rksnider/SensorCollar/Tools/Plotting Scripts/WirelessDataCode/ActualLocation.png

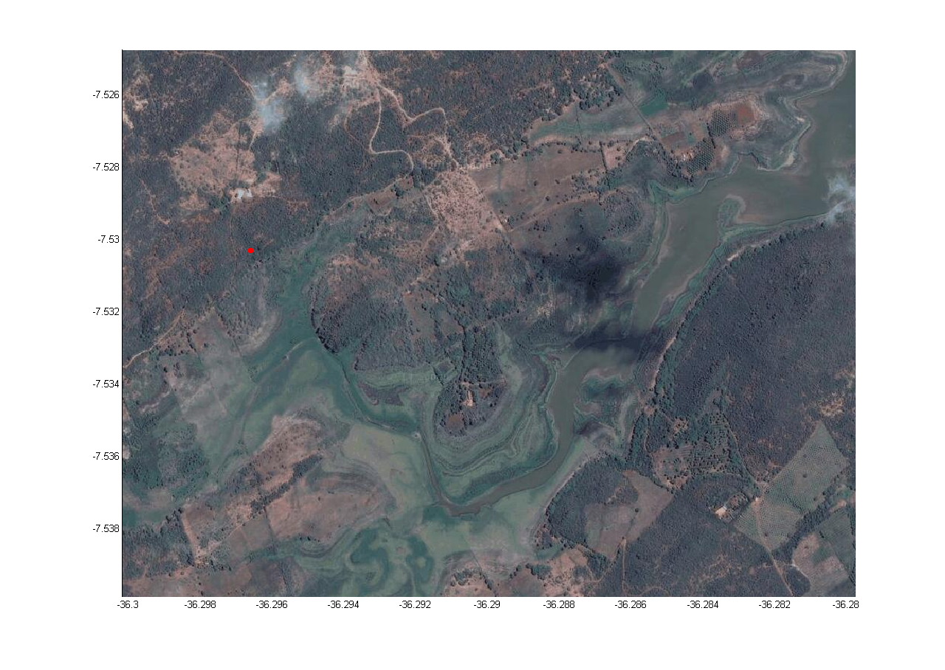
Tools/Plotting Scripts/WirelessDataCode/ActualLocation.png
