rksnider/SensorCollar/Tools/Plotting Scripts/WirelessDataCode/LocationMapdouble.png

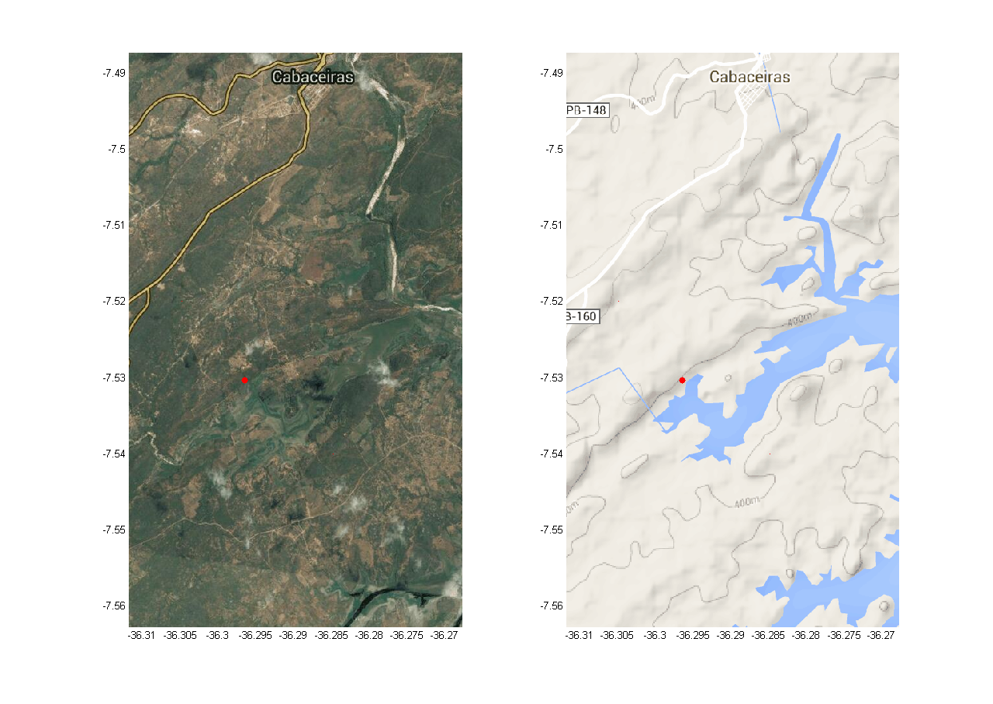
Tools/Plotting Scripts/WirelessDataCode/LocationMapdouble.png
