rksnider/SensorCollar/README.md

SensorCollar
============
This is where files are kept for the NSF SensorCollar
