rksnider/SensorCollar/Source_Code/README.md

Source Code should be organized by part name in their own folders

Examples:

----------------------------------------------------------------
System Files:

SensorCollar/Source_Code/System/VHDL

SensorCollar/Source_Code/System/Matlab

SensorCollar/Source_Code/System/C

----------------------------------------------------------------
Motion Sensor Files:

SensorCollar/Source_Code/Motion_MPU9250/VHDL

SensorCollar/Source_Code/Motion_MPU9250/Matlab

SensorCollar/Source_Code/Motion_MPU9250/C
