rksnider/SensorCollar/PCB_Designs/DevBoard_PowerMonitor/5CAM/readme.txt

Thickness: 0.062in
Copper Weight: 1Oz
Finish: Lead Free
Board: FR4
Soldermask: Both sides
Silkscreen: Both sides

Turn time: 1-2Weeks
Quantity: 5-10boards
