rksnider/SensorCollar/PCB_Designs/GPS Board/0Schematic/GPS Board/Board1.htm

# Part Lister output for Board1 Generated on Tuesday, October 06, 2015Part Lister output for Board1 Generated on Tuesday, October 06, 2015

# | QTY | DEVICE | REFDES | PKG_TYPE | VALUE | P/D_NUM | PART_NUMBER | PART_LABEL | PKG_GRP

1 | 1 | 1P8_LDOREG_TLV702 | U2 | 1P8_LDOREG_TLV702 | | 296-27889-1-ND | TLV70218DBVT | IC REG LDO 1.8V 0.3A SOT23-5 | SC-74A
2 | 1 | 3P3_LDOREG_TLV702 | U1 | 3P3_LDOREG_TLV702 | | 296-39284-1-ND | TLV70233PDBVR | SOT23-5 | SC-74A
3 | 3 | cap_0p1uF_0402 | C5, C9, C10 | 0402_MY | 0.1uF | 1276-1043-1-ND | CL05A104KA5NNNC
4 | 4 | cap_1uF_0402 | C1-C4 | 0402_MY | 1uF | 490-3890-1-ND | GRM155R61A105KE15D
5 | 1 | cap_4p7uF_0402 | C6 | 0402_MY | 4.7uF | 1276-1482-1-ND | CL05A475MP5NRNC
6 | 1 | EXT_SERIAL | J10 | EXT_SERIAL
7 | 1 | JTAG_HEADER | J3 | JTAG_HEADER
8 | 1 | JUMPER_8PIN_100MIL | J7 | JUMPER_8PIN_100MIL
9 | 1 | Res_0402 | R1 | 0402_MY | 25k | 541-1903-2-ND | PNM0402E2502BST1
10 | 2 | RIBBON_USB | J4, J9 | RIBBON_USB
11 | 4 | s_bit_uni_translator_FXLP34 | U3-U6 | s_bit_uni_translator_FXLP34 | | FXLP34P5XCT-ND | FXLP34P5X | TRANSLATOR 1BIT UNIDIRECT SC70-5 | SC-70-5
12 | 1 | SM_BUS | J1 | SM_BUS
13 | 1 | SPI_HEADER | J2 | SPI_HEADER
14 | 1 | SPST_SLIDE_SWITCH | S2 | SPST_SLIDE_SWITCH | | 360-3017-ND | AS11BP | SWITCH SLIDE SPST
15 | 1 | SWITCH_DUAL_SiP32414 | S1 | VISHNAY_DUAL_LOAD_SWITCH | | SIP32414DNP-T1-GE4CT-ND | Sip32414
16 | 2 | TVS_DIODE_ARRAY_SP3003_08ATG | U9, U10 | TVS_DIODE_ARRAY_SP3003_08ATG | | F1867CT-ND | SP3003-08ATG | TVS DIODE 6VWM 15VC MSOP10 | 10-MSOP
17 | 1 | two_bit_bi_translator_TXS0102 | U7 | two_bit_bi_translator_TXS0102 | | 296-21978-1-ND | TXS0102DCTR | IC VOLT-LEVEL TRANSLATOR US8 | 8-VFSOP
18 | 1 | USB3P0_LAND | J8 | USB3P0_LAND
19 | 1 | USB_FCI_CONNECTOR | J6 | USB_FCI_CONNECTOR | | 609-1039-ND | 61729-0010BLF | Connector Receptacle USB TypeB
20 | 1 | USB_FCI_PWR_RECEPTACLE | J5 | USB_FCI_PWR_RECEPTACLE | | 609-4618-1-ND | 10118194-0001LF | Connector Receptacle USB
