rksnider/SensorCollar/PCB_Designs/DevBoard_PowerMonitor/0Schematic/DevBoard_PowerMonitor/Prototype Board 1.htm

# Part Lister output for Prototype Board 1 Generated on Friday, October 10, 2014

# | DEVICE | PART_NUMBER | VALUE | TOLERANCE | REFDES | QTY

1 | 0p1uF_cap_0603 | | 0.1uF | | C4-C24 | 21
2 | 0p01uF_cap_0603 | | .01uF | | C63, C64 | 2
3 | 1p1V_Converter_TPS6085 | TPS62085 | | | PS1 | 1
4 | 4p7uF_cap_0603 | | 4.7uF | | C96-C113 | 18
5 | 4UCON_SD_SPARK_PART | | | | U4-U7 | 4
6 | 10uF_cap_0603 | | 10uF | | C1, C2 | 2
7 | 22uF_cap_0603 | | 22uF | | C3 | 1
8 | ADMP621_MEMS_MIC | ADMP621, ADMP621 | | | U15, U16 | 2
9 | ADP191_Power_Switch | ADP191, ADP191 | | | S6, S13 | 2
10 | ANTENNA | 1575AT43A0040 | | | AE1 | 1
11 | AUX_Power_Header | | | | J3 | 1
12 | BANK5B_HEADER | | | | J37 | 1
13 | BATTERY | | | | B1 | 1
14 | BATTERY_HEADER | | | | J30 | 1
15 | Battery_Monitor_BQ27520-G3 | BQ27520-G3 | | | U12 | 1
16 | C5_U324 | 5CEBA4U15C7N | | | U3 | 1
17 | cap_0402 | X5R, X5R, X5R, X5R, X5R, X5R, X5R, X5R, X5R, X5R, X5R, X5R, X5R, X5R, X5R, X5R | 0.1uF | | C65-C68, C74, C78, C80-C83, C86, C87, C90, C91, C94, C95 | 16
18 | cap_0402 | X5R | 0.22uF | | C75 | 1
19 | cap_0402 | X5R | 0.47uF | | C76 | 1
20 | cap_0402 | X5R, X5R, X5R, X5R, X5R, X5R, X5R, X5R | 10nF | | C77, C79, C84, C85, C88, C89, C92, C93 | 8
21 | cap_0402 | X5R | 22nF | | C69 | 1
22 | cap_0402 | X5R, X5R, X5R, X5R | 47nF | | C70-C73 | 4
23 | cap_0603 | | 0.1uF | | C43, C46, C49, C55, C56, C58, C59, C61, C62, C114, C116 | 11
24 | cap_0603 | | 1.0uF | | C57 | 1
25 | cap_0603 | | 1uF | | C54 | 1
26 | cap_0603 | | 4.7uF | | C51, C52 | 2
27 | cap_0603 | | 10nF | | C115, C118 | 2
28 | cap_0603 | | 10uF | | C44, C47, C50, C53, C117 | 5
29 | cap_0603 | | 22pF | | C45 | 1
30 | cap_0603 | | 22uF | | C42 | 1
31 | cap_0603 | | 33nF | | C60 | 1
32 | cap_0603 | | 33pF | | C48 | 1
33 | cap_0603 | X5R, X5R, X5R, X5R, X5R, X5R | 0.1uF | | C36-C41 | 6
34 | cap_0603 | X5R, X5R, X5R, X5R, X5R, X5R | 1uF | | C25, C27, C30, C33-C35 | 6
35 | cap_0603 | X5R | 4.7uF | | C26 | 1
36 | cap_0603 | X5R, X5R | 10uF | | C28, C31 | 2
37 | cap_0603 | X5R, X5R | 47uF | | C29, C32 | 2
38 | CLOCK_SG210STF | SG-210STF50.0000MS3 | | | CLK1 | 1
39 | CPLD_GPIO | | | | J44 | 1
40 | DATA_TX_HEADER | | | | J4 | 1
41 | DUAL_BUCK_WITH_BOOST_LTC3521 | LTC3521 | | | U10 | 1
42 | FERRITE_BEAD_FILTER | BLM18PG600SN1D, BLM18PG600SN1D | | | FB1, FB2 | 2
43 | FLASH_Micron_N25Q128A | N25Q128A11ESE40G | | | U17 | 1
44 | GPIO_1P8V | | | | J25 | 1
45 | GPIO_3P3V | | | | J35 | 1
46 | I2C_HEADER | | | | J36 | 1
47 | IM_LSM9DS1 | LSM9DS1 | | | U27 | 1
48 | Inductor | 252012CDMCD | 0.47uH | | L4 | 1
49 | Inductor | 252012CDMCD | 10uH | | L5 | 1
50 | Inductor | 252012CDMCD-3R3MC | 3.3uH | | L2 | 1
51 | Inductor | 252012CDMCD-4R7MC, 252012CDMCD-4R7MC | 4.7uH | | L1, L3 | 2
52 | JTAG_HEADER | | | | J38 | 1
53 | JUMPER_L | | | | J6-J23, J48-J50 | 21
54 | MAX-7Q | MAX-7Q | | | U11 | 1
55 | MAXV_TQFP100 | 5M570ZT100C5N | | | U14 | 1
56 | MNT_112_4_40_PART | | | | U19-U24 | 6
57 | MPU-9250_9AXSIS | MPU-9250 | | | U2 | 1
58 | MRAM_MR20H40CDF_8DFN_SMALLFLAG_PART | MR20H40 | | | U18 | 1
59 | OCTAL_BUFFER_SN74LVC244A | SN74LVC244APWR | | | U13 | 1
60 | Oscillation_Crystal | ABS07-120-32.768kHz-T | | | U25 | 1
61 | PUSH_BUTTON | KS12R22CQD | | | PB1 | 1
62 | Res_0603 | | 1.8M | | R34 | 1
63 | Res_0603 | | 1k | | R32 | 1
64 | Res_0603 | | 10k | | R20, R29, R30 | 3
65 | Res_0603 | | 18.2k | | R33 | 1
66 | Res_0603 | | 24k | | R21, R31, R35 | 3
67 | Res_0603 | | 40.2k | | R22 | 1
68 | Res_0603 | | 64.9k | 0.1% | R18 | 1
69 | Res_0603 | | 100 | | R25, R26 | 2
70 | Res_0603 | | 174k | 0.1% | R19 | 1
71 | Res_0603 | | 332k | 1% | R23 | 1
72 | Res_0603 | | 1020k | 1% | R24 | 1
73 | Res_0603 | ERJ-M03NF10MV | 0.01 | 1% | R28 | 1
74 | Res_v_0603 | | 1.00M | 0.1% | R3 | 1
75 | Res_v_0603 | | 1k | | R15 | 1
76 | Res_v_0603 | | 1M | | R11, R17 | 2
77 | Res_v_0603 | | 2K | 1% | R2 | 1
78 | Res_v_0603 | | 10k | | R9, R10, R14, R16 | 4
79 | Res_v_0603 | | 24k | | R12, R13 | 2
80 | Res_v_0603 | | 68.1k | 0.1% | R6 | 1
81 | Res_v_0603 | | 69.8k | 0.1% | R8 | 1
82 | Res_v_0603 | | 137k | 0.1% | R5 | 1
83 | Res_v_0603 | | 221k | 0.1%, 0.1% | R4, R7 | 2
84 | RESISTOR_PACK_EXB-2HV105JV | EXB-2HV105JV | 1M Ohm | | R1 | 1
85 | RTC_DS1371 | DS1371 | | | U26 | 1
86 | SC_BYPASS | | | | J33 | 1
87 | SCHOTTKY_DIODE | SSA23L | | | D1 | 1
88 | SDCARD_TP | | | | J40-J42 | 3
89 | SDRAM_MT48H32M16LFB4 | MT48H32M16LFB4 | | | U9 | 1
90 | Solar_Ctl_LTC3105 | LTC3105EMS | | | U1 | 1
91 | Solar_Pannel_Header | | | | J2 | 1
92 | SPI_HEADER | | | | J51 | 1
93 | SPI_SEL | | | | J52 | 1
94 | SWITCH_DUAL_SiP32413 | Sip32413 | | | S3 | 1
95 | SWITCH_DUAL_SiP32414 | Sip32414, Sip32414, Sip32414, Sip32414, Sip32414 | | | S5, S7-S10 | 5
96 | SWITCH_DUAL_SiP32416 | Sip32416, Sip32416 | | | S11, S12 | 2
97 | SWITCH_MAGNASPHERE-S | MG-B2-20-S | | | S4 | 1
98 | SWITCH_SINGLE_TPS22912C | TPS22912C, TPS22912C | | | S1, S2 | 2
99 | TEST_POINT | | | | J26-J29, J43, J45, J46, J53, J54 | 9
100 | THERMISTOR_103AT | 103AT-4 | 10K | 1% | R27 | 1
101 | TP_CONFIG | | | | J47 | 1
102 | TP_FLASH_L | | | | J31 | 1
103 | TP_FLASHR | | | | J1 | 1
104 | TP_GPS | | | | J32 | 1
105 | TP_IM_L | | | | J24 | 1
106 | TP_IM_R | | | | J5 | 1
107 | TP_MRAM_L | | | | J34 | 1
108 | TP_MRAM_R | | | | J39 | 1
109 | TXB0106_PW_16 | TXB0106 | | | U8 | 1
