rksnider/SensorCollar/Tools/Current Meter/Current Meter Board Pins v2.pdf

## Mammal Tracking Project - Current Meter Board Pins Used

Emery Newlon

## Primary Processor

The primary processor of the project is a Freescale Kinetis L class microcontroller. The Freescale Freedom board used for this project uses a KL25 version of this processor. In the connection diagrams that follow the color silver indicates an empty hole, black indicates a pin without a connection to it, while other colors indicate the wire color or component connected to the pin.

## Freedom Board Pins Used

The Current Meter Board (CMB) is powered by the USB connection through the OpenSDA port. It is connected to an external resistance network board that provides signal taps used to determine the current passing from a current source to its destination. The analog reference is smoothed by capacitor CR and resistor RR. The connections to the Current Meter Board are as follows:

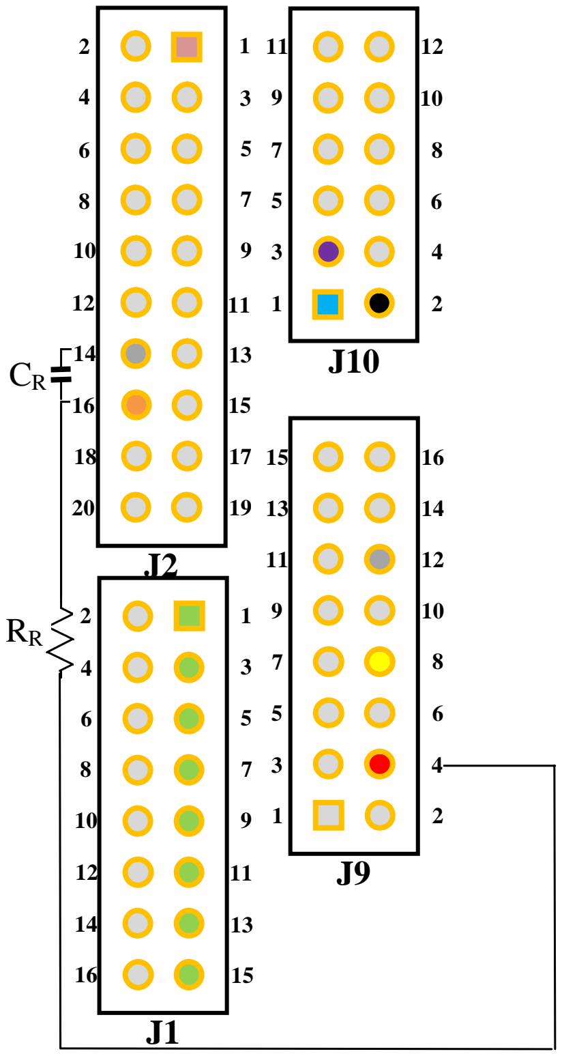
[picture p66: figure]

1. Data In (Optional) | J1-1 to J1-15 odd
2. Data Out (Optional) | Sampling J2-1
3. AREF Capacitor Low | GND | J2-14
4. AREF Capacitor High | AREF | J2-16
AREF Resistor Low
5. CMB Power (Optional) P3V3 | J9-08
6. AREF Resistor High | P3V3 | J9-04
7. Resistor Board Ground GND | J9-12
8. Resistor Board V+ | PTE20 | J10-01
9. Resistor Board V- | PTE21 | J10-03

CR = 1000 µF, RR = 1000 Ω

Mammal Tracking Project | Current Meter Board Pins Used

Page 2 of 4

The Resistor Board is used to implement the resistor network and the pins needed to connect it to the Source, Destination, and Current Meter Board. The current through the R0 resister is measured by determining the difference between V+ and V- assuming that the resistances of R1 to R4 are much higher than that of R0.
V+ = Vin × R3 / (R1 + R3) | → | Vin = V+ × (R1 + R3) / R3
V- = Vout × R4 / (R2 + R4) → | Vout = V- × (R2 + R4) / R4
Iout = (Vin – Vout) / R0 | →
Iout = [V+ × (R1 + R3) / R3 – V- × (R2 + R4) / R4] / R0

Resister R0 is a 1 Ω resister. Resistor R4 is calibrated by connecting the same voltage source, Vcal, across both Vin and Vout, then adjusting R4 until V+ and V- have the same values. This results in:
V+ = Vcal × R3 / (R1 + R3) | & | V- = Vcal × R4 / (R2 + R4)
Vcal × R3 / (R1 + R3) = Vcal × R4 / (R2 + R4) | → R3 / (R1 + R3) = R4 / (R2 + R4)
(R1 + R3) / R3 = (R2 + R4) / R4 | → | Iout = [(V+ – V-) × (R1 + R3) / R3] / R0

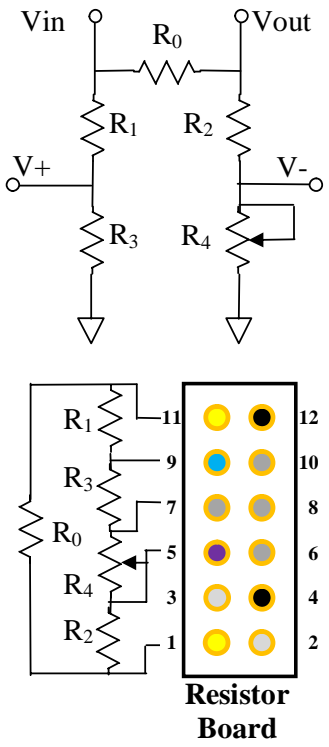
[picture p67: figure]
Resistor Board; Vin; Vout

1. Source Ground | GND | RB-10
2. Source Vcc | Vin | RB-11
3. CMB V+ | V+ | RB-09
4. CMB Ground | GND | RB-08
5. CMB V- | V- | RB-05
6. Destination Ground | GND | RB-06
7. Destination Vcc | Vout | RB-01

V+ must be less than AREF. If max V+ is (g × AREF): g × AREF / Vin = R3 / (R1 + R3)
g × AREF / Vin = 1 / (R1 / R3 + 1)
R1 / R3 = 1 / (g × AREF / Vin) – 1
R1 = R3 × [1 / (g × AREF / Vin) – 1] where g is a constant such as 0.9. R4 = 2 × R3 to allow for it to be adjusted.

Mammal Tracking Project | Current Meter Board Pins Used

Page 3 of 4

Calibrate using calibration cable:

Connect blue to the red.
Apply power (3.3v) between red and black.
Adjust R2 until voltage between yellow and green is 0. Measure Vcal between red and black.
Measure V+cal between yellow and black.

Disconnect red and black from power and ground.
Disconnect blue from red.
Set power to 0.3v or less.
Connect red to power, blue to ammeter, and ammeter to ground. Measure Ical through ammeter and VLcal between red and blue. Calculate calibration factor for this Resistor Board:
CF = (Vcal / V+cal) / (VLcal / Ical)
Iout = (V+ – V-) × CF

RB Calibration
Plugs
11 | 9 | 7 | 5 | 3 | 1
12 | 10 | 8 | 6 | 4 | 2
