rksnider/SensorCollar/Documentation/dcs_vhdl_coding_rules_es_v4_4.pdf

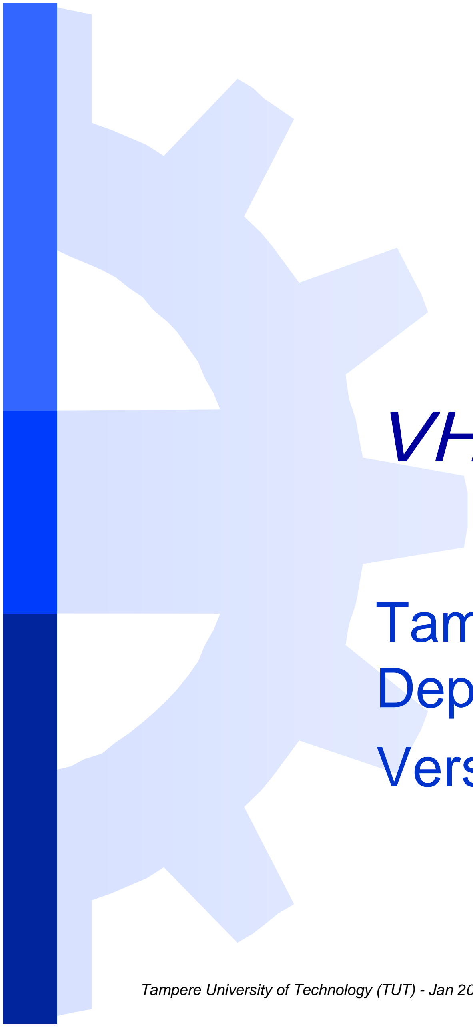
[picture p75: figure]

Tampere University of Technology (TUT) - Jan 2009

# VHDL Coding Rules

# Tampere University of Technology Department of Computer Systems Version 4.4 – Jan 2009

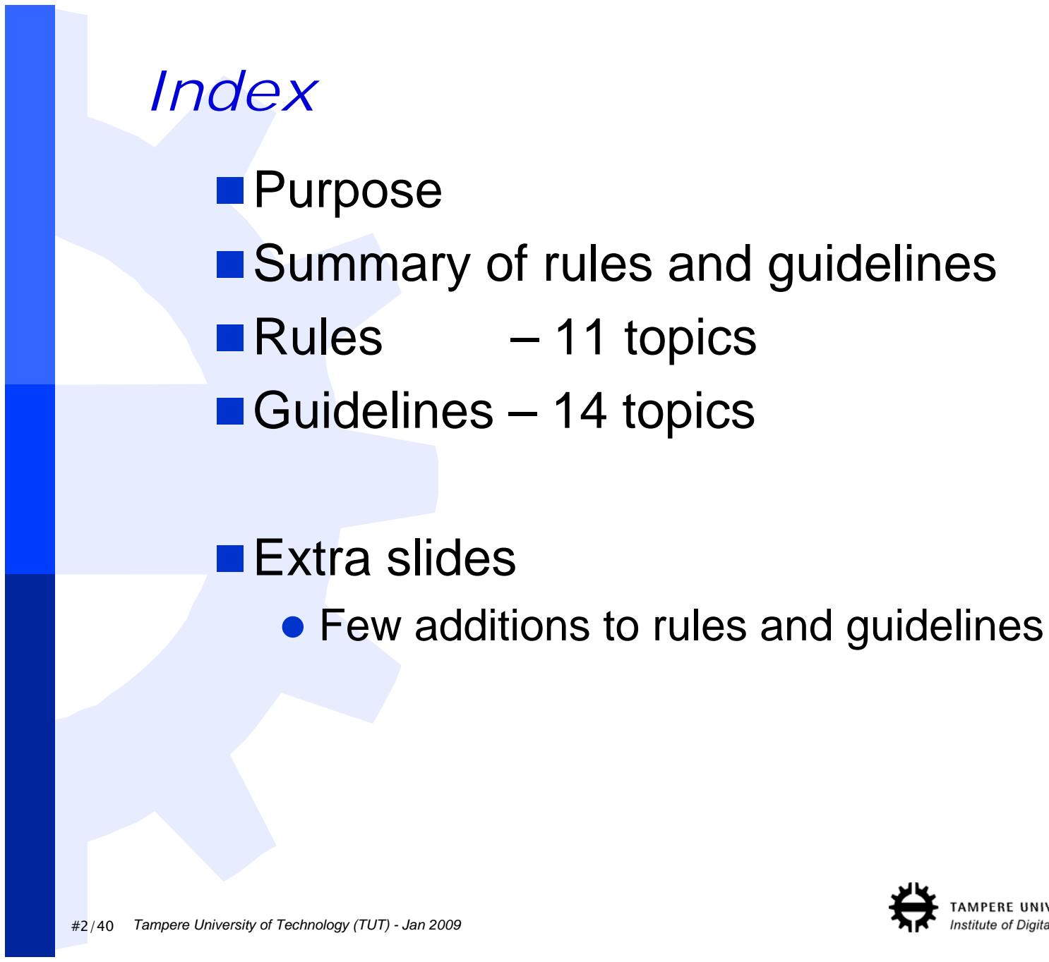
[picture p76: figure]
Index; Purpose Summary of rules and guidelines; Rules; – 11 topics; Guidelines – 14 topics; Extra slides z Few additions to rules and guidelines

#2/40 Tampere University of Technology (TUT) - Jan 2009

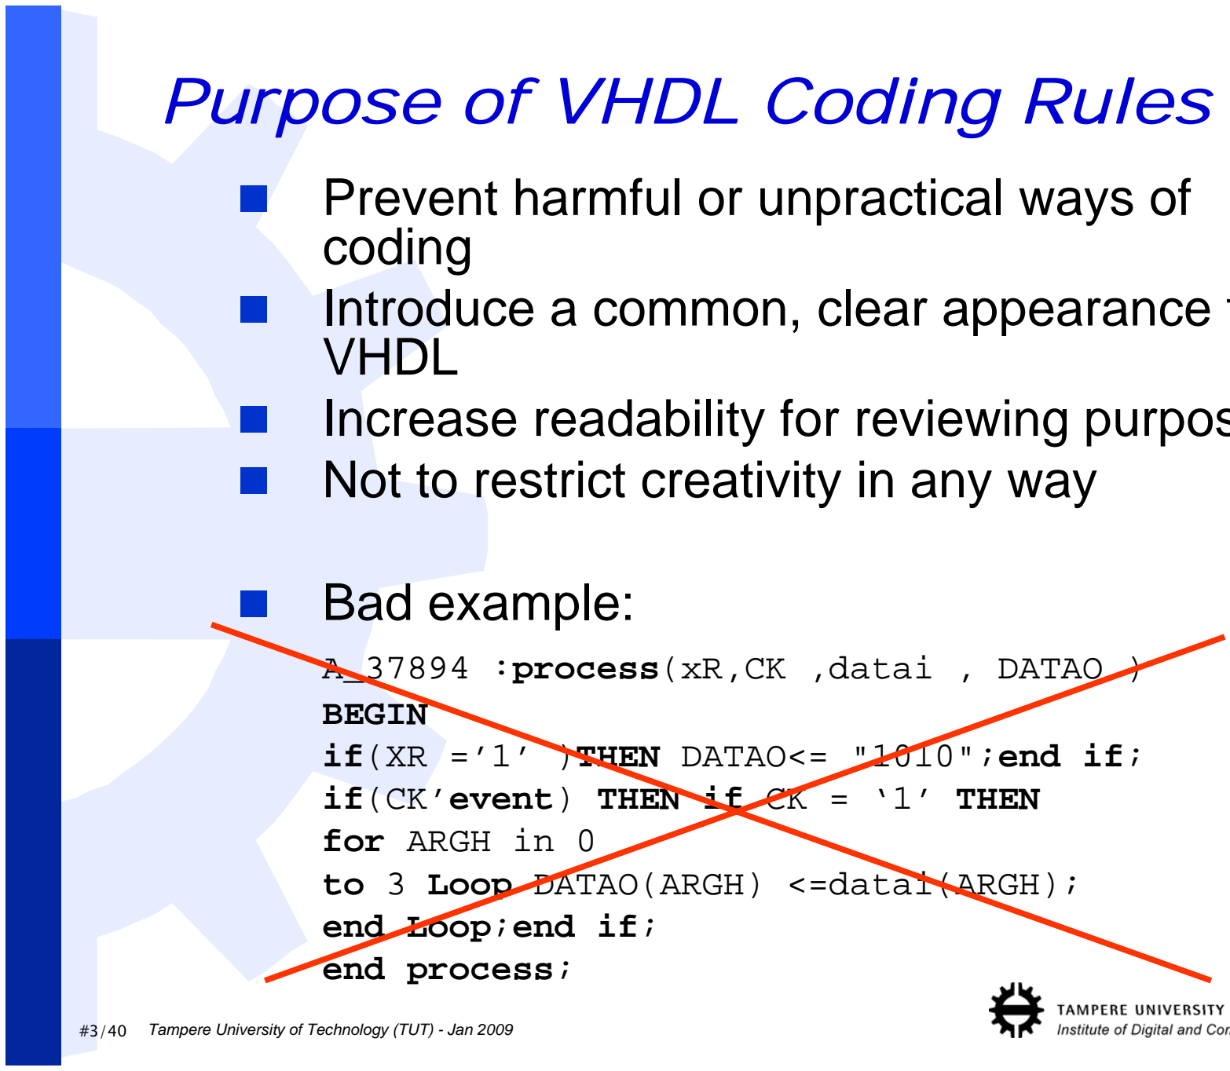
[picture p77: figure]
Purpose of VHDL Coding Rules; coding; VHDL;  Not to restrict creativity in any way;  Bad example:; A_37894 :process(xR,CK ,datai , DATAO ) BEGIN if(XR =’1’ )THEN DATAO<= "1010";end if; if(CK’event) THEN if CK = ‘1’ THEN for ARGH in 0 to 3 Loop DATAO(ARGH) <=datai(ARGH); end Loop;end if; end process;

#3/40 Tampere University of Technology (TUT) - Jan 2009

# Prevent harmful or unpractical ways of

# Introduce a common, clear appearance for

# Increase readability for reviewing purposes

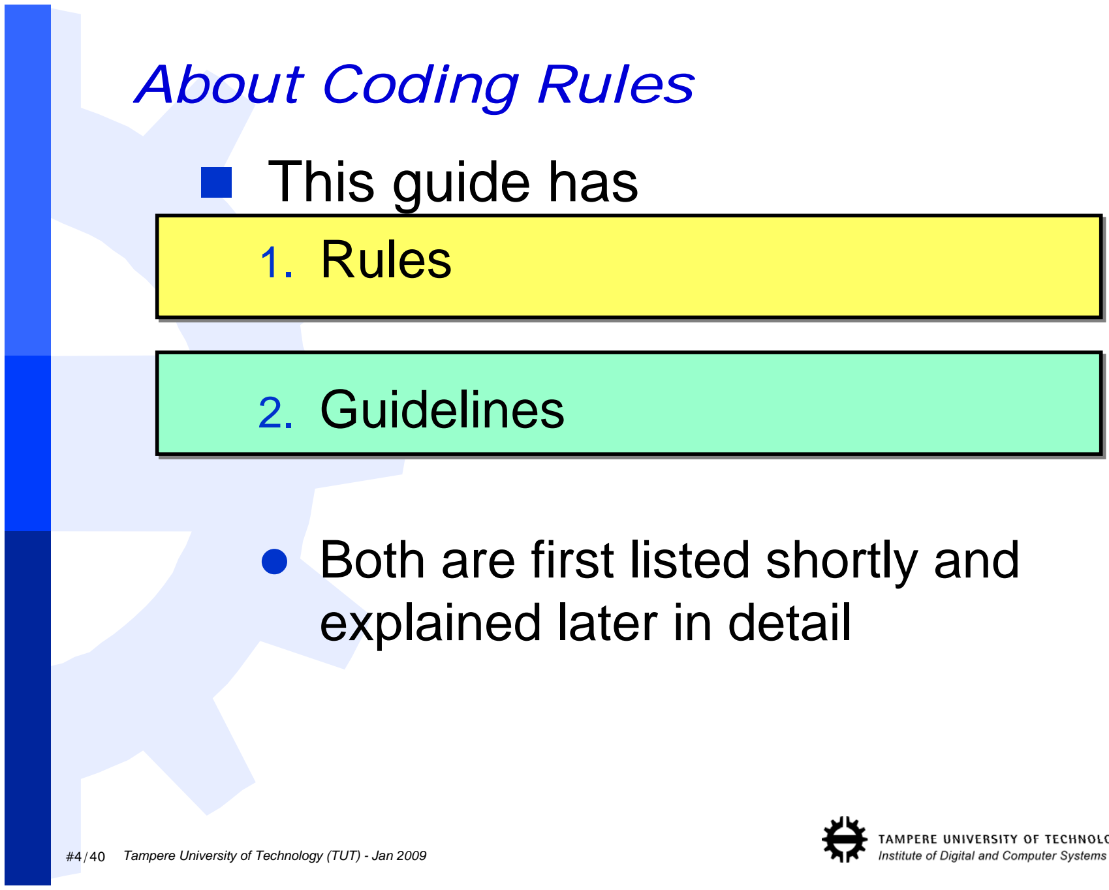
[picture p78: figure]
About Coding Rules;  This guide has 1. Rules; 2. Guidelines; z Both are first listed shortly and explained later in detail

#4/40 Tampere University of Technology (TUT) - Jan 2009

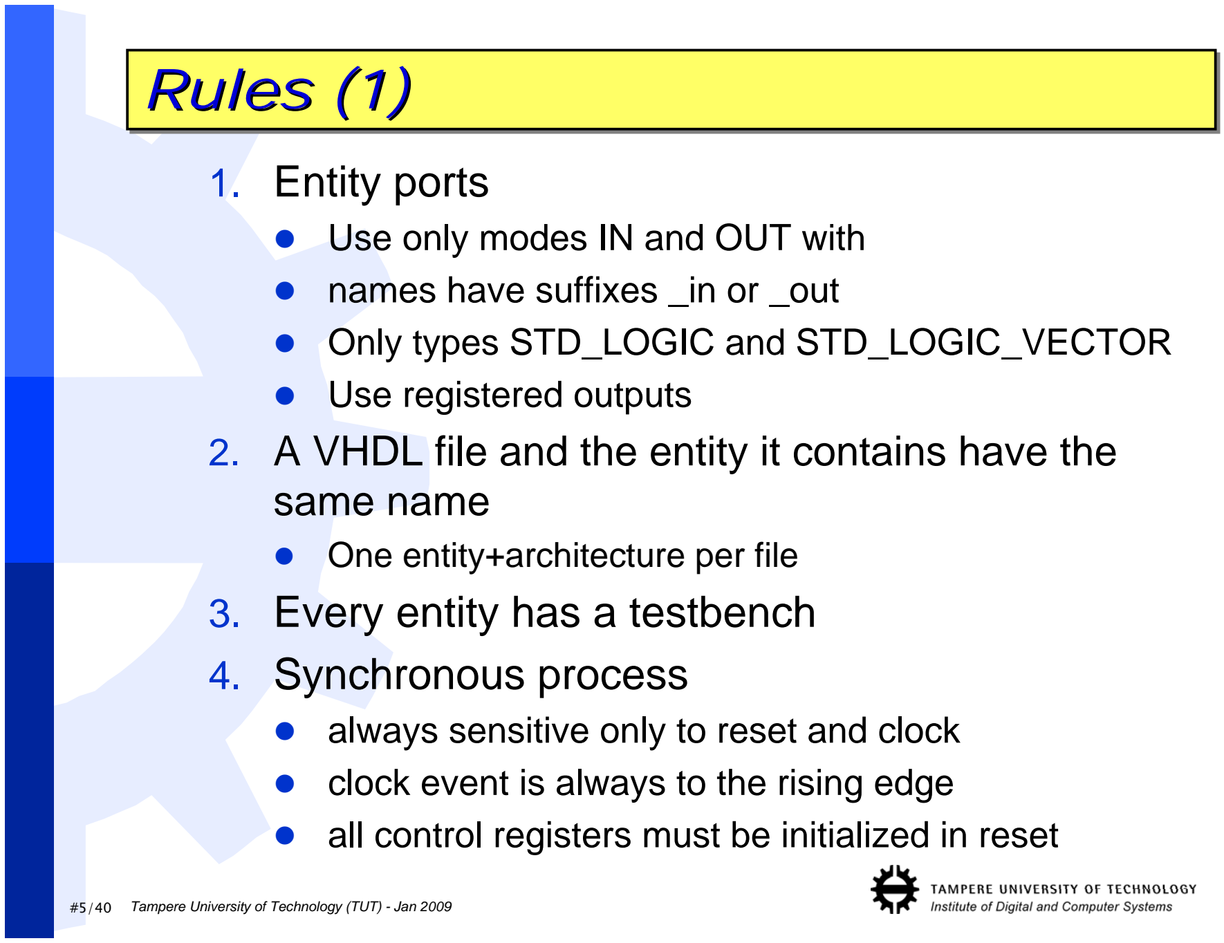
[picture p79: figure]
1. Entity ports z Use only modes IN and OUT with z names have suffixes _in or _out; z Use registered outputs; same name z One entity+architecture per file 3. Every entity has a testbench 4. Synchronous process; Rules (1) Rules (1) Rules (1)

#5/40 Tampere University of Technology (TUT) - Jan 2009

# z Only types STD_LOGIC and STD_LOGIC_VECTOR

# 2. A VHDL file and the entity it contains have the

# z always sensitive only to reset and clock z clock event is always to the rising edge z all control registers must be initialized in reset

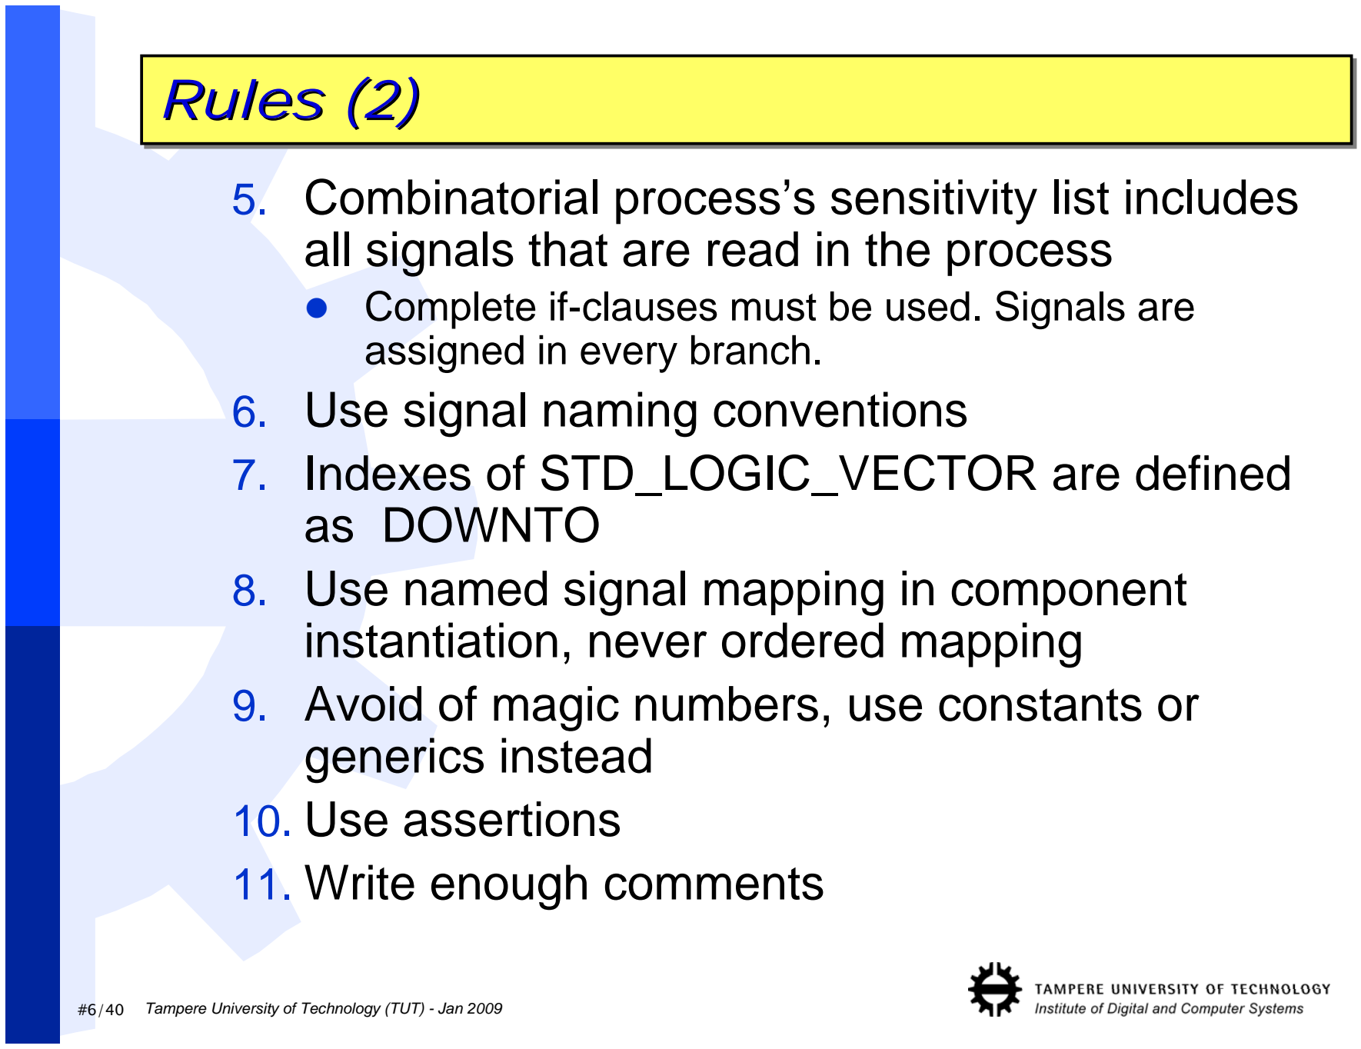
[picture p80: figure]
Rules (2) Rules (2) Rules (2); assigned in every branch. 6. Use signal naming conventions; as DOWNTO; instantiation, never ordered mapping; generics instead 10. Use assertions 11. Write enough comments

#6/40 Tampere University of Technology (TUT) - Jan 2009

# 5. Combinatorial process’s sensitivity list includes all signals that are read in the process

# z Complete if-clauses must be used. Signals are

# 7. Indexes of STD_LOGIC_VECTOR are defined

# 8. Use named signal mapping in component

# 9. Avoid of magic numbers, use constants or

#7/40 Tampere University of Technology (TUT) - Jan 2009

# Guidelines (1) Guidelines (1) Guidelines (1)

# 1. Every VHDL file starts with a header 2. Indent the code, keep lines shorter than 76 characters

3. Use descriptive names.

4. Use conventional architecture names 5. Label every process and generate-clause 6. Clock is named clk and async. active-low reset rst_n 7. Intermediate signals define source and destination blocks 8. Instance is named accroding to entity name 9. Use FOR GENERATE for repetitive instances 10. Guidelines for naming conventions

# 11. Prefer generics to package constants 12. Avoid assigning bit vector literals. Use conversion functions

13. Prefer arrays over multiple signals. Use loops.

# 14. Avoid variables inside processes

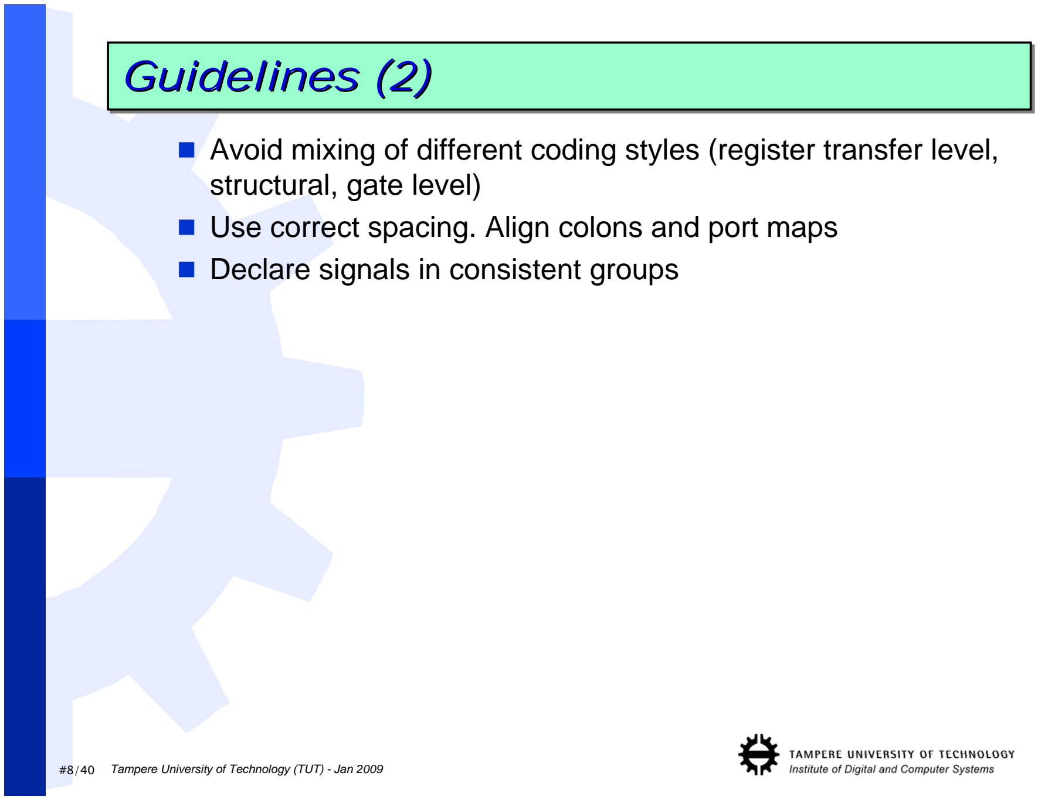
[picture p81: figure]
structural, gate level);  Declare signals in consistent groups

#8/40 Tampere University of Technology (TUT) - Jan 2009

# Guidelines (2) Guidelines (2) Guidelines (2)

Avoid mixing of different coding styles (register transfer level,

# Use correct spacing. Align colons and port maps

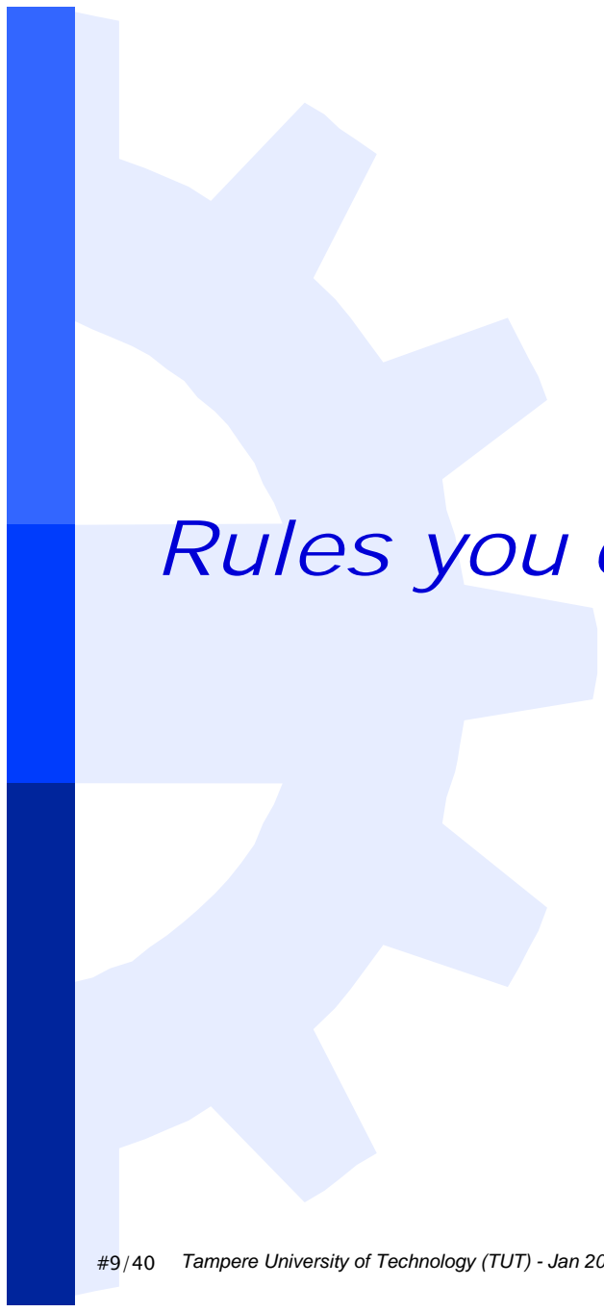
[picture p82: figure]

#9/40 Tampere University of Technology (TUT) - Jan 2009

# Rules you cannot refuse

# Entity ports

# Use only modes IN and OUT in the port

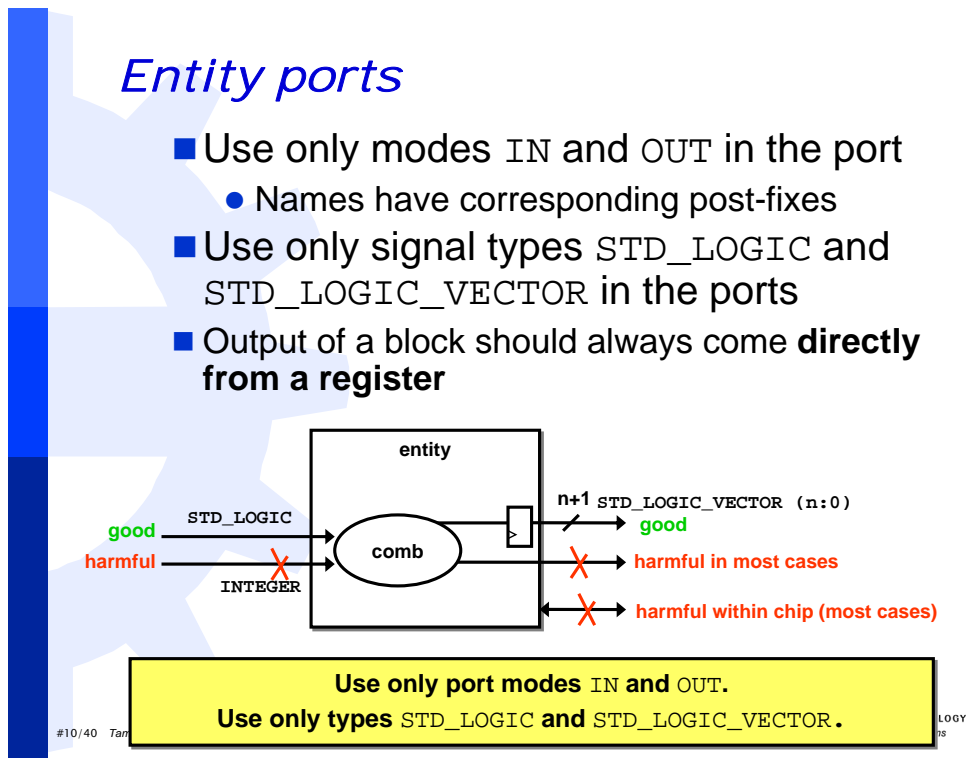
[picture p83: page 10]
entity entity; comb; n+1 STD_LOGIC_VECTOR (n:0); STD_LOGIC; INTEGER; good; harmful

z Names have corresponding post-fixes
Use only signal types STD_LOGIC and
STD_LOGIC_VECTOR in the ports
 Output of a block should always come directly
from a register

harmful in most cases

harmful within chip (most cases)

Use only port modes IN and OUT.

Use only types STD_LOGIC and STD_LOGIC_VECTOR.

#10/40 Tampere University of Technology (TUT) - Jan 2009

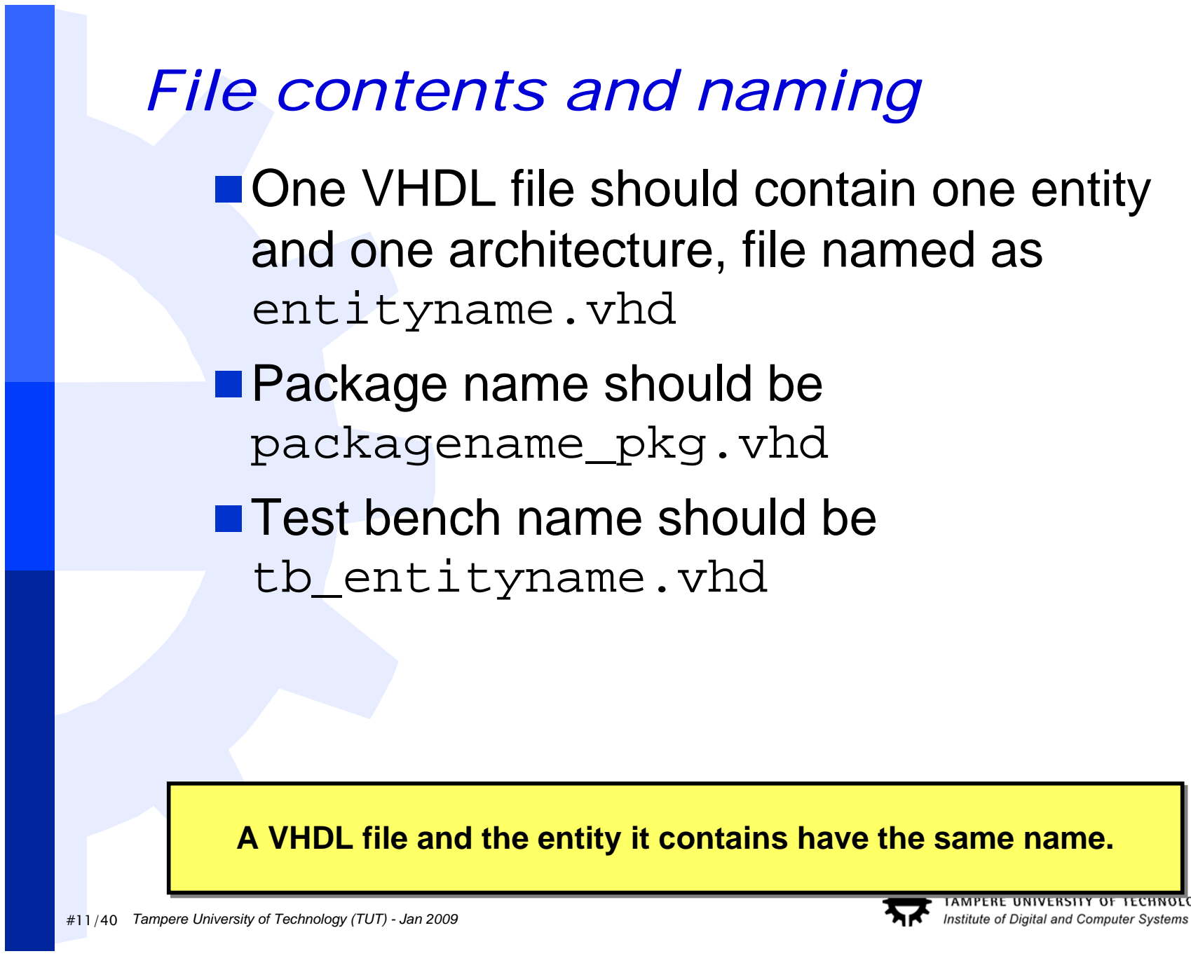
[picture p84: figure]
File contents and naming; and one architecture, file named as entityname.vhd Package name should be packagename_pkg.vhd Test bench name should be tb_entityname.vhd

#11/40 Tampere University of Technology (TUT) - Jan 2009

# One VHDL file should contain one entity

A VHDL file and the entity it contains have the same name. A VHDL file and the entity it contains have the same name.

#12/40 Tampere University of Technology (TUT) - Jan 2009

# Testbench

# Each entity requires at least one testbench

# z Design without a testbench is useless

# Prefer self-checking testbenches

# z Cannot assume that the verifier looks at the “magic spots” in waveform z (Occasionally, TB just generates few inputs to show the intended behavior in common case)

# Informs whether the test was successful or not There can be several test benches for testing different aspects of the design

# z Code coverage should be as high as possible z Verify correct functionality with different generic values

Every entity needs a testbench. Every entity needs a testbench.

#13/40 Tampere University of Technology (TUT) - Jan 2009

# Sequential/synchronous process

# Sensitivity list of a synchronous process has always exactly two signals

# z Clock, rising edge used, named clk z Asynchronous reset, active low, named rst_n

# Signals that are assigned inside sync process, will become D-flip flops at synthesis Never give initial value to signal at declarative part

# z It is not supported by synthesis (but causes only a warning)

SIGNAL main_state_r : state_type := "11110000";

# - Assign values for control registers during reset z (Xilinx FPGAs may be exceptions to this rule)

Synchronous process is sensitive only Synchronous process is sensitive only to reset and clock. to reset and clock.

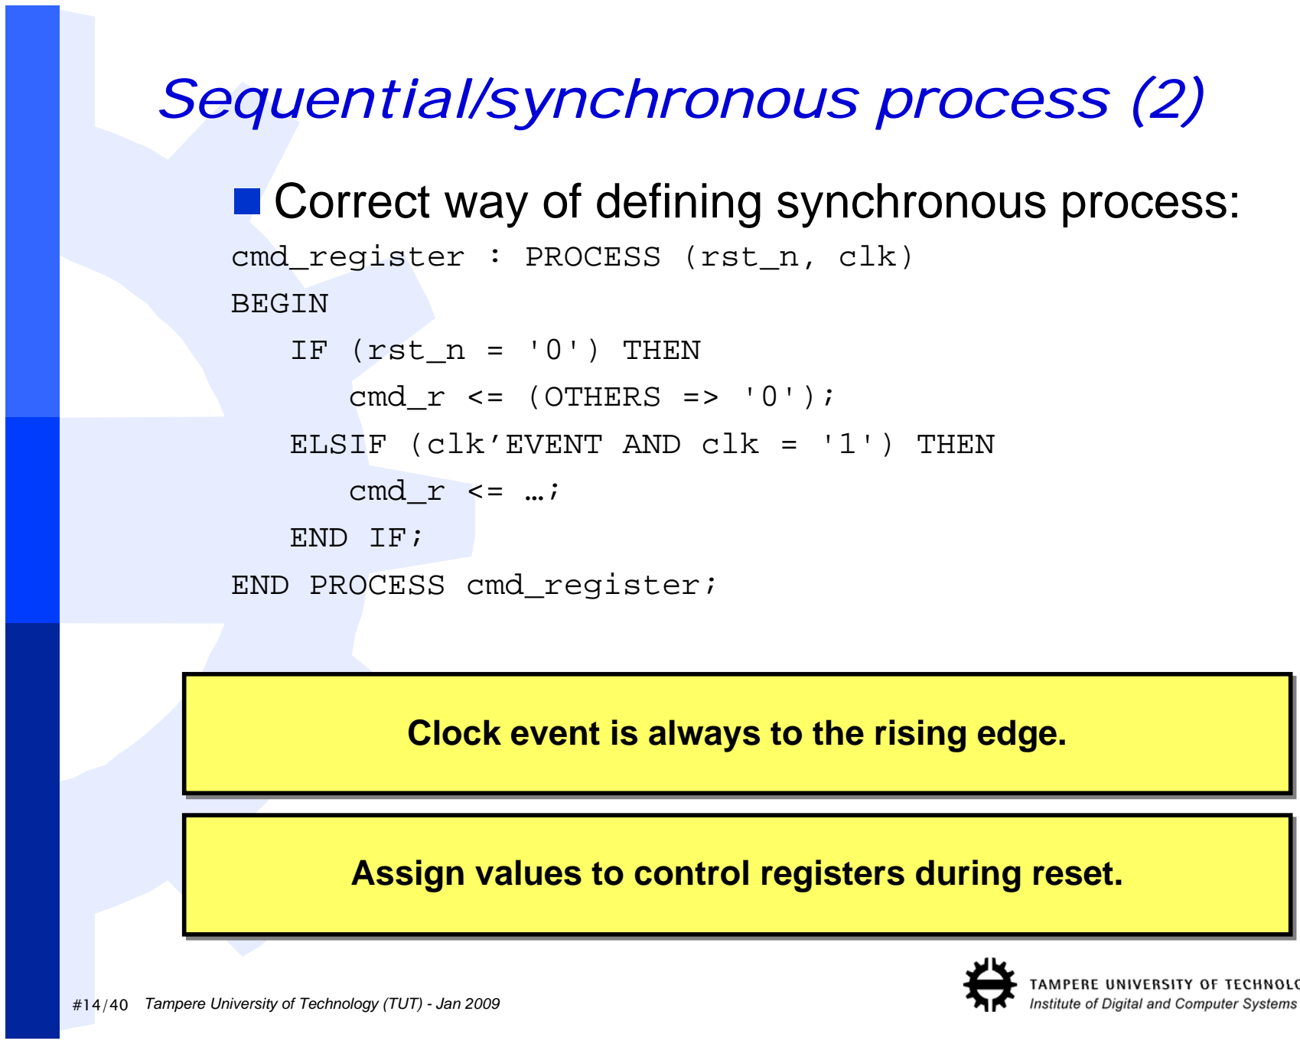
[picture p85: figure]
Sequential/synchronous process (2); cmd_register : PROCESS (rst_n, clk) BEGIN IF (rst_n = '0') THEN cmd_r <= (OTHERS => '0'); ELSIF (clk’EVENT AND clk = '1') THEN cmd_r <= …; END IF; END PROCESS cmd_register;

#14/40 Tampere University of Technology (TUT) - Jan 2009

# Correct way of defining synchronous process:

Assign values to control registers during reset. Assign values to control registers during reset.

Clock event is always to the rising edge. Clock event is always to the rising edge.

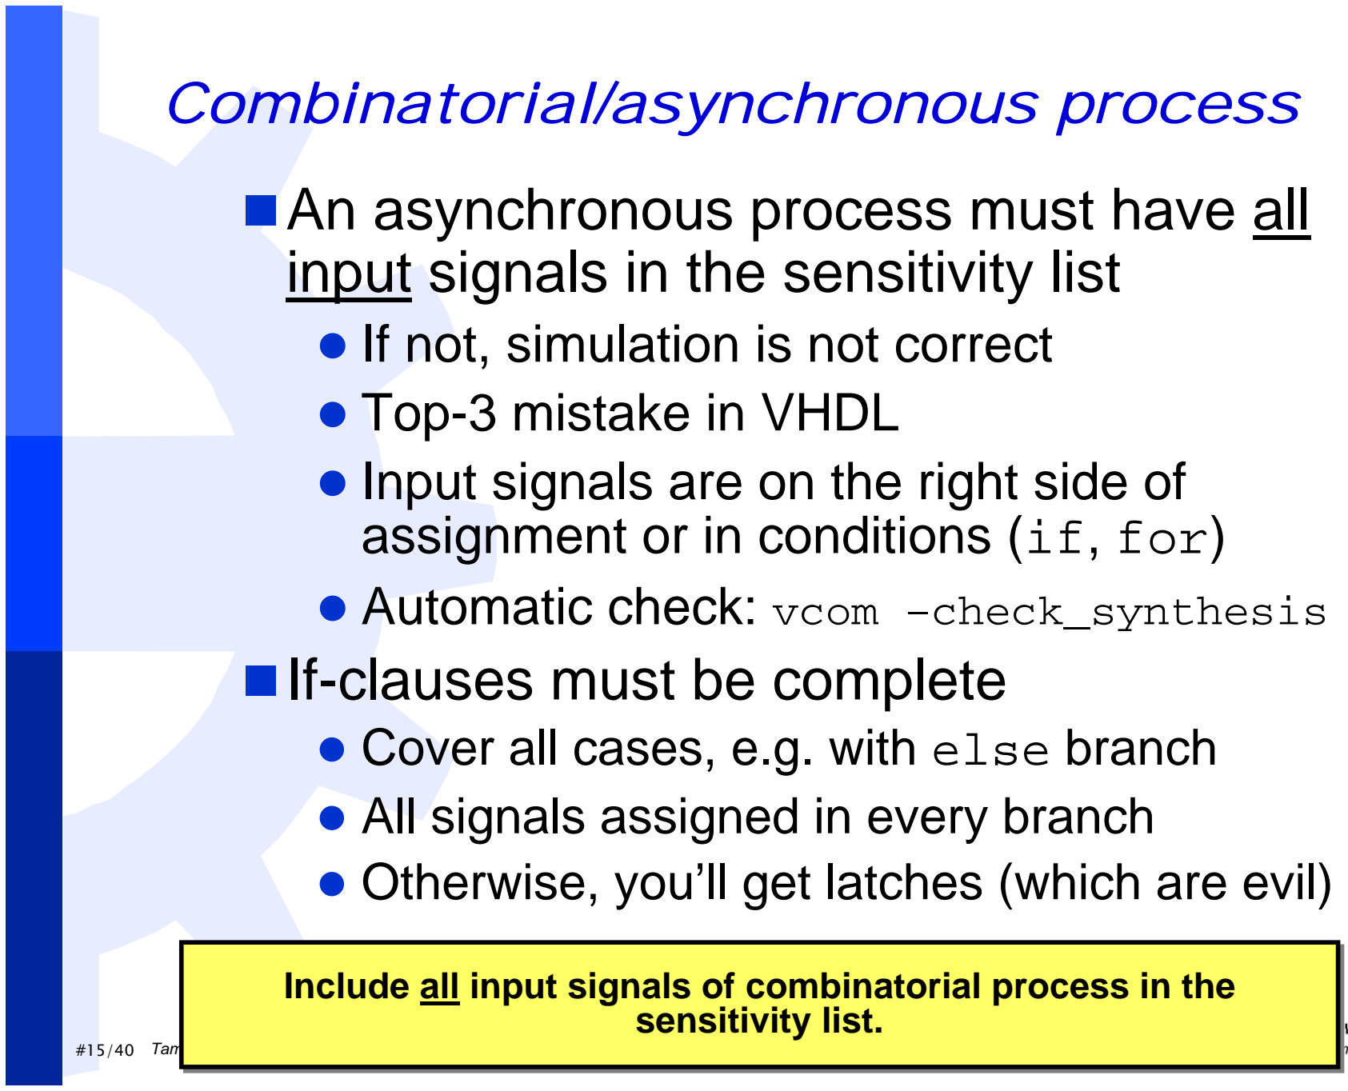
[picture p86: figure]
Combinatorial/asynchronous process; An asynchronous process must have all input signals in the sensitivity list z If not, simulation is not correct z Top-3 mistake in VHDL; assignment or in conditions (if, for); If-clauses must be complete; z All signals assigned in every branch; sensitivity list.

#15/40 Tampere University of Technology (TUT) - Jan 2009

# z Input signals are on the right side of

# z Automatic check: vcom –check_synthesis

# z Cover all cases, e.g. with else branch

# z Otherwise, you’ll get latches (which are evil)

# Include all input signals of combinatorial process in the

# Include all input signals of combinatorial process in the

#16/40 Tampere University of Technology (TUT) - Jan 2009

# Combinatorial/asynch. process (2)

# An example of an asynchronous process:

# decode : PROCESS (cmd_r, bit_in, enable_in) BEGIN IF (cmd_r = match_bits_c) THEN

match_0 | <= '1';

# IF (bit_in(1) = ‘1’ and bit_in(0) = ‘0’) THEN

match_both <= enable_in;

# ELSE

match_both <= '0';
END IF;

# ELSE -- else branch needed to avoid latches

match_0 | <= '0';
match_both | <= '0';
END IF;
END PROCESS decode;

# Same signal cannot be on both sides of assignment in combinatorial process

# z That would create combinatorial loop, i.e. malfunction

# Combinatorial process necessitates complete if-clauses. Every

signal is assigned in every if-branch.

# Combinatorial process necessitates complete if-clauses. Every

signal is assigned in every if-branch.

#17/40 Tampere University of Technology (TUT) - Jan 2009

# These naming conventions are must

# General register output signalname_r

Combinatorial signal | signalname
Input port | portname_in
Output port | portname_out
Constant | constantname_c
Generic | genericname_g
Variable | variablename_v

Use these naming conventions. Use these naming conventions.

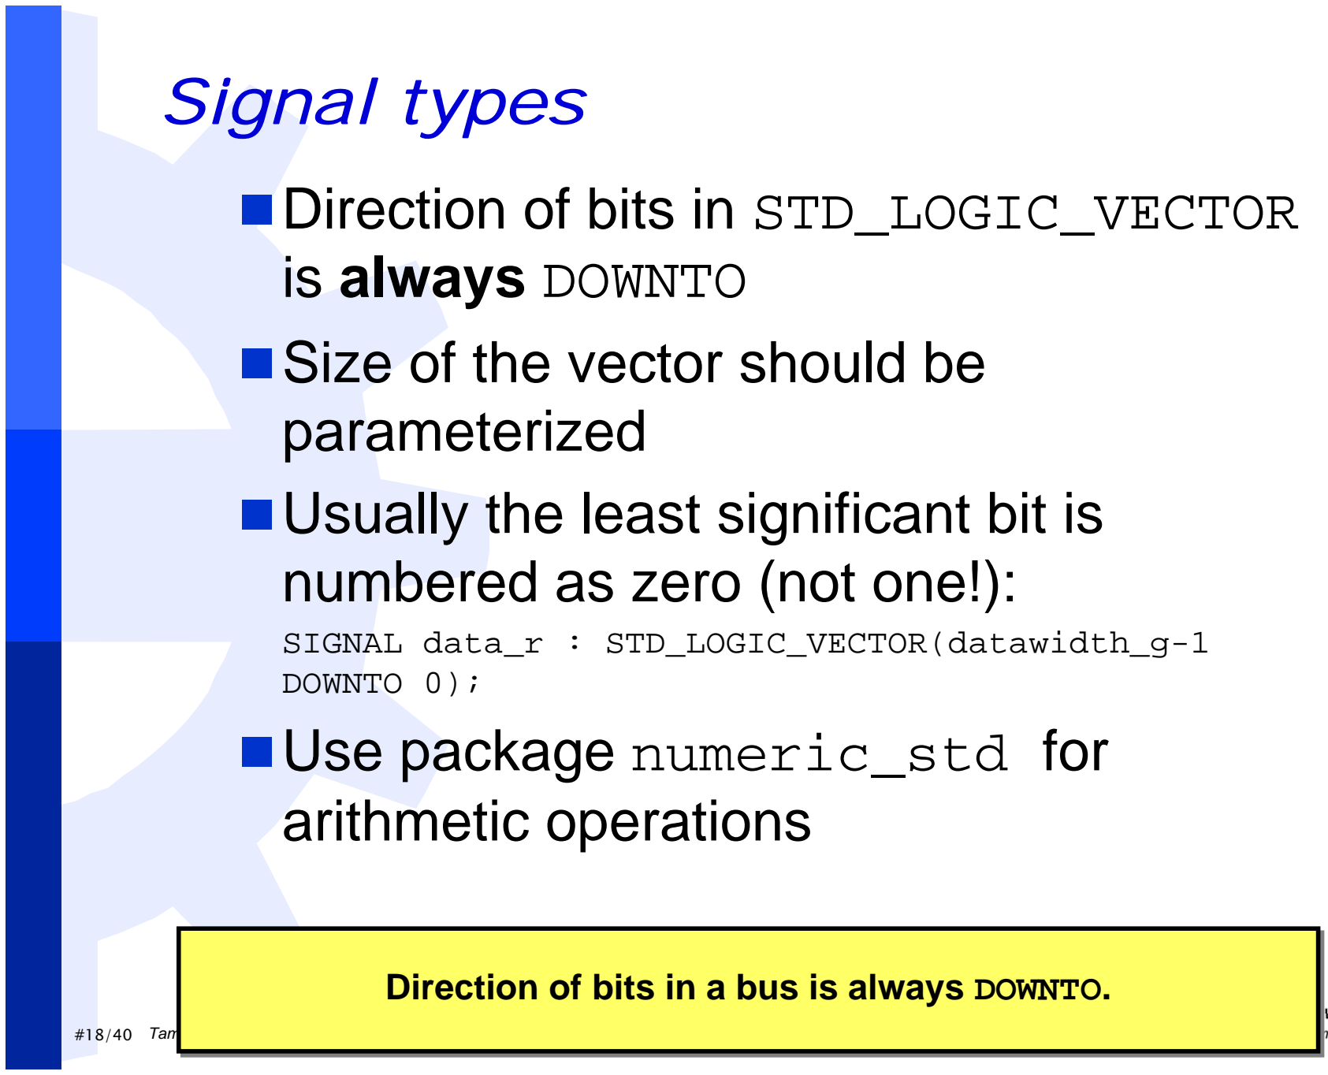
[picture p87: figure]
Signal types; Direction of bits in STD_LOGIC_VECTOR is always DOWNTO Size of the vector should be parameterized Usually the least significant bit is numbered as zero (not one!):; DOWNTO 0); Use package numeric_std for arithmetic operations

#18/40 Tampere University of Technology (TUT) - Jan 2009

# SIGNAL data_r : STD_LOGIC_VECTOR(datawidth_g-1

Direction of bits in a bus is always Direction of bits in a bus is always DOWNTO DOWNTO..

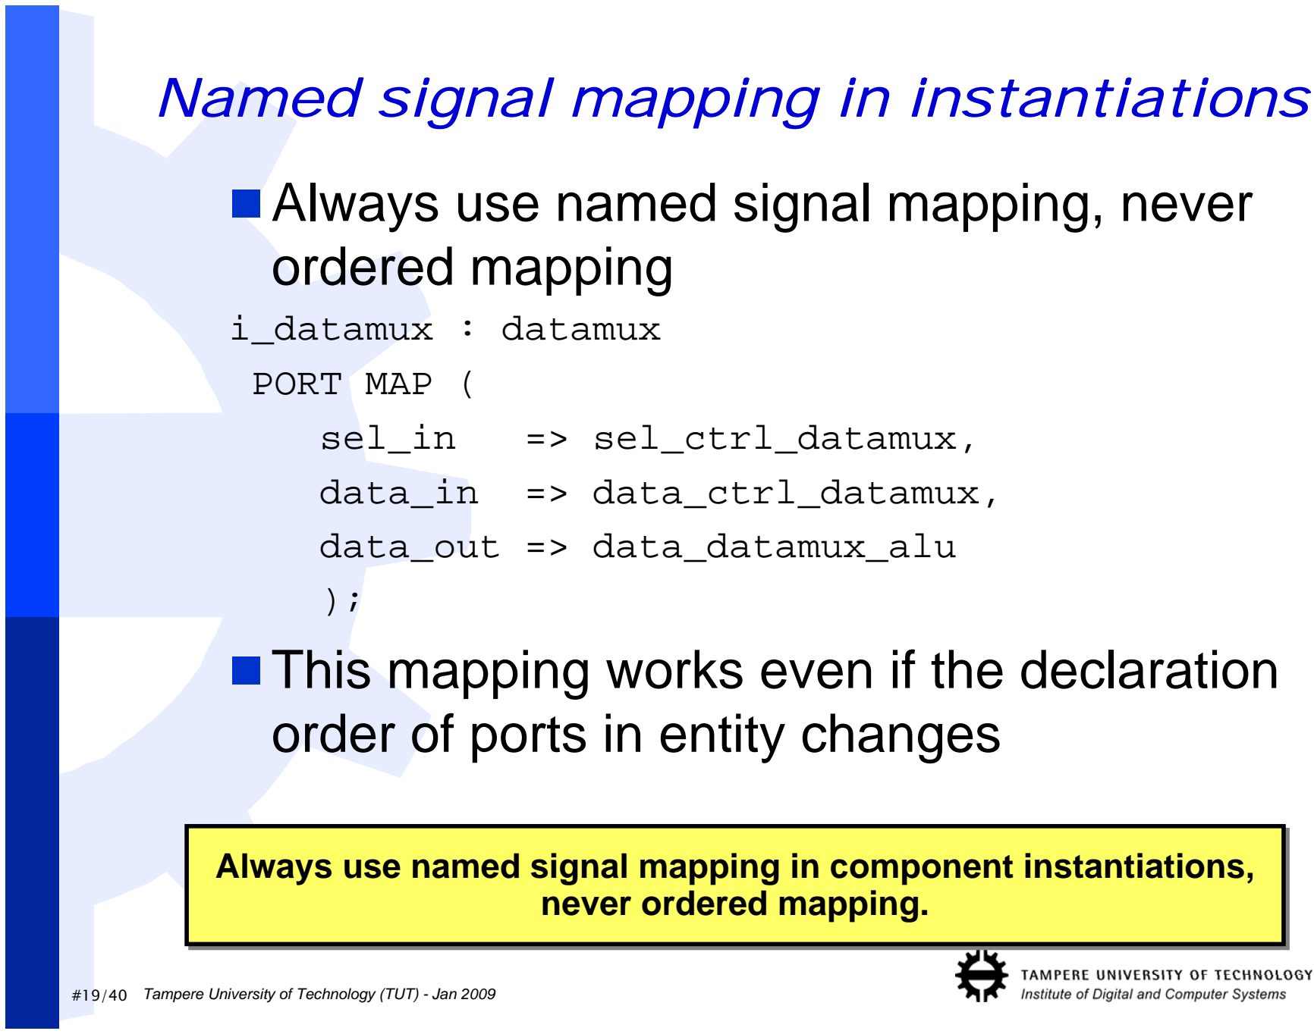
[picture p88: figure]
Named signal mapping in instantiations; ordered mapping; i_datamux : datamux PORT MAP (; sel_in; => sel_ctrl_datamux,; data_in => data_ctrl_datamux, data_out => data_datamux_alu );; order of ports in entity changes; never ordered mapping.

#19/40 Tampere University of Technology (TUT) - Jan 2009

# Always use named signal mapping, never

# This mapping works even if the declaration

Always use named signal mapping in component instantiations,

Always use named signal mapping in component instantiations,

#20/40 Tampere University of Technology (TUT) - Jan 2009

# Avoid magic numbers Avoid magic numbers

# Magic number is an unnamed and/or ill-documented numerical constant Especially, a magic number derived from another is catastrophic

# z Eg. for-loop iterates through 2 to 30 because signal is 32b wide. What if it is only 16 bits?

# Use constants or generics instead

# STD_LOGIC_VECTOR (data_width_g -1 DOWNTO 0) --generic STD_LOGIC_VECTOR (data_width_c -1 DOWNTO 0) --constant

# States of FSM are enumerations not bit vectors

# Note that this document occasionally uses magic numbers to keep examples short

Use constants or generics instead of magic numbers. Use constants or generics instead of magic numbers.

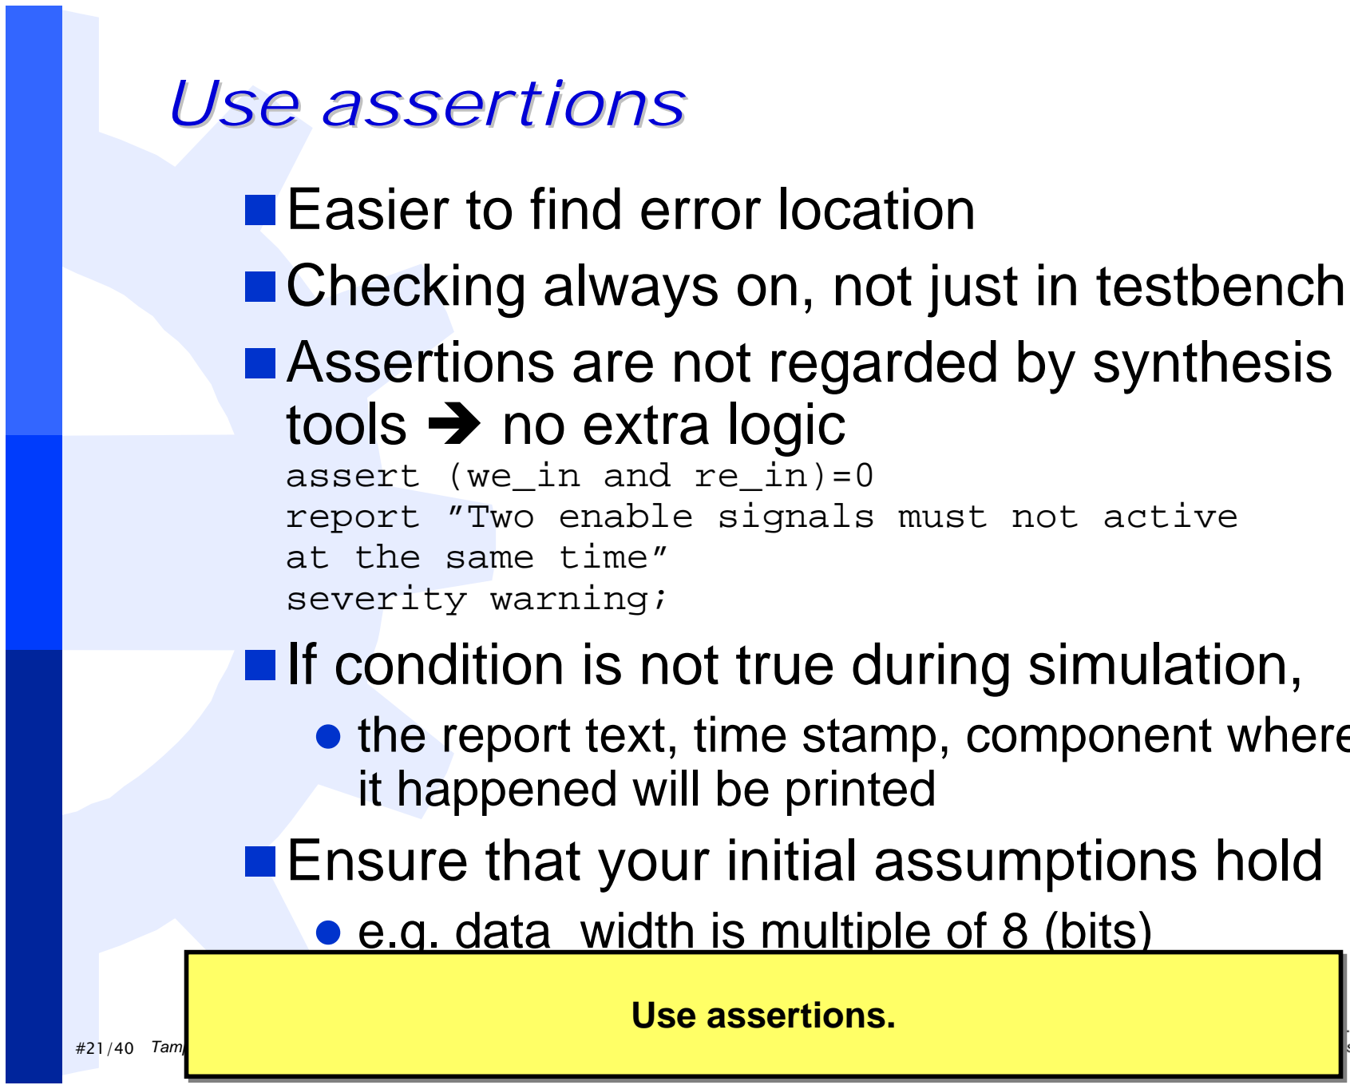
[picture p89: figure]
Use assertions Use assertions; Easier to find error location; tools no extra logic assert (we_in and re_in)=0; at the same time” severity warning;; it happened will be printed; Use assertions. Use assertions.

#21/40 Tampere University of Technology (TUT) - Jan 2009

# Checking always on, not just in testbench Assertions are not regarded by synthesis

# report ”Two enable signals must not active

If condition is not true during simulation,

# z the report text, time stamp, component where

# Ensure that your initial assumptions hold

# z e.g. data_width is multiple of 8 (bits)

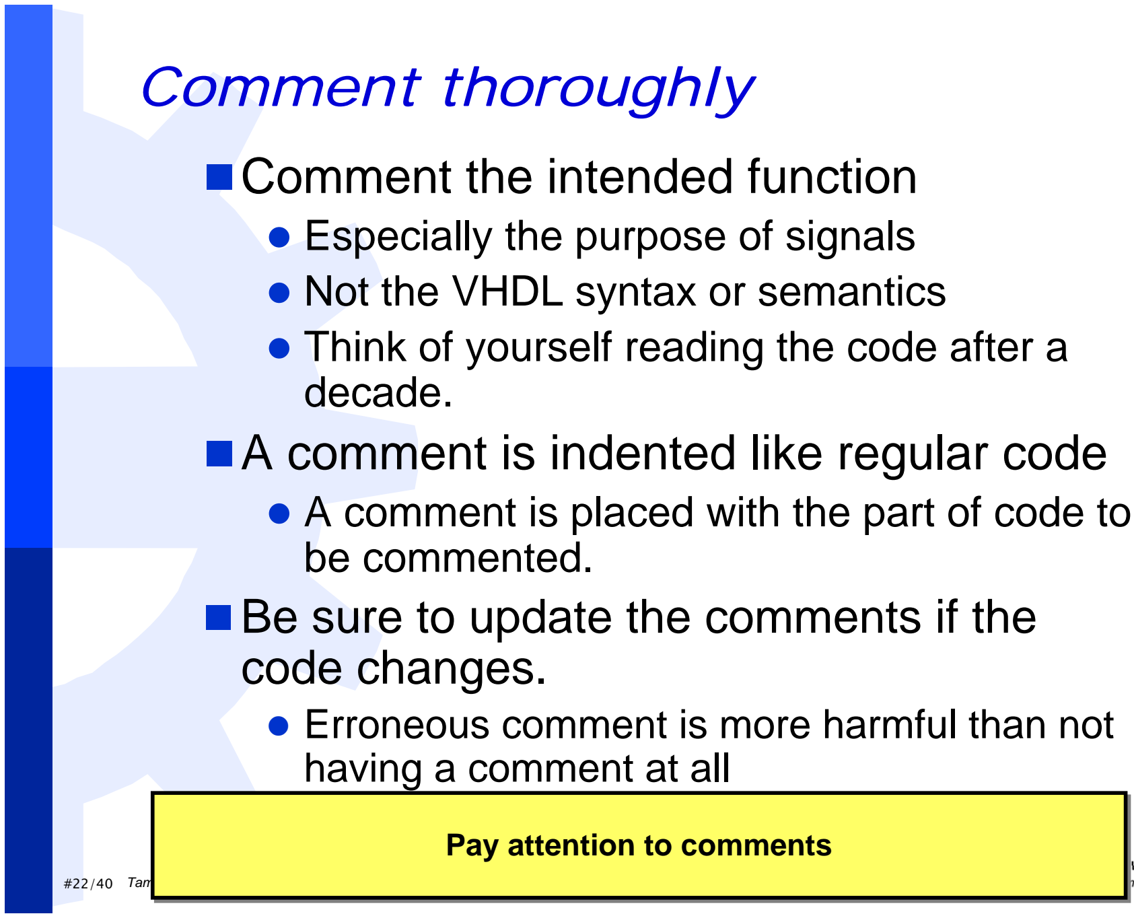
[picture p90: figure]
Comment thoroughly; Comment the intended function z Especially the purpose of signals z Not the VHDL syntax or semantics; decade.; be commented.  Be sure to update the comments if the code changes.; having a comment at all

#22/40 Tampere University of Technology (TUT) - Jan 2009

# z Think of yourself reading the code after a

# A comment is indented like regular code

# z A comment is placed with the part of code to

# z Erroneous comment is more harmful than not

# Pay attention to comments Pay attention to comments

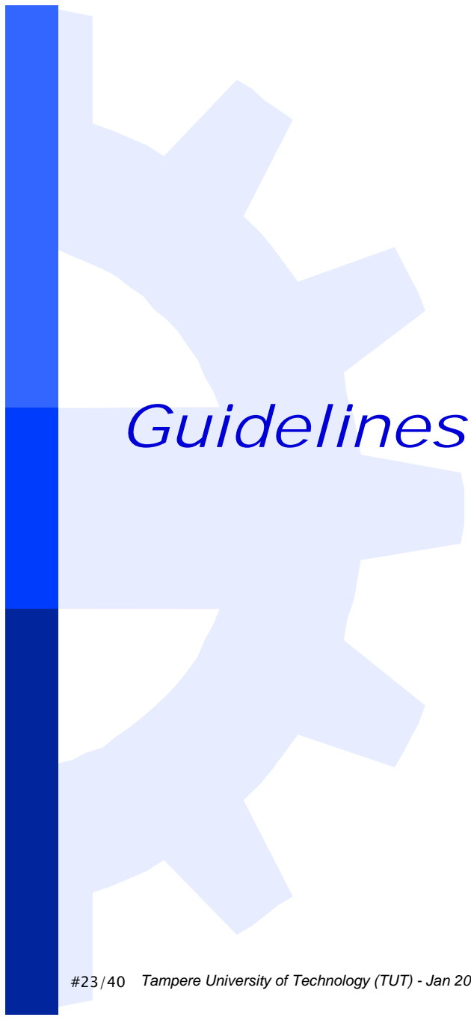
[picture p91: figure]
Guidelines

#23/40 Tampere University of Technology (TUT) - Jan 2009

#24/40 Tampere University of Technology (TUT) - Jan 2009

# Include file header

# Every VHDL file starts with standard header Example

# -- Project : project or course name -- Author : Aulis Kaakko (,student number) -- Date : 2007-30-11 14:05:01 -- File : example.vhd -- Design : Course exercise 1

# -- Description : This unit does function X so that…

# -- $Log$

Every VHDL file starts with a standard header. Every VHDL file starts with a standard header.

#25/40 Tampere University of Technology (TUT) - Jan 2009

# General code appearance

# VHDL code must be indented

# z Much easier to read

# Indentation is fixed inside a project

# z Comment lines are indented like regular code

# In (X)Emacs VHDL mode, use

# z Ctrl-c Ctrl-b to beautify buffer

# z Ctrl-c ctrl-a Ctrl-b to align buffer

# Maximum length of a line is 76 characters

# z In VHDL language it is very easy to divide lines z The commented code line should still fit to the console window

# Use blank lines to make code more readable

Use indentation. Keep lines shorter than 76 characters. Use indentation. Keep lines shorter than 76 characters.

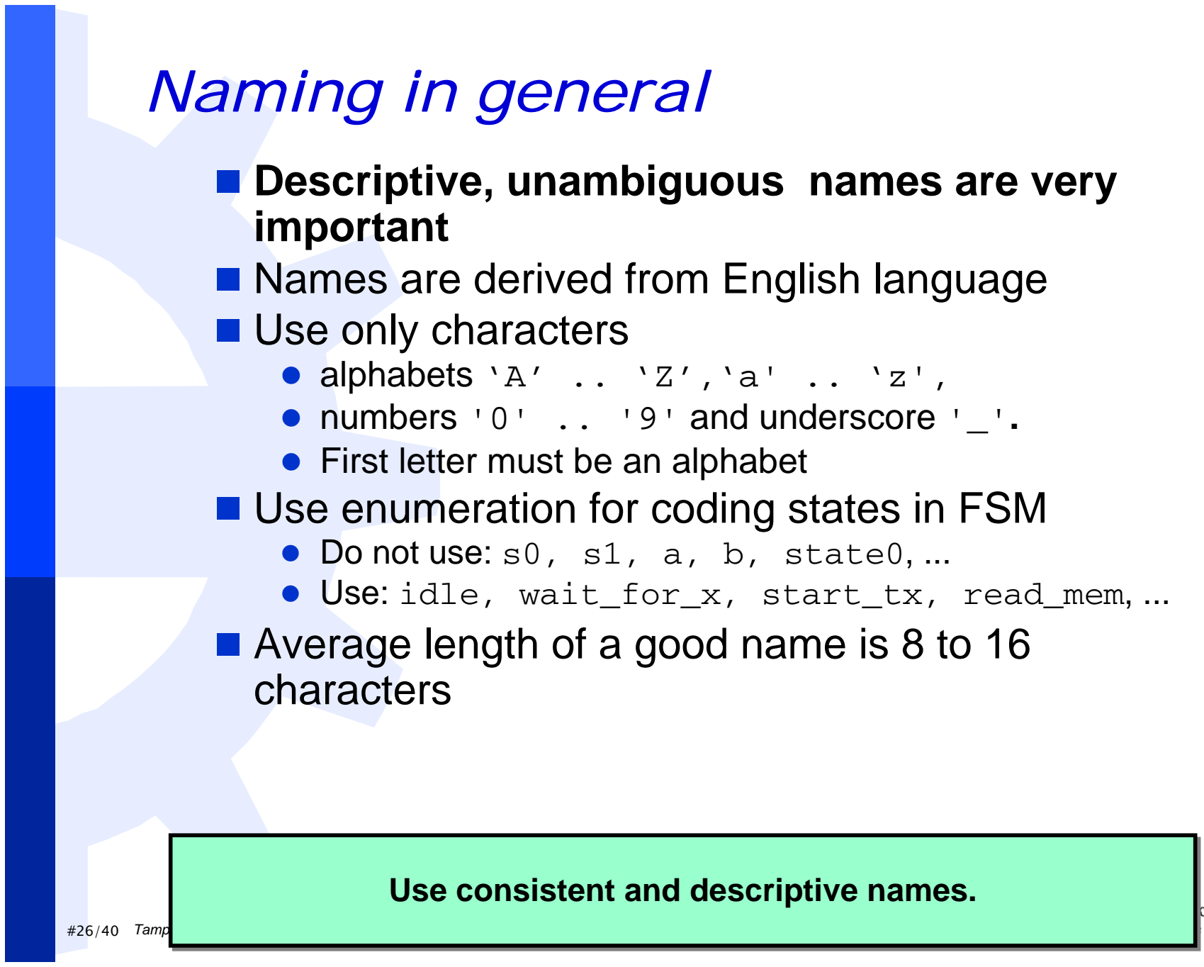
[picture p92: figure]
Naming in general; important;  Use only characters z alphabets ‘A’ .. ‘Z’,‘a' .. ‘z',; z First letter must be an alphabet; z Do not use: s0, s1, a, b, state0, ...; characters

#26/40 Tampere University of Technology (TUT) - Jan 2009

# Descriptive, unambiguous names are very

# Names are derived from English language

z numbers '0' .. '9' and underscore '_'.

# Use enumeration for coding states in FSM

z Use: idle, wait_for_x, start_tx, read_mem, ...

# Average length of a good name is 8 to 16

Use consistent and descriptive names. Use consistent and descriptive names.

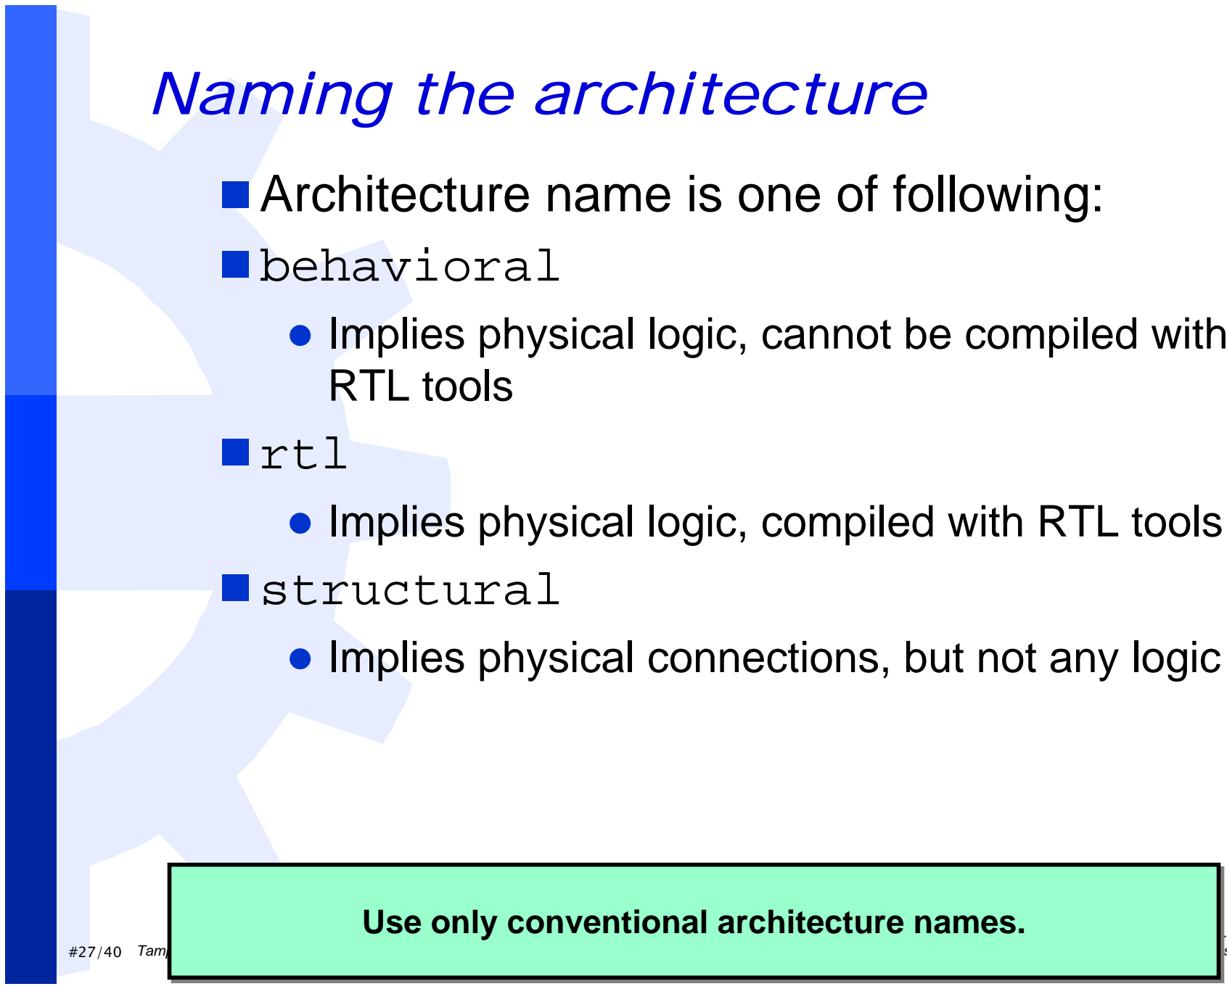
[picture p93: figure]
Naming the architecture;  behavioral; RTL tools  rtl;  structural

#27/40 Tampere University of Technology (TUT) - Jan 2009

# Architecture name is one of following:

# z Implies physical logic, cannot be compiled with

# z Implies physical logic, compiled with RTL tools

# z Implies physical connections, but not any logic

Use only conventional architecture names. Use only conventional architecture names.

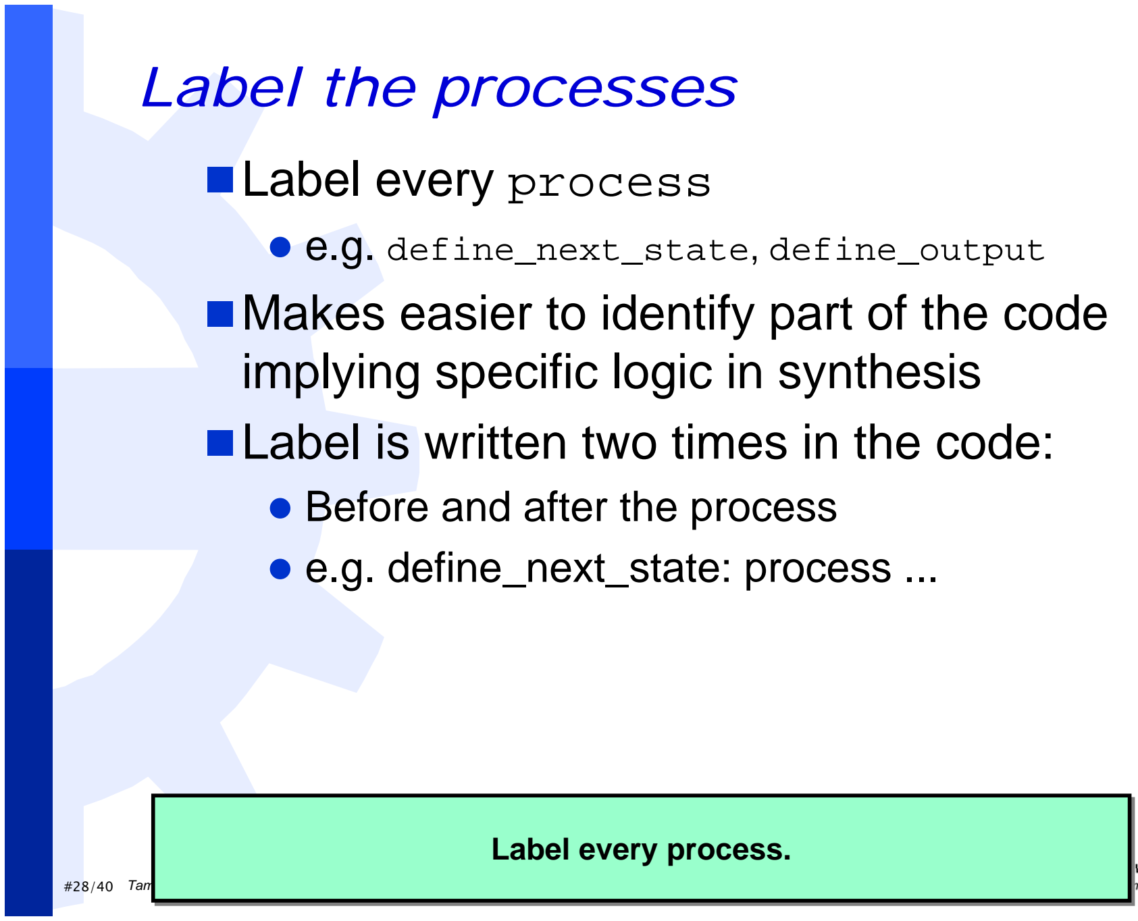
[picture p94: figure]
Label the processes; Label every process; z e.g. define_next_state, define_output; implying specific logic in synthesis; z Before and after the process z e.g. define_next_state: process ...

#28/40 Tampere University of Technology (TUT) - Jan 2009

# Makes easier to identify part of the code

# Label is written two times in the code:

Label every process. Label every process.

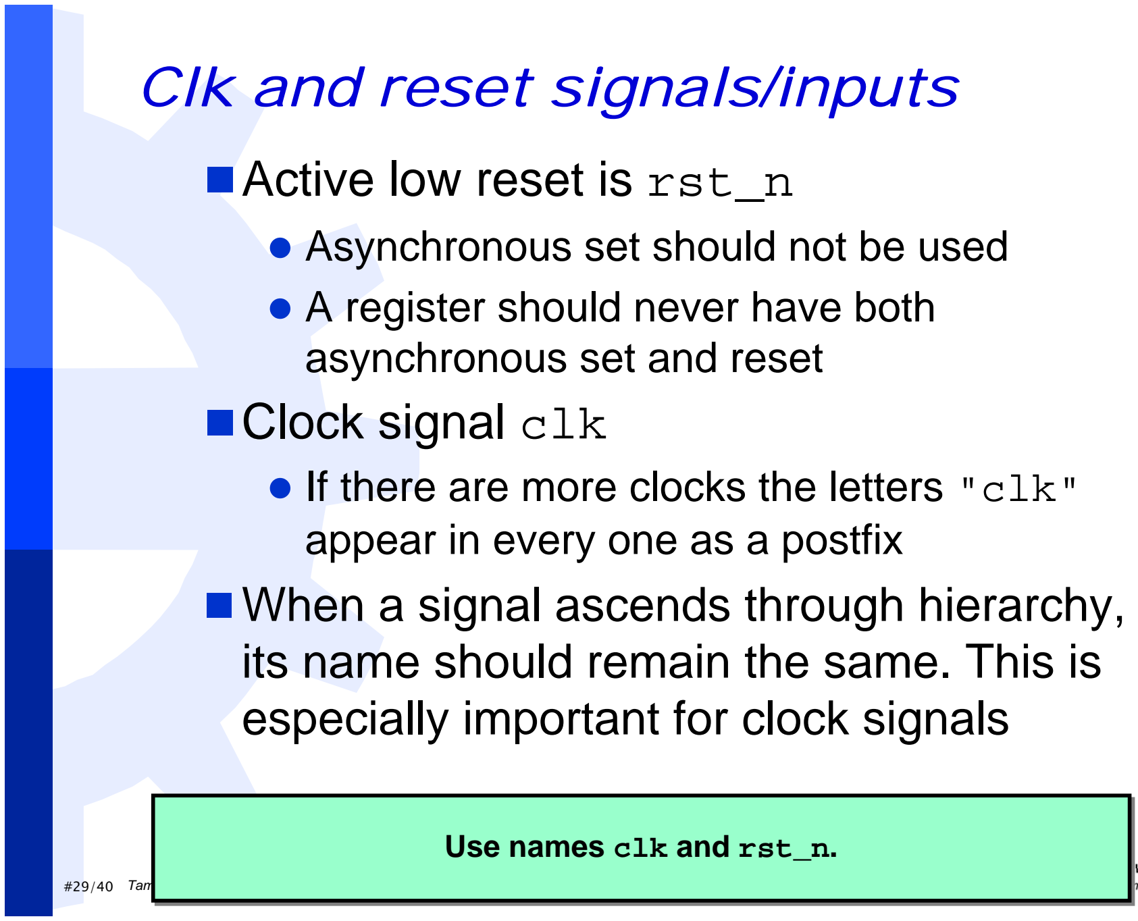
[picture p95: figure]
Clk and reset signals/inputs; Active low reset is rst_n; z Asynchronous set should not be used z A register should never have both asynchronous set and reset Clock signal clk; appear in every one as a postfix; especially important for clock signals

#29/40 Tampere University of Technology (TUT) - Jan 2009

# z If there are more clocks the letters "clk"

When a signal ascends through hierarchy,

# its name should remain the same. This is

Use names Use names clk clk and and rst_n rst_n..

#30/40 Tampere University of Technology (TUT) - Jan 2009

# Naming intermediate signals

# Signals from instance a to b are named: signalname_a_b

# z Needed in structural architectures

# They NEVER have "in" or "out" specifiers

# z output of a is connected to input of b - cannot decide which postfix to choose

# Abbreviated component names are handy when names are longer than a and b With multiple targets use signalname_from_a

component component aa | component component bb data_a_b
data_out | data_in
port name | signal name

Intermediate signal’s name includes src and and dst. Intermediate signal’s name includes src and and dst.

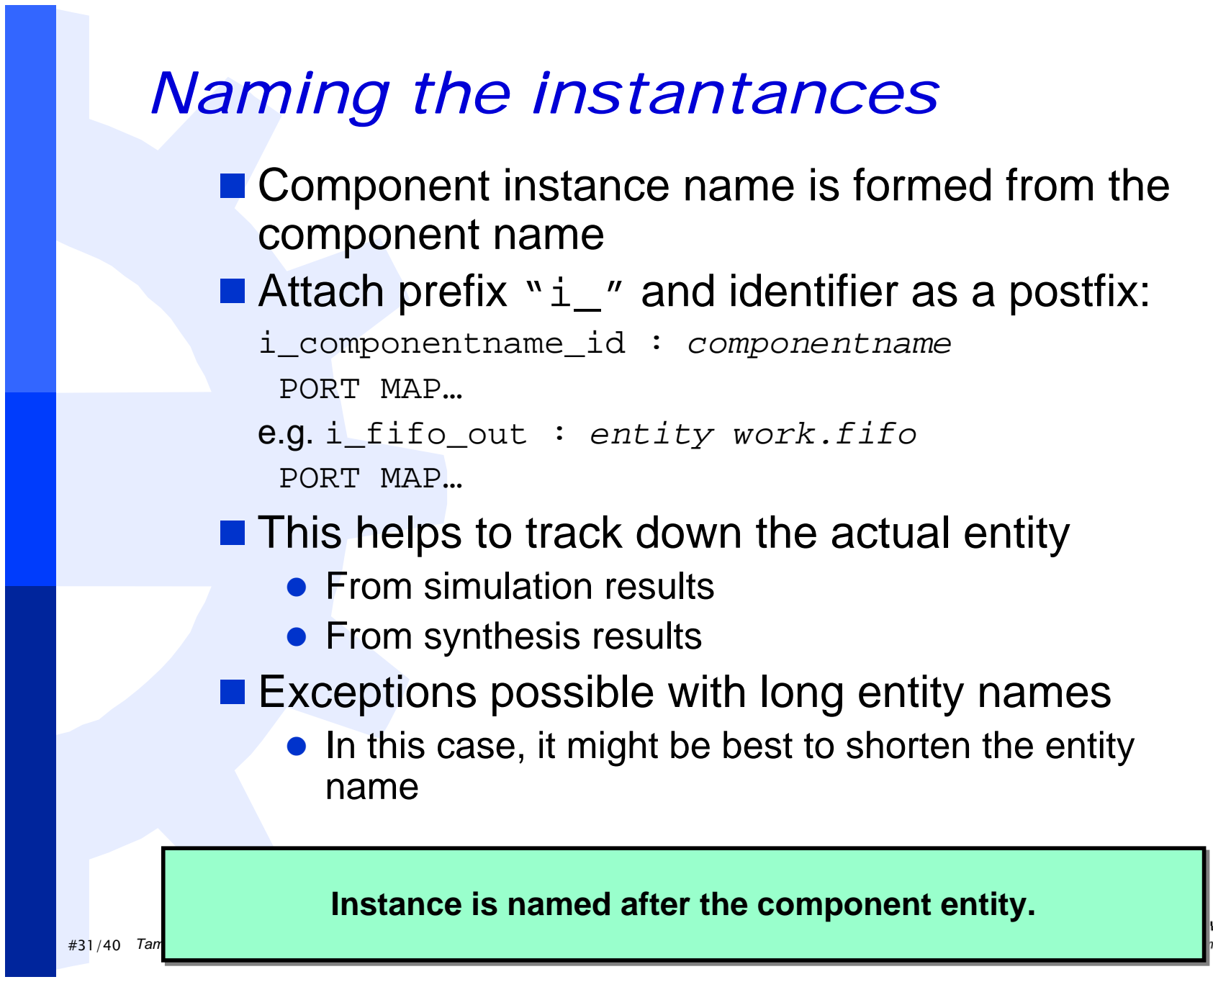
[picture p96: figure]
Naming the instantances; component name; i_componentname_id : componentname PORT MAP… e.g. i_fifo_out : entity work.fifo PORT MAP…; z From simulation results z From synthesis results; name

#31/40 Tampere University of Technology (TUT) - Jan 2009

# Component instance name is formed from the

# Attach prefix “i_” and identifier as a postfix:

# This helps to track down the actual entity

# Exceptions possible with long entity names

# z In this case, it might be best to shorten the entity

Instance is named after the component entity. Instance is named after the component entity.

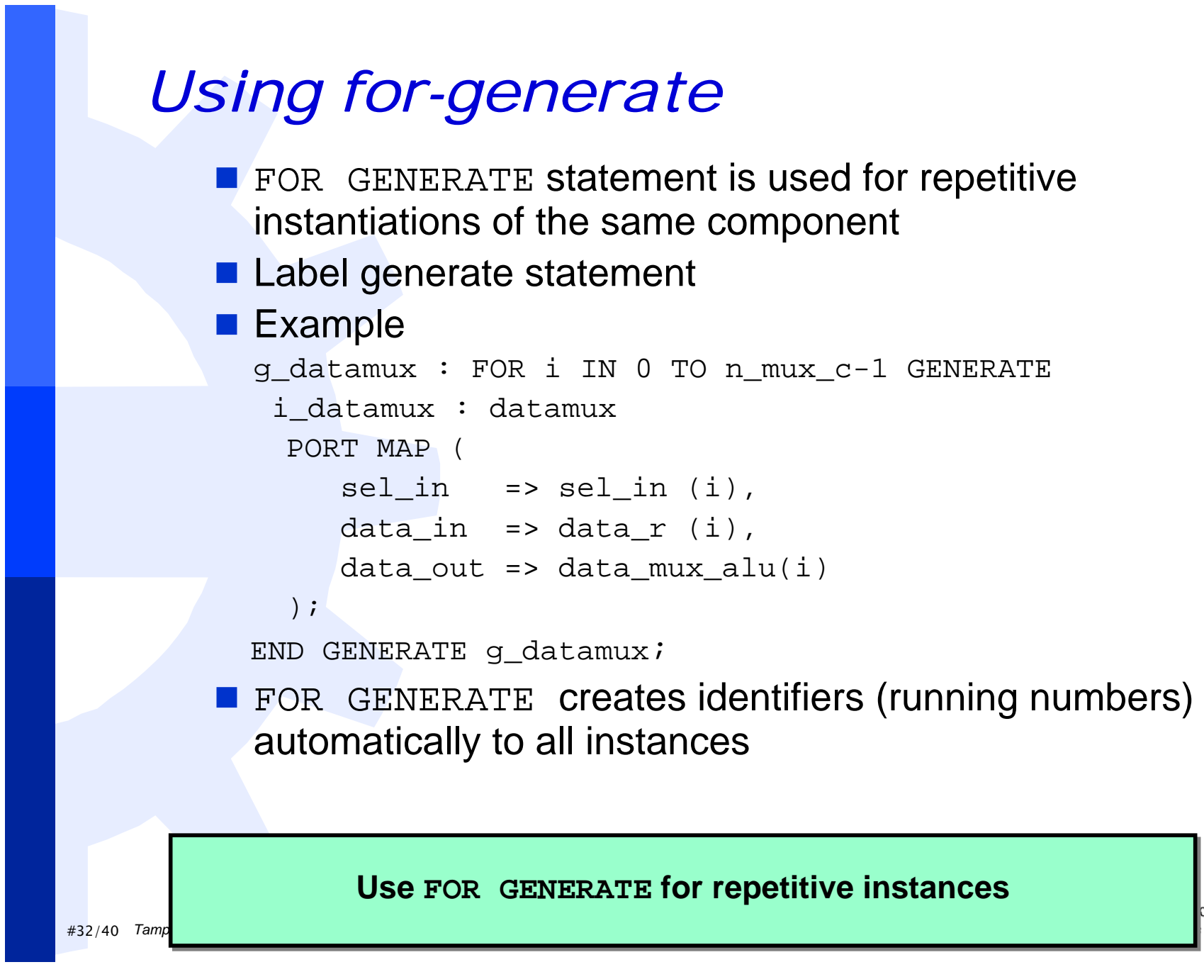
[picture p97: figure]
Using for-generate; instantiations of the same component  Label generate statement  Example; i_datamux : datamux PORT MAP (; sel_in; => sel_in (i),; data_in => data_r (i), data_out => data_mux_alu(i); ); END GENERATE g_datamux;; automatically to all instances

#32/40 Tampere University of Technology (TUT) - Jan 2009

# FOR GENERATE statement is used for repetitive

# g_datamux : FOR i IN 0 TO n_mux_c-1 GENERATE

# FOR GENERATE creates identifiers (running numbers)

# Use Use FOR GENERATE FOR GENERATE for repetitive instances for repetitive instances

#33/40 Tampere University of Technology (TUT) - Jan 2009

# Recommended naming

Between components | signalname_a_b
To multiple components | signalname_from_a
The only clock input port | clk

# Low active reset input port rst_n

Component instances | i_componentname_id
Generate statements | g_componentname

# Prefer these naming conventions Prefer these naming conventions

#34/40 Tampere University of Technology (TUT) - Jan 2009

# Prefer generics Prefer generics

# Basically, generic parameter is a fundamental idea in VHDL

that enables design reuse, use it.

# Avoid constants (in packages or architecture)

# z if data_width_c is defined is package, it is impossible to have instances with different data_width_c values - E.g. This limits all adders in the system to 10 bits z With generics, it is possible to have different adders

# The component size should be changed with generics NOT

by modifying the code.

# When the VHDL code is reused, there should be no need to read the code except the entity definition

# If there are illegal combinations of generic values, use assertions to make sure that given generics are valid However, having many generic parameters, complicates

# verification

# Prefer generics to package constants Prefer generics to package constants

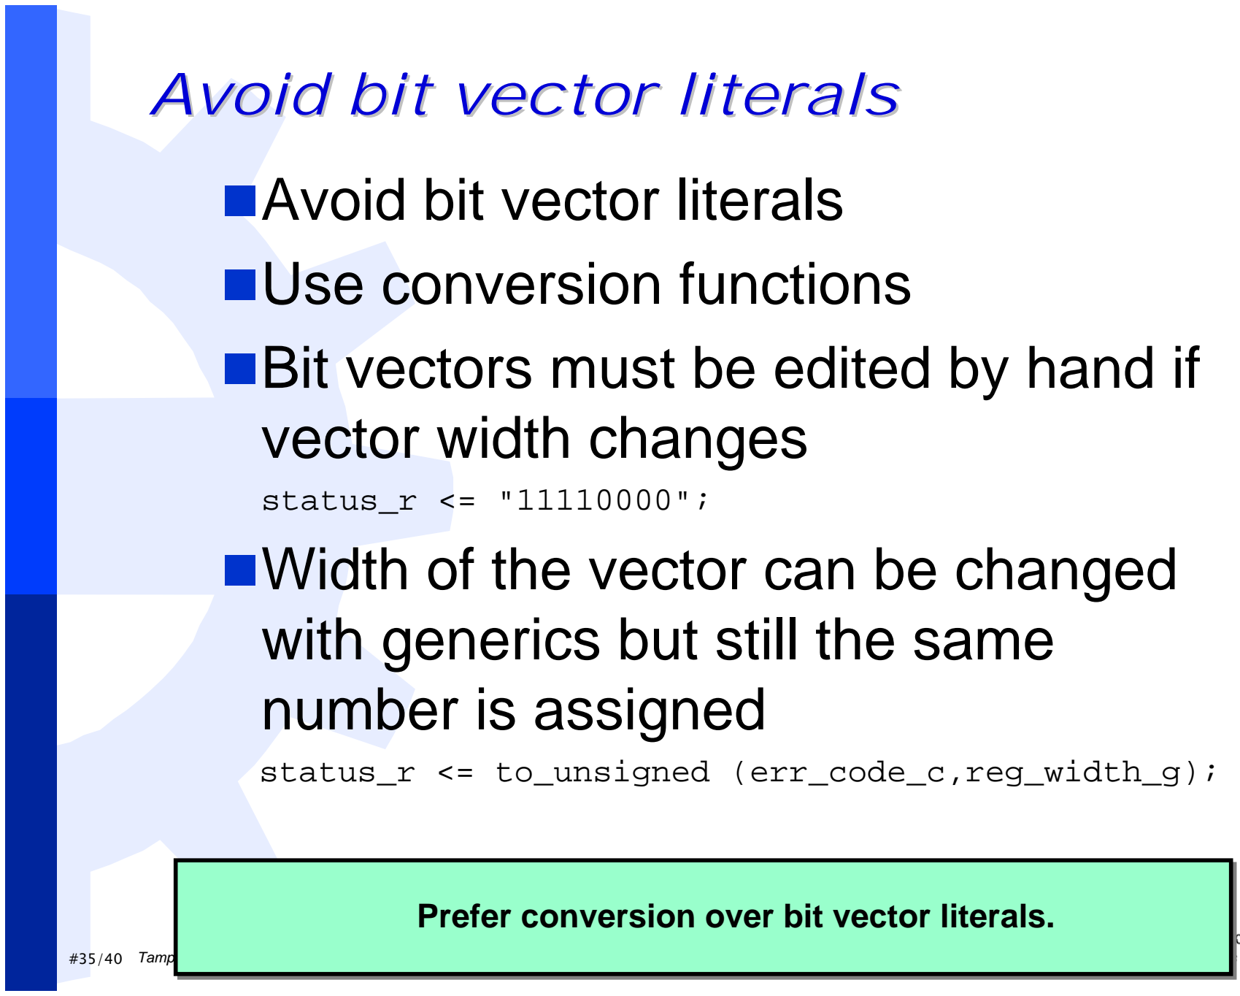
[picture p98: figure]
Avoid bit vector literals Use conversion functions Bit vectors must be edited by hand if vector width changes; status_r <= "11110000"; Width of the vector can be changed with generics but still the same number is assigned

#35/40 Tampere University of Technology (TUT) - Jan 2009

# Avoid bit vector literals Avoid bit vector literals

status_r <= to_unsigned (err_code_c,reg_width_g);

Prefer conversion over bit vector literals. Prefer conversion over bit vector literals.

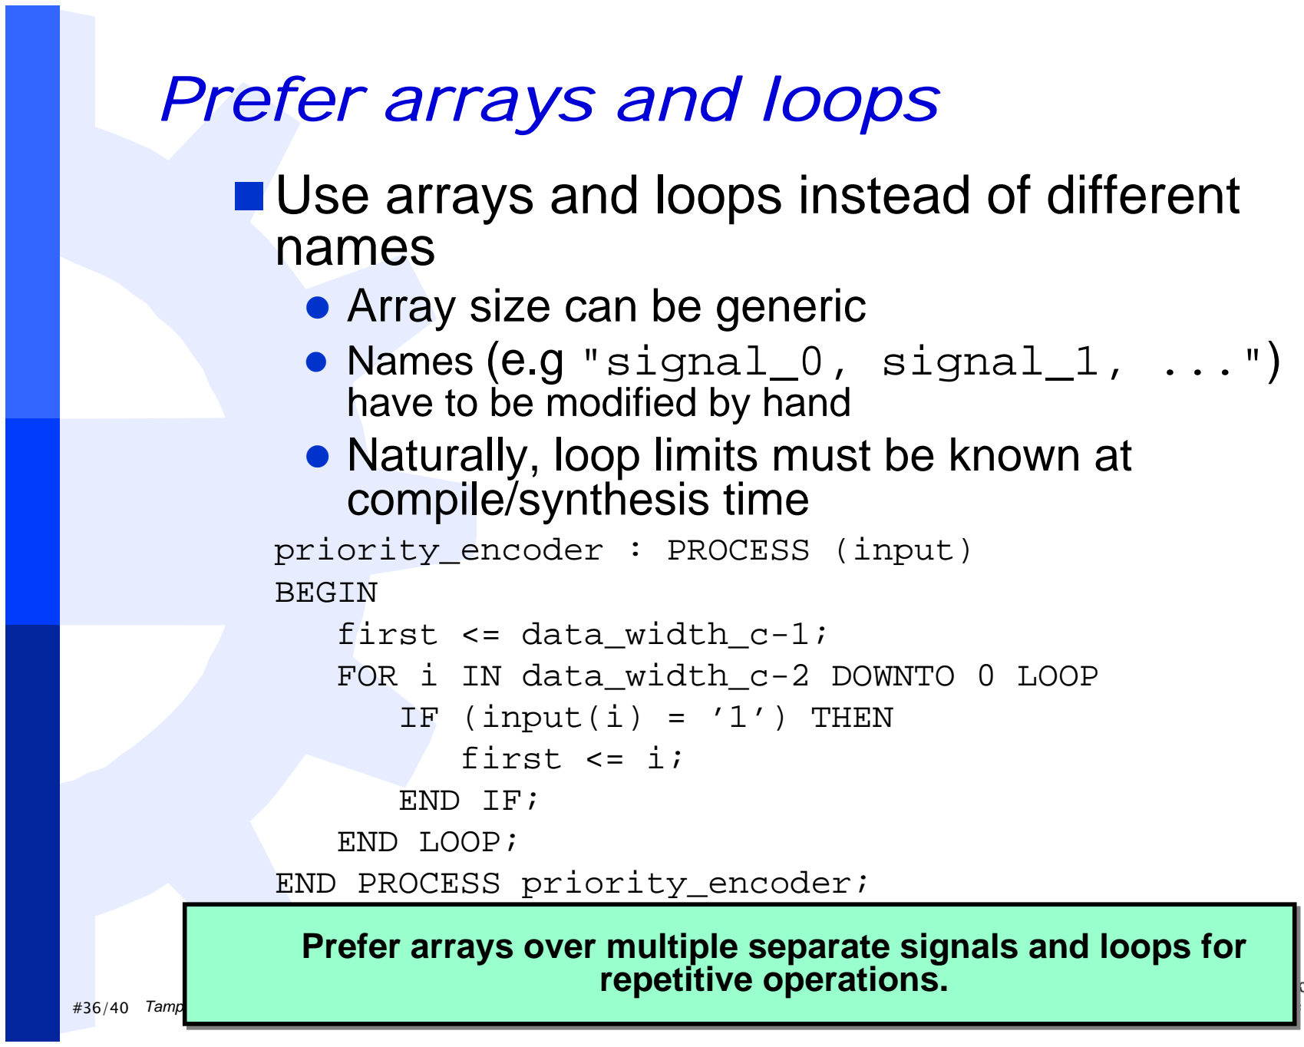
[picture p99: figure]
Prefer arrays and loops; names z Array size can be generic z Names (e.g "signal_0, signal_1, ...") have to be modified by hand; compile/synthesis time priority_encoder : PROCESS (input) BEGIN first <= data_width_c-1; FOR i IN data_width_c-2 DOWNTO 0 LOOP IF (input(i) = ’1’) THEN first <= i; END IF; END LOOP; END PROCESS priority_encoder;; repetitive operations.

#36/40 Tampere University of Technology (TUT) - Jan 2009

# Use arrays and loops instead of different

# z Naturally, loop limits must be known at

# Prefer arrays over multiple separate signals and loops for

# Prefer arrays over multiple separate signals and loops for

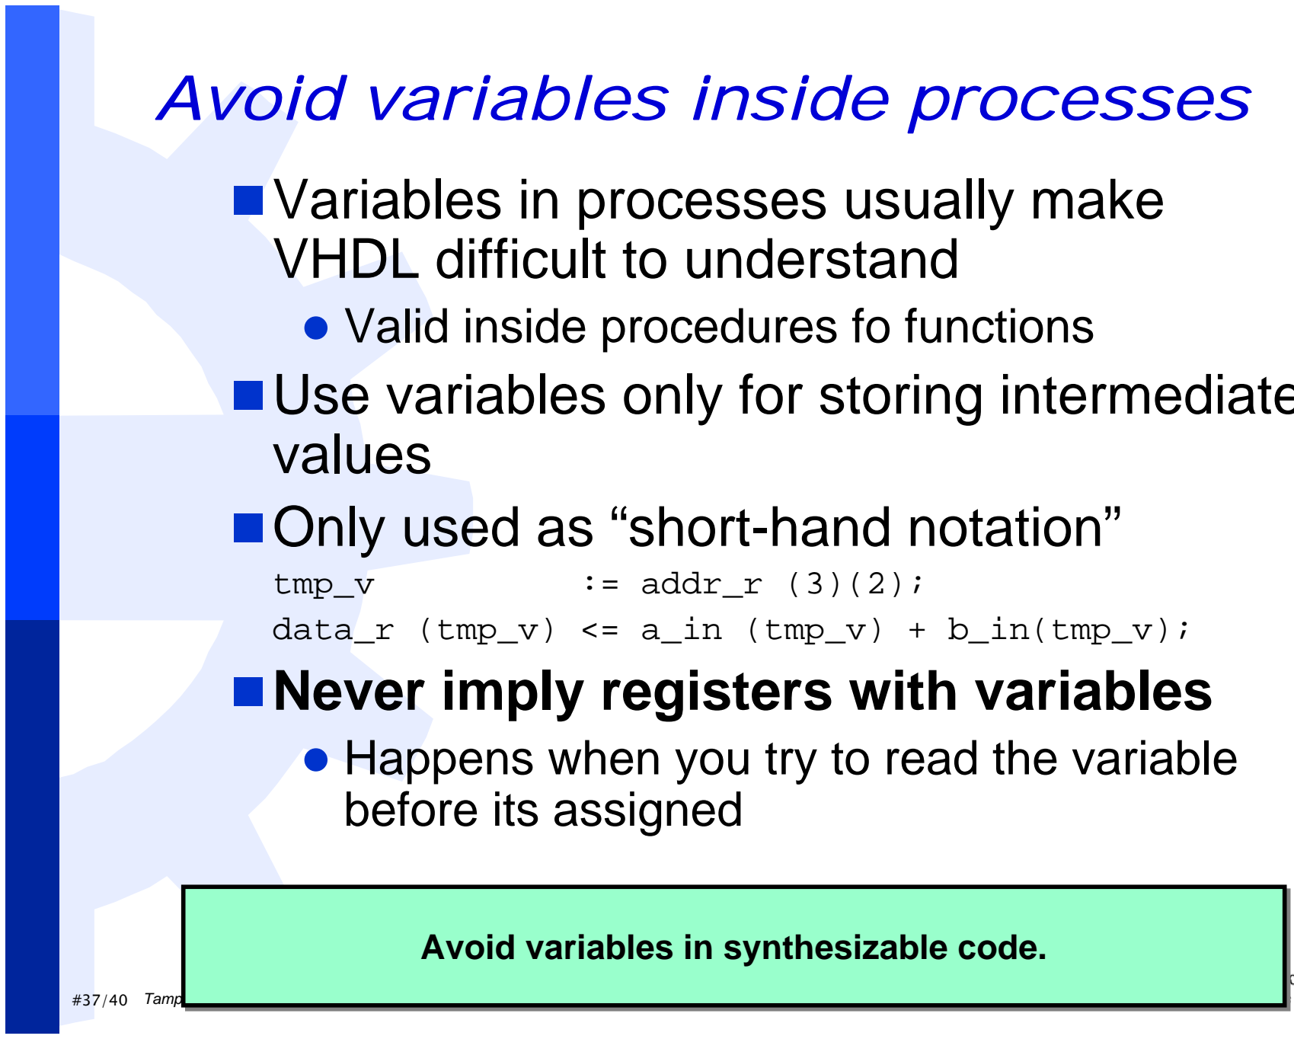
[picture p100: figure]
Avoid variables inside processes; Variables in processes usually make VHDL difficult to understand z Valid inside procedures fo functions; values Only used as “short-hand notation”; tmp_v; := addr_r (3)(2);; Never imply registers with variables; before its assigned

#37/40 Tampere University of Technology (TUT) - Jan 2009

# Use variables only for storing intermediate

data_r (tmp_v) <= a_in (tmp_v) + b_in(tmp_v);

# z Happens when you try to read the variable

Avoid variables in synthesizable code. Avoid variables in synthesizable code.

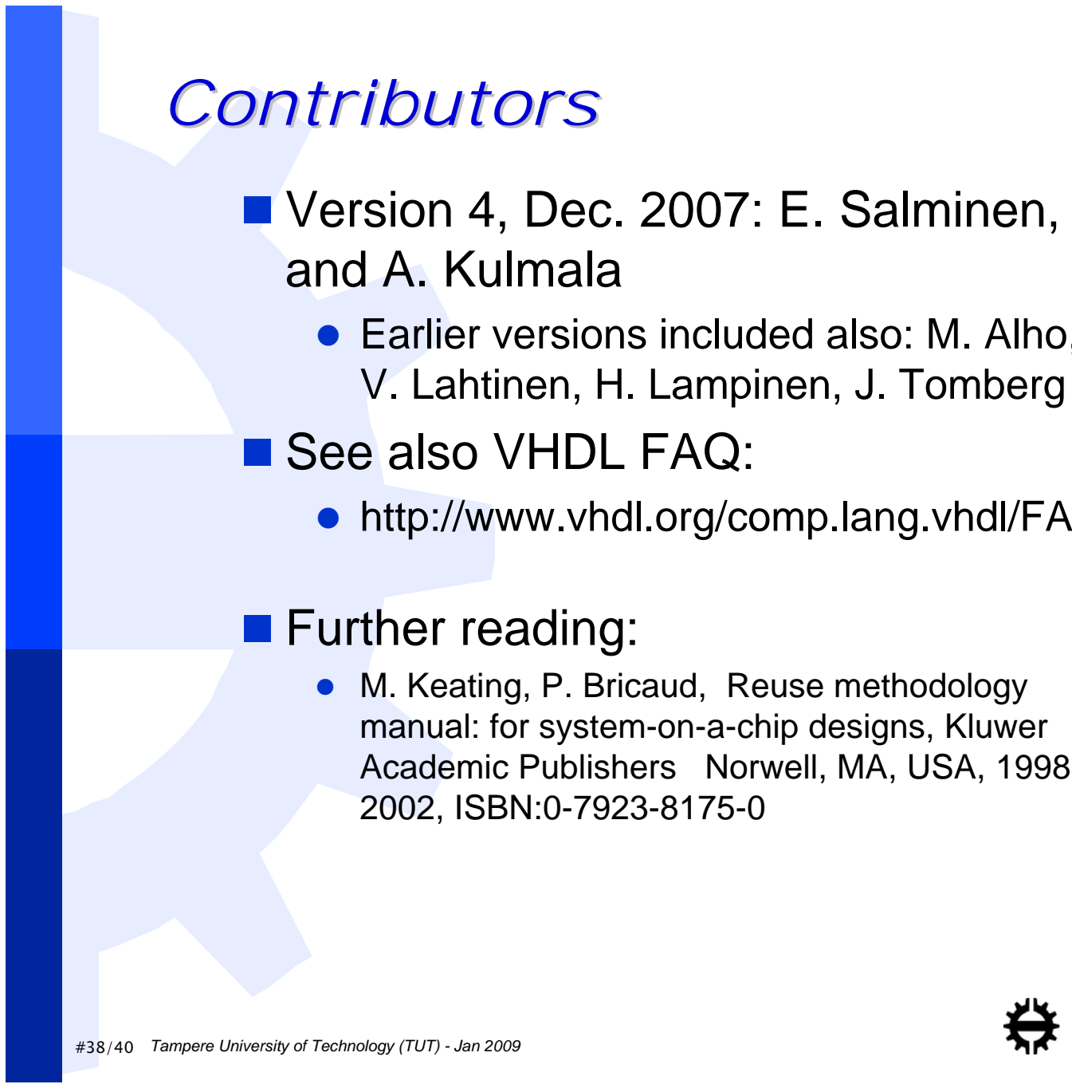
[picture p101: figure]
Contributors Contributors; and A. Kulmala; V. Lahtinen, H. Lampinen, J. Tomberg  See also VHDL FAQ:;  Further reading:; 2002, ISBN:0-7923-8175-0

#38/40 Tampere University of Technology (TUT) - Jan 2009

Version 4, Dec. 2007: E. Salminen, A. Rasmus,

z Earlier versions included also: M. Alho, K. Kuusilinna,

# z http://www.vhdl.org/comp.lang.vhdl/FAQ1.html

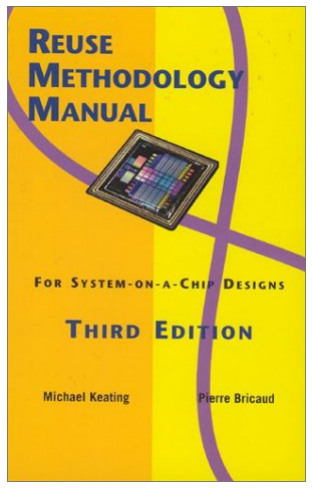
[picture p102: figure]

# z M. Keating, P. Bricaud, Reuse methodology manual: for system-on-a-chip designs, Kluwer Academic Publishers Norwell, MA, USA, 1998 /

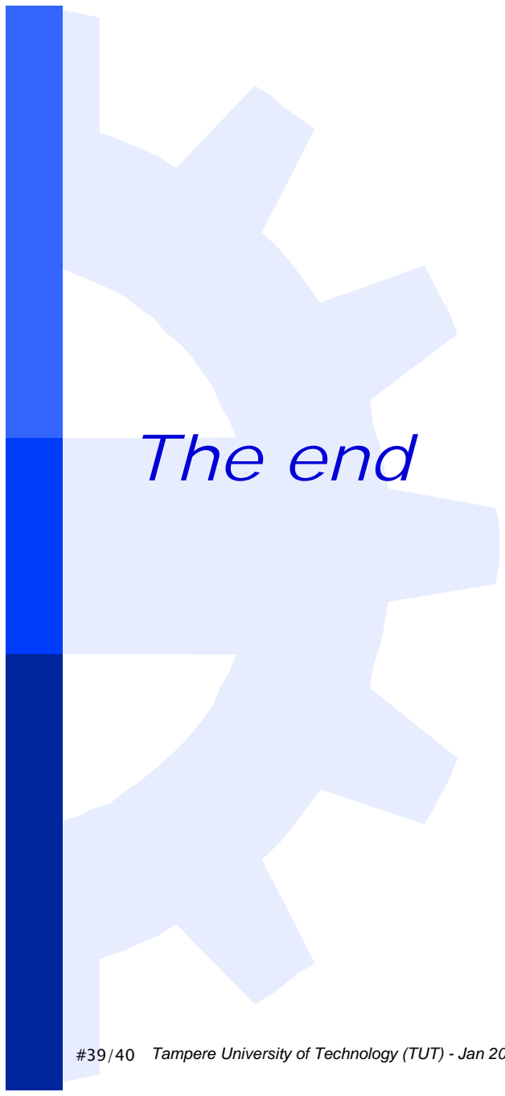
[picture p103: figure]
The end

#39/40 Tampere University of Technology (TUT) - Jan 2009

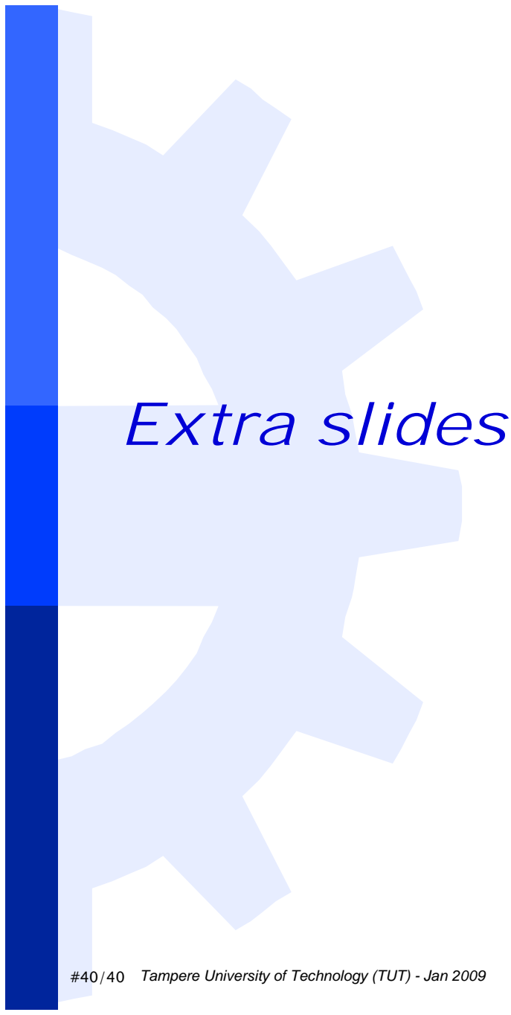
[picture p104: figure]
Extra slides

#40/40 Tampere University of Technology (TUT) - Jan 2009

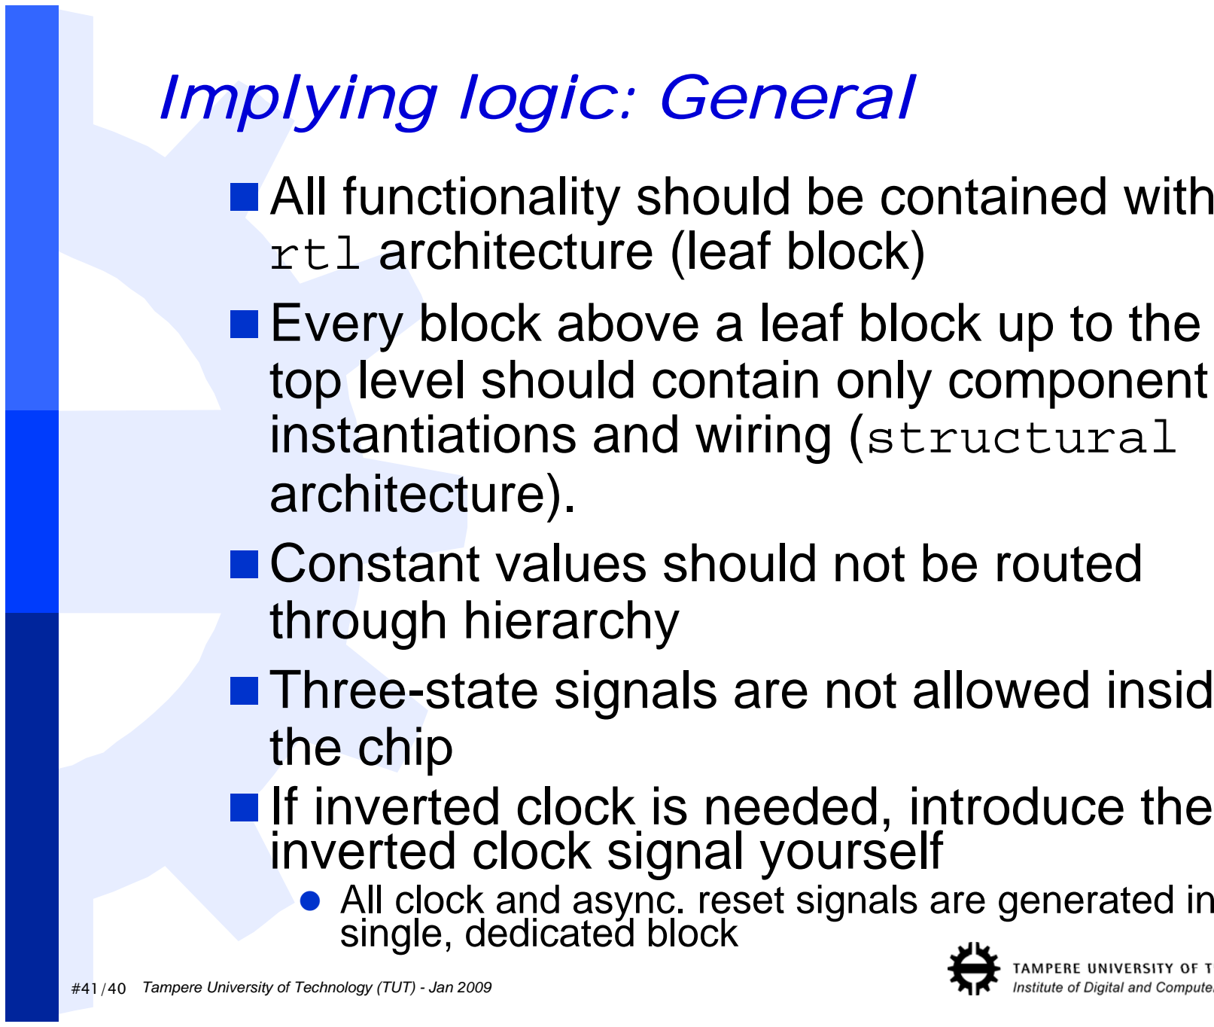
[picture p105: figure]
Implying logic: General; rtl architecture (leaf block); top level should contain only component instantiations and wiring (structural architecture).  Constant values should not be routed through hierarchy; the chip

#41/40 Tampere University of Technology (TUT) - Jan 2009

# All functionality should be contained within

# Every block above a leaf block up to the

# Three-state signals are not allowed inside

# If inverted clock is needed, introduce the inverted clock signal yourself

# z All clock and async. reset signals are generated in a single, dedicated block

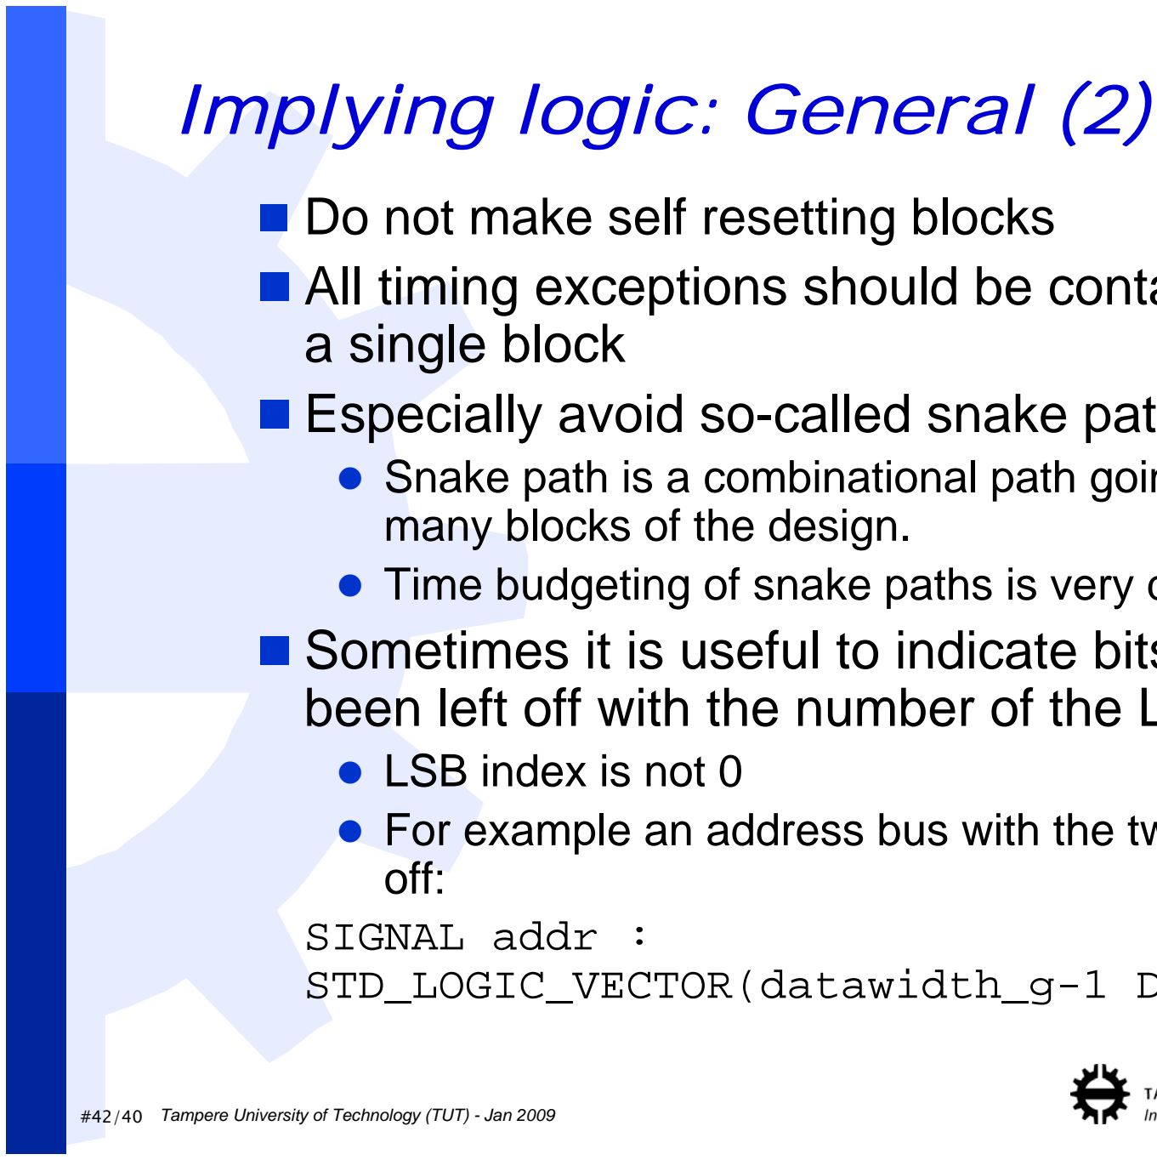
[picture p106: figure]
Implying logic: General (2);  Do not make self resetting blocks; a single block; many blocks of the design.; z LSB index is not 0; off: SIGNAL addr :

#42/40 Tampere University of Technology (TUT) - Jan 2009

# All timing exceptions should be contained within

# Especially avoid so-called snake paths

# z Snake path is a combinational path going through

# z Time budgeting of snake paths is very difficult

# Sometimes it is useful to indicate bits that have been left off with the number of the LSB

# z For example an address bus with the two LSBs left

STD_LOGIC_VECTOR(datawidth_g-1 DOWNTO 2);

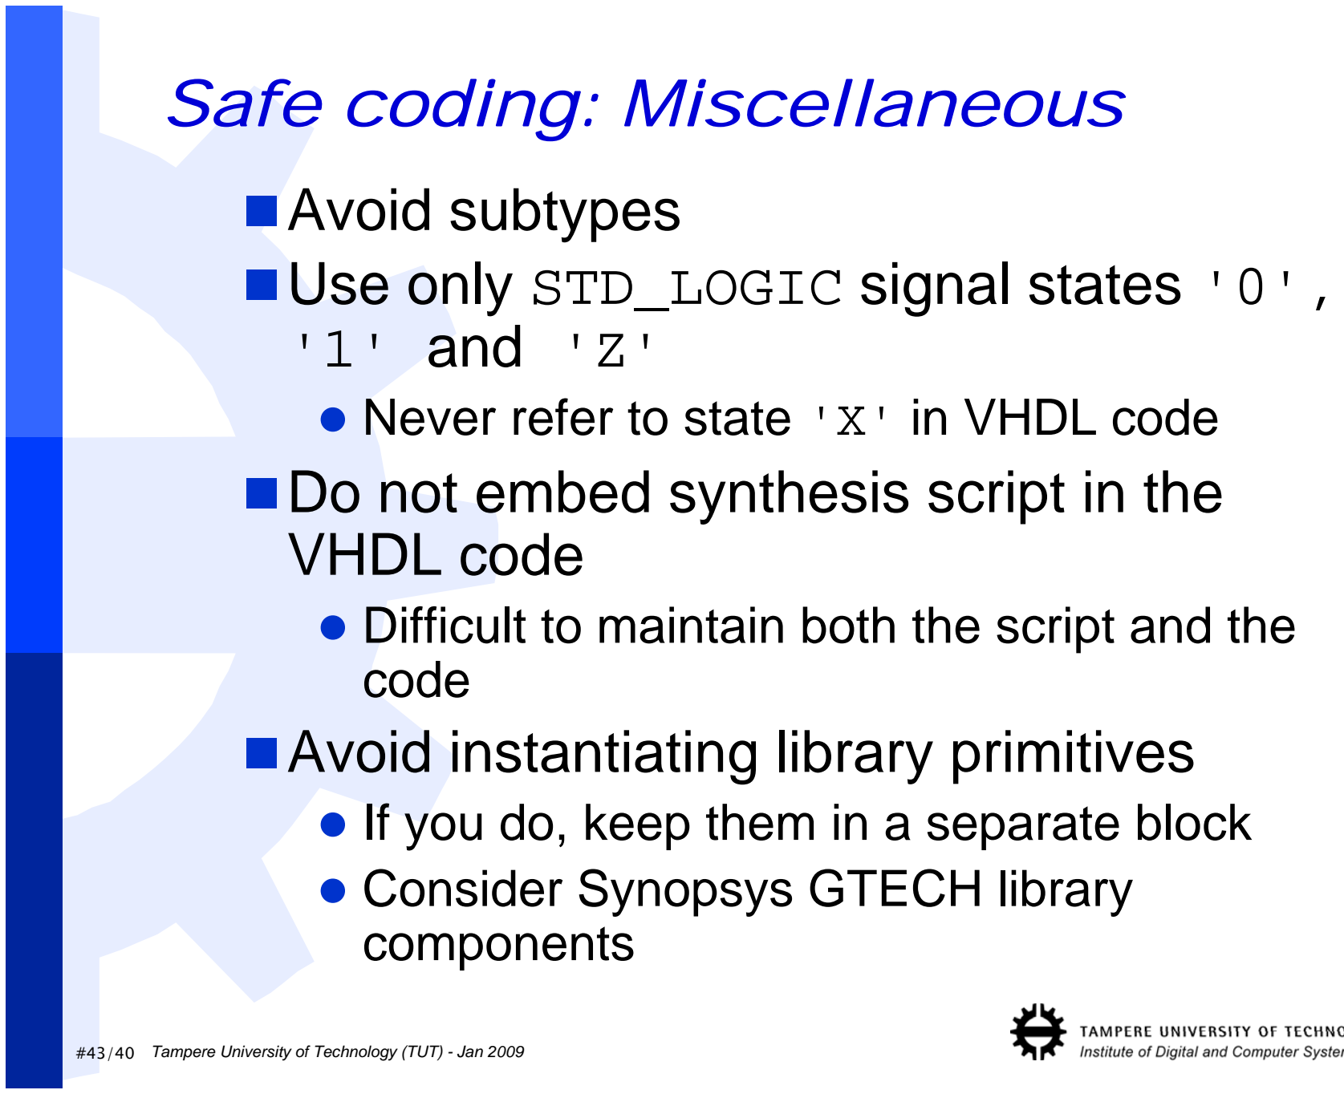
[picture p107: figure]
Safe coding: Miscellaneous; Avoid subtypes Use only STD_LOGIC signal states '0', '1' and 'Z' z Never refer to state 'X' in VHDL code Do not embed synthesis script in the VHDL code; code Avoid instantiating library primitives; z Consider Synopsys GTECH library components

#43/40 Tampere University of Technology (TUT) - Jan 2009

# z Difficult to maintain both the script and the

# z If you do, keep them in a separate block

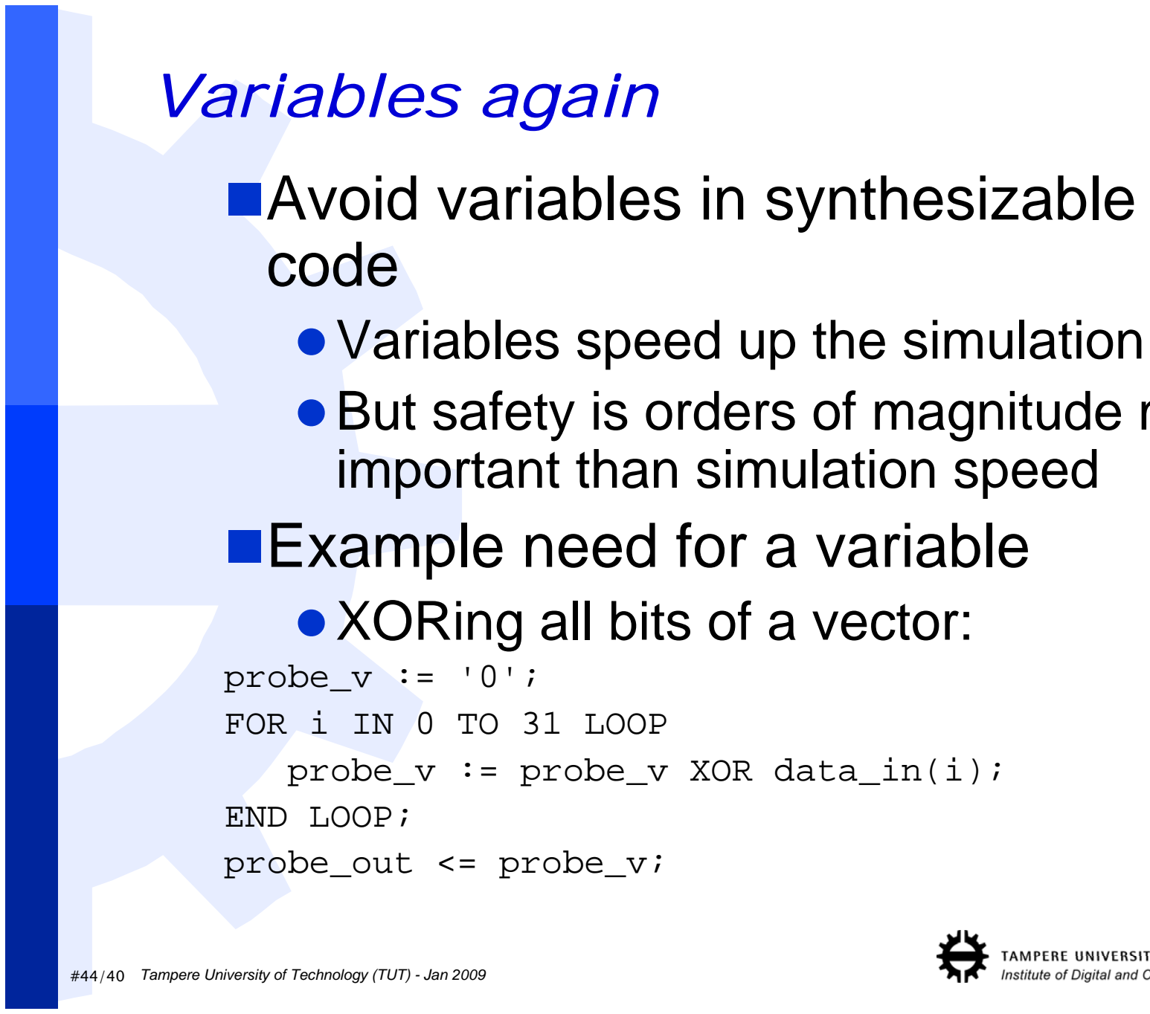
[picture p108: figure]
Variables again; Avoid variables in synthesizable code z Variables speed up the simulation; important than simulation speed Example need for a variable z XORing all bits of a vector:; probe_v := '0'; FOR i IN 0 TO 31 LOOP probe_v := probe_v XOR data_in(i); END LOOP; probe_out <= probe_v;

#44/40 Tampere University of Technology (TUT) - Jan 2009

# z But safety is orders of magnitude more

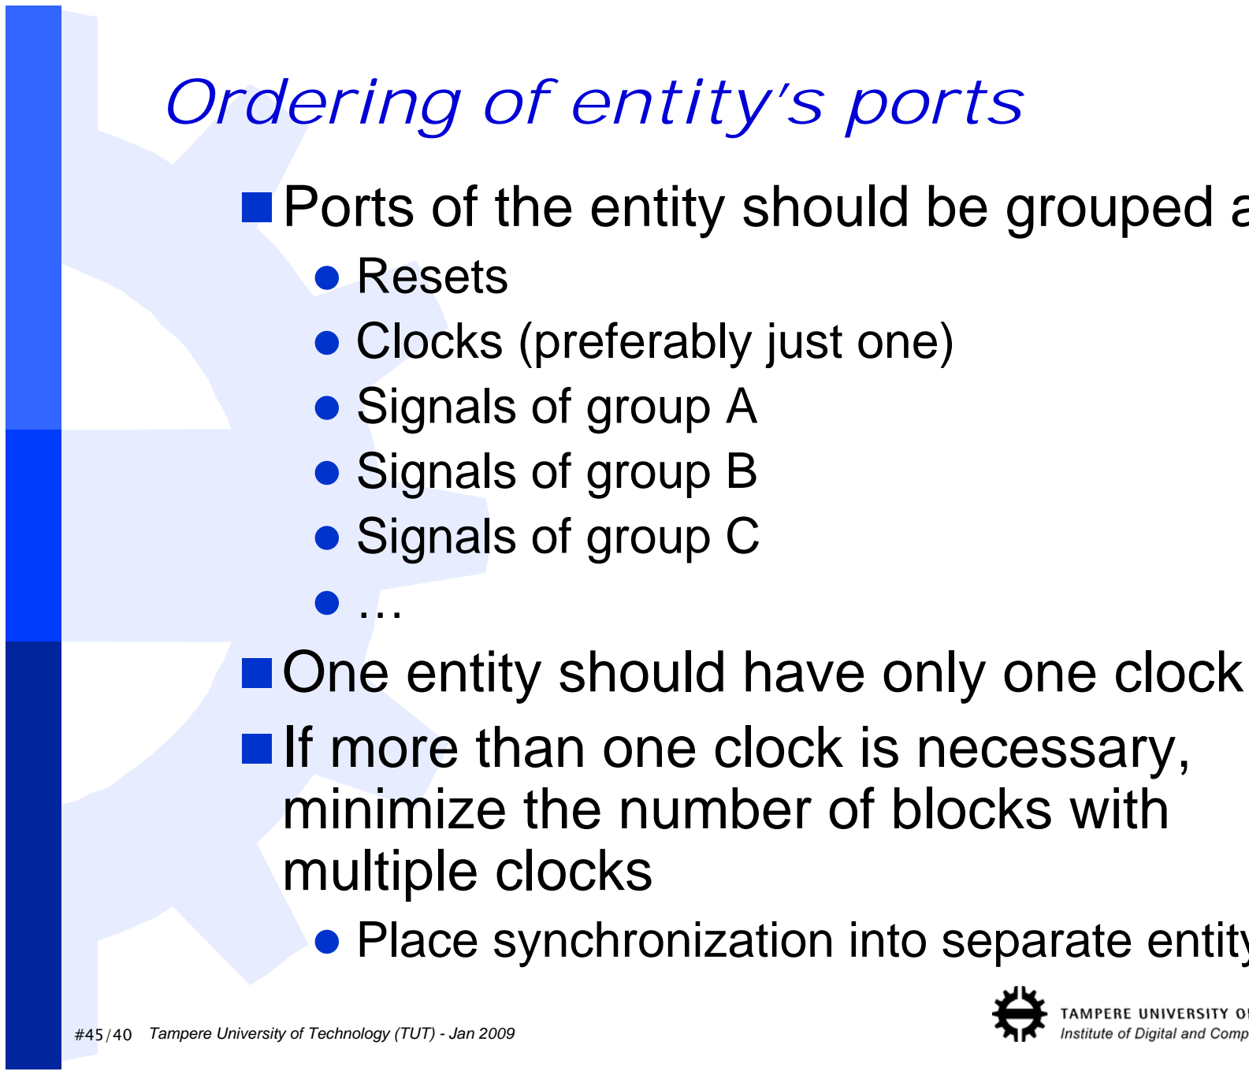
[picture p109: figure]
Ordering of entity’s ports; z Resets z Clocks (preferably just one) z Signals of group A z Signals of group B z Signals of group C z … One entity should have only one clock If more than one clock is necessary, minimize the number of blocks with multiple clocks

#45/40 Tampere University of Technology (TUT) - Jan 2009

# Ports of the entity should be grouped as:

# z Place synchronization into separate entity

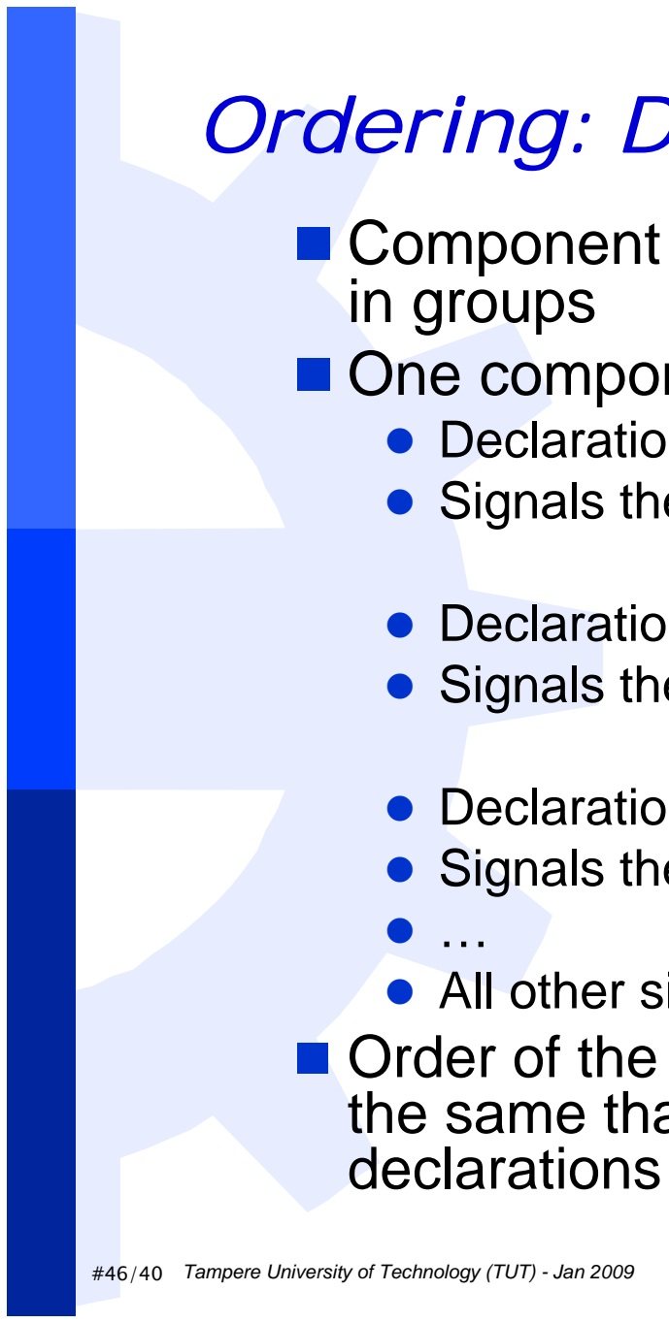
[picture p110: figure]
in groups; declarations

#46/40 Tampere University of Technology (TUT) - Jan 2009

# Ordering: Declarations I

# Component and signal declarations are ordered

# One component and specific signals:

# z Declaration of component A z Signals the instantiations of component A drive

# z Declaration of component B z Signals the instantiations of component B drive

# z Declaration of component C z Signals the instantiations of component C drive

# z All other signals (if any)

# Order of the component instantiations should be the same than the order of the component

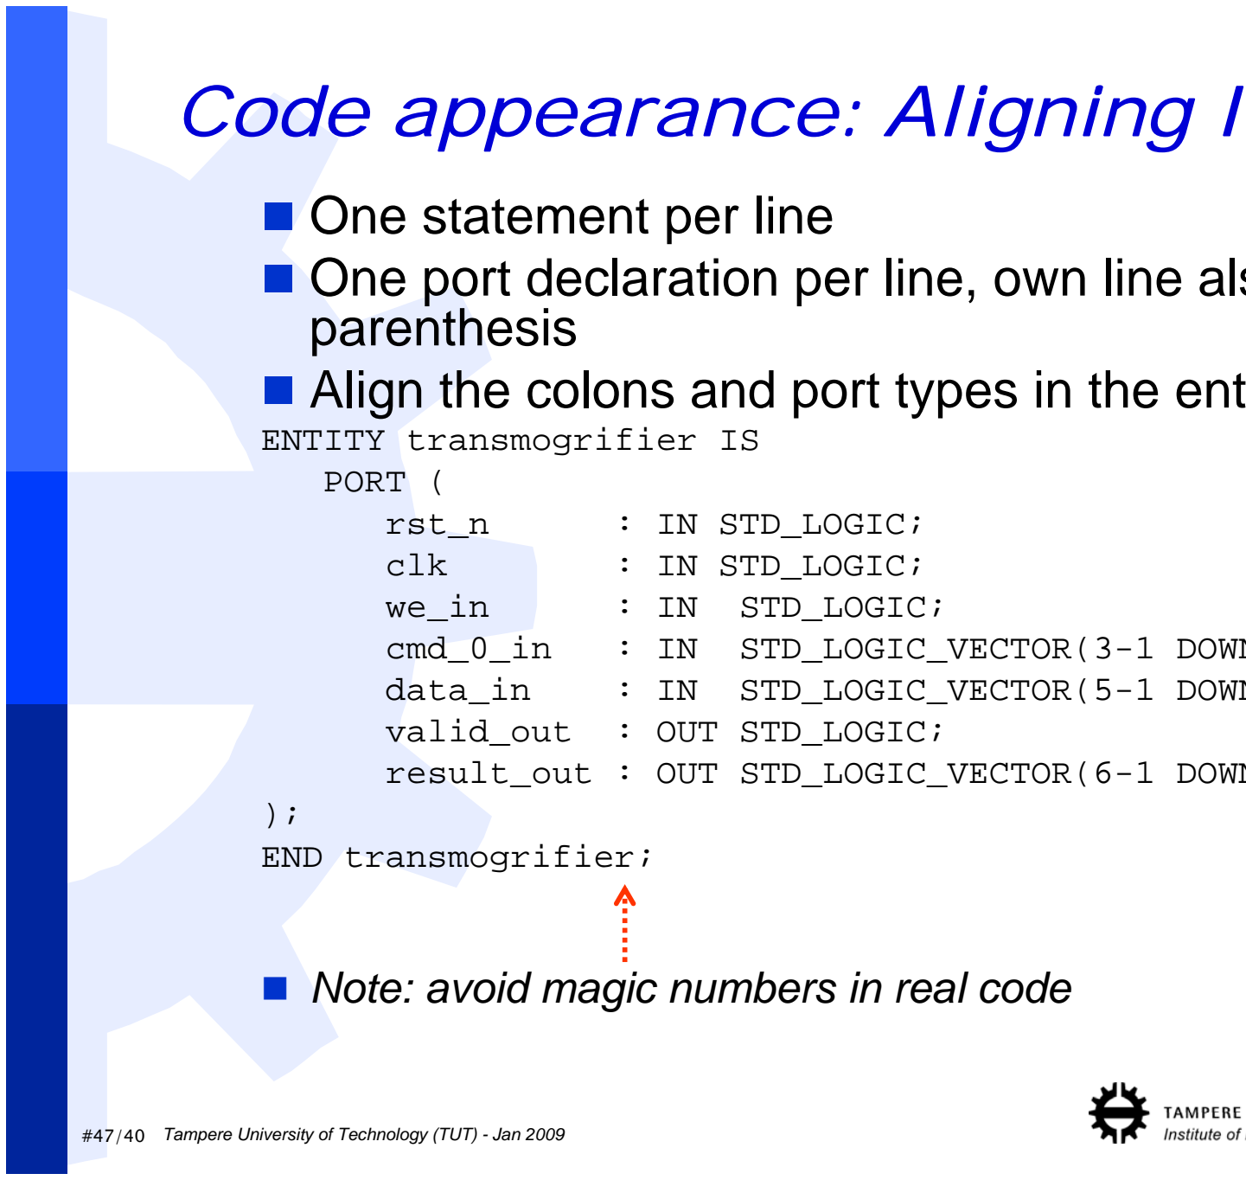
[picture p111: figure]
Code appearance: Aligning I;  One statement per line; parenthesis; ENTITY transmogrifier IS PORT (; rst_n; : IN STD_LOGIC;; clk; valid_out : OUT STD_LOGIC;; ); END transmogrifier;

#47/40 Tampere University of Technology (TUT) - Jan 2009

# One port declaration per line, own line also for end

# Align the colons and port types in the entity port:

cmd_0_in | : IN STD_LOGIC_VECTOR(3-1 DOWNTO 0);
data_in | : IN STD_LOGIC_VECTOR(5-1 DOWNTO 0);

# result_out : OUT STD_LOGIC_VECTOR(6-1 DOWNTO 0)

# Note: avoid magic numbers in real code

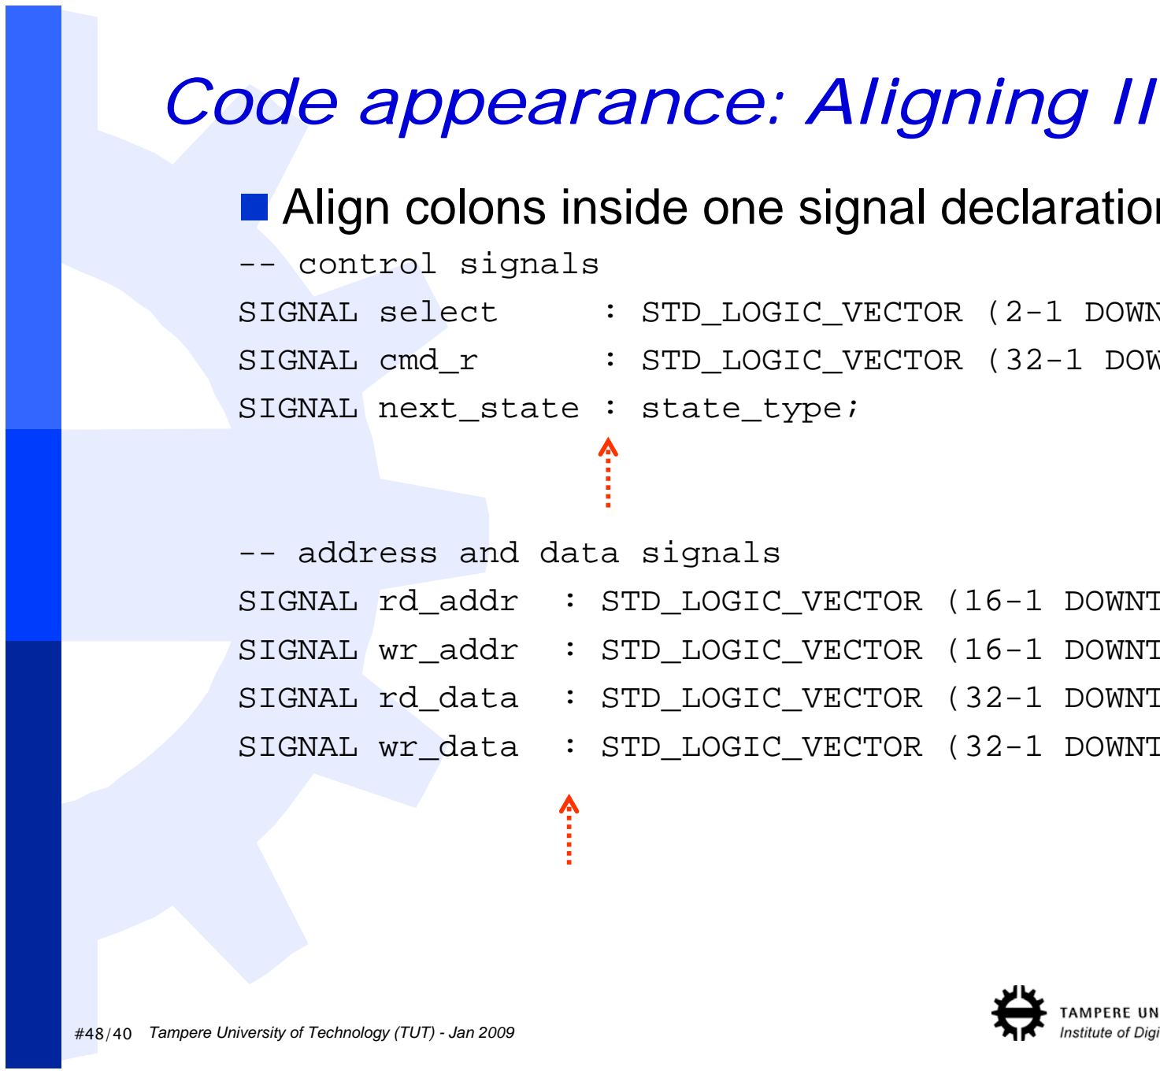
[picture p112: figure]
Code appearance: Aligning II; -- control signals; SIGNAL next_state : state_type;; -- address and data signals

#48/40 Tampere University of Technology (TUT) - Jan 2009

# Align colons inside one signal declaration group:

SIGNAL select | : STD_LOGIC_VECTOR (2-1 DOWNTO 0);
SIGNAL cmd_r | : STD_LOGIC_VECTOR (32-1 DOWNTO 0);

SIGNAL rd_addr : STD_LOGIC_VECTOR (16-1 DOWNTO 0); SIGNAL wr_addr : STD_LOGIC_VECTOR (16-1 DOWNTO 0); SIGNAL rd_data : STD_LOGIC_VECTOR (32-1 DOWNTO 0); SIGNAL wr_data : STD_LOGIC_VECTOR (32-1 DOWNTO 0);

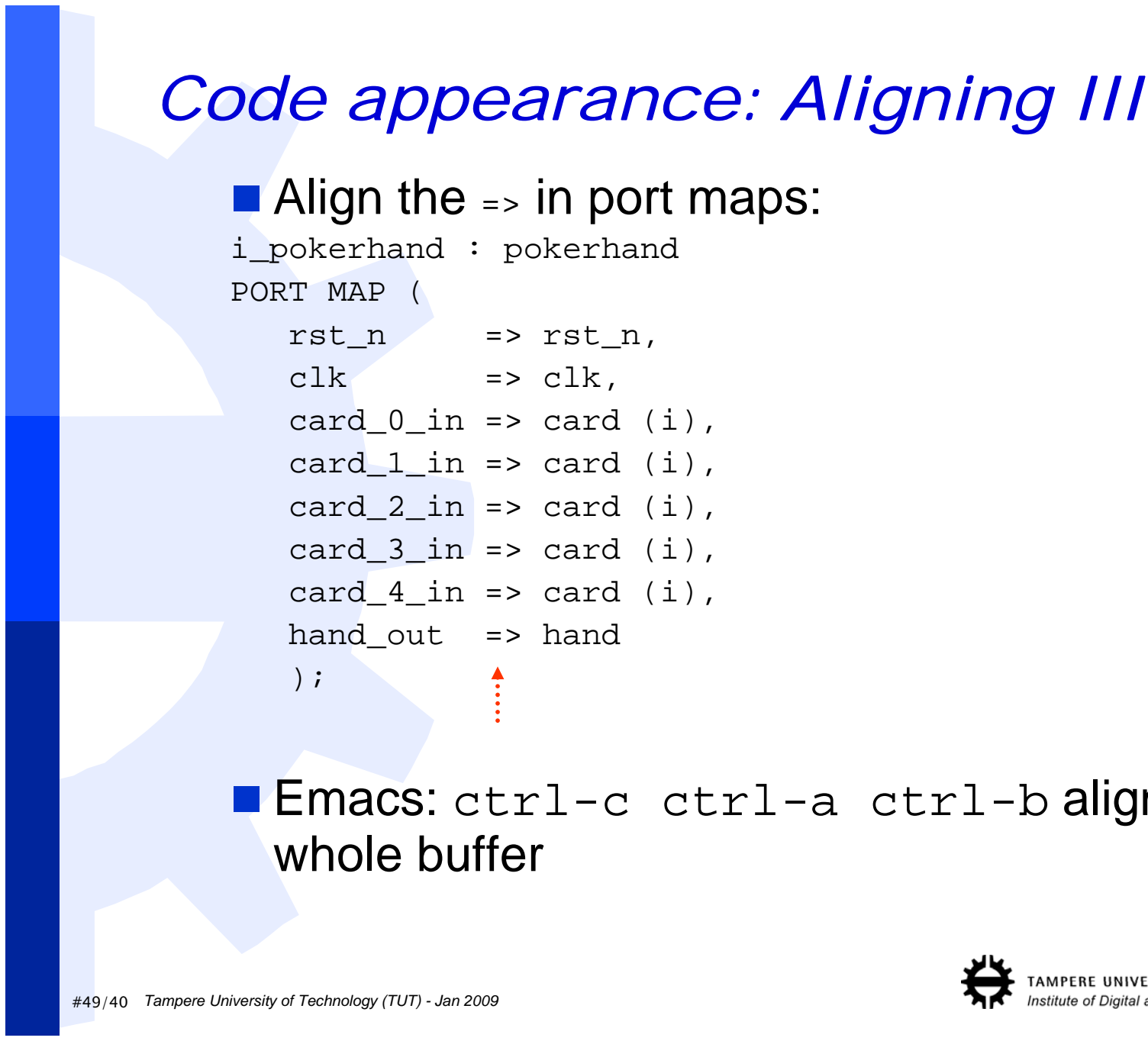
[picture p113: figure]
Code appearance: Aligning III;  Align the => in port maps:; i_pokerhand : pokerhand PORT MAP (; rst_n; => rst_n,; clk; => clk,; card_0_in => card (i), card_1_in => card (i), card_2_in => card (i), card_3_in => card (i), card_4_in => card (i), hand_out => hand );; whole buffer

#49/40 Tampere University of Technology (TUT) - Jan 2009

# Emacs: ctrl-c ctrl-a ctrl-b aligns the

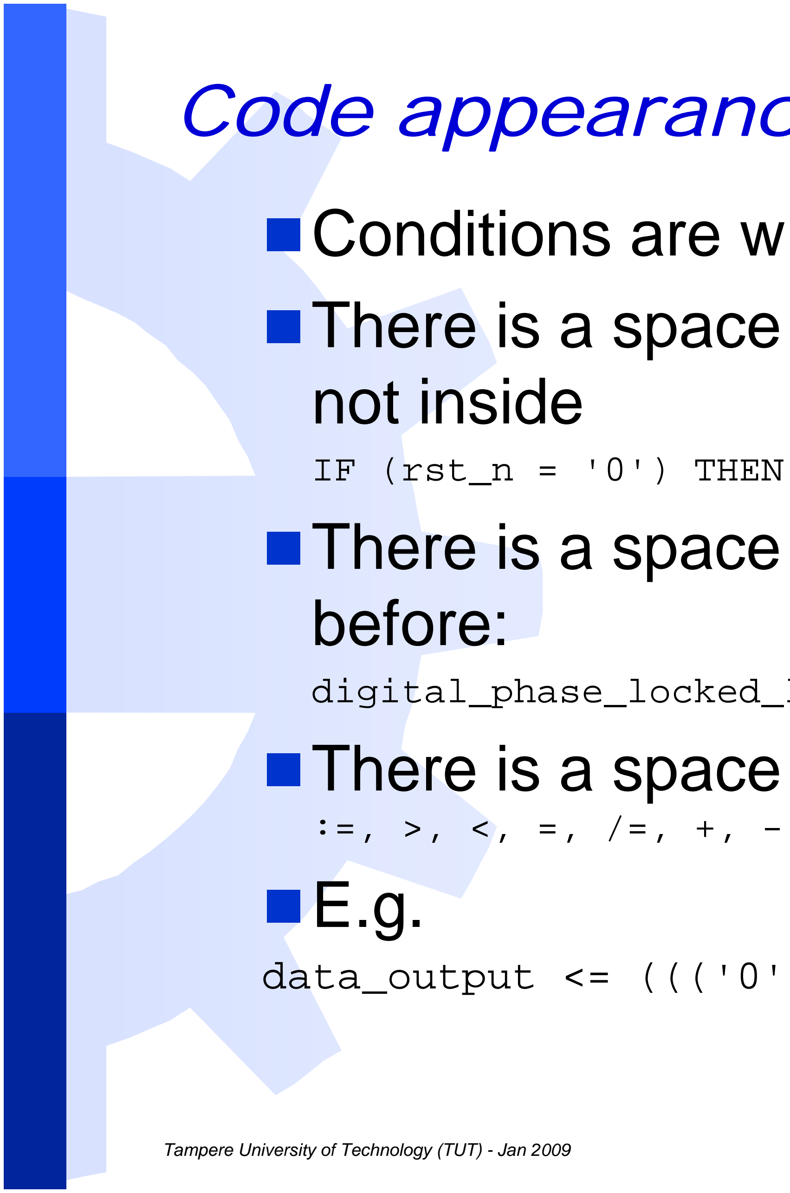
[picture p114: figure]
not inside; IF (rst_n = '0') THEN; before:

Tampere University of Technology (TUT) - Jan 2009

# Code appearance: Spacing

# Conditions are written inside parenthesis There is a space outside parenthesis, but

# There is a space after a comma, but not

# digital_phase_locked_loop : PROCESS (rst_n, clk)

There is a space on both sides of =>, <=,

# :=, >, <, =, /=, +, -, *, /, &, AND, OR, XOR

data_output <= ((('0' & a) + ('0' & b)) AND c);

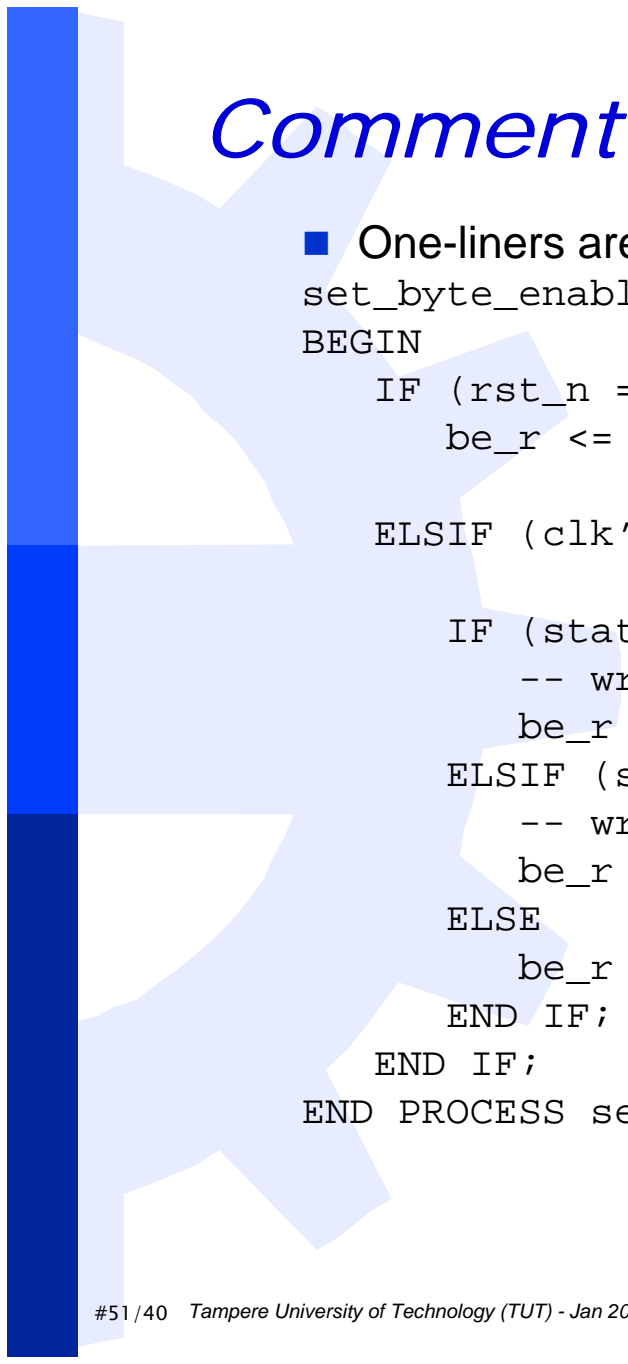
[picture p115: figure]
BEGIN; ELSE; END IF; END IF;

#51/40 Tampere University of Technology (TUT) - Jan 2009

# Commenting example

# One-liners are used in most cases:

# set_byte_enables : PROCESS (rst_n, clk)

# IF (rst_n = '0') THEN

be_r <= (OTHERS => '0');

# ELSIF (clk’EVENT and clk = '1') THEN

# IF (state_r = lo_part_c) THEN -- write lower 16-bit word

be_r <= "0011";

# ELSIF (state_r = hi_part_c) THEN -- write higher 16-bit word

be_r <= "1100";

# be_r <= "0000"; -- idle, altenative comment place

END PROCESS set_byte_enables;

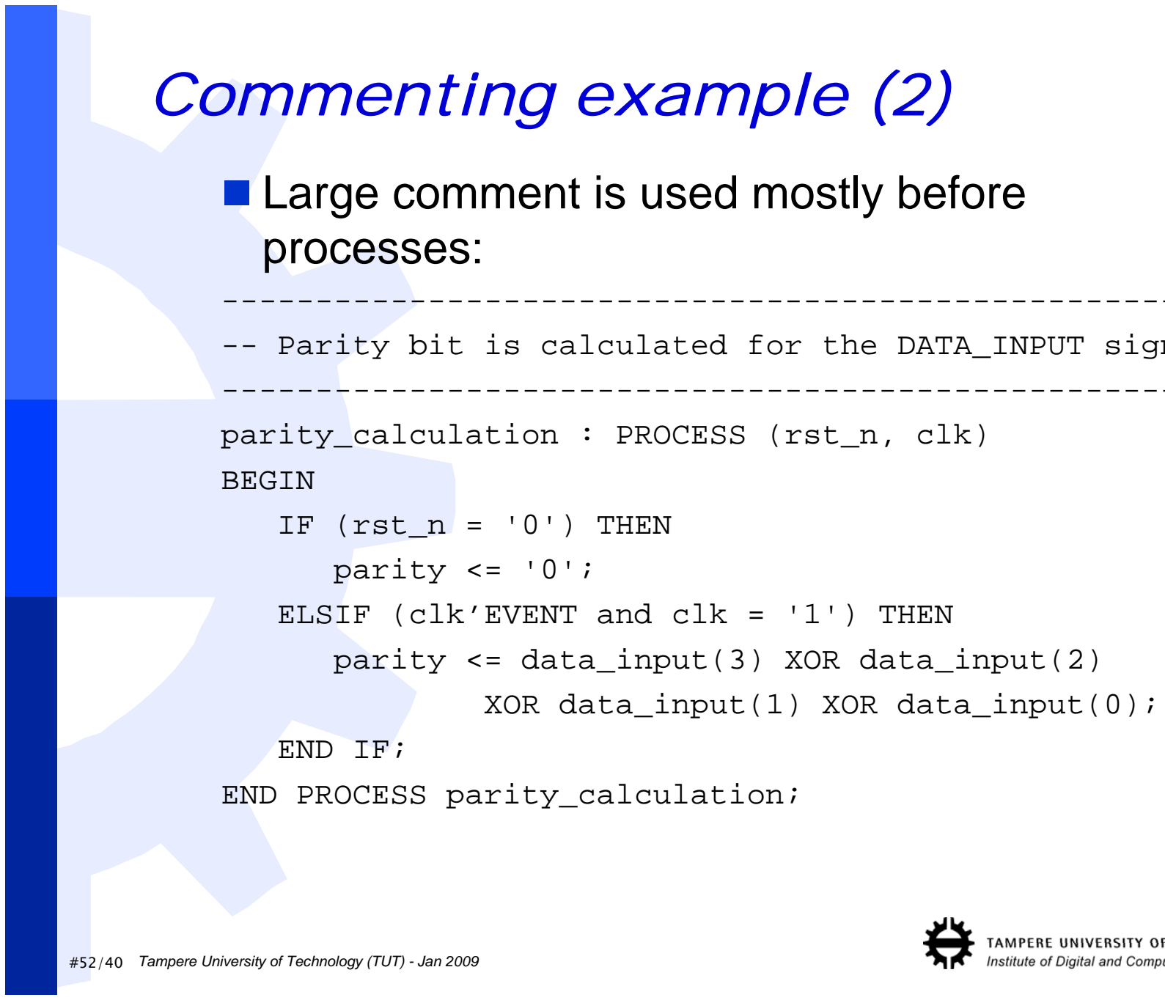
[picture p116: figure]
Commenting example (2);  Large comment is used mostly before processes:; BEGIN IF (rst_n = '0') THEN parity <= '0'; ELSIF (clk’EVENT and clk = '1') THEN; XOR data_input(1) XOR data_input(0);; END IF; END PROCESS parity_calculation;

#52/40 Tampere University of Technology (TUT) - Jan 2009

--------------------------------------------------------- Parity bit is calculated for the DATA_INPUT signal. -------------------------------------------------------

# parity_calculation : PROCESS (rst_n, clk)

# parity <= data_input(3) XOR data_input(2)

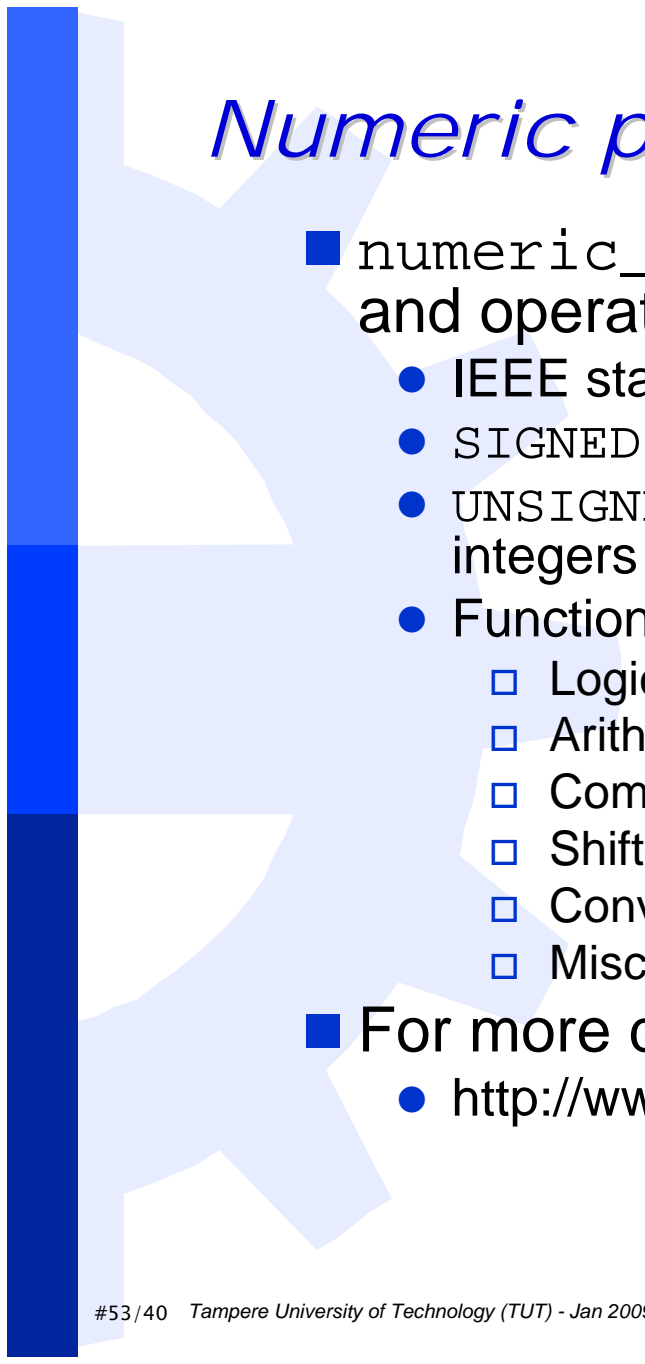
[picture p117: figure]
integers

#53/40 Tampere University of Technology (TUT) - Jan 2009

# Numeric packages (1) Numeric packages (1)

# numeric_std defines two new vector types and operations for them

# z IEEE standard package z SIGNED vectors represent two's-complement integers z UNSIGNED vectors represent unsigned-magnitude

# z Functions and operators

Logical | : and, or, not,...
Arithmetic | : abs, +, -, *, ...
Comparison : <, >, /=, ...
Shift | : shift_left, rotate_left, sll,...

# Conversion : see next slide

Misc | : resize, std_match, ...

# For more detail, see also:

# z http://www.vhdl.org/comp.lang.vhdl/FAQ1.html#4.8.1

# Numeric packages (2) Numeric packages (2)

# Differences of packages

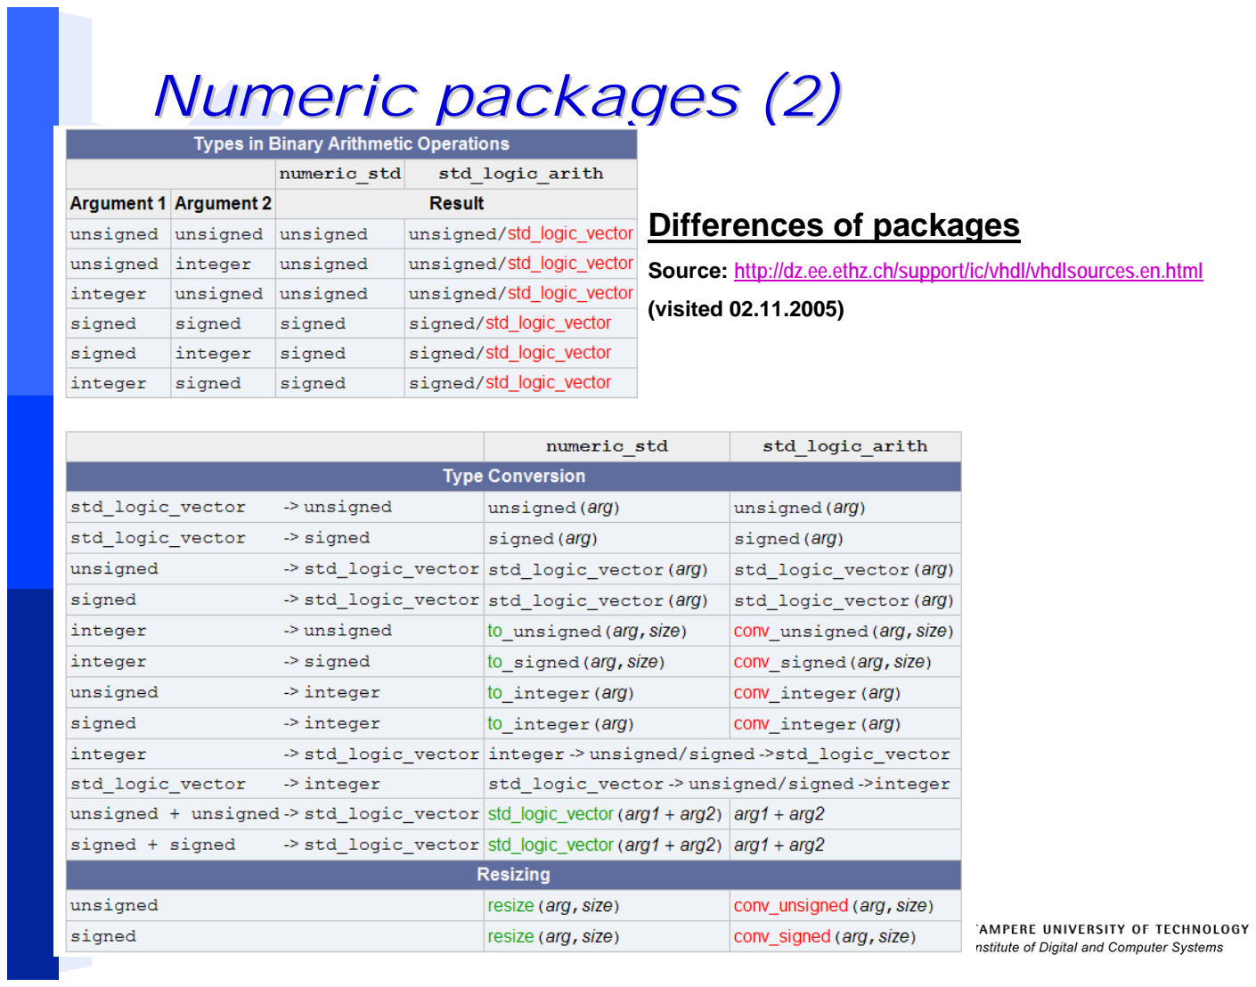
[picture p118: page 54]

#54/40 Tampere University of Technology (TUT) - Jan 2009 19.01.2005

## Source: http://dz.ee.ethz.ch/support/ic/vhdl/vhdlsources.en.html

## (visited 02.11.2005)
