rksnider/SensorCollar/PCB_Designs/Microphone Board/0Schematic/Microphone Board/Board1.htm

# Part Lister output for Board1 Generated on Monday, June 22, 2015

# | QTY | DEVICE | REFDES | PKG_TYPE | VALUE | P/D_NUM | PART_NUMBER | PART_LABEL | PKG_GRP

1 | 1 | 1P8_LDOREG_TLV702 | U2 | 1P8_LDOREG_TLV702 | | 296-27889-1-ND | TLV70218DBVT | IC REG LDO 1.8V 0.3A SOT23-5 | SC-74A
2 | 1 | 3P3_LDOREG_TLV702 | U1 | 3P3_LDOREG_TLV702 | | 296-39284-1-ND | TLV70233PDBVR | SOT23-5 | SC-74A
3 | 2 | cap_0p1uF_0402 | C9, C10 | 0402_MY | 0.1uF | 1276-1043-1-ND | CL05A104KA5NNNC
4 | 1 | cap_1uF_0402 | C3 | 0402_MY | 1uF | 490-3890-1-ND | GRM155R61A105KE15D
5 | 3 | cap_1uF_0603 | C1, C2, C4 | 0402_MY | 1uF | 490-1543-1-ND | GRM188R61A105KA61D
6 | 1 | EXT_SERIAL | J4 | EXT_SERIAL
7 | 1 | JTAG_HEADER | J3 | JTAG_HEADER
8 | 1 | JUMPER_8PIN_100MIL | U8 | JUMPER_8PIN_100MIL
9 | 4 | s_bit_uni_translator_FXLP34 | U3-U6 | s_bit_uni_translator_FXLP34 | | FXLP34P5XCT-ND | FXLP34P5X | TRANSLATOR 1BIT UNIDIRECT SC70-5 | SC-70-5
10 | 1 | SM_BUS | J1 | SM_BUS
11 | 1 | SPI_HEADER | J2 | SPI_HEADER
12 | 1 | SPST_SLIDE_SWITCH | J7 | SPST_SLIDE_SWITCH | | 360-3017-ND | AS11BP | SWITCH SLIDE SPST
13 | 2 | TVS_DIODE_ARRAY_SP3003_08ATG | U9, U10 | TVS_DIODE_ARRAY_SP3003_08ATG | | F1867CT-ND | SP3003-08ATG | TVS DIODE 6VWM 15VC MSOP10 | 10-MSOP
14 | 1 | two_bit_bi_translator_TXS0102 | U7 | two_bit_bi_translator_TXS0102 | | 296-32604-1-ND | TXS0102DCUT | IC VOLT-LEVEL TRANSLATOR US8 | 8-VFSOP
15 | 1 | USB3P0_LAND | J8 | USB3P0_LAND
16 | 1 | USB_FCI_CONNECTOR | J6 | USB_FCI_CONNECTOR | | 609-1039-ND | 61729-0010BLF | Connector Receptacle USB TypeB
17 | 1 | USB_FCI_PWR_RECEPTACLE | J5 | USB_FCI_PWR_RECEPTACLE | | 609-4618-1-ND | 10118194-0001LF | Connector Receptacle USB
