rksnider/SensorCollar/Tools/Plotting Scripts/WirelessDataCode/BozemanMap.png

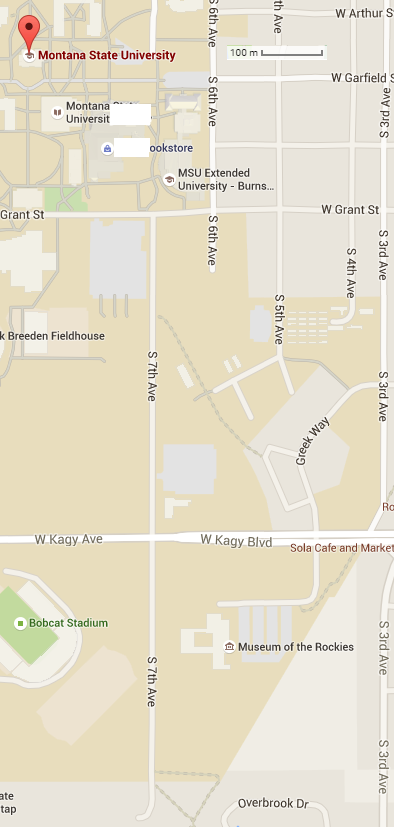
Tools/Plotting Scripts/WirelessDataCode/BozemanMap.png
