rksnider/SensorCollar/PCBDesignLearningMaterial/PCB Fab Houses.xlsx

Useable Fab House | Website | Capabilities Page | Min FR-4 Thickness | Min Hole Size | Min Trace Width | Contact | Quote price for 10 | Turnaround
Accutrace | http://pcb4u.com/ | http://pcb4u.com/p3a.asp | 6- layer: 0.016" | 4 mils | 2 mils | jodi@pcb4u.com | 2502 | 10 days
Advanced Circuits | http://www.4pcb.com/ | http://www.4pcb.com/pcb-capabilities.html | 6- layer: 0.031" | 3 mils | 5 mils |  | 3419 | 7 days
Gold Phonix | http://goldphoenixpcb.com/ | http://www.goldphoenixpcb.com/html/capabilities/rpc.html | 6- layer: 0.024" | 5 mils | 4 mils |  | 1214.95 | 15 days
Imagineering | http://www.pcbnet.com/ | http://www.pcbnet.com/capabilities/capabilities | 6- layer: 0.016" | 4 mils | 2 mils | Sales@PCBnet.com | 1084.00 | 8 days
PCBFABEXPRESS | https://ecommerce.pcbfabexpress.com/ | https://ecommerce.pcbfabexpress.com/capability.jsp | 6- layers: 0.016" | 4 mils | 2 mils
PCB-Pool | http://www.pcb-pool.com/ppus/index.html | German Company http://www.pcb-specification.com/uk | 6- layer: 0.064" | 8 mils | 5 mils | TRN-5958
PCB Cart | http://www.pcbcart.com/ | Chinese Company http://www.pcbcart.com/cart.php?page=capability___standard_pcb | .016-.126" Could not find based on layers | 6 mils | 4 mils
Sunstone | http://www.sunstone.com/ |  | 6- layer: 0.062" | 10 mils | 5 mils
PCB Universe
 |  | http://www.pcbtrain.co.uk/resources/pcb-technical-capability/
Unusable Fab Houses |  | Why it won't work
AP Circuits | http://apcircuits.com/ | Couldn't find info, very expensive | - | - | -
Dirt Cheap Dirty Boards | http://dirtypcbs.com/ | Only 5x5 and 10x10 boards | - | - | -
Elecrow | http://www.elecrow.com/ | 4 layer boards max | - | - | -
expresspcb | http://www.expresspcb.com/ | 4 layer boards max | - | - | -
Itead Studio | http://imall.iteadstudio.com/ | 4 layer boards max | - | - | -
OSH Park | http://oshpark.com/ | 4 layer boards max | - | - | -
Seeed | http://www.seeedstudio.com/depot/ | http://www.seeedstudio.com/service/index.php?r=st/specification#pcb | 4- layer: 0.0236" | 11.81 mils | 8 mils
Smart Prototyping | http://smart-prototyping.com/ | Won't meet minimum trace and via requirements | - | - | -
