rksnider/SensorCollar/PCBDesignLearningMaterial/Decoupling Capacitors/Decoupling_Cap_Calculation.xlsx

Via Length (h) | 0.05 | Via Inductance | Max Inductance | Equivalent Inductance | Num Caps
Via diameter (d) | 0.01 | 1.014915997e-09 | 7.894736842e-11 | 1.070915997e-09 | 13.56493597
MAX allowed voltage dip (V) | 0.1
Switching time (dt) | 1.2e-09 | Transient Current | Total Current |  | Cap Value
# Nets switching (N) | 16 | 0.018 | 0.288 |  | 3.456e-09
Max Current per net (di) | 0.095
Package Inductance (Lpak) | 5.6e-11 | Xmax | Fbypass | Total Inductance | Num Caps (Alt Calculation)
Clock Frequency | 50000000 | 0.3472222222 | 11052426.6 | 1.326291192e-10 | 8.074516393
Capacitive Load ( C ) | 1.2e-11
Voltage change (dV) | 1.80 |  |  |  | Array Value
Knee Frequency | 416666666.7 |  |  |  | 4.1472e-08
Board-level bypass | 5e-09
 |  |  |  |  | C Element
 |  |  |  |  | 5.136158995e-09
