rksnider/SensorCollar/PCB_Designs/MCollar_v1/0Schematic/SENSOR_BoM.xls.xlsx

# | QTY PER BOARD | ORDER QTY | DEVICE | REFDES | P/D_NUM | PART_NUMBER | VALUE | TOLERANCE | PART_LABEL | PKG_GRP
1 | 1 | 11 | Solar_Ctl_LTC3105DD | U1 | LTC3105EDD#PBF-ND | LTC3105EDD |  |  | IC CONV DC/DC 400MA HIEFF 10-DFN | 10-WFDFN
2 | 1 | 11 | Data_Transfer_CC1120 | U2 | 296-35667-1-ND | CC1120RHBR |  |  | IC RF TXRX FOR NARROWBAND 32QFN | 32-VFQFN
3 | 1 | 11 | Battery_Monitor_BQ27520-G4 | U12 | 296-38882-1-ND | BQ27520-G4 |  |  | IC BATT FUEL GAUGE LIION 15DSBGA | 15-UFBGA
4 | 1 | 11 | ADMP621_MEMS_MIC | U15 | 1428-1018-1-ND | ADMP621 |  |  | MIC MEMS DIGITAL OMNI -46DB | Leadless
5 | 1 | 11 | MRAM_MR20H40CDF_8DFN_SMALLFLAG_PART | U18 | 819-1043-ND | MR20H40 |  |  | IC MRAM 4MBIT 50MHZ 8DFN | 8-VDFN
6 | 1 | 11 | RTC_DS1371 | U26 | DS1371U+-ND | DS1371 |  |  | IC RTC BINARY CNT I2C 8-USOP | 8-TSSOP
7 | 1 | 11 | IM_LSM9DS1 | U27 | 497-14946-1-ND | LSM9DS1 |  |  | ACCELEROMETER 3D INEMO 24TFLGA | 24TFLGA
8 | 1 | 11 | DUAL_ANODE_SCHOTTKY_DIODE | D1 | SS10P4C-M3/86AGICT-ND | SS10P4C-M3/86A |  |  | DIODE ARRAY SCHOTTKY 40V TO277A | TO-277
9 | 1 | 11 | Oscillation_Crystal | X2 | 535-11937-1-ND | ABS07-120-32.768kHz-T |  |  | Crystal 32.7680kHz 20ppm | SMT
10 | 2 | 22 | SWITCH_SINGLE_TPS22912C | S1,S2 | 296-36786-1-ND | TPS22912C |  |  | IC LOAD SWITCH 2A 4DSBGA | 4-XFBGA
11 | 4 | 44 | SWITCH_DUAL_SiP32414 | S3,S5,S7,S8 | SIP32414DNP-T1-GE4CT-ND | Sip32414 |  |  | IC SW W/CTRL SLEW RATE 8TDFN | 8-UFDFN
12 | 1 | 11 | SWITCH_MAGNASPHERE-S | S4 | 735-1004-ND | MG-B2-20-S |  |  | SWITCH MAGNETIC NC 20 30V | Thru Hole
13 | 1 | 11 | ANTENNA | AE1 | 712-1003-1-ND | 1575AT43A0040 |  |  | ANTENNA CHIP GPS 1575 MHZ | SMT
14 | 1 | 15 | cap_2p2pF_0402 | C176 | 490-5932-1-ND | GRM1555C1H2R2CA01D | 2.2pF | 0.25pF | CAP CER 2.2PF 50V NP0 0402 | 0402
15 | 3 | 35 | cap_5p1pF_0402 | C181,C191,C201 | 490-8216-1-ND | GRM1555C1H5R1CA01D | 5.1pF | 0.25pF | CAP CER 5.1PF 50V NP0 0402 | 0402
16 | 1 | 15 | cap_6p2pF_0402 | C175 | 1276-1719-1-ND | CL05C6R2CB5NNNC | 6.2pF | 0.25pF | CAP CER 6.2PF 50V NP0 0402 | 0402
17 | 2 | 25 | cap_15pF_0402 | C301,C311 | 1276-1179-1-ND | CL05C150JB5NNNC | 15pF | 5% | CAP CER 15PF 50V 5% NP0 0402 | 0402
18 | 1 | 15 | cap_39pF_0402 | C174 | 1276-1016-1-ND | CL05C390JB5NNNC | 39pF | 5% | CAP CER 39PF 50V 5% NP0 0402 | 0402
19 | 1 | 15 | cap_56pF_0402 | C173 | 1276-1707-1-ND | CL05C560JB5NNNC | 56pF | 5% | CAP CER 56PF 50V 5% NP0 0402 | 0402
20 | 1 | 15 | cap_100pF_0402 | C172 | 490-5922-1-ND | GRM1555C1H101JA01D | 100pF | 5% | CAP CER 100PF 50V 5% NP0 0402 | 0402
21 | 1 | 15 | cap_1800pF_0402 | C231 | 490-6274-1-ND | GRM1557U1A182JA01D | 1800pF | 5% | CAP CER 1800PF 10V 5% U2J 0402 | 0402
22 | 5 | 55 | cap_0p01uF_0402 | C4,C115,C118,C171,C211 | 1276-1057-1-ND | CL05B103KA5NNNC | 0.01uF | 10% | CAP CER 10000PF 25V 10% X7R 0402 | 0402
23 | 1 | 15 | cap_0p033uF_0402 | C60 | 490-5411-2-ND | GRM155R61A333KA01D | 0.033uF | 10% | CAP CER 0.033UF 10V 10% X5R 0402 | 0402
24 | 11 | 116 | cap_0p047uF_0402 | C11,C51,C121,C131,C151,C221,C251,C261,C271,C281,C291 | 490-3254-1-ND | GRM155R71E473KA88D | 0.047uF | 10% | CAP CER 0.047UF 25V 10% X7R 0402 | 0402
25 | 20 | 210 | cap_0p1uF_0402 | C1,C6,C7,C9,C10,C12,C13,C17,C18,C22,C23,C31,C55,C56,C58,C59,C61,C62,C114,C116 | 1276-1043-1-ND | CL05A104KA5NNNC | 0.1uF |  | CAP CER 0.1UF 25V 10% X5R 0402 | 0402
26 | 1 | 15 | cap_0p22uF_0402 | C3 | 490-3910-1-ND | GRM155R61A224KE19D | 0.22uF | 10% | CAP CER 0.22UF 10V 10% X5R 0402 | 0402
27 | 3 | 35 | cap_1uF_0402 | C14,C54,C57 | 490-3890-1-ND | GRM155R61A105KE15D | 1uF | 10% | CAP CER 1UF 10V 10% X5R 0402 | 0402
28 | 11 | 116 | cap_4p7uF_0402 | C36,C96-C100,C105,C106,C110-C112 | 1276-1482-1-ND | CL05A475MP5NRNC | 4.7uF | 20% | CAP CER 4.7UF 10V 20% X5R 0402 | 0402
29 | 4 | 45 | cap_10uF_0402 | C2,C5,C53,C117 | 1276-1450-1-ND | CL05A106MP5NUNC | 10uF | 20% | CAP CER 10UF 10V 20% X5R 0402 | 0402
30 | 1 | 15 | Inductor_10uH | L1 | 445-16677-1-ND | VLF302512MT-100M-CA | 10uH |  | FIXED IND 10UH 950MA 299 MOHM | Nonstandard
31 | 2 | 25 | Inductor_15nH_0402 | L172,L193 | 490-1148-1-ND | LQW15AN15NJ00D | 15nH |  | FIXED IND 15NH 460MA 160 MOHM | 0402
32 | 1 | 15 | Inductor_22nH_0402 | L174 | 490-1150-1-ND | LQW15AN22NJ00D | 22nH | 5% | FIXED IND 22NH 310MA 300 MOHM | 0402
33 | 2 | 25 | Inductor_27nH_0402 | L192,L201 | 490-1151-1-ND | LQW15AN27NJ00D | 27nH | 5% | FIXED IND 27NH 280MA 520 MOHM | 0402
34 | 1 | 15 | Inductor_43nH_0402 | L173 | 490-6818-1-ND | LQW15AN43NJ00D | 43nH | 5% | FIXED IND 43NH 250MA 700 MOHM | 0402
35 | 2 | 25 | Inductor_56nH_0402 | L171,L191 | 490-1155-1-ND | LQW15AN56NJ00D | 56nH | 5% | FIXED IND 56NH 200MA 1.17 OHM | 0402
36 | 1 | 15 | Res_0p01CurrentSense1_0603 | R28 | P10AXCT-ND | ERJ-M03NF10MV | 0.01 | 1% | RES SMD 0.01 OHM 1% 1/4W 0603 | 0603
37 | 1 | 15 | Res_18_0402 | R171 | P18JCT-ND | ERJ-2GEJ180X | 18 | 5% | RES SMD 18 OHM 5% 1/10W 0402 | 0402
38 | 2 | 25 | Res_100_0402 | R25,R26 | P100JCT-ND | ERJ-2GEJ101X | 100 | 5% | RES SMD 100 OHM 5% 1/10W 0402 | 0402
39 | 1 | 15 | Res_1k1_0402 | R32 | P1.00KLCT-ND | ERJ-2RKF1001X | 1k | 1% | RES SMD 1K OHM 1% 1/10W 0402 | 0402
40 | 1 | 15 | Res_18p2k1_0402 | R33 | P18.2KLCT-ND | ERJ-2RKF1822X | 18.2k | 1% | RES SMD 18.2K OHM 1% 1/10W 0402 | 0402
41 | 5 | 55 | Res_24k5_0402 | R12,R13,R21,R31,R35 | P24KJCT-ND | ERJ-2GEJ243X | 24k | 5% | RES SMD 24K OHM 5% 1/10W 0402 | 0402
42 | 1 | 15 | Res_56k1_0402 | R141 | P56.0KLCT-ND | ERJ-2RKF5602X | 56k | 1% | RES SMD 56K OHM 1% 1/10W 0402 | 0402
43 | 1 | 15 | Res_169k1_0402 | R22 | P169KLCT-ND | ERJ-2RKF1693X | 169k | 1% | RES SMD 169K OHM 1% 1/10W 0402 | 0402
44 | 1 | 15 | Res_332k1_0402 | R23 | P332KLCT-ND | ERJ-2RKF3323X | 332k | 1% | RES SMD 332K OHM 1% 1/10W 0402 | 0402
45 | 1 | 15 | Res_1p02M1_0402 | R24 | 541-1.02MLCT-ND | CRCW04021M02FKED | 1.02M | 1% | RES SMD 1.02M OHM 1% 1/16W 0402 | 0402
46 | 1 | 15 | Res_1p8M1_0402 | R34 | 1276-4292-1-ND | RC1005F185CS | 1.8M | 1% | RES SMD 1.8M OHM 1% 1/16W 0402 | 0402
47 | 1 | 11 | CRYSTAL_32MHz | X1 | 732-FA128-32F20X-K3 | FA-128 32.0000MF20X-K3 |  |  | Crystals 32MHz 10ppm 10pF | Leadless
48 | 2 | 22 | B2B_50pos_Receptacle | J1,J2 |  | 529910508 |  |  | Conn Board to Board RCP 50 POS
49 | 1 | 11 | 4UCON_SD_SPARK_PART | U7
50 | 1 | 11 | MAX-7Q | U11 |  | MAX-7Q |  |  |  | SMT
Number of Boards: | 10
