rksnider/SensorCollar/PCB_Designs/MCollar_v1/MCollar_v1_MAIN_SC_Files/SC_BoM_MAIN.xls

# | QTY | REFDES | Manufacturer | Mfg Part # | Dist. Part # | Description | Package | Type | VALUE | TOLERANCE
1 | 1 | PS1 | TEXAS INSTRUMENTS | TPS62085RLTT | 296-37085-1-ND | IC REG BUCK SYNC ADJ 3A 7VQFN | 7-VFDFN | Leadless
2 | 1 | CLK1 | EPSON | SG-210STF 50.0000MS3 | SER3808CT-ND | OSC XO 50.000MHZ CMOS SMD | DFN | Leadless
3 | 1 | U2 | LINEAR TECHNOLOGY | LTC3521EUF#PBF | LTC3521EUF#PBF-ND | IC REG BUCK BOOST SYNC ADJ 24QFN | 24-QFN-EP | Leadless
4 | 1 | U5 | MAXIM INTEGRATED | MAX13208EALB+T | MAX13208EALB+TCT-ND | TVS DIODE 10UDFN | 10-WFDFN | Leadless
5 | 1 | FB1 | MURATA ELECTRONICS | BLM18PG600SN1D | 490-1036-1-ND | FERRITE CHIP 60 OHM 500MA 0603 | 0603 | SMT
6 | 1 | U17 | MICRON TECHNOLOGY INC | N25Q128A11EF840E | 557-1559-ND | IC FLASH 128MBIT 108MHZ 8VDFN | 8-VDFN | Leadless
7 | 1 | U1 | ALTERA | 5M570ZM100I5N | 544-2980-ND | IC CPLD 440MC 9NS 100MBGA | 100-MBGA | BGA
8 | 1 | U3 | ALTERA | 5CEBA4U15C7N | 989-5CEBA4U15C7N | FPGA - Cyclone V E 1848 LABs 176 IOs | BGA-324 | BGA
9 | 1 | U7 | FAIRCHILD SEMICONDUCTOR | NC7SZ157L6X | NC7SZ157L6XFSCT-ND | IC MUX UHS 2-INP NONINV 6-MCRPAK | 6-UFDFN | Leadless
10 | 2 | U4,U6 | TEXAS INSTRUMENTS | SN74LVC244ARGY | 296-13967-1-ND | IC BUFF/DVR TRI-ST OCTAL 20-VQFN | 20-VFQFN | Leadless
11 | 1 | U9 | MICRON TECHNOLOGY INC | MT48H32M16LFB4-75 IT:C | 557-1596-ND | IC SDRAM 512MBIT 133MHZ 54VFBGA | 54-VFBGA | BGA
12 | 1 | S9 | VISHAY SILICONIX | Sip32414 | SIP32414DNP-T1-GE4CT-ND | IC SW W/CTRL SLEW RATE 8TDFN | 8-UFDFN | Leadless
13 | 2 | S11,S12 | VISHAY SILICONIX | Sip32416 | SIP32416DNP-T1-GE4CT-ND | IC SW W/CTRL SLEW RATE 8TDFN | 8-UFDFN | Leadless
14 | 1 | J3 | AMPHENOL COMMERCIAL PRODUCTS | GSB343133HR | GSB343133HRCT-ND | CONN RCPT USB 3.0 MICRO-B SMD |  | SMT
15 | 2 | J1,J2 | MOLEX | 501920-5001 | 538-501920-5001 | 0.5 B/B Plug Hsg Ass y 50Ckt EmbsTp |  | SMT
16 | 1 | C45 | MURATA ELECTRONICS | GRM1555C1H220GA01D | 490-6219-1-ND | CAP CER 22PF 50V 2% NP0 0402 | 0402 | SMT | 22pF
17 | 1 | C48 | SAMSUNG ELECTRO-MECHANICS AMERICA, INC | CL05C330JB5NNNC | 1276-1272-1-ND | CAP CER 33PF 50V 5% NP0 0402 | 0402 | SMT | 33pF
18 | 9 | C64,C77,C79,C84,C85,C88,C89,C92,C93 | SAMSUNG ELECTRO-MECHANICS AMERICA, INC | CL05B103KA5NNNC | 1276-1057-1-ND | CAP CER 10000PF 25V 10% X7R 0402 | 0402 | SMT | 0.01uF
19 | 1 | C69 | MURATA ELECTRONICS | GRM155R61A223KA01D | 490-6302-1-ND | CAP CER 0.022UF 10V 10% X5R 0402 | 0402 | SMT | 0.022uF
20 | 4 | C70-C73 | MURATA ELECTRONICS | GRM155R71E473KA88D | 490-3254-1-ND | CAP CER 0.047UF 25V 10% X7R 0402 | 0402 | SMT | 0.047uF | 10%
21 | 6 | C36-C41 | SAMSUNG ELECTRO-MECHANICS AMERICA, INC | CL03A104MP3NNNC | 1276-1321-1-ND | CAP CER 0.1UF 10V 20% X5R 0201 | 0201 | SMT | 0.1uF | 20%
22 | 25 | C2,C13-C16,C21,C43,C46,C49,C65-C68,C74,C78,C80-C83,C86,C87,C90,C91,C94,C95 | SAMSUNG ELECTRO-MECHANICS AMERICA, INC | CL05A104KA5NNNC | 1276-1043-1-ND | CAP CER 0.1UF 25V 10% X5R 0402 | 0402 | SMT | 0.1uF
23 | 1 | C75 | MURATA ELECTRONICS | GRM155R61A224KE19D | 490-3910-1-ND | CAP CER 0.22UF 10V 10% X5R 0402 | 0402 | SMT | 0.22uF | 10%
24 | 1 | C76 | SAMSUNG ELECTRO-MECHANICS AMERICA, INC | CL05A474KP5NNNC | 1276-1173-1-ND | CAP CER 0.47UF 10V 10% X5R 0402 | 0402 | SMT | 0.47uF
25 | 6 | C25,C27,C30,C33-C35 | MURATA ELECTRONICS | GRM188R61A105KA61D | 490-1543-1-ND | CAP CER 1UF 10V 10% X5R 0603 | 0603 | SMT | 1uF
26 | 8 | C4,C51,C52,C101-C104,C109 | SAMSUNG ELECTRO-MECHANICS AMERICA, INC | CL05A475MP5NRNC | 1276-1482-1-ND | CAP CER 4.7UF 10V 20% X5R 0402 | 0402 | SMT | 4.7uF
27 | 1 | C26 | SAMSUNG ELECTRO-MECHANICS AMERICA, INC | CL10A475KA8NQNC | 1276-1900-1-ND | CAP CER 4.7UF 25V 10% X5R 0603 | 0603 | SMT | 4.7uF
28 | 3 | C44,C47,C50 | SAMSUNG ELECTRO-MECHANICS AMERICA, INC | CL05A106MP5NUNC | 1276-1450-1-ND | CAP CER 10UF 10V 20% X5R 0402 | 0402 | SMT | 10uF
29 | 3 | C1,C28,C31 | SAMSUNG ELECTRO-MECHANICS AMERICA, INC | CL10A106MQ8NNNC | 1276-1119-1-ND | CAP CER 10UF 6.3V 20% X5R 0603 | 0603 | SMT | 10uF
30 | 2 | C3,C42 | SAMSUNG ELECTRO-MECHANICS AMERICA, INC | CL10A226MP8NUNE | 1276-1274-1-ND | CAP CER 22UF 10V 20% X5R 0603 | 0603 | SMT | 22uF
31 | 2 | C29,C32 | TDK CORPORATION | C2012X5R1A476M125AC | 445-8239-1-ND | CAP CER 47UF 10V 20% X5R 0805 | 0805 | SMT | 47uF
32 | 1 | R15 | PANASONIC ELECTRONIC COMPONENTS | ERJ-2RKF1001X | P1.00KLCT-ND | RES SMD 1K OHM 1% 1/10W 0402 | 0402 | SMT | 1k | 1%
33 | 1 | R2 | PANASONIC ELECTRONIC COMPONENTS | ERJ-3EKF2001V | P2.00KHCT-ND | RES SMD 2K OHM 1% 1/10W 0603 | 0603 | SMT | 2k | 1%
34 | 6 | R9,R10,R14,R20,R22,R23 | PANASONIC ELECTRONIC COMPONENTS | ERJ-2RKF1002X | P10.0KLCT-ND | RES SMD 10K OHM 1% 1/10W 0402 | 0402 | SMT | 10k | 1%
35 | 3 | R16,R17,R21 | PANASONIC ELECTRONIC COMPONENTS | ERJ-2GEJ243X | P24KJCT-ND | RES SMD 24K OHM 5% 1/10W 0402 | 0402 | SMT | 24k | 5%
36 | 1 | R18 | PANASONIC ELECTRONIC COMPONENTS | ERA-3AEB6492V | P64.9KDBCT-ND | RES SMD 64.9K OHM 0.1% 1/10W | 0603 | SMT | 64.9k | 0.10%
37 | 1 | R6 | PANASONIC ELECTRONIC COMPONENTS | ERJ-2RKF6812X | P68.1KLCT-ND | RES SMD 68.1K OHM 1% 1/10W 0402 | 0402 | SMT | 68.1k | 1%
38 | 1 | R8 | PANASONIC ELECTRONIC COMPONENTS | ERJ-2RKF6982X | P69.8KLCT-ND | RES SMD 69.8K OHM 1% 1/10W 0402 | 0402 | SMT | 69.8k | 1%
39 | 1 | R5 | PANASONIC ELECTRONIC COMPONENTS | ERJ-2RKF1373X | P137KLCT-ND | RES SMD 137K OHM 1% 1/10W 0402 | 0402 | SMT | 137k | 1%
40 | 1 | R19 | PANASONIC ELECTRONIC COMPONENTS | ERA-3AEB1743V | P174KDBCT-ND | RES SMD 174K OHM 0.1% 1/10W 0603 | 0603 | SMT | 174k | 0.10%
41 | 2 | R4,R7 | PANASONIC ELECTRONIC COMPONENTS | ERJ-2RKF2213X | P221KLCT-ND | RES SMD 221K OHM 1% 1/10W 0402 | 0402 | SMT | 221k | 1%
42 | 2 | R3,R11 | PANASONIC ELECTRONIC COMPONENTS | ERJ-2RKF1004X | P1.00MLCT-ND | RES SMD 1M OHM 1% 1/10W 0402 | 0402 | SMT | 1M | 1%
43 | 1 | R12 | PANASONIC ELECTRONIC COMPONENTS | EXB-D10C103J | U9103CT-ND | RES ARRAY 10K OHM 8 RES 1206 | 1206 | SMT | 10k | 5%
44 | 1 | R1 | PANASONIC ELECTRONIC COMPONENTS | EXB-D10C223J | U9223CT-ND | RES ARRAY 22K OHM 8 RES 1206 | 1206 | SMT | 22k | 5%
45 | 1 | L4 | SUMIDA AMERICA COMPONENTS INC | 252012CDMCDS-4R7MC | 308-2341-1-ND | FIXED IND 470NH 3.8A 20 MOHM SMD | 1008 | SMT | 0.47uH
46 | 1 | L2 | SUMIDA AMERICA COMPONENTS INC | 252012CDMCD-3R3MC | 308-2345-1-ND | FIXED IND 3.3UH 1.5A 105 MOHM | 1008 | SMT | 3.3uH
47 | 2 | L1,L3 | SUMIDA AMERICA COMPONENTS INC | 252012CDMCD-4R7MC | 308-2346-1-ND | FIXED IND 4.7UH 1.4A 150 MOHM | 1008 | SMT | 4.7uH
 |  |  |  |  |  | BOARD SUMMARY FOR QUOTE
 |  |  |  |  |  | Total # of unique parts | 47
 |  |  |  |  |  | SMT placement per board | 104
 |  |  |  |  |  | Thru-hole placements per board | 0
 |  |  |  |  |  | Fine pitch placements per board | 0
 |  |  |  |  |  | BGA/leadless placements per board | 14
 |  |  |  |  |  | Total parts | 118
