rksnider/SensorCollar/PCB_Designs/DevBoard_PowerMonitor/SC_Files/BoM_SC.xlsx

# | QTY | REFDES | Manufacturer | Mfg Part # | Dist. Part # | Description | Package | Type | VALUE | TOLERANCE | Notes
1 | 1 | PS1 | TEXAS INSTRUMENTS | TPS62085RLTT | 296-37085-1-ND | IC REG BUCK SYNC ADJ 3A 7VQFN | 7-VFDFN | Leadless
2 | 2 | U15,U16 | INVENSENSE | INMP621ACEZ-R7 | 1428-1018-1-ND | MIC MEMS DIGITAL OMNI -46DB |  | Leadless
3 | 2 | S6,S13 | ANALOG DEVICES INC | ADP191ACBZ-R7 | ADP191ACBZ-R7CT-ND | IC CTLR HIGH LSIDE PWR SW 4WLCSP | 4-WFBGA | BGA
4 | 1 | CLK1 | EPSON | SG-210STF 50.0000MS3 | SER3808CT-ND | OSC XO 50.000MHZ CMOS SMD | DFN | Leadless
5 | 1 | U10 | LINEAR TECHNOLOGY | LTC3521EFE#PBF | LTC3521EFE#PBF-ND | IC REG BUCK BST SYNC ADJ 20TSSOP | 20-TSSOP-EP | SMT
6 | 2 | FB1,FB2 | MURATA ELECTRONICS | BLM18PG600SN1D | 490-1036-1-ND | FERRITE CHIP 60 OHM 500MA 0603 | 0603 | SMT
7 | 1 | U17 | MICRON TECHNOLOGY INC | N25Q128A11ESE40G | 557-1572-5-ND | IC FLASH 128MBIT 108MHZ 8SO | 8-SO W | SMT
8 | 1 | U14 | ALTERA | 5M570ZT100C5N | 544-2839-ND | IC CPLD 440MC 9NS 100TQFP | 100-TQFP | SMT
9 | 1 | U18 | EVERSPIN TECHNOLOGIES INC | MR20H40CDF | 819-1043-ND | IC MRAM 4MBIT 50MHZ 8DFN | 8-DFN-EP | Leadless
10 | 1 | U13 | TEXAS INSTRUMENTS | SN74LVC244APWR | 296-1230-1-ND | IC BUFF/DVR TRI-ST DUAL 20TSSOP | 20-TSSOP | SMT
11 | 1 | U25 | ABRACON CORPORATION | ABS07-120-32.768KHZ-T | 535-11937-1-ND | CRYSTAL 32.768KHZ 6PF SMD |  | SMT
12 | 1 | PB1 | C&K COMPONENTS | KS12R22CQD | CKN1595-ND | SWITCH PUSH SPDT 0.025A 50V |  | thru-hole
13 | 1 | U26 | MAXIM INTEGRATED | DS1371U+ | DS1371U+-ND | IC RTC BINARY CNT I2C 8-USOP | 8-TSSOP | SMT
14 | 1 | D1 | VISHAY SEMICONDUCTOR DIODES DIVISION | SSA23L-E3/61T | SSA23L-E3/61TGICT-ND | DIODE SCHOTTKY 30V 2A DO214AC | DO-214AC | SMT
15 | 1 | U9 | MICRON TECHNOLOGY INC | MT48H32M16LFB4-75 IT:C | 557-1596-ND | IC SDRAM 512MBIT 133MHZ 54VFBGA | 54-VFBGA | BGA
16 | 1 | U1 | LINEAR TECHNOLOGY | LTC3105EMS#PBF | LTC3105EMS#PBF-ND | IC CONV DC/DC 400MA HIEFF 12MSOP | 12-TSSOP | SMT
17 | 1 | S3 | VISHAY SILICONIX | SIP32413DNP-T1-GE4 | SIP32413DNP-T1-GE4CT-ND | IC SW W/CTRL SLEW RATE 8TDFN | 8-UFDFN | Leadless
18 | 5 | S5,S7-S10 | VISHAY SILICONIX | SIP32414DNP-T1-GE4 | SIP32414DNP-T1-GE4CT-ND | IC SW W/CTRL SLEW RATE 8TDFN | 8-UFDFN | Leadless
19 | 2 | S11,S12 | VISHAY SILICONIX | SIP32416DNP-T1-GE4 | SIP32416DNP-T1-GE4CT-ND | IC SW W/CTRL SLEW RATE 8TDFN | 8-UFDFN | Leadless
20 | 2 | S1,S2 | TEXAS INSTRUMENTS | TPS22912CYZVR | 296-36786-1-ND | IC LOAD SWITCH 2A 4DSBGA | 4-XFBGA | BGA
21 | 1 | U8 | TEXAS INSTRUMENTS | TXB0106PWR | 296-23759-1-ND | IC 6BIT NON-INV TRANSLTR 16TSSOP | 16-TSSOP | SMT
22 | 1 | L4 | SUMIDA AMERICA COMPONENTS INC | 252012CDMCDS-4R7MC | 308-2346-1-ND | IND POWER 4.7UH SMD | 1008 | SMT | 0.47uH
23 | 1 | L5 | SUMIDA AMERICA COMPONENTS INC | 252012CDMCDS-100MC | 308-2349-1-ND | IND POWER 10UH SMD | 1008 | SMT | 10uH
24 | 1 | L2 | SUMIDA AMERICA COMPONENTS INC | 252012CDMCDS-3R3MC | 308-2345-1-ND | IND POWER 3.3UH SMD | 1008 | SMT | 3.3uH
25 | 2 | L1,L3 | SUMIDA AMERICA COMPONENTS INC | 252012CDMCDS-4R7MC | 308-2346-1-ND | IND POWER 4.7UH SMD | 1008 | SMT | 4.7uH
26 | 16 | C65-C68,C74,C78,C80-C83,C86,C87,C90,C91,C94,C95 | SAMSUNG ELECTRO-MECHANICS AMERICA, INC | CL05A104MP5NNNC | 1276-1443-1-ND | CAP CER 0.1UF 10V 20% X5R 0402 | 0402 | SMT | 0.1uF
29 | 8 | C77,C79,C84,C85,C88,C89,C92,C93 | MURATA ELECTRONICS | GRM155R61C103KA01D | 490-6309-1-ND | CAP CER 10000PF 16V 10% X5R 0402 | 0402 | SMT | 10nF
30 | 1 | C69 | MURATA ELECTRONICS | GRM155R61A223KA01D | 490-6302-1-ND | CAP CER 0.022UF 10V 10% X5R 0402 | 0402 | SMT | 22nF
31 | 4 | C70-C73 | MURATA ELECTRONICS | GRM155R61A473KA01D | 490-5412-1-ND | CAP CER 0.047UF 10V 10% X5R 0402 | 0402 | SMT | 47nF
32 | 1 | C45 | SAMSUNG ELECTRO-MECHANICS AMERICA, INC | CL10C220GB8NNNC | 1276-2225-1-ND | CAP CER 22PF 50V 2% NP0 0603 | 0603 | SMT | 22pF
34 | 4 | C63,C64,C115,C118 | SAMSUNG ELECTRO-MECHANICS AMERICA, INC | CL10B103MB8NCNC | 1276-1927-1-ND | CAP CER 10000PF 50V 20% X7R 0603 | 0603 | SMT | .01uF
35 | 1 | C60 | TDK CORPORATION | C1608X5R1H333K080AA | 445-14153-1-ND | CAP CER 0.033UF 50V 10% X5R 0603 | 0603 | SMT | 0.033uF
36 | 38 | C4-C24,C36-C41,C43,C46,C49,C55,C56,C58,C59,C61,C62,C114,C116 | SAMSUNG ELECTRO-MECHANICS AMERICA, INC | CL10A104KA8NNNC | 1276-1857-1-ND | CAP CER 0.1UF 25V 10% X5R 0603 | 0603 | SMT | 0.1uF
37 | 8 | C25,C27,C30,C33-C35,C54,C57 | MURATA ELECTRONICS | GRM188R61A105KA61D | 490-1543-1-ND | CAP CER 1UF 10V 10% X5R 0603 | 0603 | SMT | 1uF
38 | 21 | C26,C51-C52,C96-C113 | SAMSUNG ELECTRO-MECHANICS AMERICA, INC | CL10A475KA8NQNC | 1276-1900-1-ND | CAP CER 4.7UF 25V 10% X5R 0603 | 0603 | SMT | 4.7uF
40 | 2 | C3,C42 | SAMSUNG ELECTRO-MECHANICS AMERICA, INC | CL10A226MP8NUNE | 1276-1274-1-ND | CAP CER 22UF 10V 20% X5R 0603 | 0603 | SMT | 22uF
41 | 2 | C29,C32 | TDK CORPORATION | C2012X5R1A476M125AC | 445-8239-1-ND | CAP CER 47UF 10V 20% X5R 0805 | 0805 | SMT | 47uF |  | 0805 Cap on a 0603 pad
42 | 1 | R28 | PANASONIC ELECTRONIC COMPONENTS | ERJ-M03NF10MV | P10AXCT-ND | RES 0.01 OHM 1/4W 1% 0603 SMD | 0603 | SMT | 0.01 | 1.0%
43 | 2 | R25,R26 | PANASONIC ELECTRONIC COMPONENTS | ERJ-3GEYJ101V | P100GCT-ND | RES 100 OHM 1/10W 5% 0603 SMD | 0603 | SMT | 100
44 | 2 | R15,R32 | PANASONIC ELECTRONIC COMPONENTS | ERJ-3GEYJ102V | P1.0KGCT-ND | RES 1K OHM 1/10W 5% 0603 SMD | 0603 | SMT | 1k
45 | 1 | R2 | PANASONIC ELECTRONIC COMPONENTS | ERJ-3EKF2001V | P2.00KHCT-ND | RES 2K OHM 1/10W 1% 0603 SMD | 0603 | SMT | 2K | 1.0%
46 | 7 | R9,R10,R14,R16,R20,R29,R30 | PANASONIC ELECTRONIC COMPONENTS | ERJ-3GEYJ103V | P10KGCT-ND | RES 10K OHM 1/10W 5% 0603 SMD | 0603 | SMT | 10k
47 | 1 | R33 | PANASONIC ELECTRONIC COMPONENTS | ERJ-3EKF1822V | P18.2KHCT-ND | RES 18.2K OHM 1/10W 1% 0603 SMD | 0603 | SMT | 18.2k
48 | 5 | R12,R13,R21,R31,R35 | PANASONIC ELECTRONIC COMPONENTS | ERJ-3GEYJ243V | P24KGCT-ND | RES 24K OHM 1/10W 5% 0603 SMD | 0603 | SMT | 24k
49 | 1 | R22 | PANASONIC ELECTRONIC COMPONENTS | ERJ-3EKF4022V | P40.2KHCT-ND | RES 40.2K OHM 1/10W 1% 0603 SMD | 0603 | SMT | 40.2k
50 | 1 | R18 | PANASONIC ELECTRONIC COMPONENTS | ERA-3AEB6492V | P64.9KDBCT-ND | RES 64.9K OHM 1/10W .1% 0603 SMD | 0603 | SMT | 64.9k | 0.1%
51 | 1 | R6 | PANASONIC ELECTRONIC COMPONENTS | ERA-3AEB6812V | P68.1KDBCT-ND | RES 68.1K OHM 1/10W .1% 0603 SMD | 0603 | SMT | 68.1k | 0.1%
52 | 1 | R8 | PANASONIC ELECTRONIC COMPONENTS | ERA-3AEB6982V | P69.8KDBCT-ND | RES 69.8K OHM 1/10W .1% 0603 SMD | 0603 | SMT | 69.8k | 0.1%
53 | 1 | R5 | PANASONIC ELECTRONIC COMPONENTS | ERA-3AEB1373V | P137KDBCT-ND | RES 137K OHM 1/10W .1% 0603 SMD | 0603 | SMT | 137k | 0.1%
54 | 1 | R19 | PANASONIC ELECTRONIC COMPONENTS | ERA-3AEB1743V | P174KDBCT-ND | RES 174K OHM 1/10W .1% 0603 SMD | 0603 | SMT | 174k | 0.1%
55 | 2 | R4,R7 | PANASONIC ELECTRONIC COMPONENTS | ERA-3AEB2213V | P221KDBCT-ND | RES 221K OHM 1/10W .1% 0603 SMD | 0603 | SMT | 221k | 0.1%
56 | 1 | R23 | TT ELECTRONICS/WELWYN | PCF0603R-332KBT1 | 985-1290-1-ND | RES 332K OHM 1/16W 0603 0.1%SMD | 0603 | SMT | 332k | 0.1%
57 | 3 | R3,R11,R17 | TE CONNECTIVITY AMP | 1-1879417-9 | A102234CT-ND | RES 1M OHM 1/16W 0.1% 0603 | 0603 | SMT | 1M | 0.1%
58 | 1 | R24 | VISHAY DALE | CRCW06031M02FKEA | 541-1.02MHCT-ND | RES 1.02M OHM 1/10W 1% 0603 SMD | 0603 | SMT | 1.020M | 1.0%
59 | 1 | R34 | SAMSUNG ELECTRO-MECHANICS AMERICA, INC | RC1608F185CS | 1276-4942-1-ND | RES 1.8M OHM 1/10W 1% 0603 | 0603 | SMT | 1.8M
60 | 1 | R1 | PANASONIC ELECTRONIC COMPONENTS | EXB-2HV105JV | Y1105CT-ND | RES ARRAY 1M OHM 8 RES 1506 | 1506 | Leadless | 1M Ohm
61 | 1 | U3 | ALTERA | 5CEBA4U15C7N | 989-5CEBA4U15C7N | FPGA - Cyclone V E 1848 LABs 176 IOs | BGA-324 | BGA
62 | 1 | U12 | TEXAS INSTRUMENTS | BQ27520-G3 | 595-BQ27520YZFT-G3 | Battery Management Sys-Side Impedance Track Fuel Gauge | DSBGA-15 | BGA
63 | 1 | R27 | Semitec | 103AT-4 | 954-103AT-4-70374 | NTC 10kohm 1% Shape 1 30 AWG 50mm | NTC | thru-hole | 10K | 1.0%
64 | 1 | U27 | STMicroelectronics | LSM9DS1 | 511-LSM9DS1TR | IMUs - Inertial Measurement Units iNEMO inertial module:3D accelerometer, 3D gyroscope, 3D magnetometer | LGA-24 | Leadless
65 | 3 | U5-U7 | 4UCON TECHNOLOGY INC |  | PRT-00127 | uSD Card Holder |  | SMT |  |  | Do not populate U4
66 | 1 | AE1 | JOHANSON TECHNOLOGY | 1575AT43A0040E | 712-1003-1-ND | ANTENNA CHIP GPS 1575 MHZ |  | SMT
67 | 1 | U11 | UBLOX | MAX-7Q |  | GPS |  | SMT
68 | 1 | J51 | 3M | 30310-6002HB | 30310-6002HB-ND | CONN HEADER 10POS DL STR GOLD |  | thru-hole
69 | 1 | J38 | JTAG HEADER | 10 Pin - Header |  | Conn Header 10 Pos .1 STR T IN |  | thru-hole
74 | 1 | J36 | I2C Header | 100Mil Spaced pins |  | 100Mil Spaced pins |  | thru-hole
78 | 6 | Solar Cells | SpectroLabs | TASC Cells |  | Solar Cells
79 | 1 | Battery | AW | IMR16340 |  | Battery
 |  |  |  |  |  | BOARD SUMMARY FOR QUOTE
 |  |  |  |  |  | Total # of unique parts | 78
 |  |  |  |  |  | SMT placement per board | 173
 |  |  |  |  |  | Thru-hole placements per board | 5
 |  |  |  |  |  | Fine pitch placements per board | 0
 |  |  |  |  |  | BGA/leadless placements per board | 22
 |  |  |  |  |  | Total parts | 200
