rksnider/SensorCollar/PCB_Designs/DevBoard_PowerMonitor/0Schematic/BoM.xlsx

# | DEVICE | PART_NUMBER | REFDES | Single QTY |  | Price
1 | 1p1V_Converter_TPS6085 | TPS62085 | PS1 | 1 |  | 3.14 | 3.14
2 | ADMP621_MEMS_MIC | ADMP621 | U15,U16 | 2 |  | 16.29 | 32.58
3 | ADP191_Power_Switch | ADP191 | S6,S13 | 2 |  | 1.1 | 2.2
4 | CLOCK_SG210STF | SG-210STF50.0000MS3 | CLK1 | 1 |  | 1.79 | 1.79
5 | DUAL_BUCK_WITH_BOOST_LTC3521 | LTC3521 | U10 | 1 |  | 7.36 | 7.36
6 | FERRITE_BEAD_FILTER | BLM18PG600SN1D | FB1,FB2 | 2 |  | 0.1 | 1
7 | FLASH_Micron_N25Q128A | N25Q128A11ESE40G | U17 | 1 |  | 1.88 | 1.88
8 | MAXV_TQFP100 | 5M570ZT100C5N | U14 | 1 |  | 7.5 | 7.5
9 | MRAM_MR20H40CDF_8DFN_SMALLFLAG_PART | MR20H40 | U18 | 1 |  | 19.93 | 19.93
10 | OCTAL_BUFFER_SN74LVC244A | SN74LVC244APWR | U13 | 1 |  | 0.49 | 1
11 | Oscillation_Crystal | ABS07-120-32.768kHz-T | U25 | 1 |  | 0.73 | 1
12 | PUSH_BUTTON | KS12R22CQD | PB1 | 1 |  | 2.16 | 2.16
13 | RTC_DS1371 | DS1371 | U26 | 1 |  | 2.88 | 2.88
14 | SCHOTTKY_DIODE | SSA23L | D1 | 1 |  | 0.47 | 1
15 | SDRAM_MT48H32M16LFB4 | MT48H32M16LFB4 | U9 | 1 |  | 9.94 | 9.94
16 | Solar_Ctl_LTC3105 | LTC3105EMS | U1 | 1 |  | 5.78 | 5.78
17 | SWITCH_DUAL_SiP32413 | Sip32413 | S3 | 1 |  | 0.87 | 1
18 | SWITCH_DUAL_SiP32414 | Sip32414 | S5,S7-S10 | 5 |  | 0.87 | 4.35
19 | SWITCH_DUAL_SiP32416 | Sip32416 | S11,S12 | 2 |  | 0.66 | 1.32
20 | SWITCH_MAGNASPHERE-S | MG-B2-20-S | S4 | 1 |  | 6.78 | 6.78
21 | SWITCH_SINGLE_TPS22912C | TPS22912C | S1,S2 | 2 |  | 0.89 | 1.78
22 | TXB0106_PW_16 | TXB0106 | U8 | 1 |  | 2.01 | 2.01
23 | Inductor | 252012CDMCDS-4R7MC | L4 | 1 |  | 0.37 | 1
24 | Inductor | 252012CDMCDS-100MC | L5 | 1 |  | 0.37 | 1
25 | Inductor | 252012CDMCD-3R3MC | L2 | 1 |  | 0.37 | 1
26 | Inductor | 252012CDMCD-4R7MC | L1,L3 | 2 |  | 0.37 | 1
27 | cap_0402 | CL05A104MP5NNNC | C65-C68,C74,C78,C80-C83,C86,C87,C90,C91,C94,C95 | 20 |  | 0.012 | 1
28 | cap_0402 | CL05A224KP5NNNC | C75 | 3 |  | 0.1 | 1
29 | cap_0402 | CL05A474KP5NNNC | C76 | 3 |  | 0.11 | 1
30 | cap_0402 | GRM155R61C103KA01D | C77,C79,C84,C85,C88,C89,C92,C93 | 12 |  | 0.023 | 1
31 | cap_0402 | GRM155R61A223KA01D | C69 | 3 |  | 0.1 | 1
32 | cap_0402 | GRM155R61A473KA01D | C70-C73 | 6 |  | 0.1 | 1
33 | cap_0603 | CL10C220GB8NNNC | C45 | 3 |  | 0.16 | 1
34 | cap_0603 | CL10C330JB8NNNC | C48 | 3 |  | 0.1 | 1
35 | cap_0603 | CL10B103MB8NCNC | C63,C64,C115,C118 | 6 |  | 0.1 | 1
36 | cap_0603 | C1608X5R1H333K080AA | C60 | 3 |  | 0.1 | 1
37 | cap_0603 | CL10A104KA8NNNC | C4-C24,C36-C41,C43,C46,C49,C55,C56,C58,C59,C61,C62,C114,C116 | 50 |  | 0.0256 | 1.28
38 | cap_0603 | GRM188R61A105KA61D | C25,C27,C30,C33-C35,C54,C57 | 10 |  | 0.041 | 1
39 | cap_0603 | CL10A475KA8NQNC | C26,C51-C52,C96-C113 | 25 |  | 0.2244 | 5.61
40 | cap_0603 | CL10A106MQ8NNNC | C1,C2,C28,C31,C44,C47,C50,C53,C117 | 12 |  | 0.128 | 1.536
41 | cap_0603 | CL10A226MP8NUNE | C3,C42 | 5 |  | 0.87 | 4.35
42 | cap_0805 | C2012X5R1A476M125AC | C29,C32 | 5 |  | 1.03 | 5.15
43 | Res_0603 | ERJ-M03NF10MV | R28 | 3 |  | 0.95 | 2.85
44 | Res_0603 | ERJ-3GEYJ101V | R25,R26 | 5 |  | 0.1 | 1
45 | Res_0603 | ERJ-3GEYJ102V | R15,R32 | 5 |  | 0.1 | 1
46 | Res_0603 | ERJ-3EKF2001V | R2 | 3 |  | 0.1 | 1
47 | Res_0603 | ERJ-3GEYJ103V | R9,R10,R14,R16,R20,R29,R30 | 10 |  | 0.1 | 1
48 | Res_0603 | ERJ-3EKF1822V | R33 | 3 |  | 0.1 | 1
49 | Res_0603 | ERJ-3GEYJ243V | R12,R13,R21,R31,R35 | 10 |  | 0.1 | 1
50 | Res_0603 | ERJ-3EKF4022V | R22 | 3 |  | 0.1 | 1
51 | Res_0603 | ERA-3AEB6492V | R18 | 3 |  | 0.63 | 1.89
52 | Res_0603 | ERA-3AEB6812V | R6 | 3 |  | 0.63 | 1.89
53 | Res_0603 | ERA-3AEB6982V | R8 | 3 |  | 0.63 | 1.89
54 | Res_0603 | ERA-3AEB1373V | R5 | 3 |  | 0.63 | 1.89
55 | Res_0603 | ERA-3AEB1743V | R19 | 3 |  | 0.63 | 1.89
56 | Res_0603 | ERA-3AEB2213V | R4,R7 | 5 |  | 0.63 | 3.15
57 | Res_0603 | PCF0603R-332KBT1 | R23 | 3 |  | 0.54 | 1.62
58 | Res_0603 | 1-1879417-9 | R3,R11,R17 | 5 |  | 0.65 | 3.25
59 | Res_0603 | CRCW06031M02FKEA | R24 | 10 |  | 0.088 | 1
60 | Res_0603 | RC1608F185CS | R34 | 1 |  | 0.1 | 1
61 | RESISTOR_PACK_EXB-2HV105JV | EXB-2HV105JV | R1 | 1 |  | 0.55 | 1
62 | 10 Pin Header | 30310-6002HB | J38 | 2 |  | 0.64 | 1.28
68 | ANTENNA | 1575AT43A0040 | AE1 | 1 | http://www.johansontechnology.com/integrated-passives/rohs-compliant-ceramic-chip-antennas.html | 1.28 | 1.28
72 | Battery Holder |  |  | 1 |  | 2.15 | 2.15
 | Mouser Parts
63 | Cyclone V | 5CEBA4U15C7N | U3 | 1 |  | 70.85 | 70.85
64 | Battery_Monitor_BQ27520-G3 | BQ27520-G3 | U12 | 1 |  | 4.37 | 4.37
65 | THERMISTOR_103AT | 103AT-4 | R27 | 1 |  | 1.13 | 1.13
66 | IM_LSM9DS1 | LSM9DS1 | U27 | 1 |  | 6.44 | 6.44
 | Non-Stock Parts
67 | 4UCON_SD_SPARK_PART | https://www.sparkfun.com/products/127 | U4-U7 | 3 |  | 3.95 | 11.85
69 | BATTERY |  | B1 | 1 |  | 6.99 | 6.99
70 | MAX-7Q | MAX-7Q | U11 | 1 |  | 38.4 | 38.4
 | Solar Cells |  |  | 6 |  | 25 | 150
 |  |  | Parts Cost | 326.366
 |  |  | Manufacturing Cost | 1739.63 |  | 174
 |  |  | Assembly Cost | 1657.75 |  | 332
 |  |  | Single Board Total | 832.366
