rksnider/SensorCollar/PCB_Designs/GPS Board/0Schematic/GPS Board/GPS_BOARD.xlsx

# | QTY | DEVICE | REFDES | PKG_TYPE | VALUE | P/D_NUM | PART_NUMBER | PART_LABEL | PKG_GRP
1 | 1 | 0p1uF_cap_0603 | C1 | 0603_MY | 0.1uF
2 | 1 | 908_22101T_MMCX | J4 | 908_22101T_MMCX |  | ARF1725CT-ND |  | 22101T
3 | 1 | ANTENNA | AE1 | ANTENNA |  | 712-1003-1-ND | 1575AT43A0040
4 | 2 | FERRITE_BEAD_FILTER | FB1,FB2 | 0603_MY |  | 490-1036-1-ND | BLM18PG600SN1D
5 | 1 | JUMPER_2PIN_100MIL | J2 | JUMPER_2PIN_100MIL
6 | 2 | JUMPER_5PIN_100MIL | J1,J3 | JUMPER_5PIN_100MIL
7 | 1 | MAX-7Q | U1 | MAX-7_GPS |  |  | MAX-7Q
