rksnider/SensorCollar/PCB_Designs/Data_TRX/0Schematic/Data_TRX_BoM.xlsx

# | QTY | DEVICE | REFDES | PKG_TYPE | VALUE | TOLERANCE | P/D_NUM | PART_NUMBER
1 | 2 | cap_0p1uF_0402 | C19,C20 | 0402_MY | 0.1uF |  | 1276-1043-1-ND | CL05A104KA5NNNC
2 | 2 | cap_0p01uF_0402 | C171,C211 | 0402_MY | 0.01uF |  | 1276-1057-1-ND | CL05B103KA5NNNC
3 | 1 | cap_0p22uF_0402 | C61 | 0402_MY | 0.22uF | 10% | 490-3910-1-ND | GRM155R61A224KE19D
4 | 11 | cap_0p047uF_0402 | C11,C51,C121,C131,C151,C221,C251,C261,C271,C281,C291 | 0402_MY | 0.047uF | 10% | 490-3254-1-ND | GRM155R71E473KA88D
5 | 1 | cap_1pF_0402 | C176 | 0402_MY | 1pF | 0.1pF | 490-8083-1-ND | GJM1555C1H1R0BB01J
6 | 1 | cap_2p2pF_0402 | C181 | 0402_MY | 2.2pF | 0.25pF | 490-5932-1-ND | GRM1555C1H2R2CA01D
7 | 2 | cap_3p3pF_0402 | C191,C201 | 0402_MY | 3.3pF | 0.25pF | 490-5938-1-ND | GRM1555C1H3R3CA01D
8 | 1 | cap_3pF_0402 | C175 | 0402_MY | 3pF | 5% | 1276-1598-1-ND | CL05C030CB5NNNC
9 | 2 | cap_4p7uF_0402 | C25,C26 | 0402_MY | 4.7uF |  | 1276-1482-1-ND | CL05A475MP5NRNC
10 | 3 | cap_15pF_0402 | C174,C301,C311 | 0402_MY | 15pF | 5% | 1276-1179-1-ND | CL05C150JB5NNNC
11 | 1 | cap_33pF_0402 | C173 | 0402_MY | 33pF |  | 1276-1272-1-ND | CL05C330JB5NNNC
12 | 1 | cap_100pF_0402 | C172 | 0402_MY | 100pF | 5% | 490-5922-1-ND | GRM1555C1H101JA01D
13 | 1 | cap_1800pF_0402 | C231 | 0402_MY | 1800pF | 5% | 490-6274-1-ND | GRM1557U1A182JA01D
14 | 1 | CRYSTAL_32MHz | X1 | CRYSTAL_32MHz |  |  | 732-FA128-32F20X-K3 | FA-128 32.0000MF20X-K3
15 | 1 | Data_Transfer_CC1120 | U1 | Data_Transfer_CC1120 |  |  | 296-35667-1-ND | CC1120RHBR
16 | 1 | Inductor_7p5nH_0402 | L172 | 0402_MY | 7.5nH |  | 490-6846-1-ND | LQW15AN7N5G00D
17 | 1 | Inductor_10nH_0402 | L171 | 0402_MY | 10nH |  | 490-1146-1-ND | LQW15AN10NJ00D
18 | 4 | Inductor_12nH_0402 | L174,L192,L193,L201 | 0402_MY | 12nH |  | 490-1147-1-ND | LQW15AN12NJ00D
19 | 1 | Inductor_15nH_0402 | L191 | 0402_MY | 15nH |  | 490-1148-1-ND | LQW15AN15NJ00D
20 | 1 | Inductor_18nH_0402 | L173 | 0402_MY | 18nH |  | 490-1149-1-ND | LQW15AN18NJ00D
21 | 1 | Res_10_0402 | R171 | 0402_MY | 10 | 1% | P10.0LCT-ND | ERJ-2RKF10R0X
22 | 1 | Res_56k1_0402 | R141 | 0402_MY | 56k | 1% | P56.0KLCT-ND | ERJ-2RKF5602X
23 | 1 | SWITCH_DUAL_SiP32414 | S1 | VISHNAY_DUAL_LOAD_SWITCH |  |  | SIP32414DNP-T1-GE4CT-ND | Sip32414
