rksnider/SensorCollar/Collar_Designs/SEND_5_8_2017/INTERPOSER_20.stl

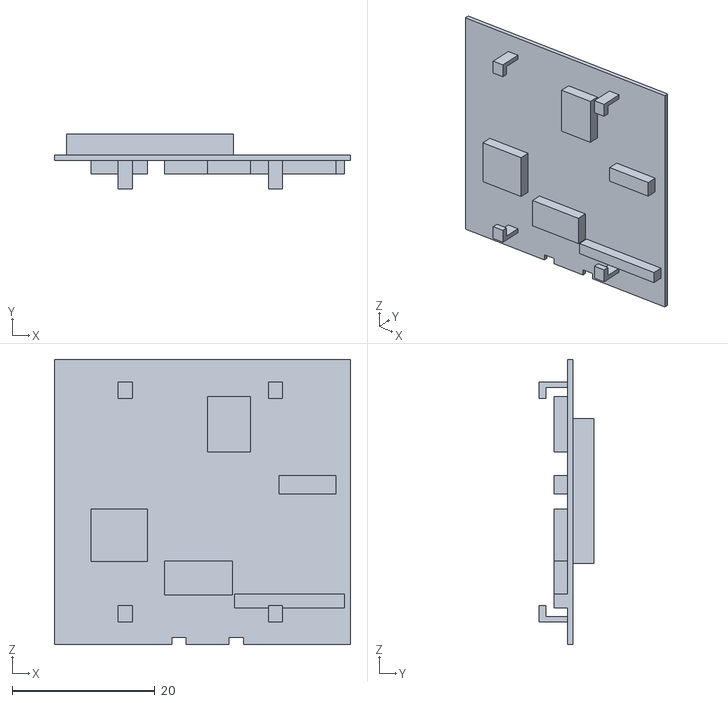
[picture p132: CAD file, 2018-05-16]
Collar_Designs/SEND_5_8_2017/INTERPOSER_20.stl
41.4 x 7.75 x 39.9
