rksnider/SensorCollar/Collar_Designs/SEND_5_8_2017/Collar_Mesh_63_outer.stl

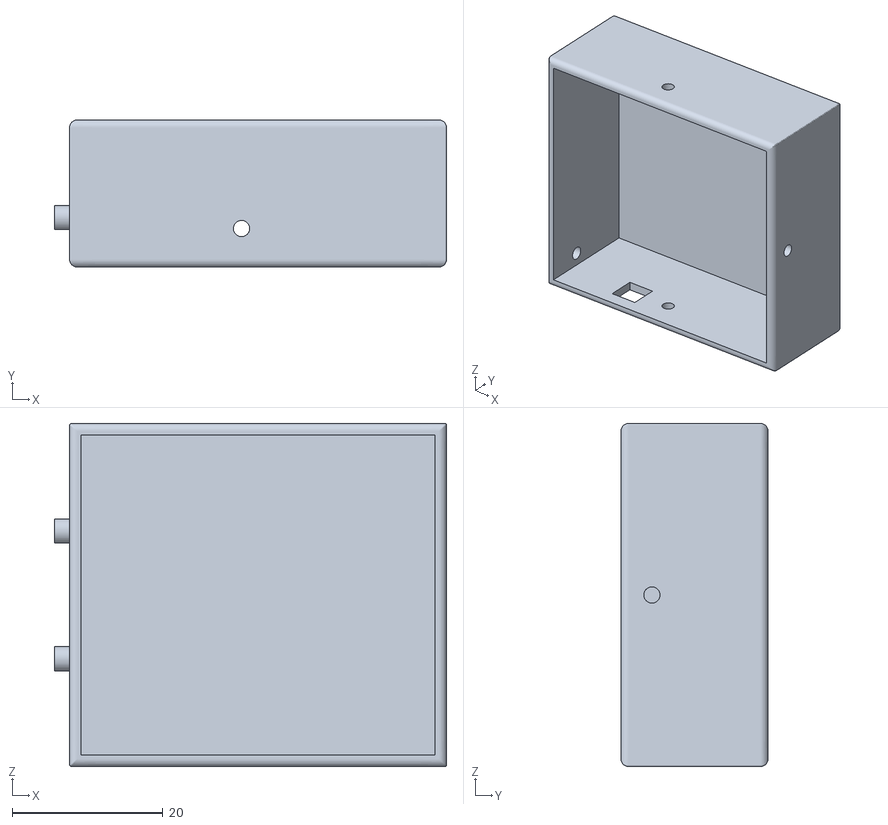
[picture p133: CAD file, 2018-05-16]
Collar_Designs/SEND_5_8_2017/Collar_Mesh_63_outer.stl
52.0 x 19.5 x 45.5
