rksnider/SensorCollar/Collar_Designs/SEND_5_8_2017/Collar_Mesh_63_inner.stl

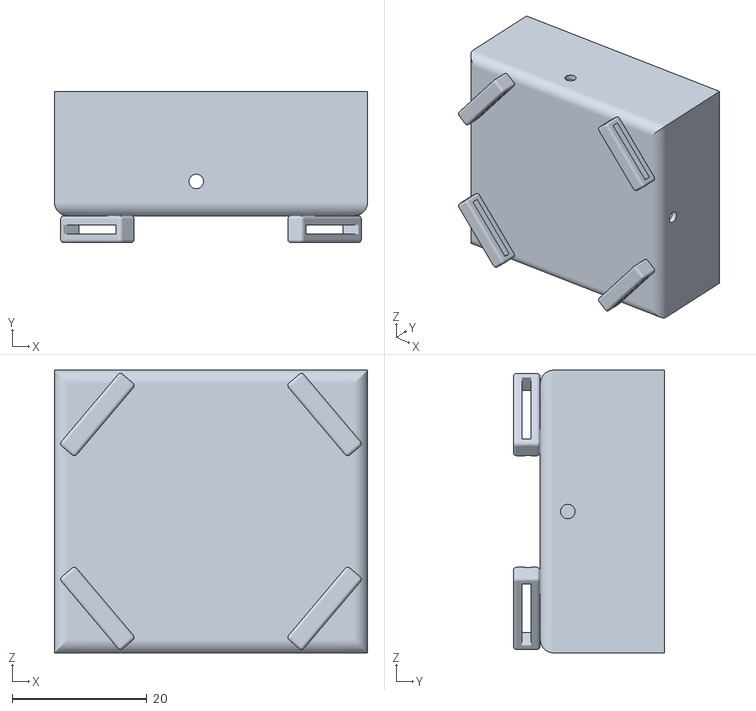
[picture p134: CAD file, 2018-05-16]
Collar_Designs/SEND_5_8_2017/Collar_Mesh_63_inner.stl
46.5 x 22.5 x 42.0
