rksnider/SensorCollar/Memory_Doc/Data Assembly and Memory Flow.docx

Data Assembly and Memory Flow

Buffer Addressing
