rksnider/SensorCollar/PCB_Designs/MCollar_v1/0Schematic/MCollar_SENSOR_915MHz_v1.pdf

## L5 10uH

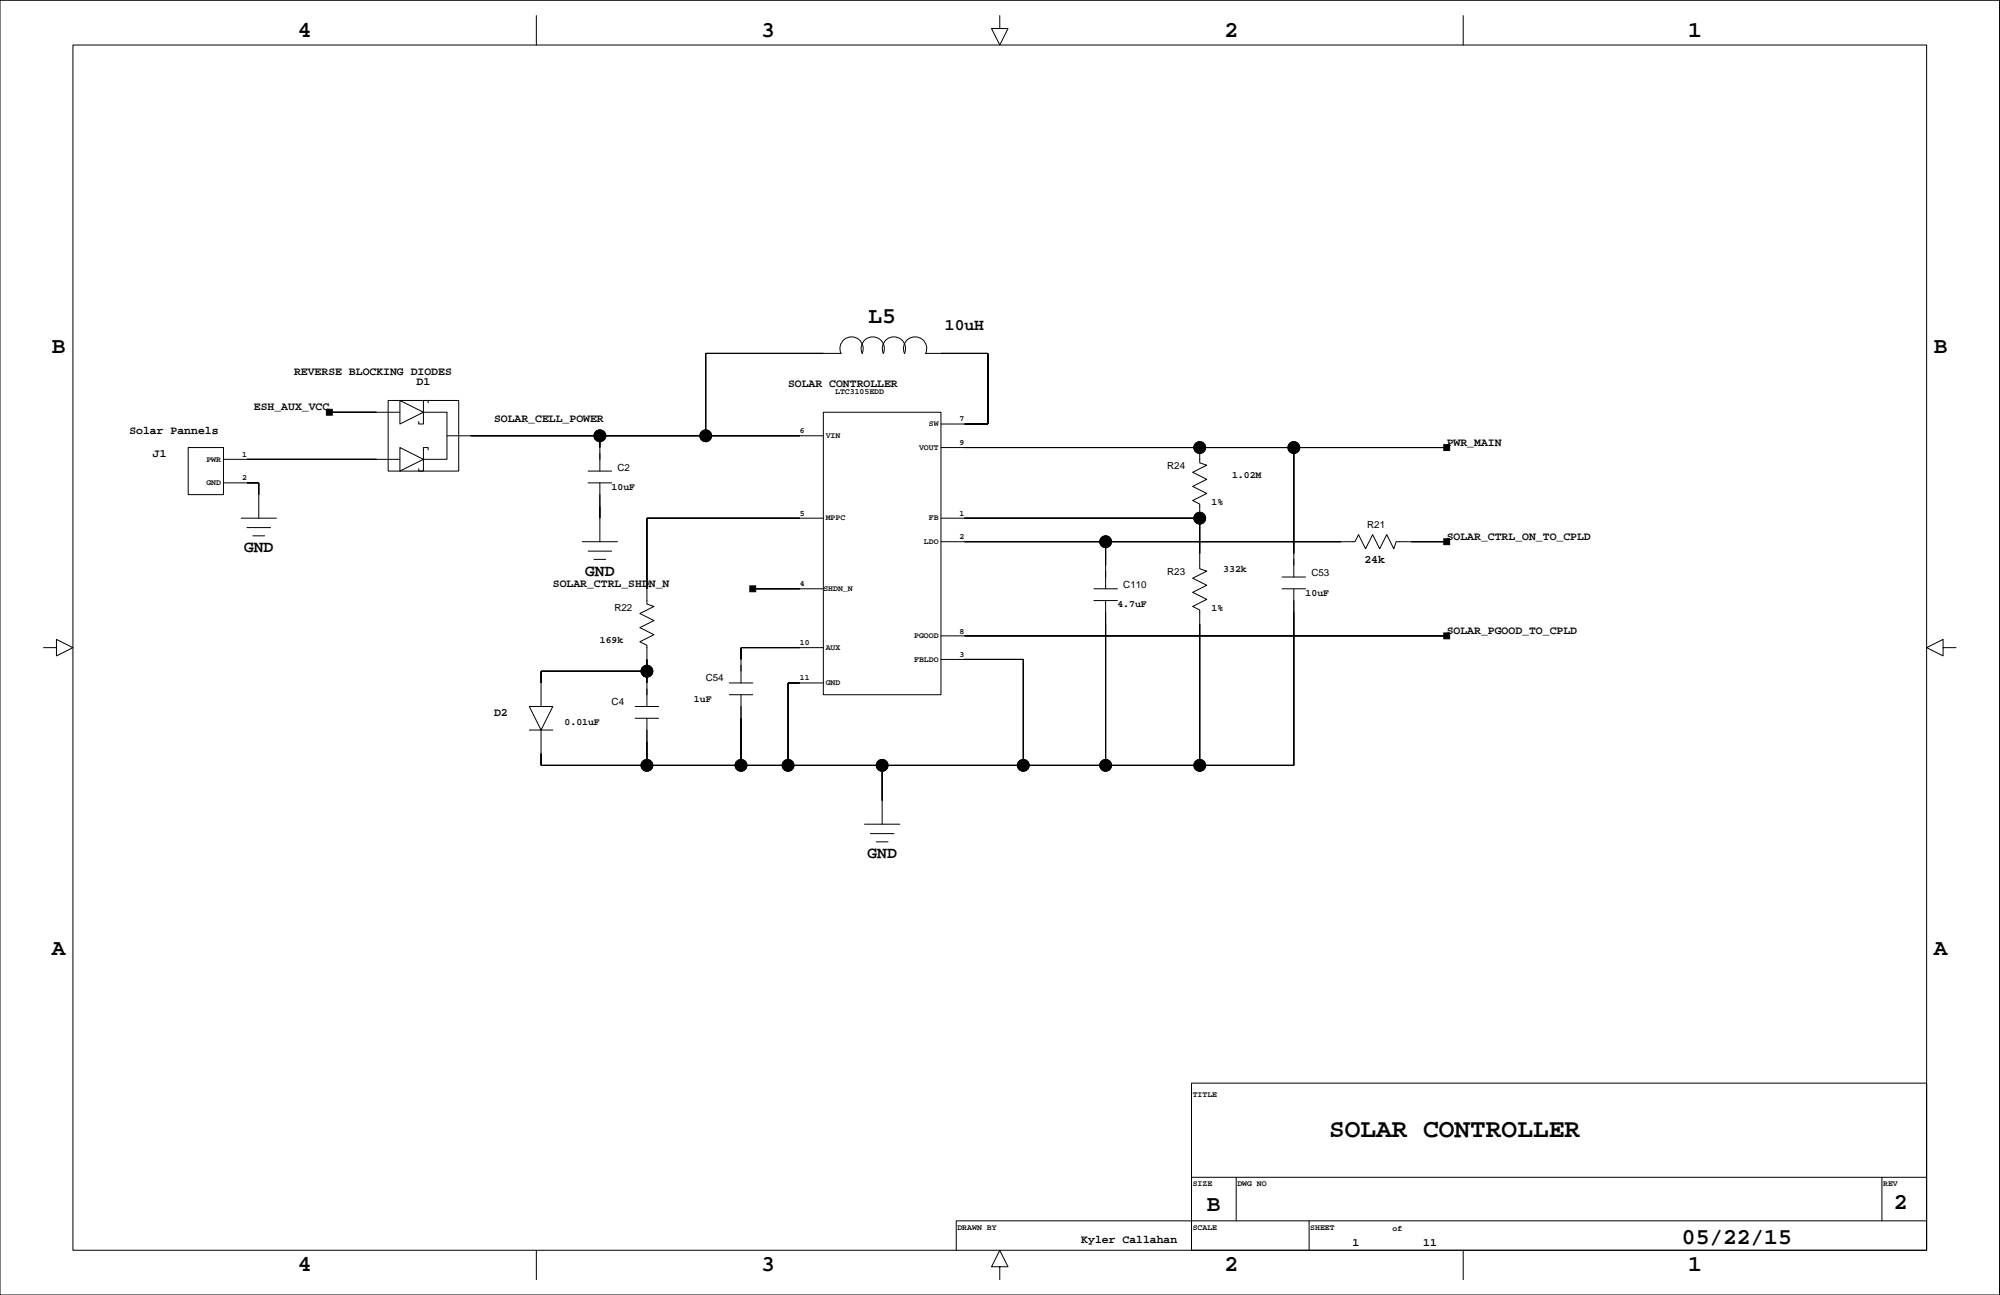
[picture p198: page 1]

## GND

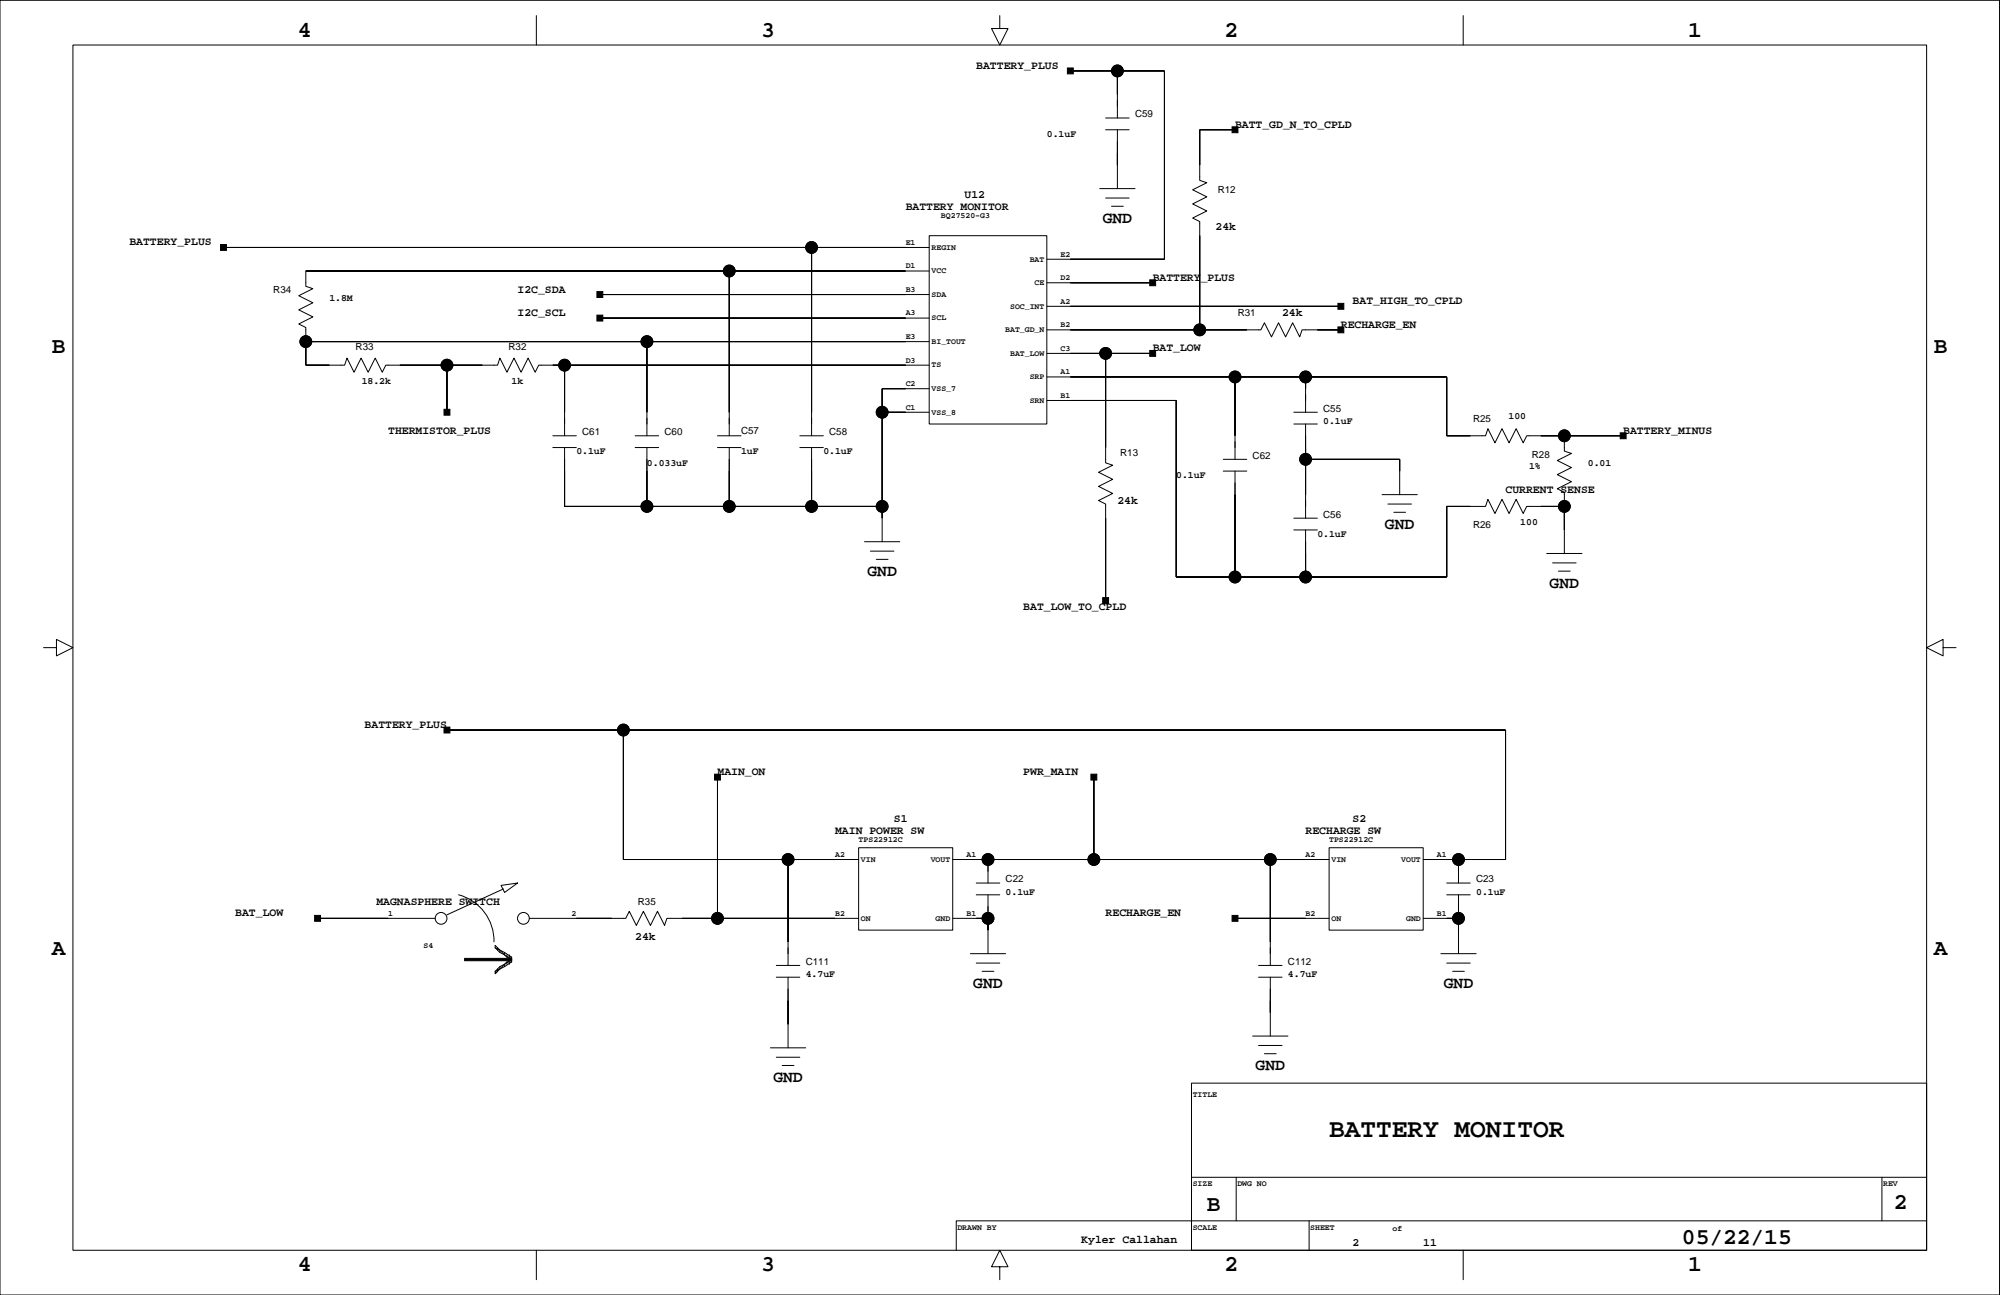
[picture p199: page 2]

TITLE; WDS; GND; VCC; SQW_INT_N; SCL; SDA; CRYSTAL; I2C_SCL; I2C_SDA; RTC_ALARM_TO_CPLD; BATTERY_PLUS

REAL TIME CLOCK

DAT2; CD_DAT3; CMD; VDD; CLK; VSS; DAT0; DAT1; GND1; GND2; SDCARD_POWER_3P3V; SDCARD_DI_DAT1_TO_FPGA; SDCARD_DI_DAT0_TO_FPGA; SDCARD_DI_CLK_TO_FPGA; SDCARD_DI_CMD_TO_FPGA; SDCARD_DI_CD_DAT3_TO_FPGA; SDCARD_DI_DAT2_TO_FPGA; TITLE; GND; SD CARD

VSS; VDD; HOLD_N; SCK; GND_LEAF; MRAM; MRAM_POWER_3P3V; GND; MRAM_CS_N_TO_FPGA; MRAM_SO_TO_FPGA; MRAM_WP_N_TO_FPGA; MRAM_SI_TO_FPGA; MRAM_SCK_TO_FPGA; TITLE; CNTRL1; CNTRL2; OUT1; GND7; GND6; OUT2; TERMAL_PAD; MRAM_CNTRL_TO_CPLD; VCC3P3; 1 MRAM_POWER_3P3V; Sip32414; POWER SWITCH; SDCARD_POWER_3P3V; SDCARD_CNTRL_TO_CPLD


10 GND10; GND12; ANT_ON; VCC_RF; RESVD; SDA; SCL; RESERVED; RESET_N; VCC; VCC_IO; V_BCKP; EXTINT; TIMEPULSE; RXD; TXD; GND1; GND; GPS_POWER_3P3V; VCC1P8; MAX-7Q; GPS; TXD_GPS_TO_FPGA; RXD_GPS_TO_FPGA; TIMEPULSE_GPS_TO_FPGA; EXTINT_GPS_TO_FPGA; GPS ANTENNA; TITLE; Kyler Callahan; CNTRL1; CNTRL2; OUT1; GND7; GND6; OUT2; TERMAL_PAD; Sip32414; S8 POWER SWITCH; VCC3P3; DATA_TX_PWR_3P3V; DATA_TX_CNTRL_TO_CPLD; GPS_CNTRL_TO_CPLD

## GND

## GND

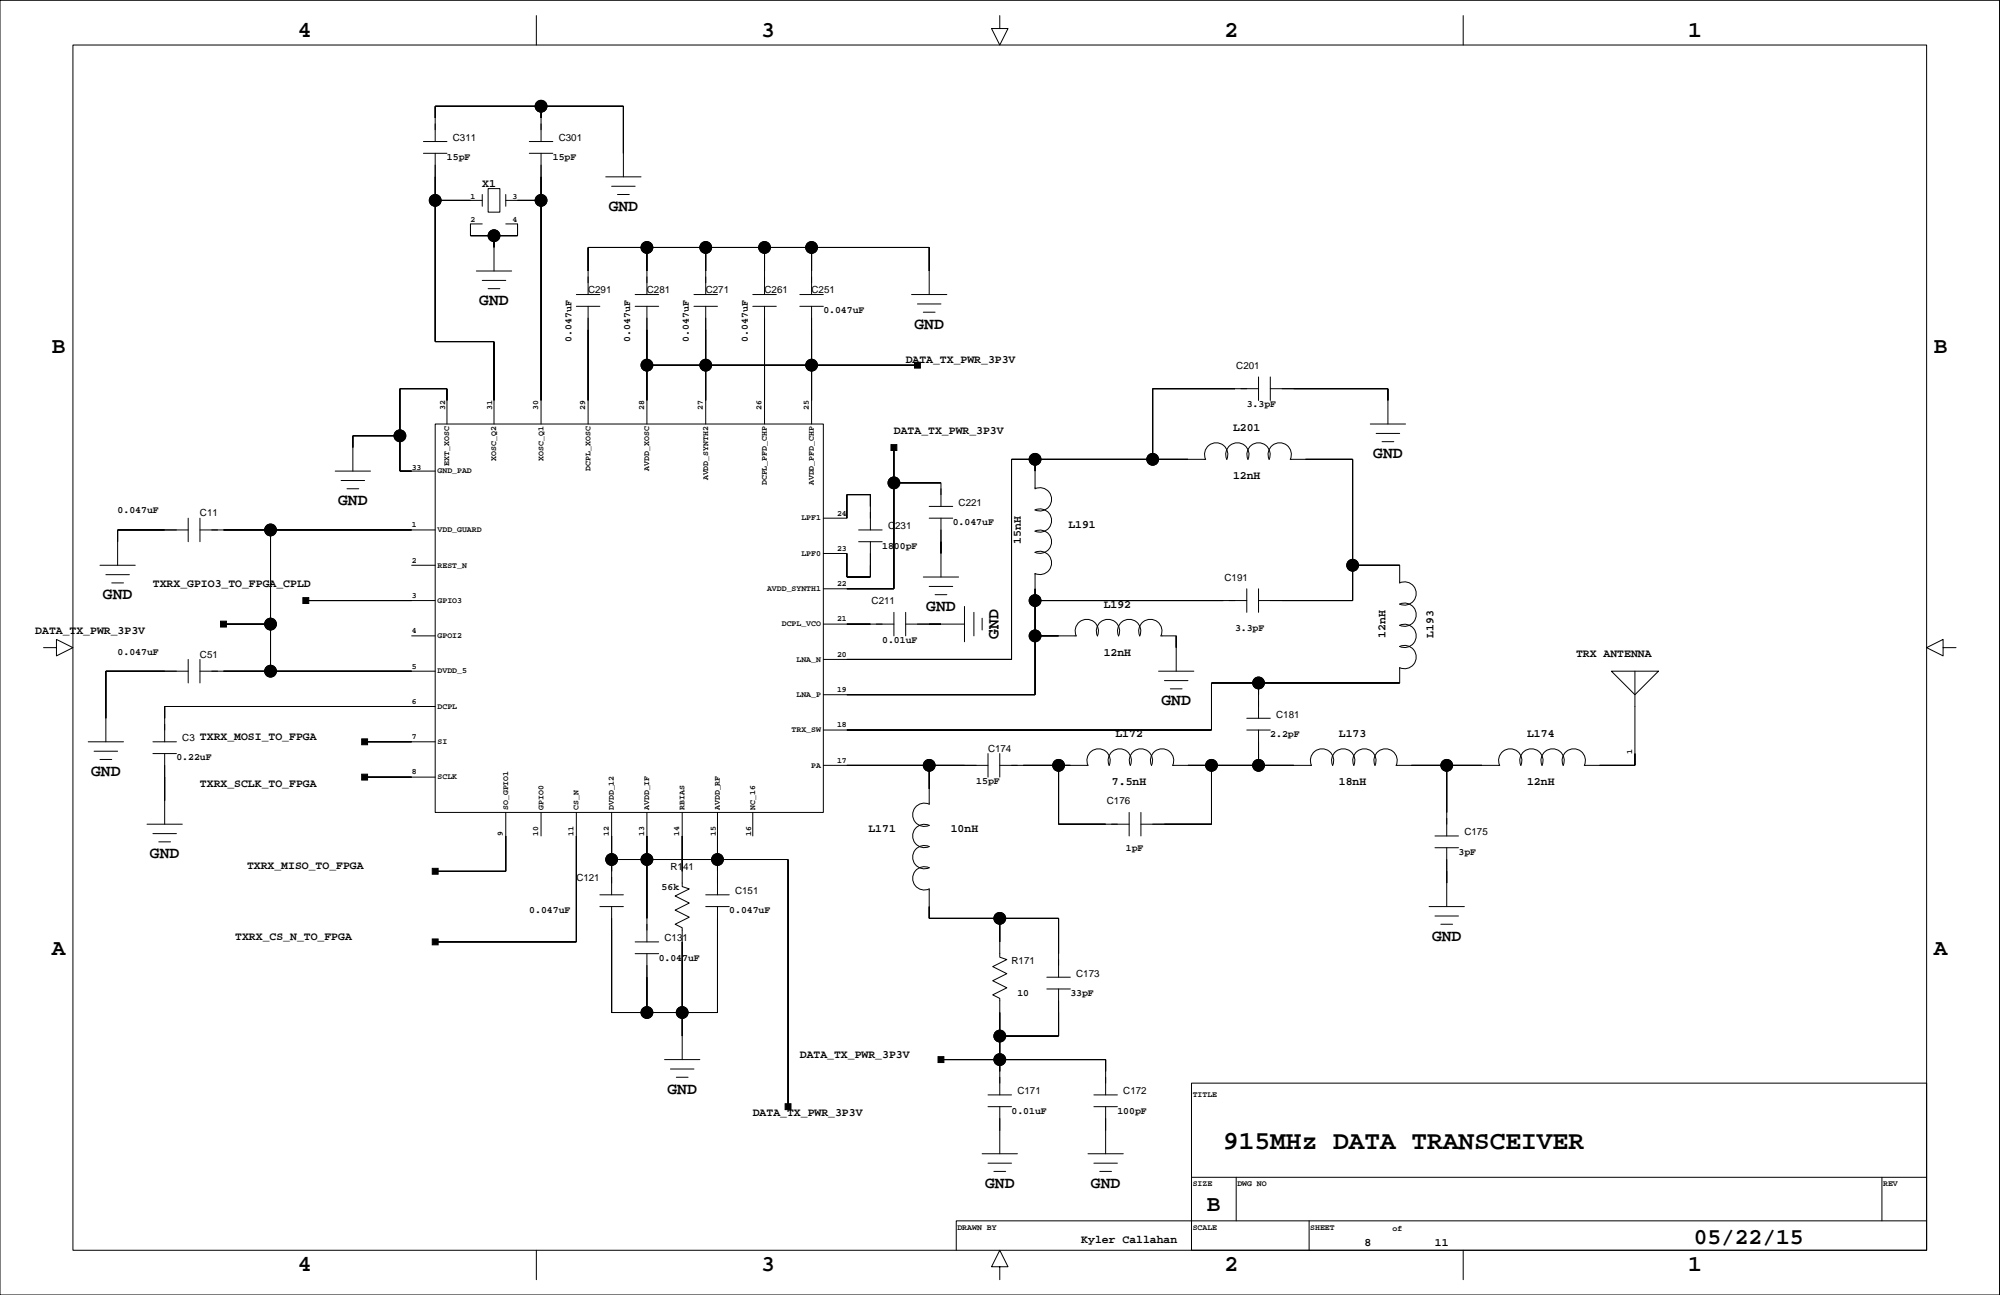
[picture p200: page 8]

## GND


TITLE

A

B B

A

ESH_AUX_VCC

ESH_AUX_VCC

ESH_FPGA_USB_DMINUS

ESH_FPGA_USB_DPLUS

ESH_FORCE_STARTUP

GND

GND

ESH_FPGA_SPI_CLK

ESH_JTAG_TCK

ESH_JTAG_TMS_SPI_CS

ESH_JTAG_TDI_SPI_MOSI

ESH_JTAG_TDO_SPI_MISO

THERMISTOR_PLUS

BATTERY_PLUS

BATTERY_PLUS

BATTERY_MINUS

BATTERY_MINUS

11 | 12 | 05/22/15

# REMOTE CONNECTOR CABLE

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
PIN_1

PIN_2

PIN_3

PIN_4

PIN_5

PIN_6

PIN_7

PIN_8

PIN_9

PIN_10

PIN_11

PIN_12

PIN_13

PIN_14

PIN_15

PIN_16

PIN_17

BATTERY BOARD INTERFACE

J6

3

4

2
SCL

GND

SDA

I2C HEADER

I2C_SCL

I2C_SDA

## GND

## GND

GROUND PAD

2

3

1
VCC

GND

DATA

DROP INTERFACE

## GND

FPGA_3P3V

DROP_CTRL_TO_CPLD

TITLE

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
01_M_FPGA_7A_11

03_M_FPGA_7A_12

05_M_FPGA_7A_10

07_M_FPGA_7A_05

09_M_FPGA_7A_09

11_M_FPGA_7A_04

13_GND

15_M_FPGA_7A_08

17_M_FPGA_7A_03

19_M_FPGA_7A_02

21_M_FPGA_7A_07

23_M_FPGA_7A_01

25_GND

27_M_FPGA_7A_00

29_M_FPGA_7A_06

31_M_FPGA_8A_02

33_M_FPGA_8A_00

35_M_FPGA_8A_01

37_GND

39_VCC1P8_AUX

41_PWR_MAIN

43_PWR_MAIN

45_GND

47_I2C_SDA

49_I2C_SCL

02_FPGA_3P3V

04_FPGA_3P3V

06_VCC1P8

08_VCC1P8

10_GND

12_CPLDON_00

14_CPLDON_01

16_CPLDON_02

18_M_CPLD_00

20_M_CPLD_01

22_M_CPLD_02

24_M_CPLD_03

26_M_CPLD_04

28_M_CPLD_05

30_M_CPLD_06

32_M_CPLD_07

34_M_CPLD_08

36_M_CPLD_09

38_M_CPLD_10

40_M_CPLD_11

42_M_CPLD_12

44_M_CPLD_13

46_M_CPLD_14

48_M_CPLD_15

50_GND

J1

GND

GND

VCC1P8

VCC1P8

FPGA_3P3V

FPGA_3P3V

I2C_SCL

I2C_SDA

GND

PWR_MAIN

PWR_MAIN

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
51 51_VCC3P3

53_VCC3P3

55_PWR_MAIN

57_PWR_MAIN

59_FPGA_1P8V

61_FPGA_1P8V

63_VCC2P5

65_VCC2P5

67_GND

69_M_FPGA_4A_00

71_M_FPGA_3B_04

73_M_FPGA_3B_02

75_M_FPGA_3B_06

77_M_FPGA_3B_03

79_ESH_JTAG_TDO_SPI_MISO

81_ESH_JTAG_TDI_SPI_MOSI

83_ESH_JTAG_TMS_SPI_CS

85_ESH_JTAG_TCK

87_ESH_FPGA_SPI_CLK

89_ESH_FORCE_STARTUP

91_GND

93_VCC1P1

95_VCC1P1

97_ESH_AUX_VCC

99_ESH_AUX_VCC

52_M_FPGA_4A_05

54_M_FPGA_4A_09

56_M_FPGA_4A_08

58_M_FPGA_4A_04

60_M_FPGA_4A_07

62_M_FPGA_4A_03

64_M_FPGA_4A_02

66_FPGA_2P5V

68_M_FPGA_4A_01

70_M_FPGA_4A_06

72_M_FPGA_3B_00

74_M_FPGA_3B_11

76_M_FPGA_3B_01

78_M_FPGA_3B_10

80_M_FPGA_3B_13

82_M_FPGA_3B_09

84_M_FPGA_3B_12

86_ESH_FPGA_USB_DMINUS

88_ESH_FPGA_USB_DPLUS

90_M_FPGA_3B_05

92_M_FPGA_3B_08

94_M_FPGA_3B_07

96_GND

98_ESH_AUX_VCC

100_ESH_AUX_VCC

J2

ESH_AUX_VCC

ESH_AUX_VCC

GND

ESH_FPGA_USB_DPLUS

ESH_FPGA_USB_DMINUS

FPGA_2P5V

ESH_AUX_VCC

ESH_AUX_VCC

GND

ESH_FORCE_STARTUP

ESH_FPGA_SPI_CLK

ESH_JTAG_TCK

ESH_JTAG_TMS_SPI_CS

ESH_JTAG_TDI_SPI_MOSI

ESH_JTAG_TDO_SPI_MISO

GND

FPGA_1P8V

FPGA_1P8V

PWR_MAIN

PWR_MAIN

VCC3P3

VCC3P3

MAIN_ON

SOLAR_CTRL_SHDN_N

RECHARGE_EN

SOLAR_CTRL_ON_TO_CPLD

SOLAR_PGOOD_TO_CPLD

BAT_LOW_TO_CPLD

BAT_HIGH_TO_CPLD

RTC_ALARM_TO_CPLD

IM_2P5V_TO_CPLD

IM_1P8V_TO_CPLD

MIC_A_CNTRL

MIC_B_CNTRL

SDCARD_CNTRL_TO_CPLD

MRAM_CNTRL_TO_CPLD

GPS_CNTRL_TO_CPLD

DATA_TX_CNTRL_TO_CPLD

MRAM_CS_N_TO_FPGA

MRAM_SO_TO_FPGA

MRAM_WP_N_TO_FPGA

MRAM_SCK_TO_FPGA

MRAM_SI_TO_FPGA

TXRX_CS_N_TO_FPGA

TXRX_MISO_TO_FPGA

TXRX_MOSI_TO_FPGA

TXRX_SCLK_TO_FPGA

TXRX_GPIO3_TO_FPGA_CPLD

IM_SPI_SCLK_TO_FPGA

IM_SPI_SDI_TO_FPGA

IM_SDO_A_G_TO_FPGA

IM_SDO_M_TO_FPGA

IM_CS_A_G_TO_FPGA

IM_CS_M_TO_FPGA

IM_DRDY_M_TO_FPGA

IM_INT_M_TO_FPGA

IM_INT1_A_G_TO_FPGA

IM_INT2_A_G_TO_FPGA

SDCARD_DI_DAT2_TO_FPGA

SDCARD_DI_CD_DAT3_TO_FPGA

SDCARD_DI_CMD_TO_FPGA

SDCARD_DI_CLK_TO_FPGA

SDCARD_DI_DAT0_TO_FPGA

SDCARD_DI_DAT1_TO_FPGA

MIC_CLK_TO_FPGA

MIC_A_DATA_TO_FPGA

MIC_B_DATA_TO_FPGA

EXTINT_GPS_TO_FPGA

TIMEPULSE_GPS_TO_FPGA

RXD_GPS_TO_FPGA

TXD_GPS_TO_FPGA

BATT_GD_N_TO_CPLD

12 | 12 | 07/01/15

# BOARD CONNECTOR

DROP_CTRL_TO_CPLD
