rksnider/SensorCollar/PCB_Designs/MCollar_v1/0Schematic/MCollar_MAIN_v1_Final.pdf

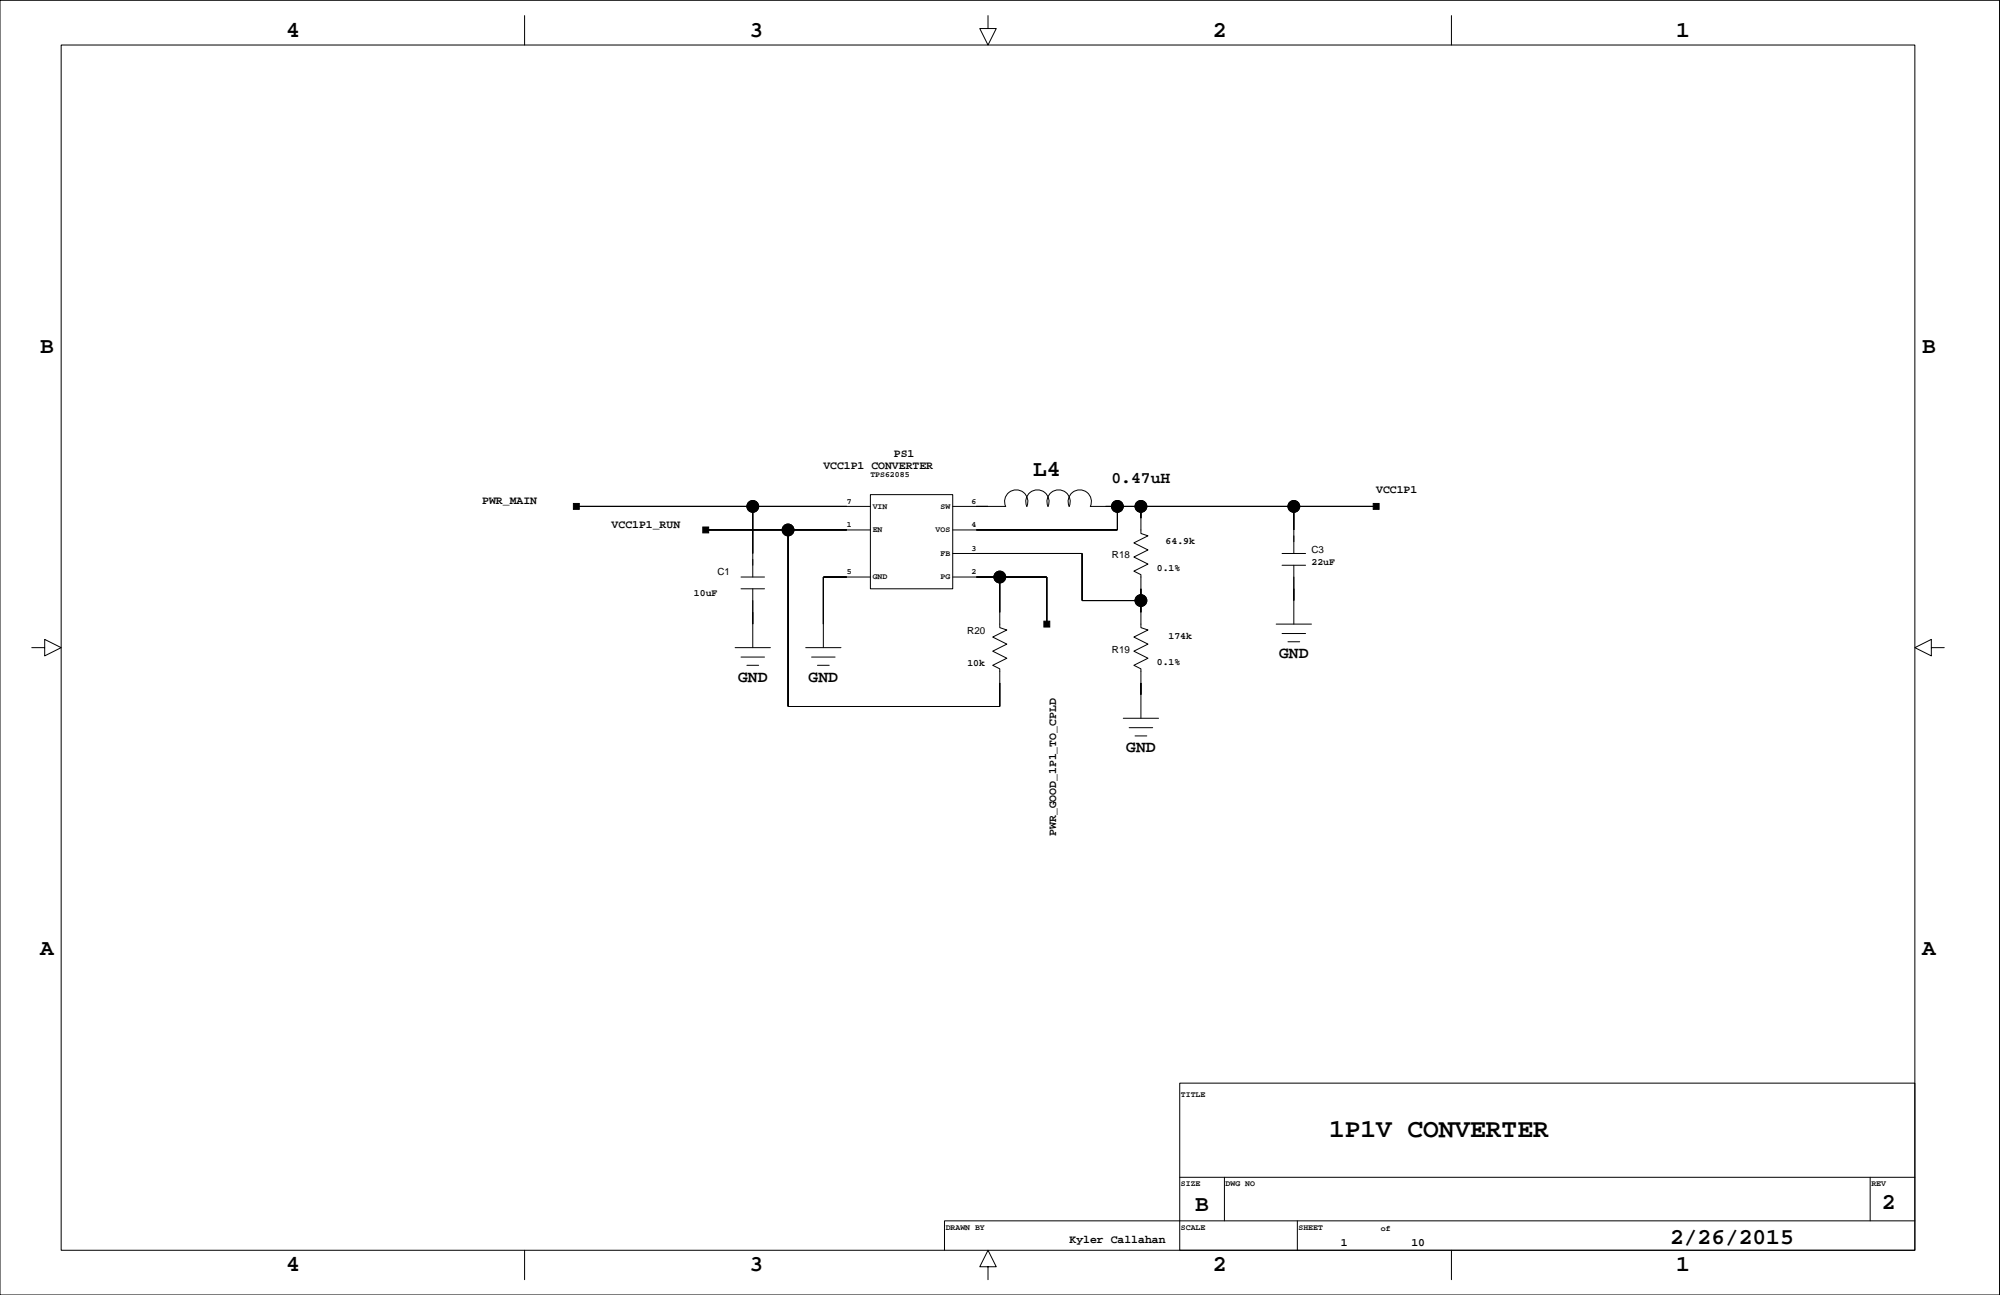
[picture p201: page 1]
VOS; VIN; GND; VCC1P1; VCC1P1 CONVERTER TPS62085; VCC1P1_RUN; PWR_GOOD_1P1_TO_CPLD; PWR_MAIN; REV; TITLE; SCALE; SIZE; DWG NO; SHEET; DRAWN BY; Kyler Callahan; 1P1V CONVERTER

## BUCK_PWM_TO_CPLD

# GND

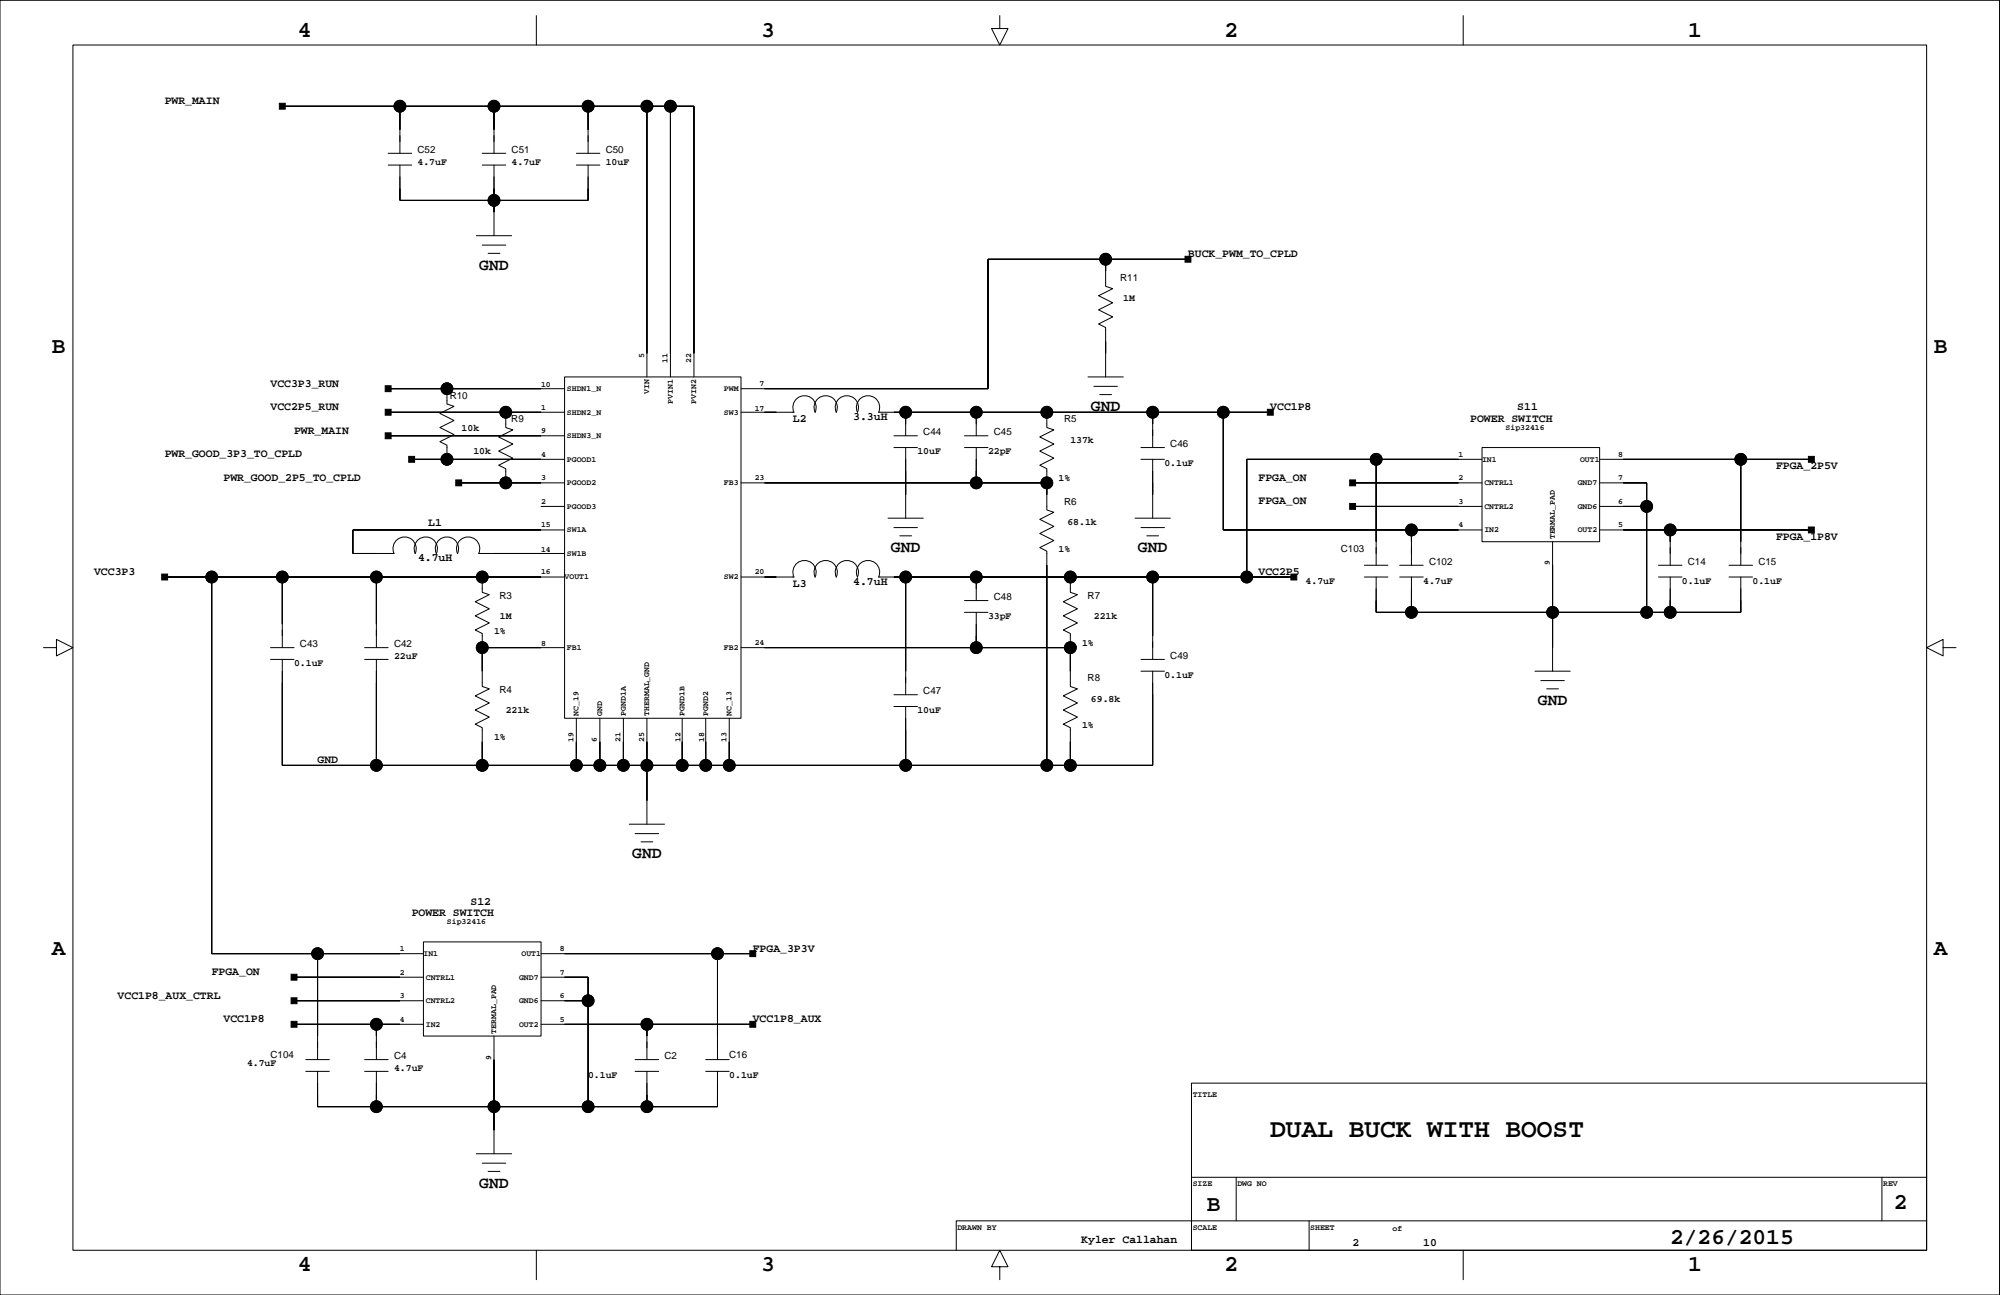
[picture p202: page 2]

TITLE
DUAL BUCK WITH BOOST

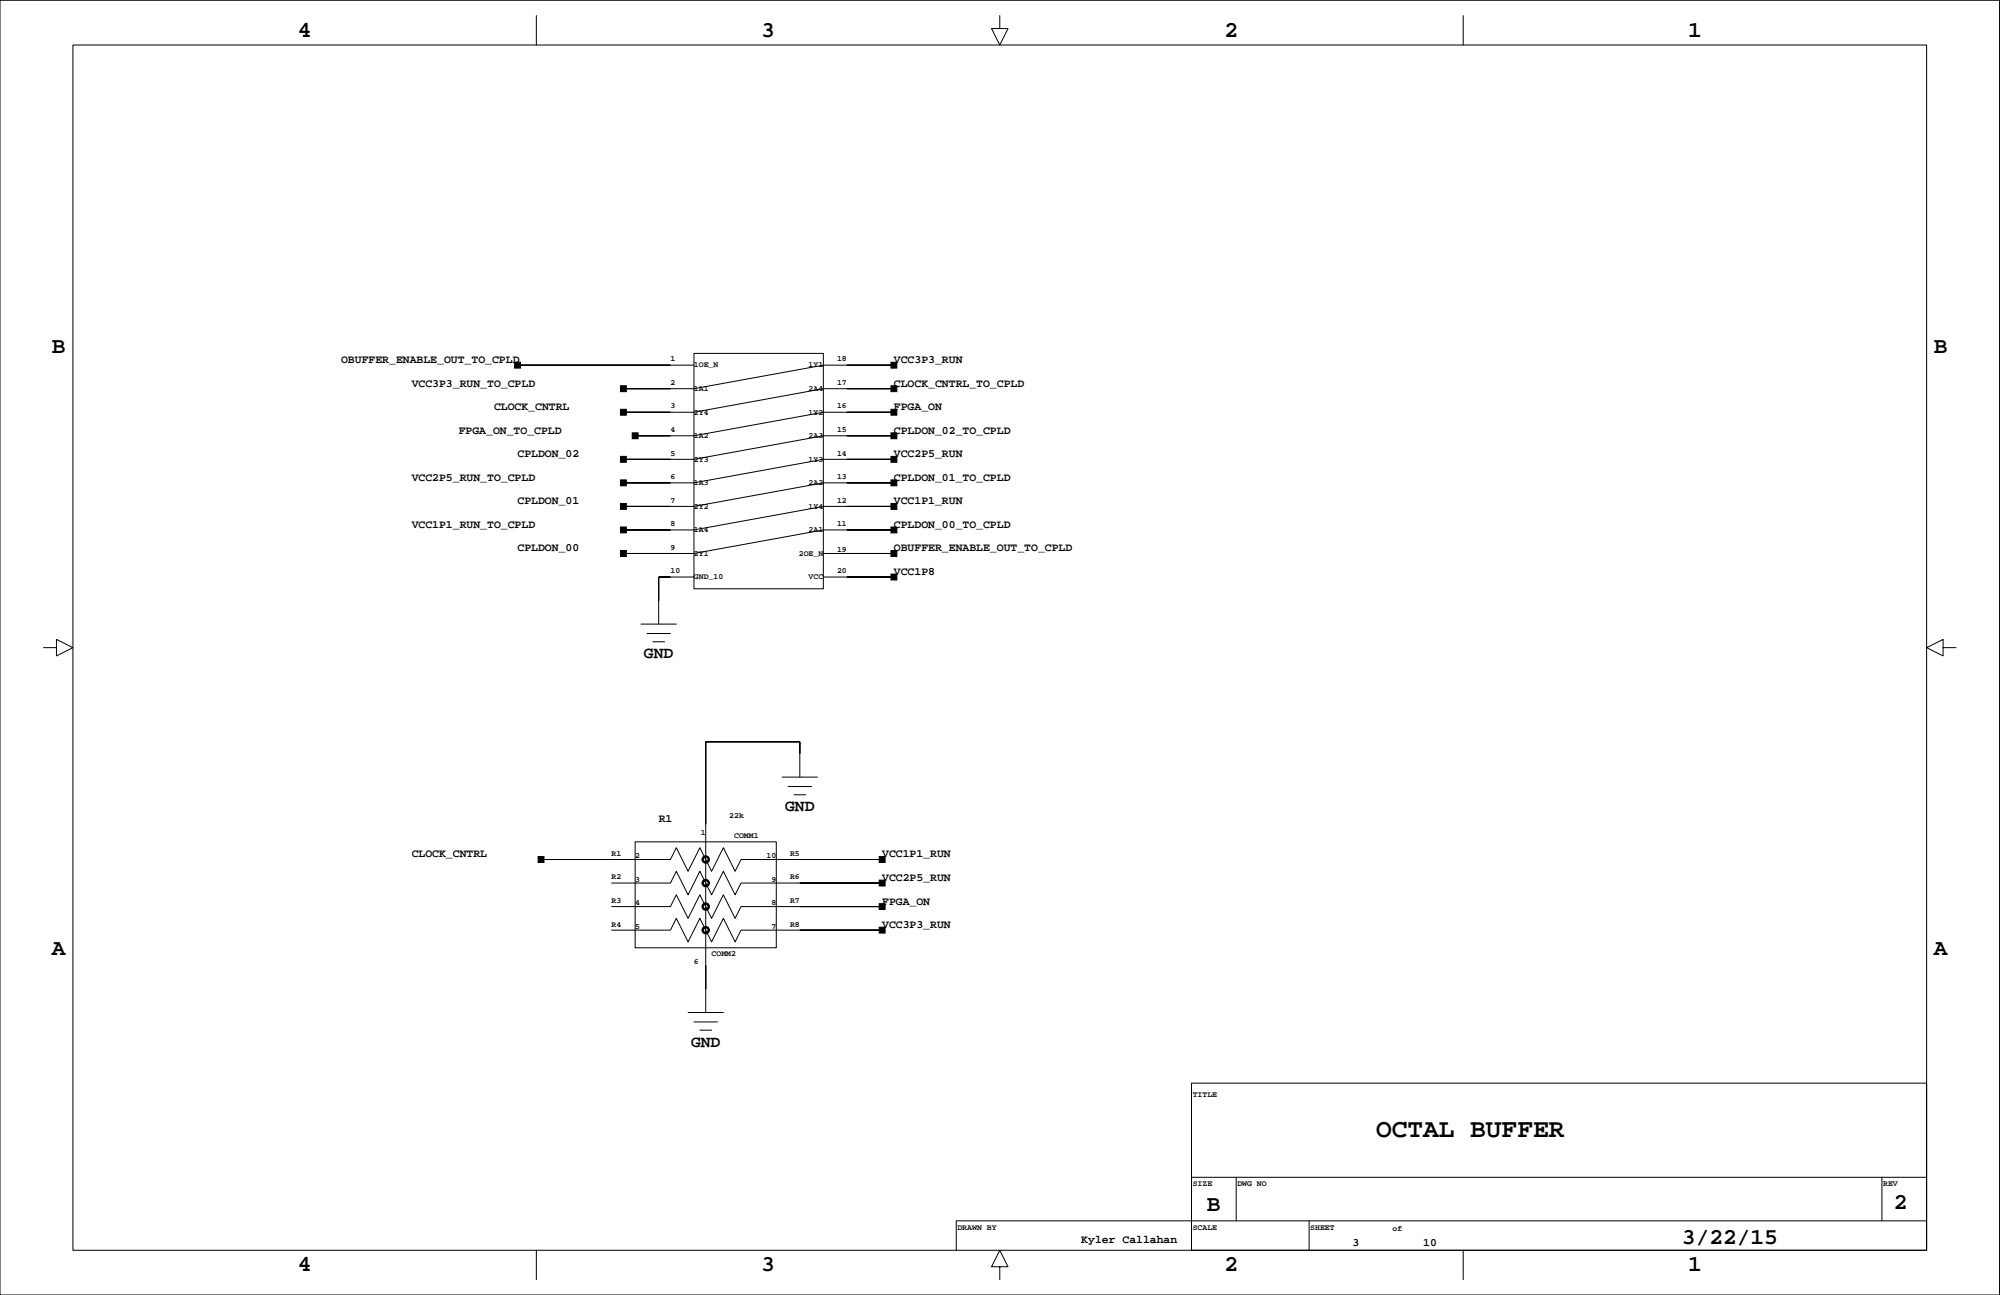
[picture p203: page 3]

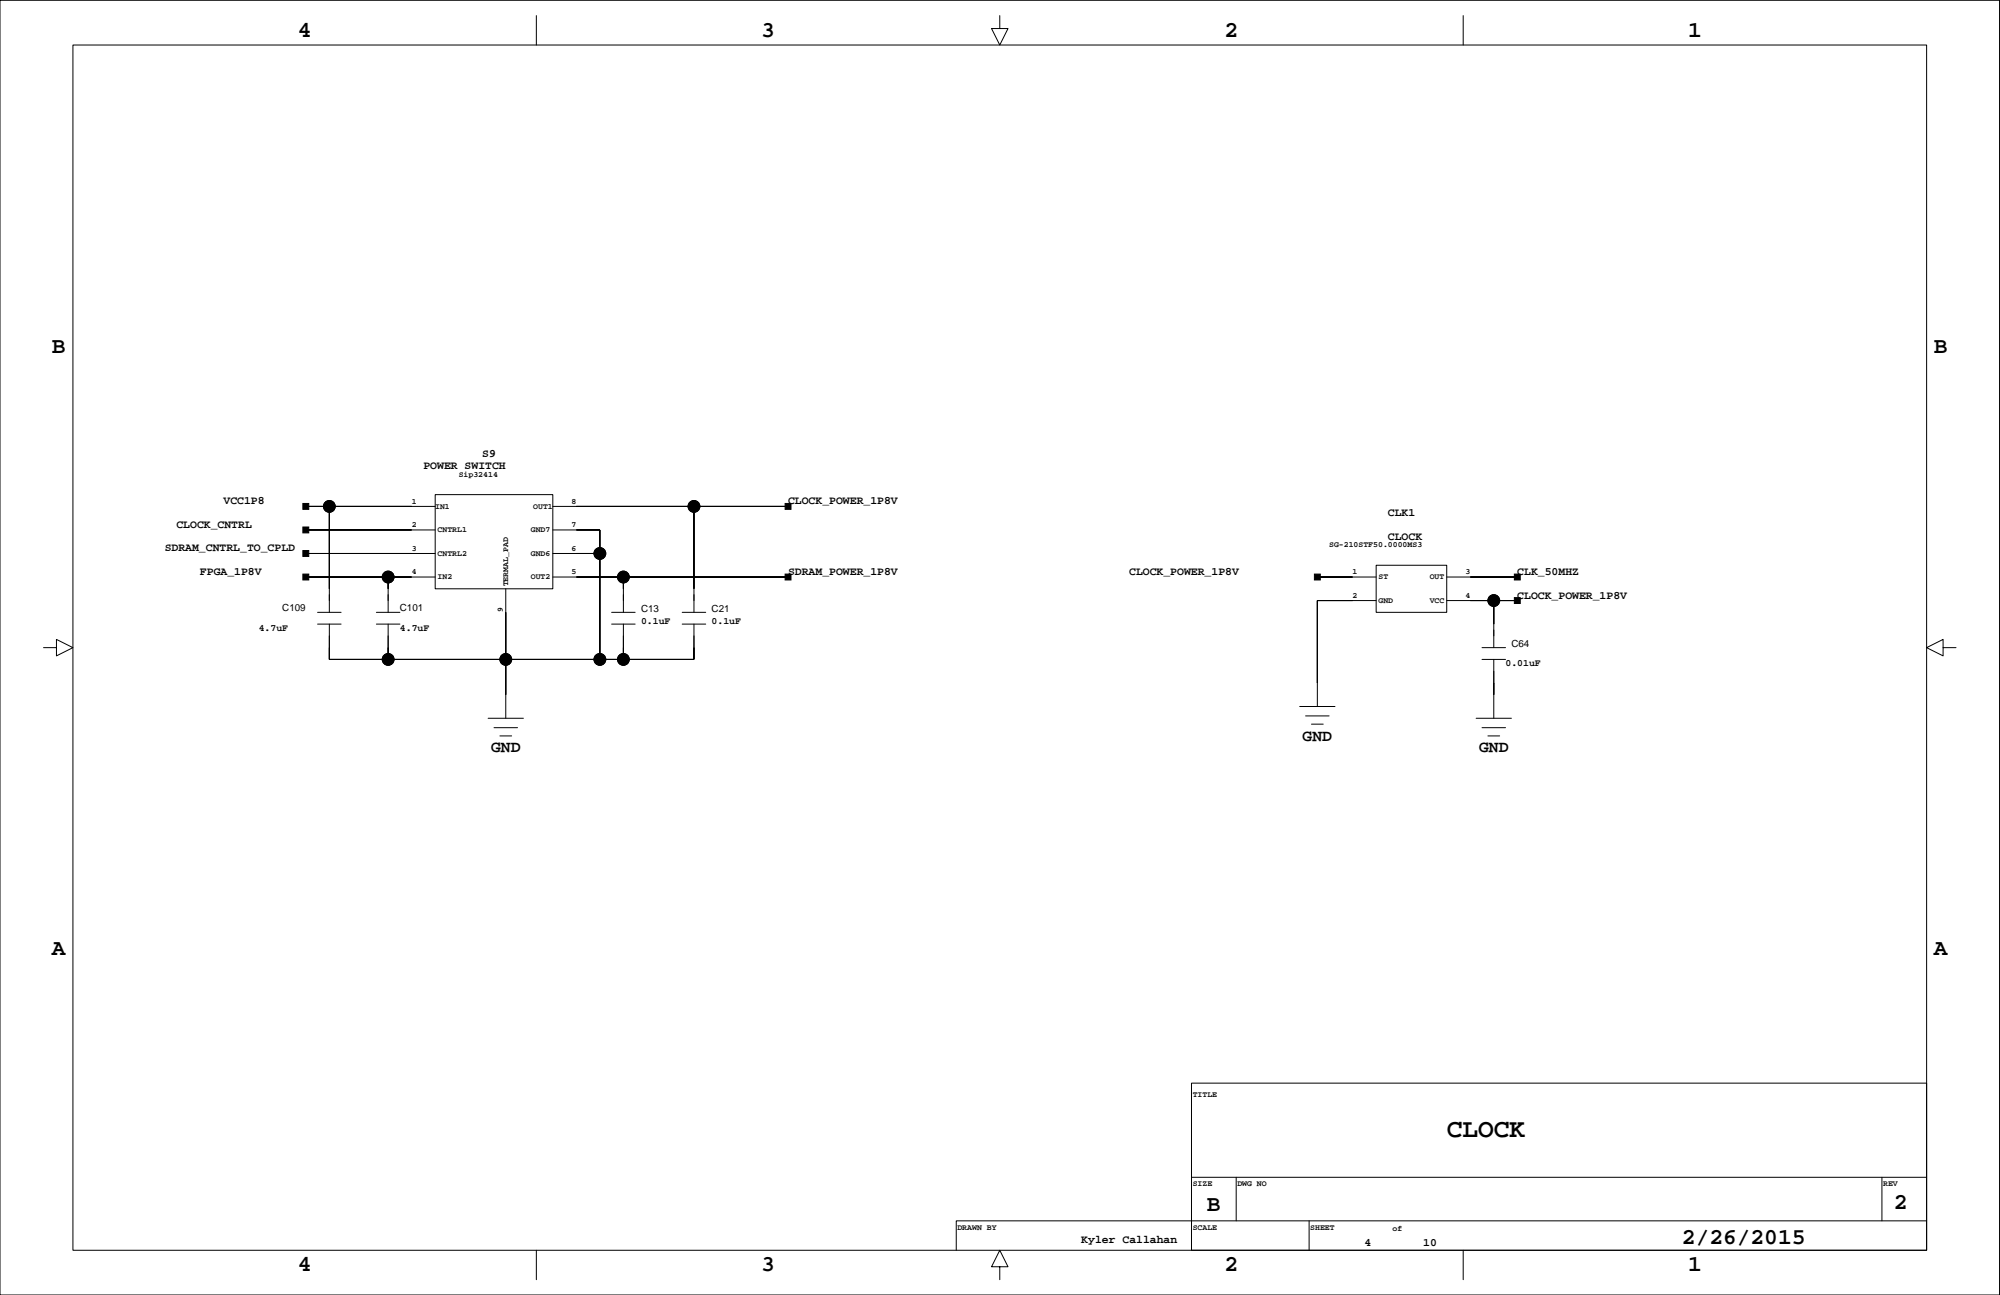
[picture p204: page 4]
CLK1; GND; OUT; VCC; CLOCK_POWER_1P8V; CLK_50MHZ; CNTRL1; CNTRL2; OUT1; GND7; GND6; OUT2; TERMAL_PAD; CLOCK_CNTRL; VCC1P8; Sip32414; SG-210STF50.0000MS3; POWER SWITCH; CLOCK; TITLE; Kyler Callahan; SDRAM_CNTRL_TO_CPLD; FPGA_1P8V; SDRAM_POWER_1P8V

## FLASH_DQ2

## FLASH_DQ1

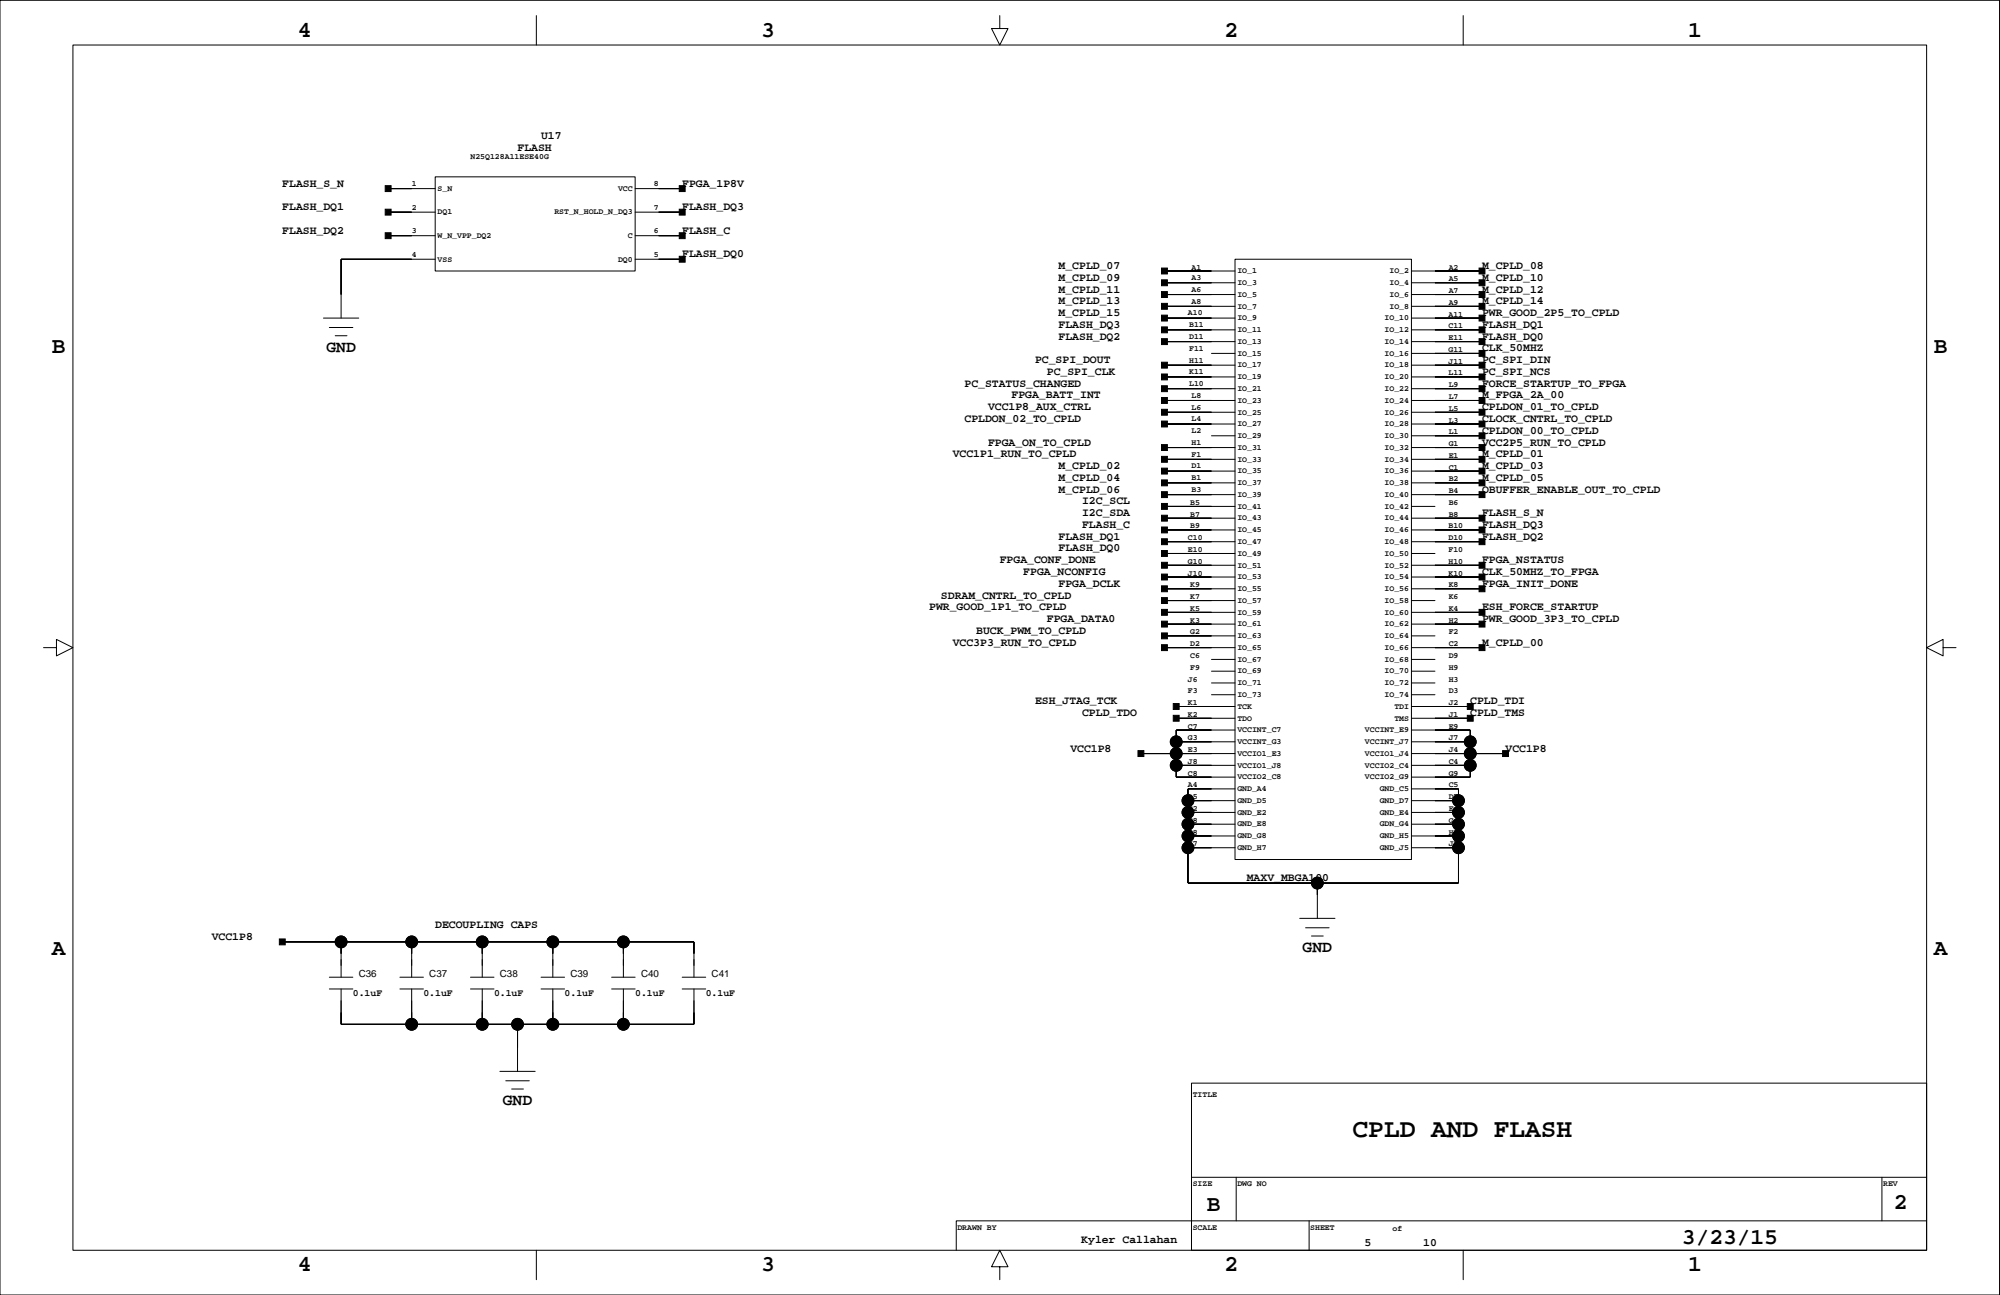
[picture p205: page 5]

U3

U3

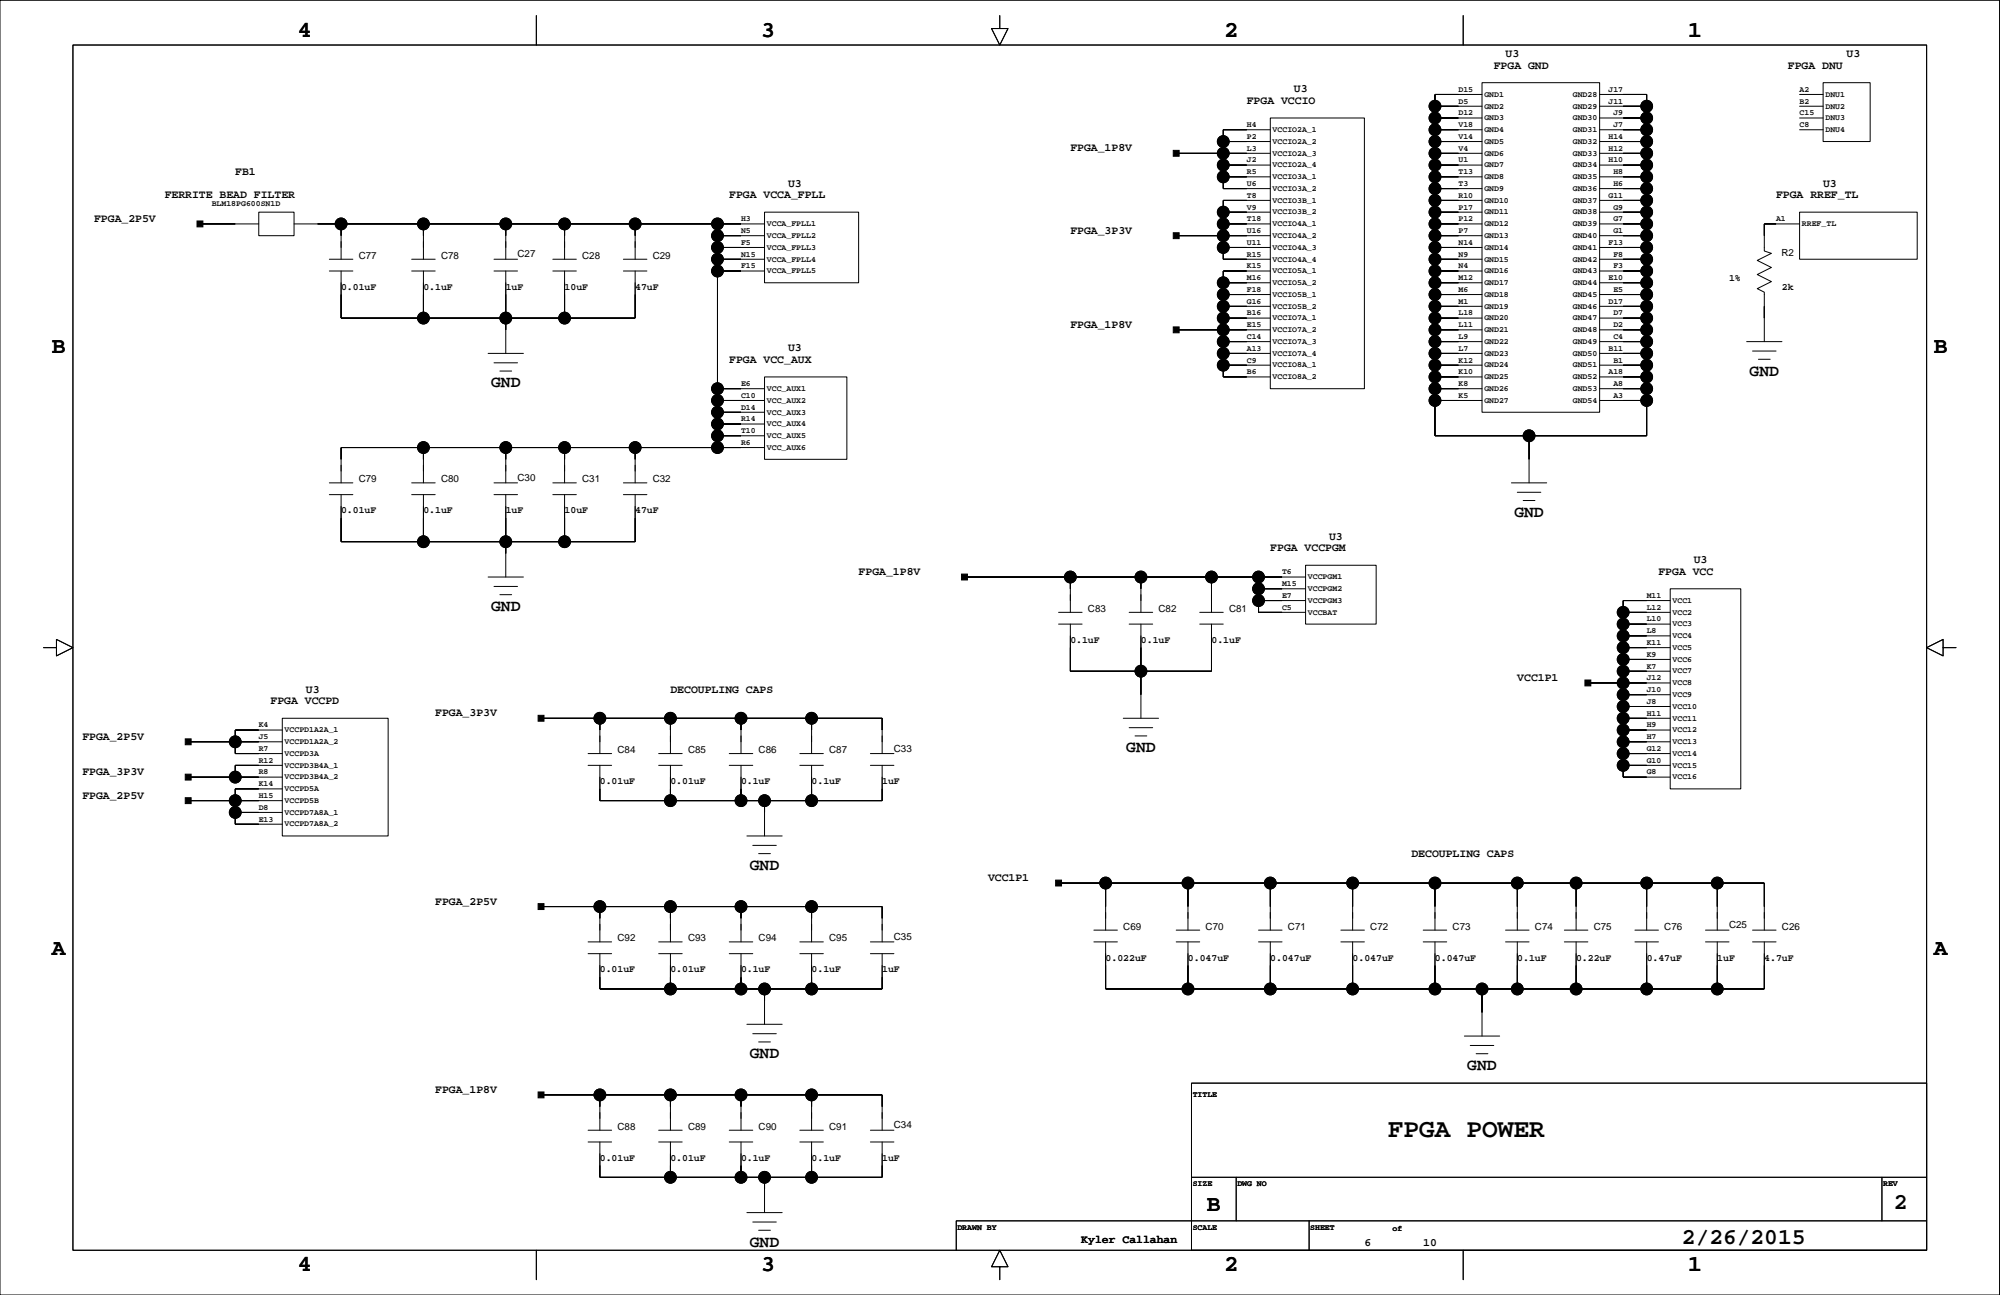
[picture p206: page 6]

U3

U3

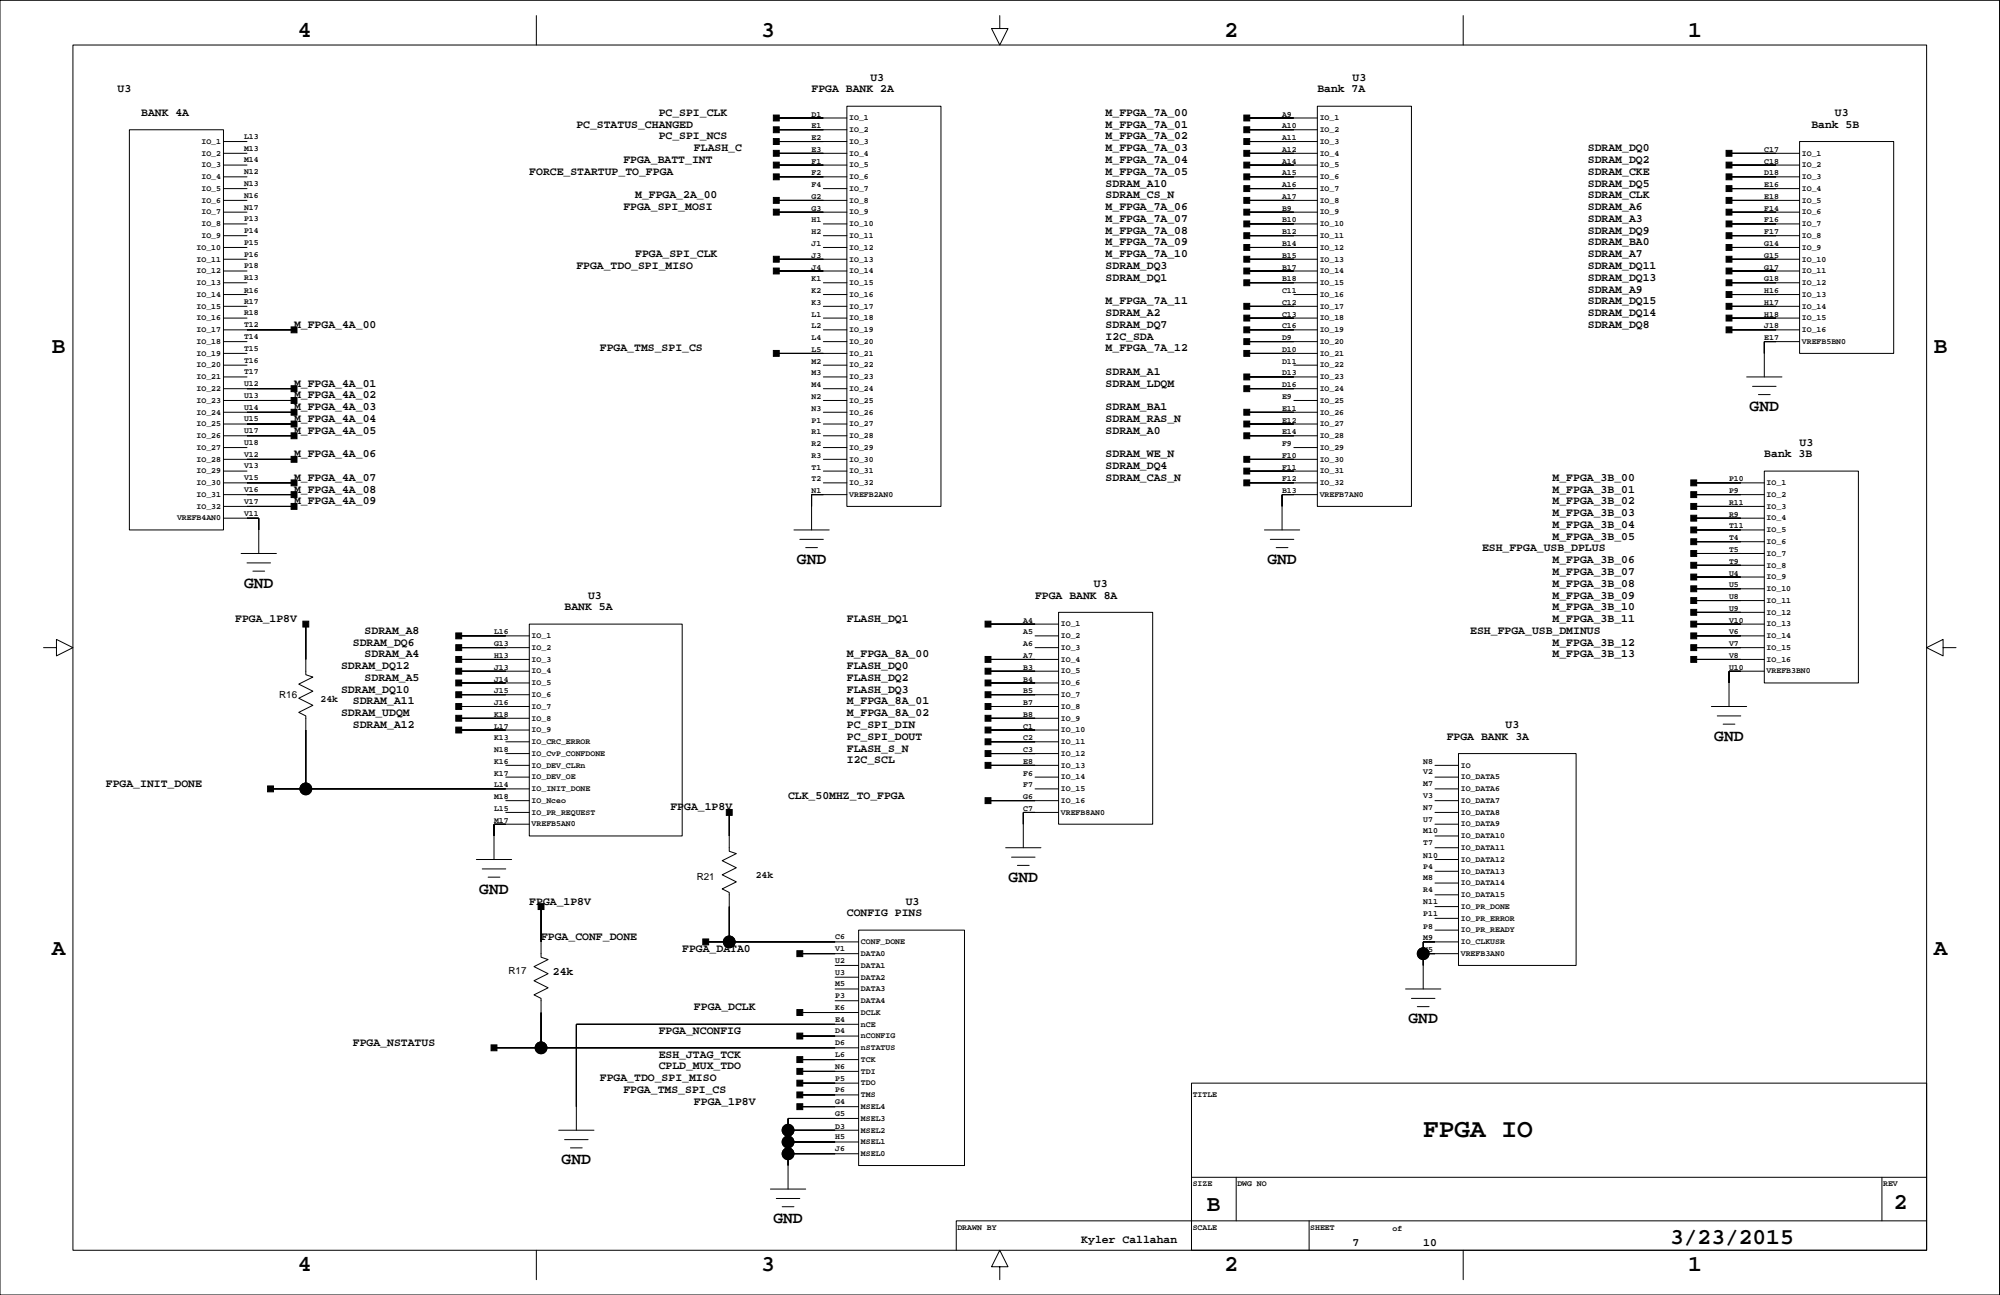
[picture p207: page 7]

U9

## SD RAM

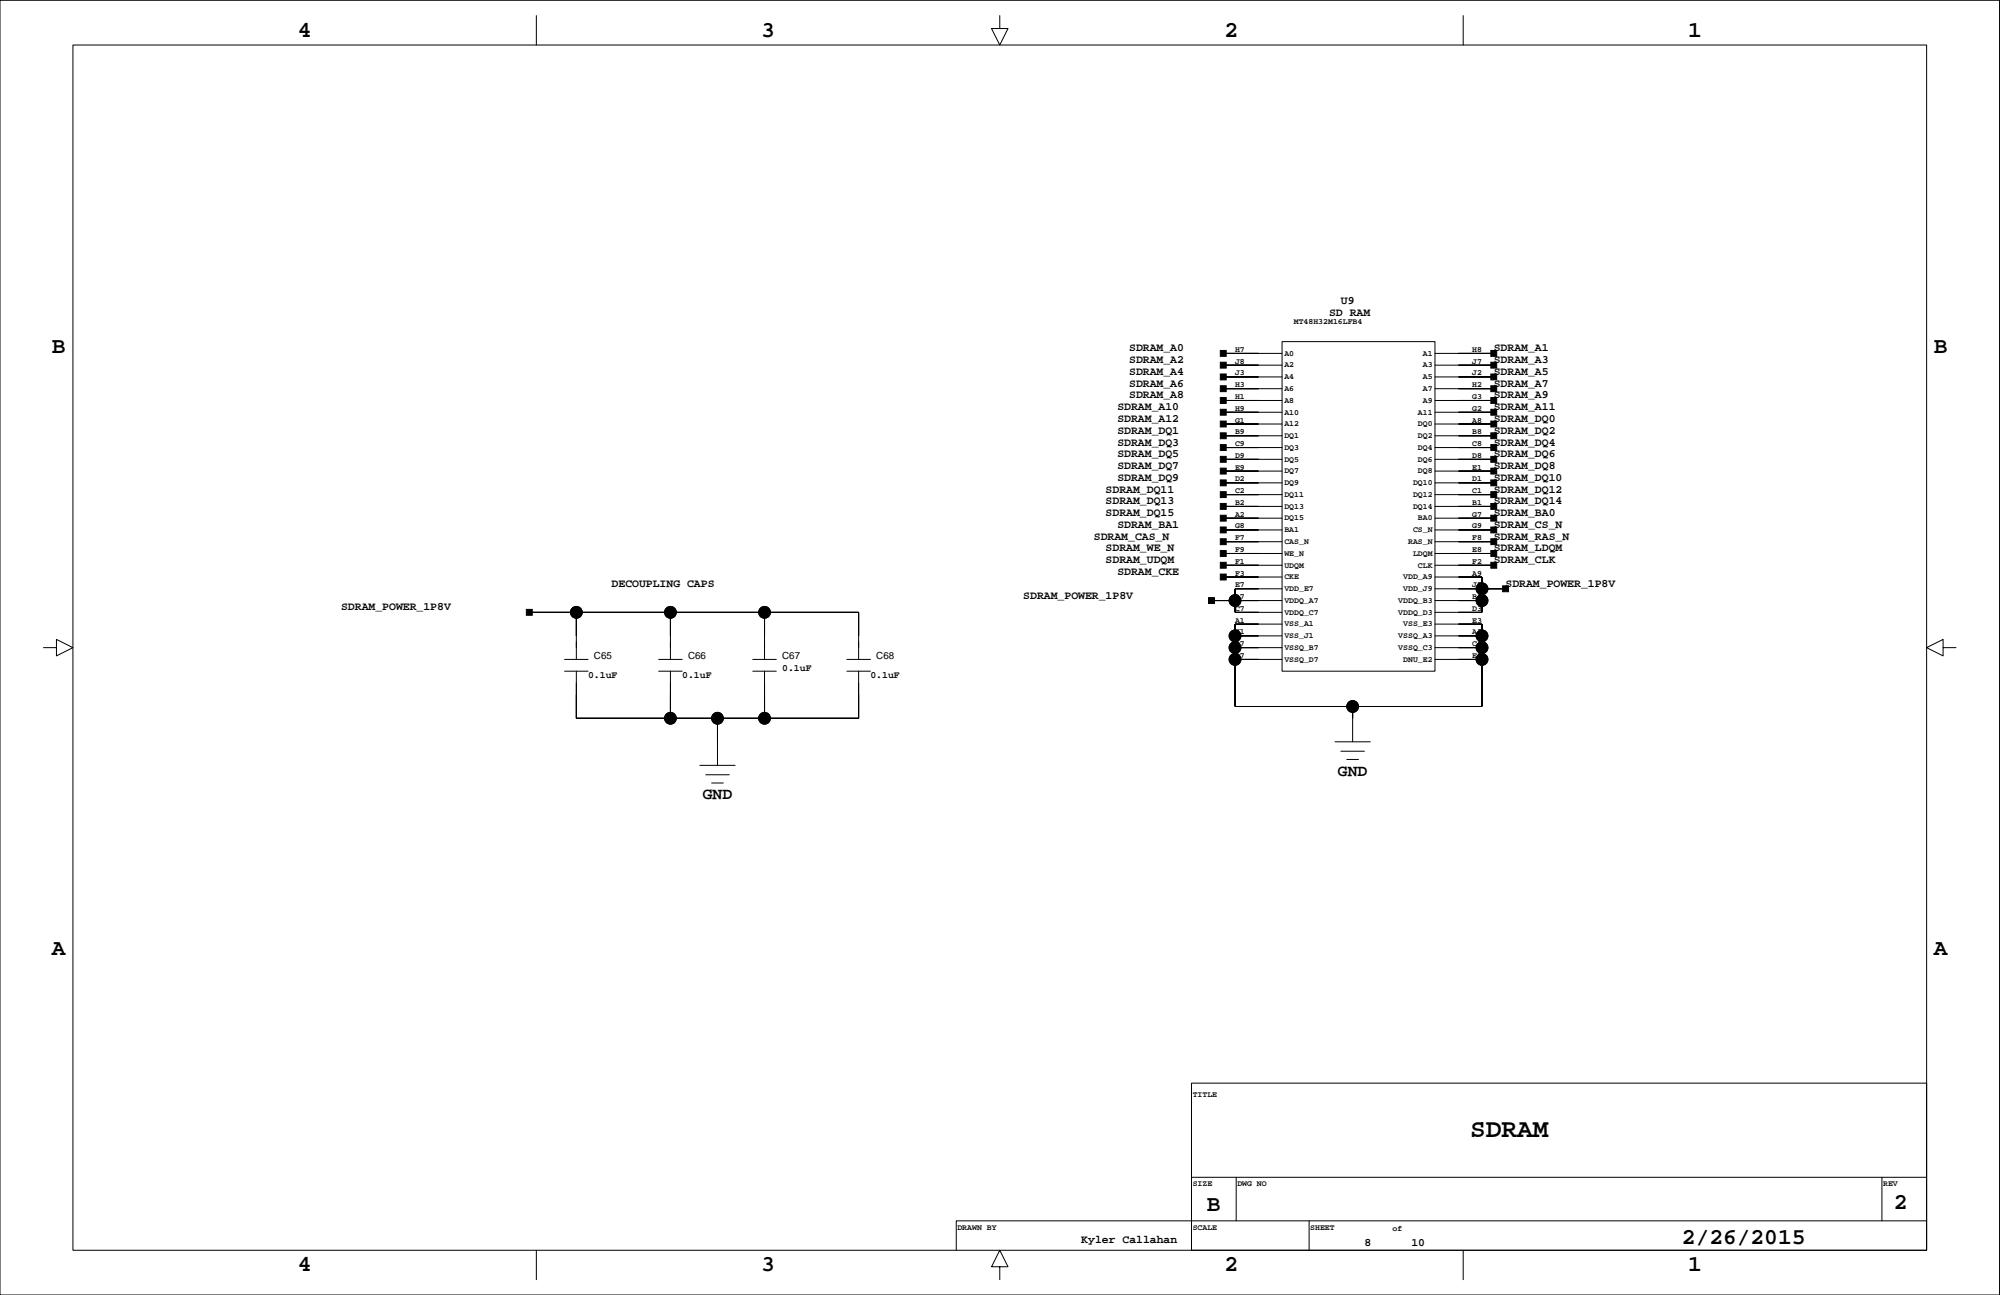
[picture p208: page 8]

## 10 PIN uUSB3P0 HEADER

## ESH_FPGA_USB_DMINUS

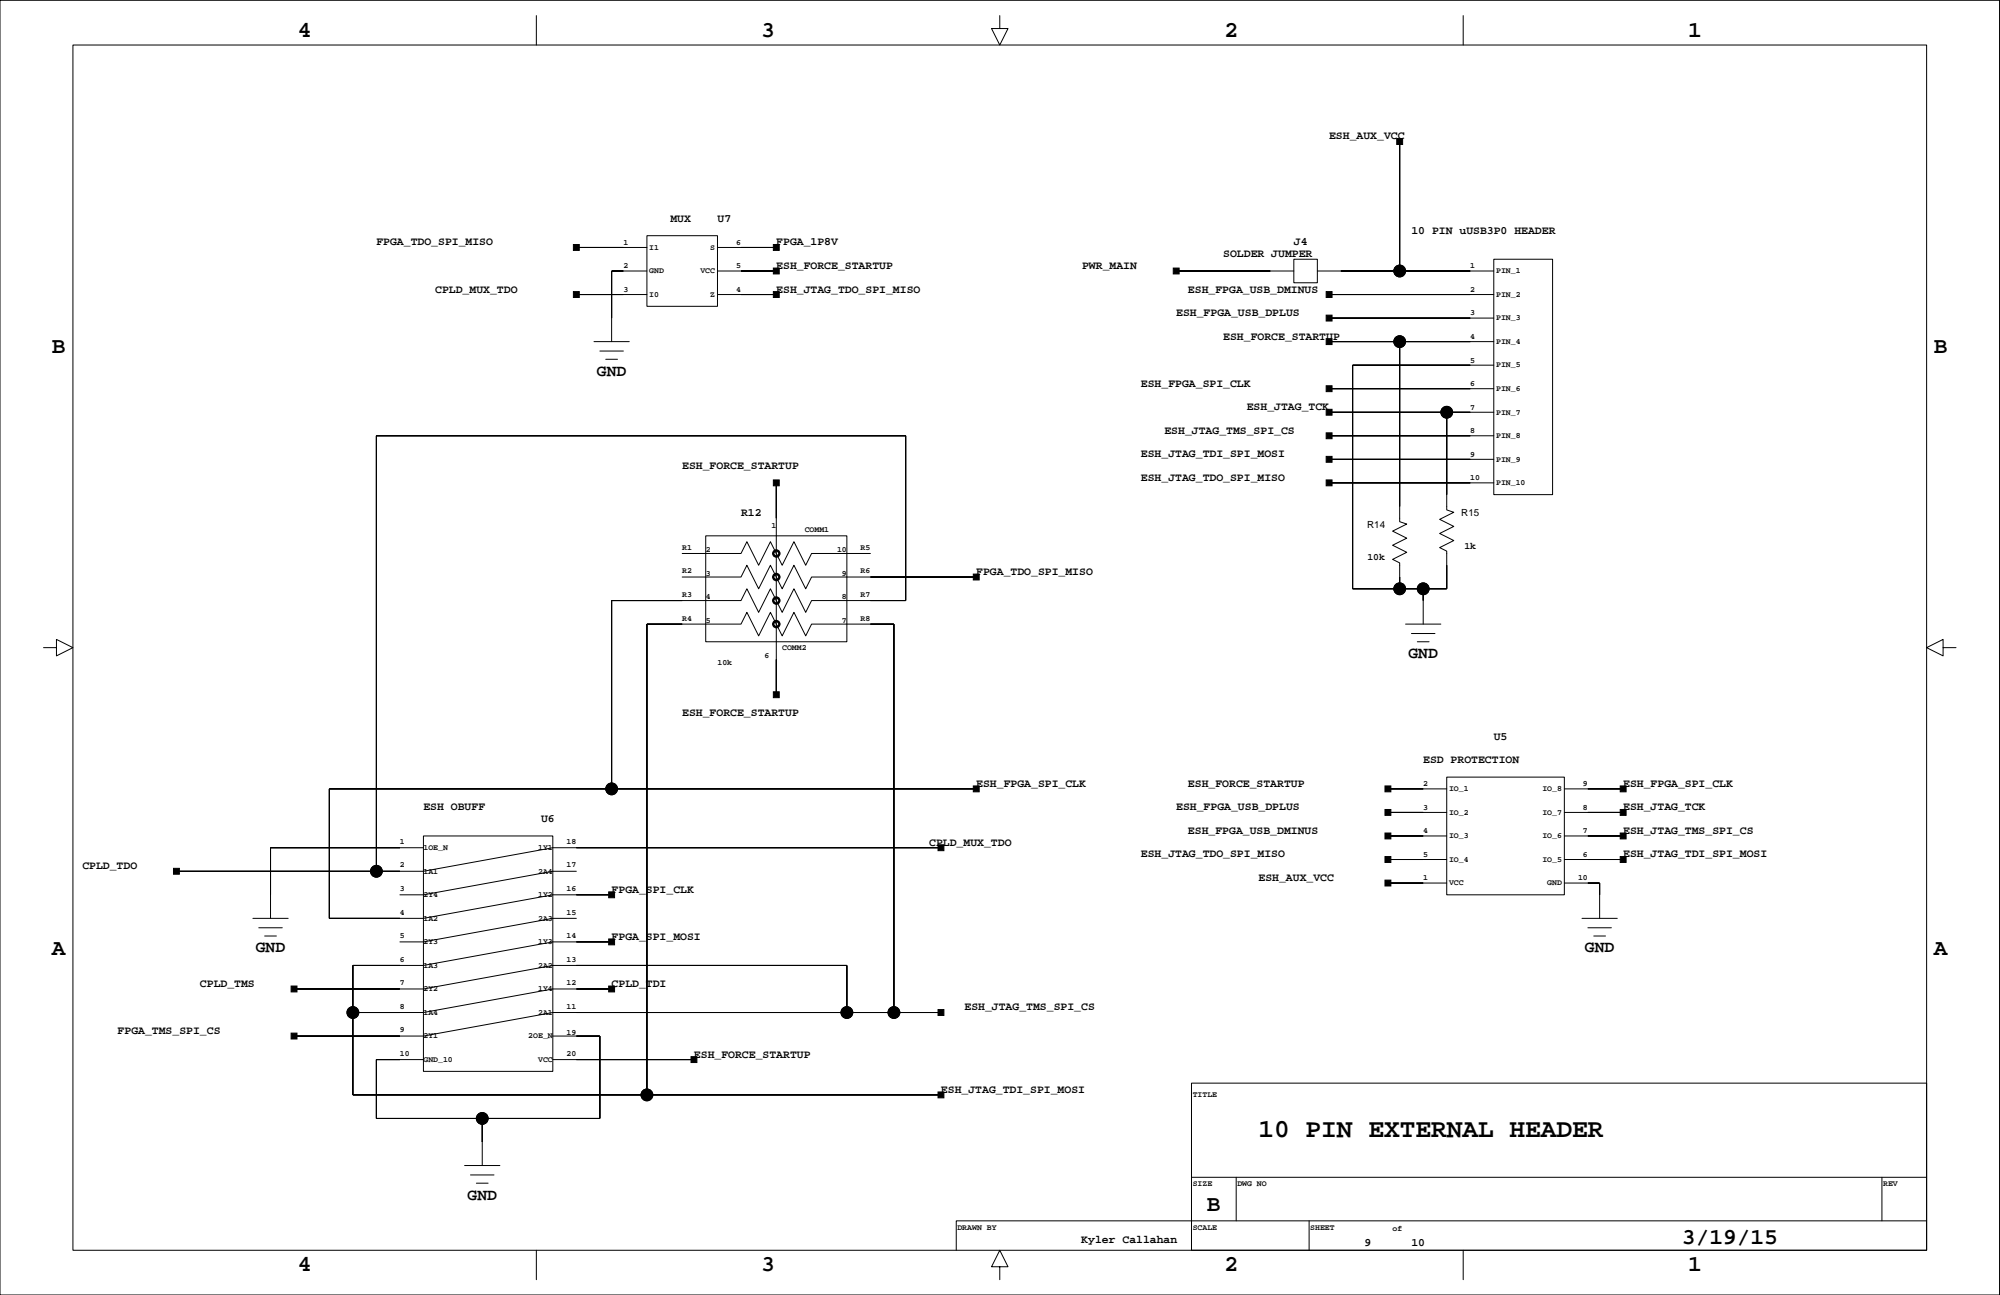
[picture p209: page 9]

J1

J2

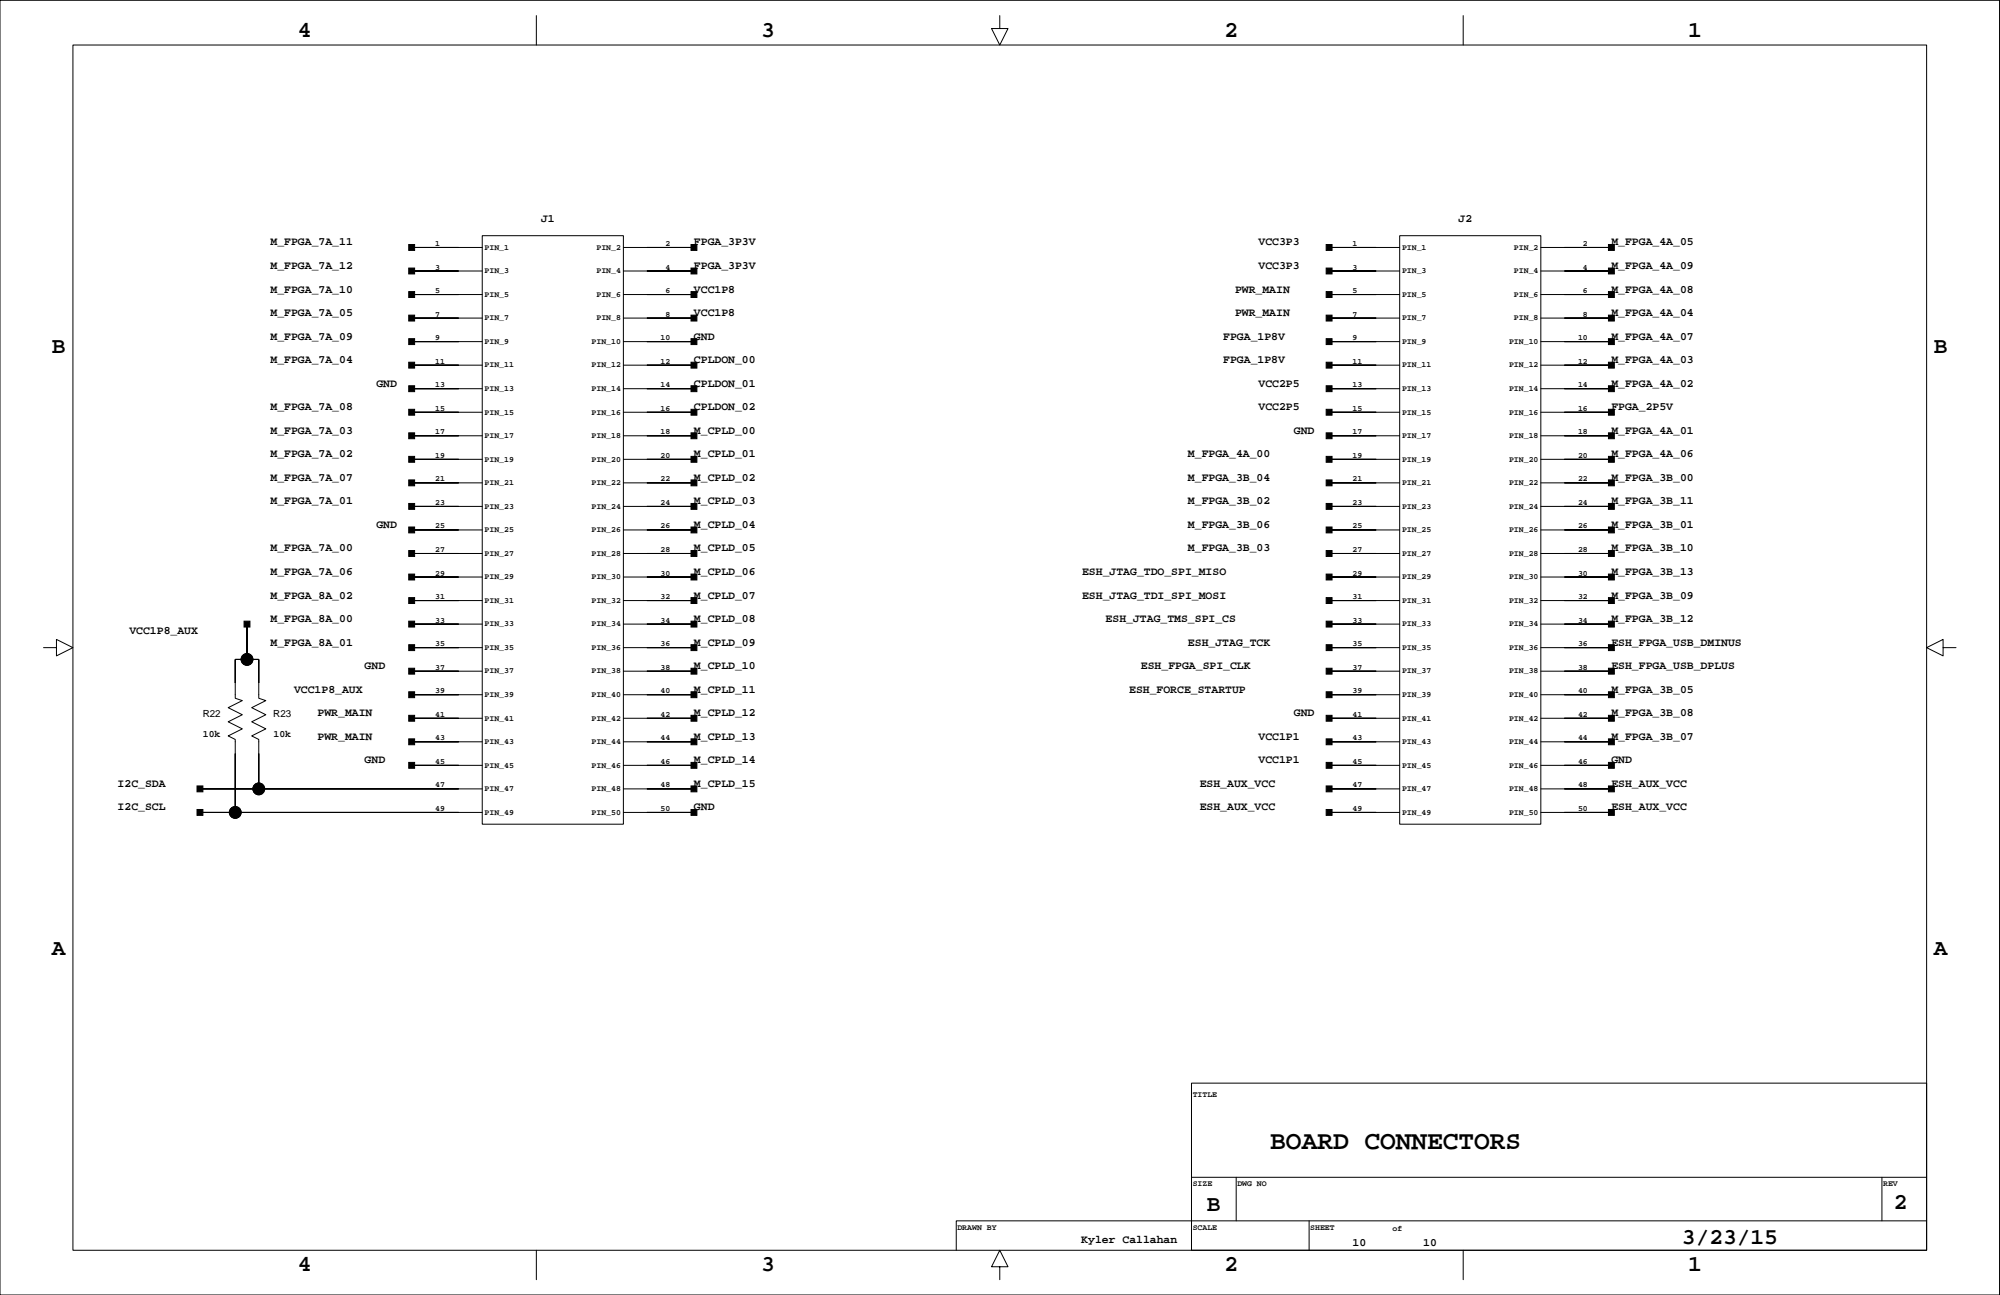
[picture p210: page 10]
TITLE; Kyler Callahan; BOARD CONNECTORS; PIN_1; PIN_3; PIN_5; PIN_7; PIN_9; PIN_11; PIN_13; PIN_15; PIN_17; PIN_19; PIN_21; PIN_23; PIN_25; PIN_27; PIN_29; PIN_31; PIN_33 33; PIN_35 35; PIN_37 37; PIN_39 39; PIN_41 41; PIN_43 43; PIN_45 45; PIN_47 47; PIN_49 49; PIN_2; PIN_4; PIN_6; PIN_8; PIN_10; PIN_12; PIN_14; PIN_16; PIN_18; PIN_20; PIN_22; PIN_24; PIN_26; PIN_28; PIN_30; PIN_32; PIN_34; PIN_36; PIN_38; PIN_40; PIN_42; PIN_44; PIN_46; PIN_48; PIN_50; PIN_1 1; PIN_3 3; PIN_33; PIN_35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
