rksnider/SensorCollar/PCB_Designs/Interface_Board/0Schematic/Interface Board/Interface Board.pdf

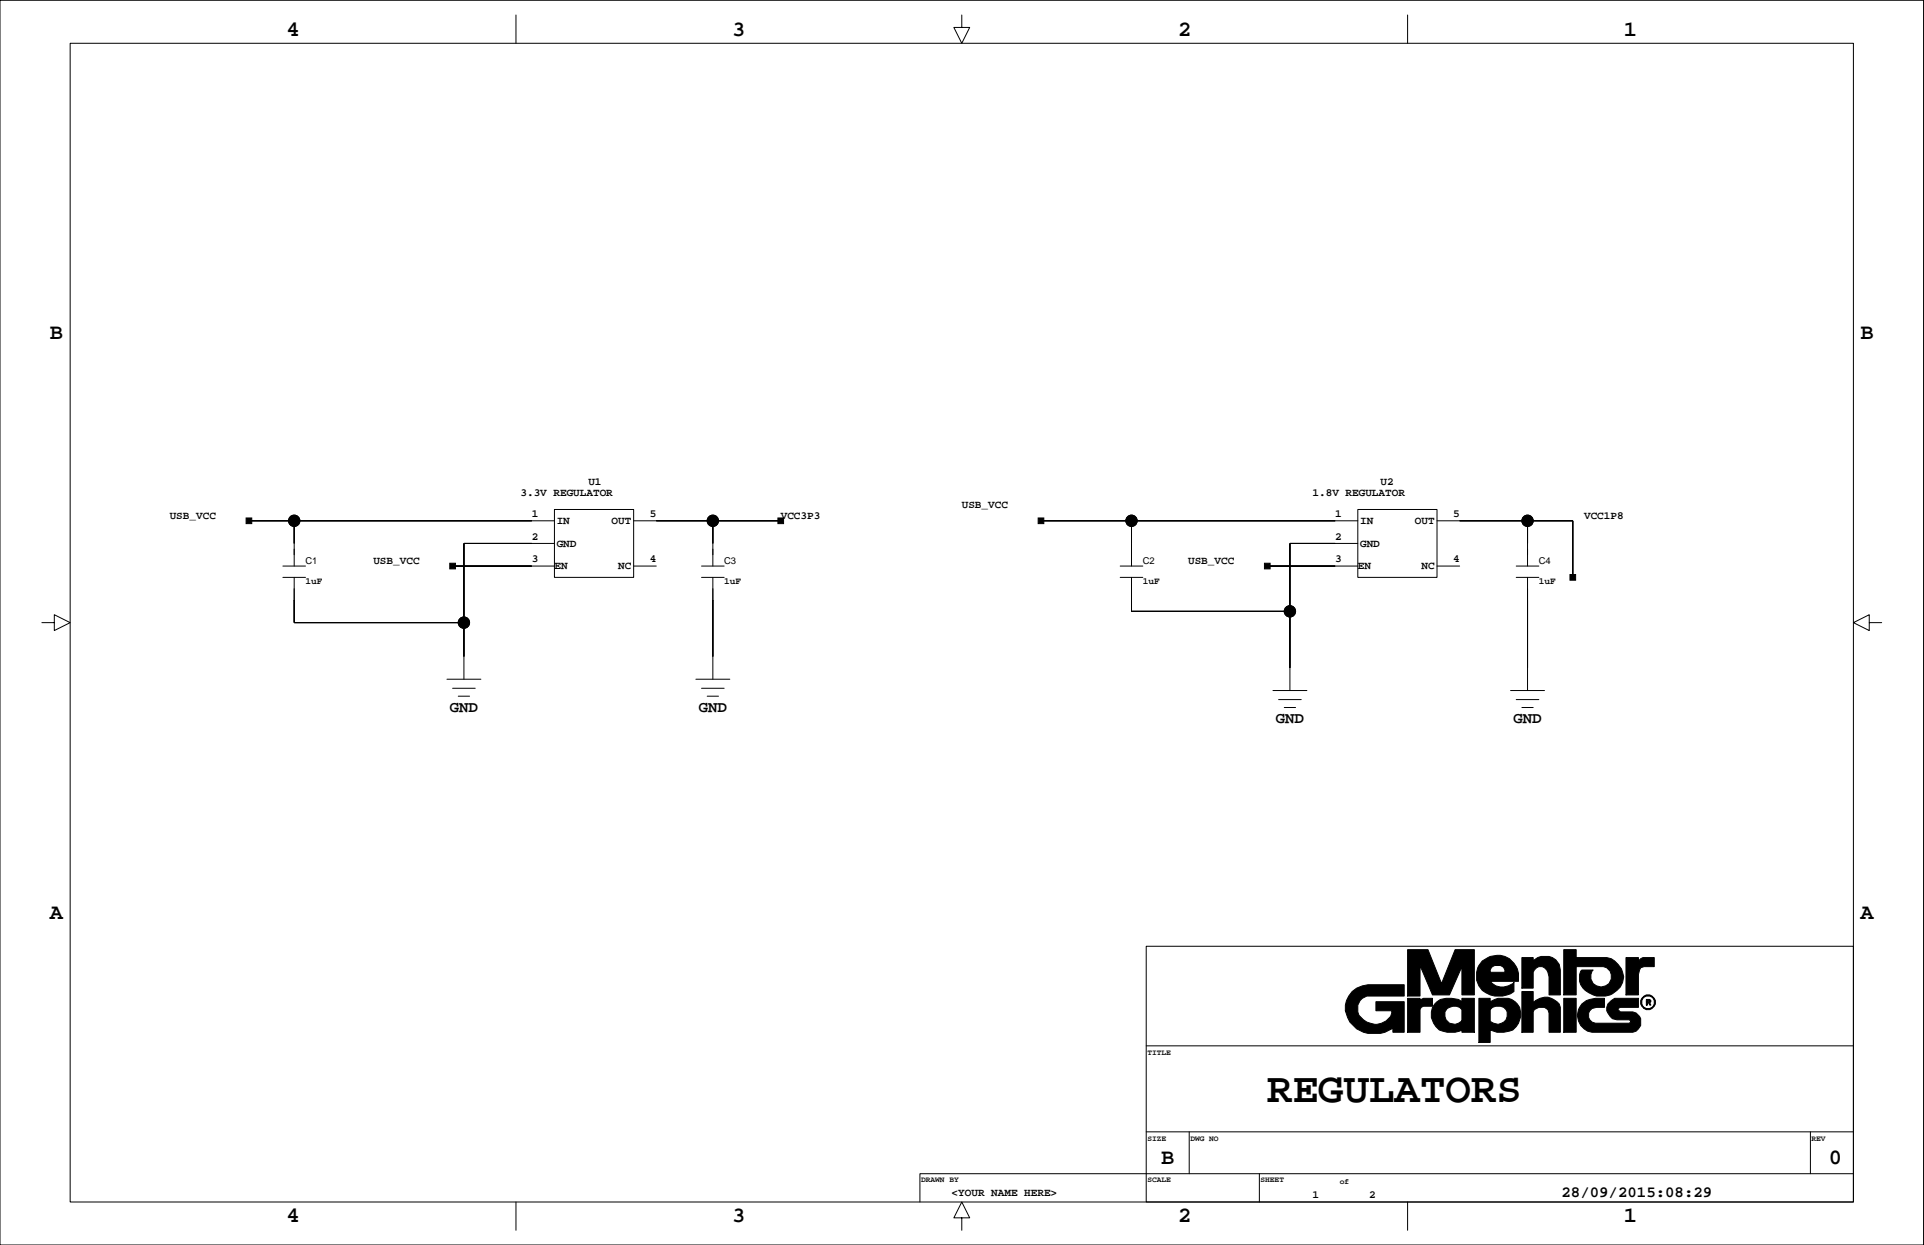
[picture p211: page 1]
REV; TITLE; SCALE; SIZE; DWG NO; SHEET; DRAWN BY; <YOUR NAME HERE>; GND; USB_VCC; VCC1P8; OUT; VCC3P3; 3.3V REGULATOR; 1.8V REGULATOR; REGULATORS

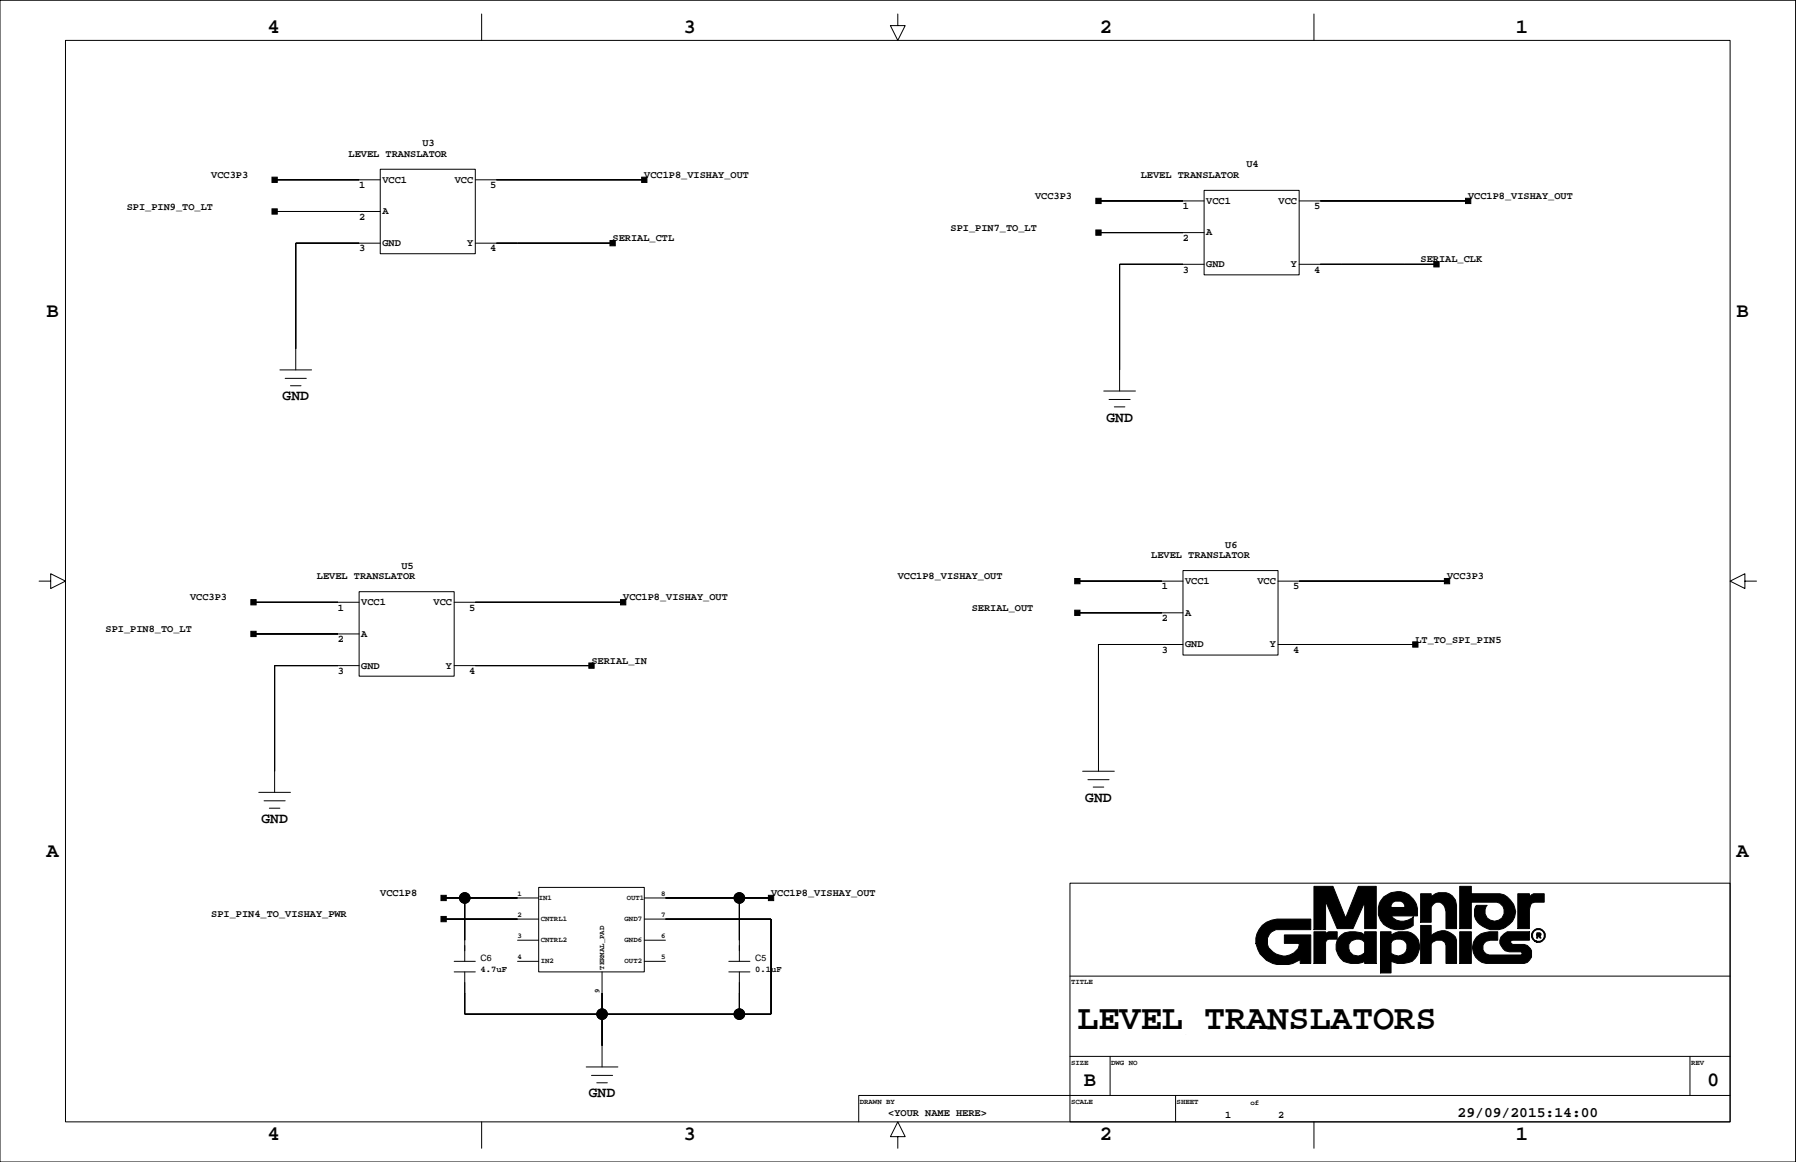
[picture p212: page 2]
VCC1; GND; VCC; U3 LEVEL TRANSLATOR; LEVEL TRANSLATOR; U5 LEVEL TRANSLATOR; U6 LEVEL TRANSLATOR; VCC3P3; VCC1P8_VISHAY_OUT; SERIAL_CLK; SERIAL_CTL; SERIAL_IN; SERIAL_OUT; TITLE; SPI_PIN9_TO_LT; SPI_PIN7_TO_LT; LT_TO_SPI_PIN5; SPI_PIN8_TO_LT; LEVEL TRANSLATORS; CNTRL1; CNTRL2; OUT1; GND7; GND6; OUT2; TERMAL_PAD; VCC1P8; SPI_PIN4_TO_VISHAY_PWR

<YOUR NAME HERE>

TITLE; GND; VCCA; VCCB; VCC1P8; VCC3P3; I2C LEVEL TRANSLATOR

I2C Bus Voltage Translator


VBUS; GND; USB DATA; SERIAL_DMINUS; USB_VCC; TERM_1; TERM_3; SWITCH_TO_FS; VCC1P8; USB PWR; SERIAL_DPLUS

SPST SLIDE SWITCH

TITLE
USB AND SWITCH

TITLE; <YOUR NAME HERE>; ESD PROTECTION.; GND; ESD PROTECTOR; USB_VCC; VCC1P8; SERIAL_CLK; SERIAL_CTL; SERIAL_OUT; SERIAL_IN; LT_TO_SPI_PIN5; SPI_PIN7_TO_LT; SPI_PIN9_TO_LT; SPI_PIN8_TO_LT
