rksnider/SensorCollar/PCB_Designs/DevBoard_PowerMonitor/0Schematic/DevBoard_PowerMonitor/DevBoard_PowerMonitor.pdf

## GND

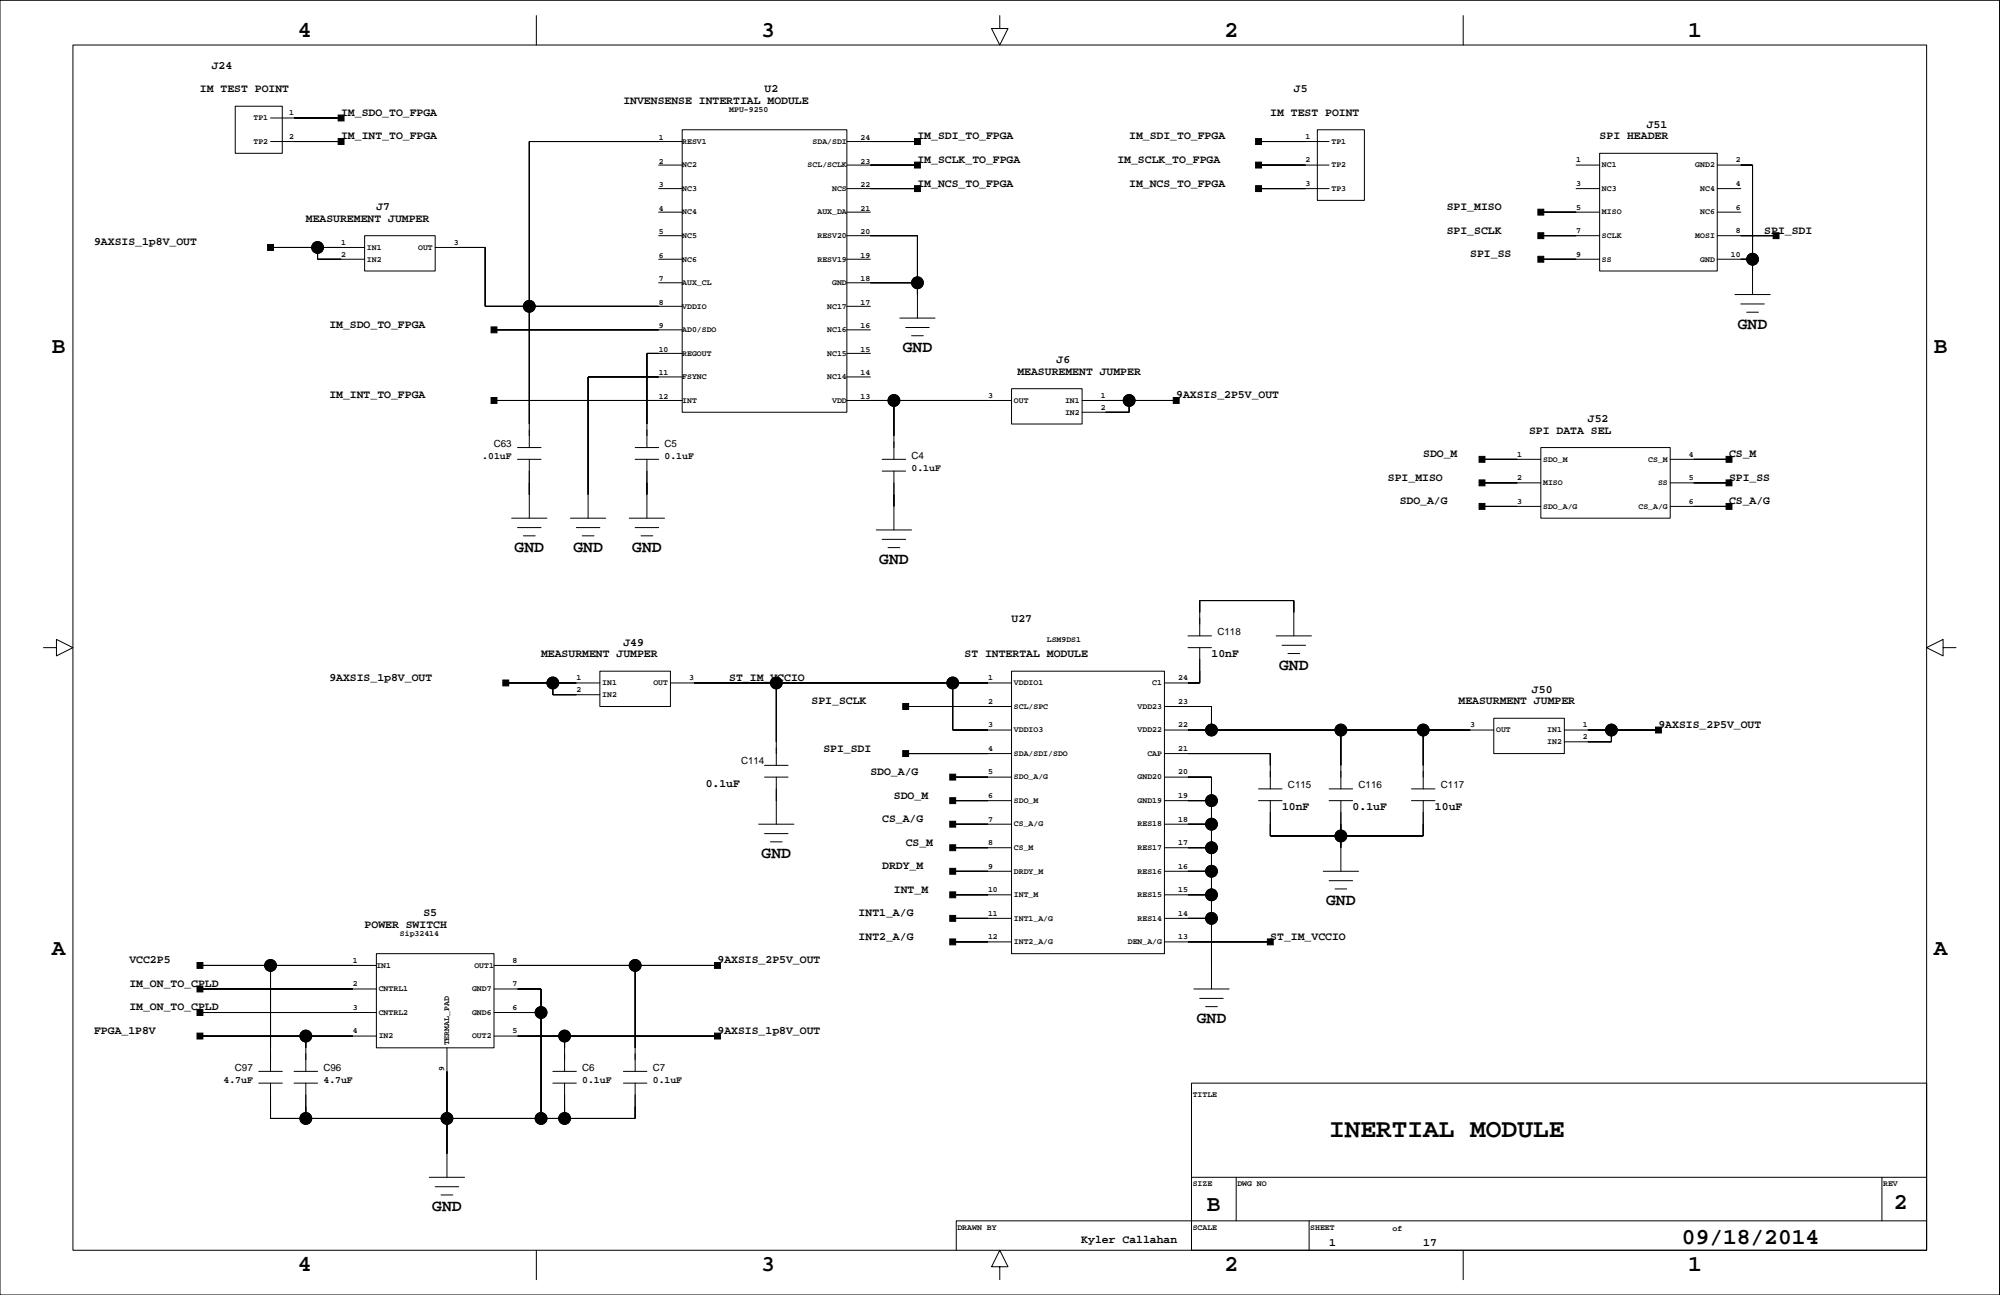
[picture p213: page 1]

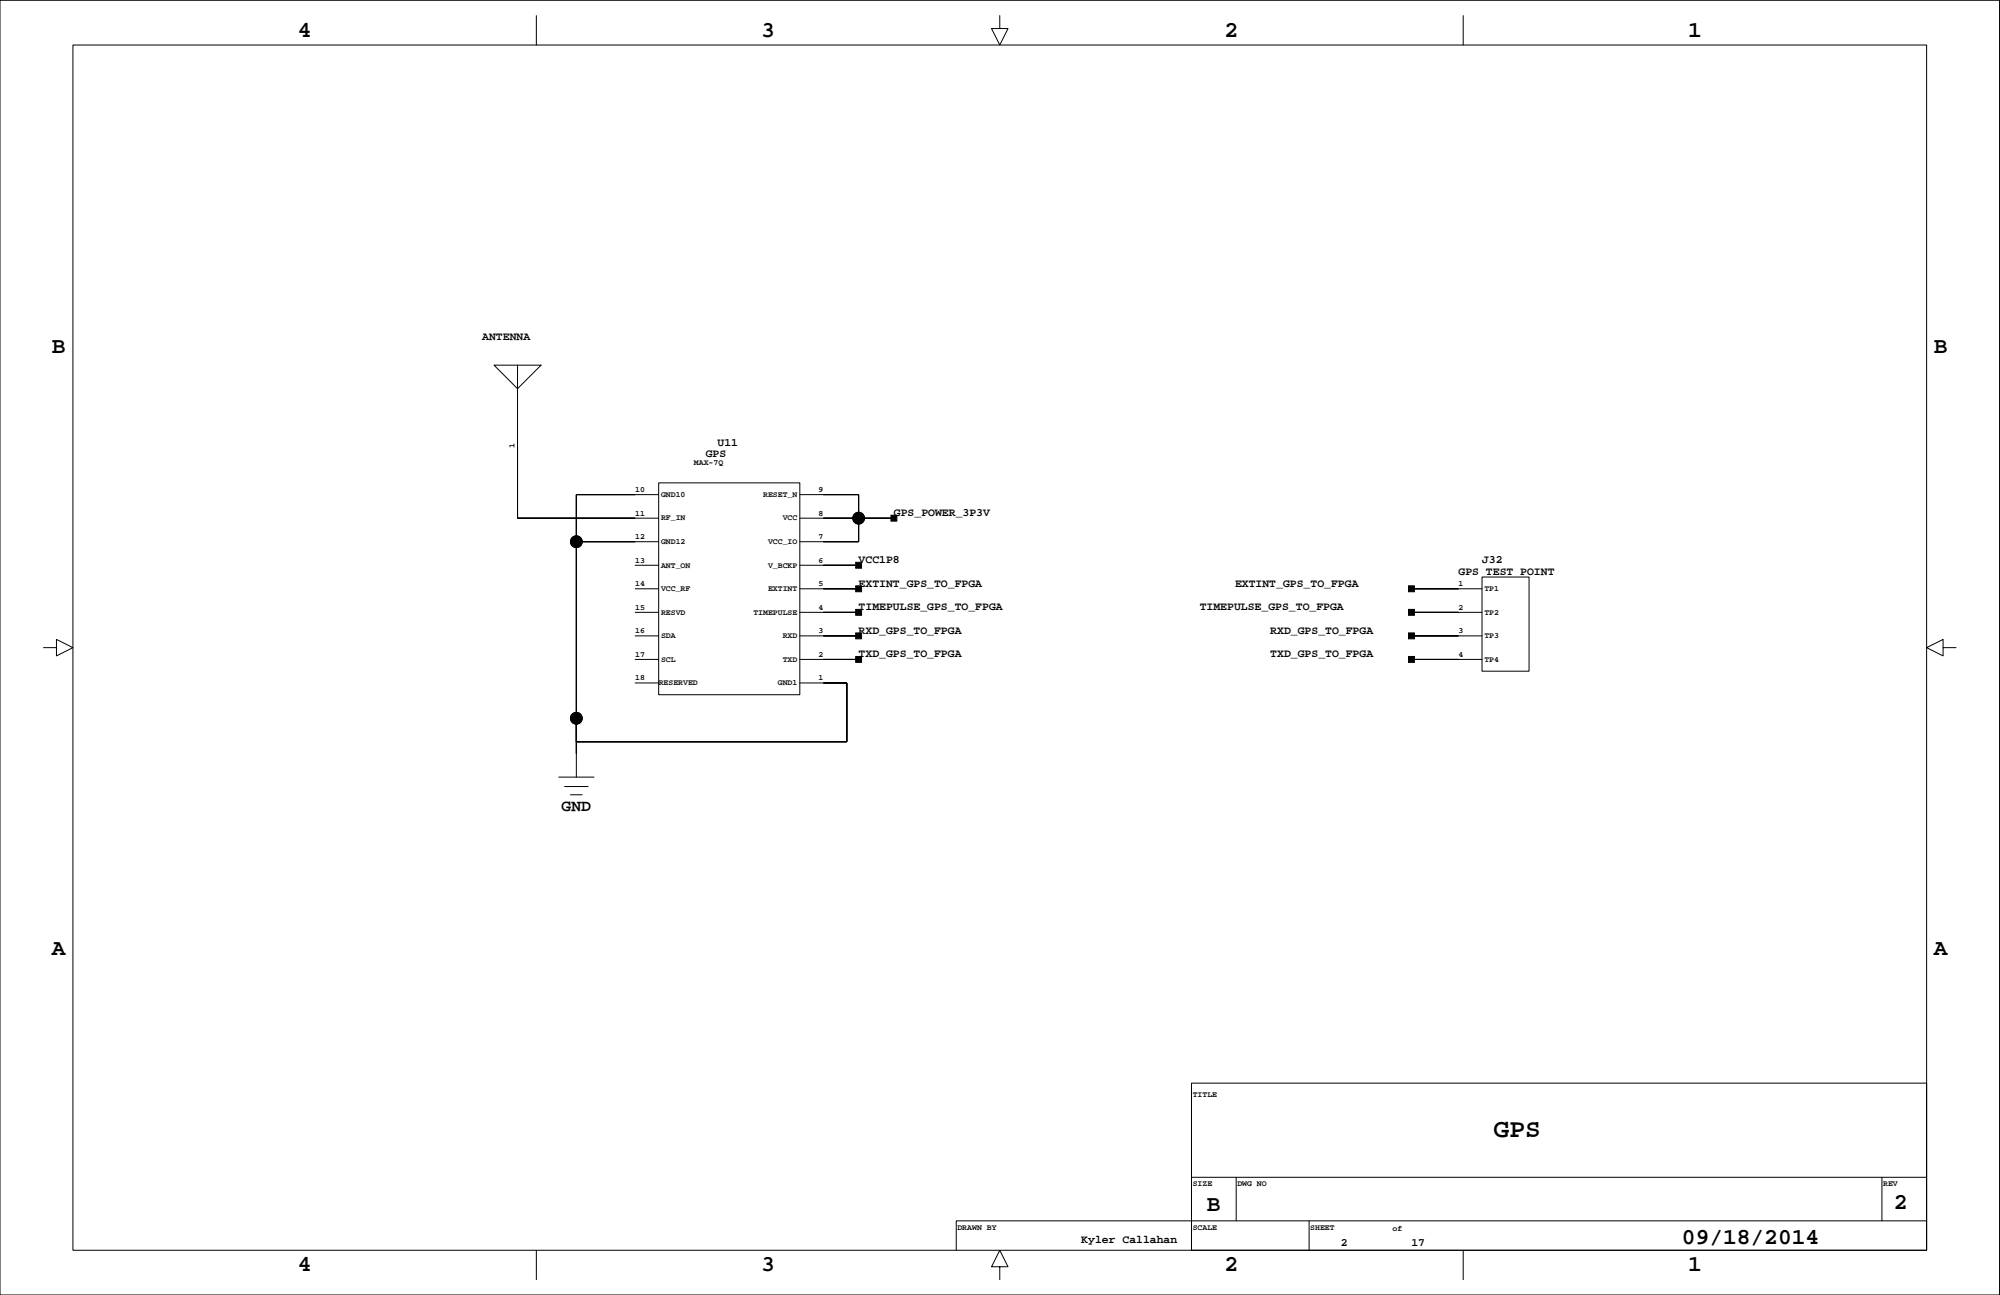
[picture p214: page 2]
10 GND10; GND12; ANT_ON; VCC_RF; RESVD; SDA; SCL; RESERVED; RESET_N; VCC; VCC_IO; V_BCKP; EXTINT; TIMEPULSE; RXD; TXD; GND1; GND; GPS_POWER_3P3V; VCC1P8; MAX-7Q; GPS; TXD_GPS_TO_FPGA; RXD_GPS_TO_FPGA; TIMEPULSE_GPS_TO_FPGA; EXTINT_GPS_TO_FPGA; ANTENNA; GPS TEST POINT; TITLE; Kyler Callahan

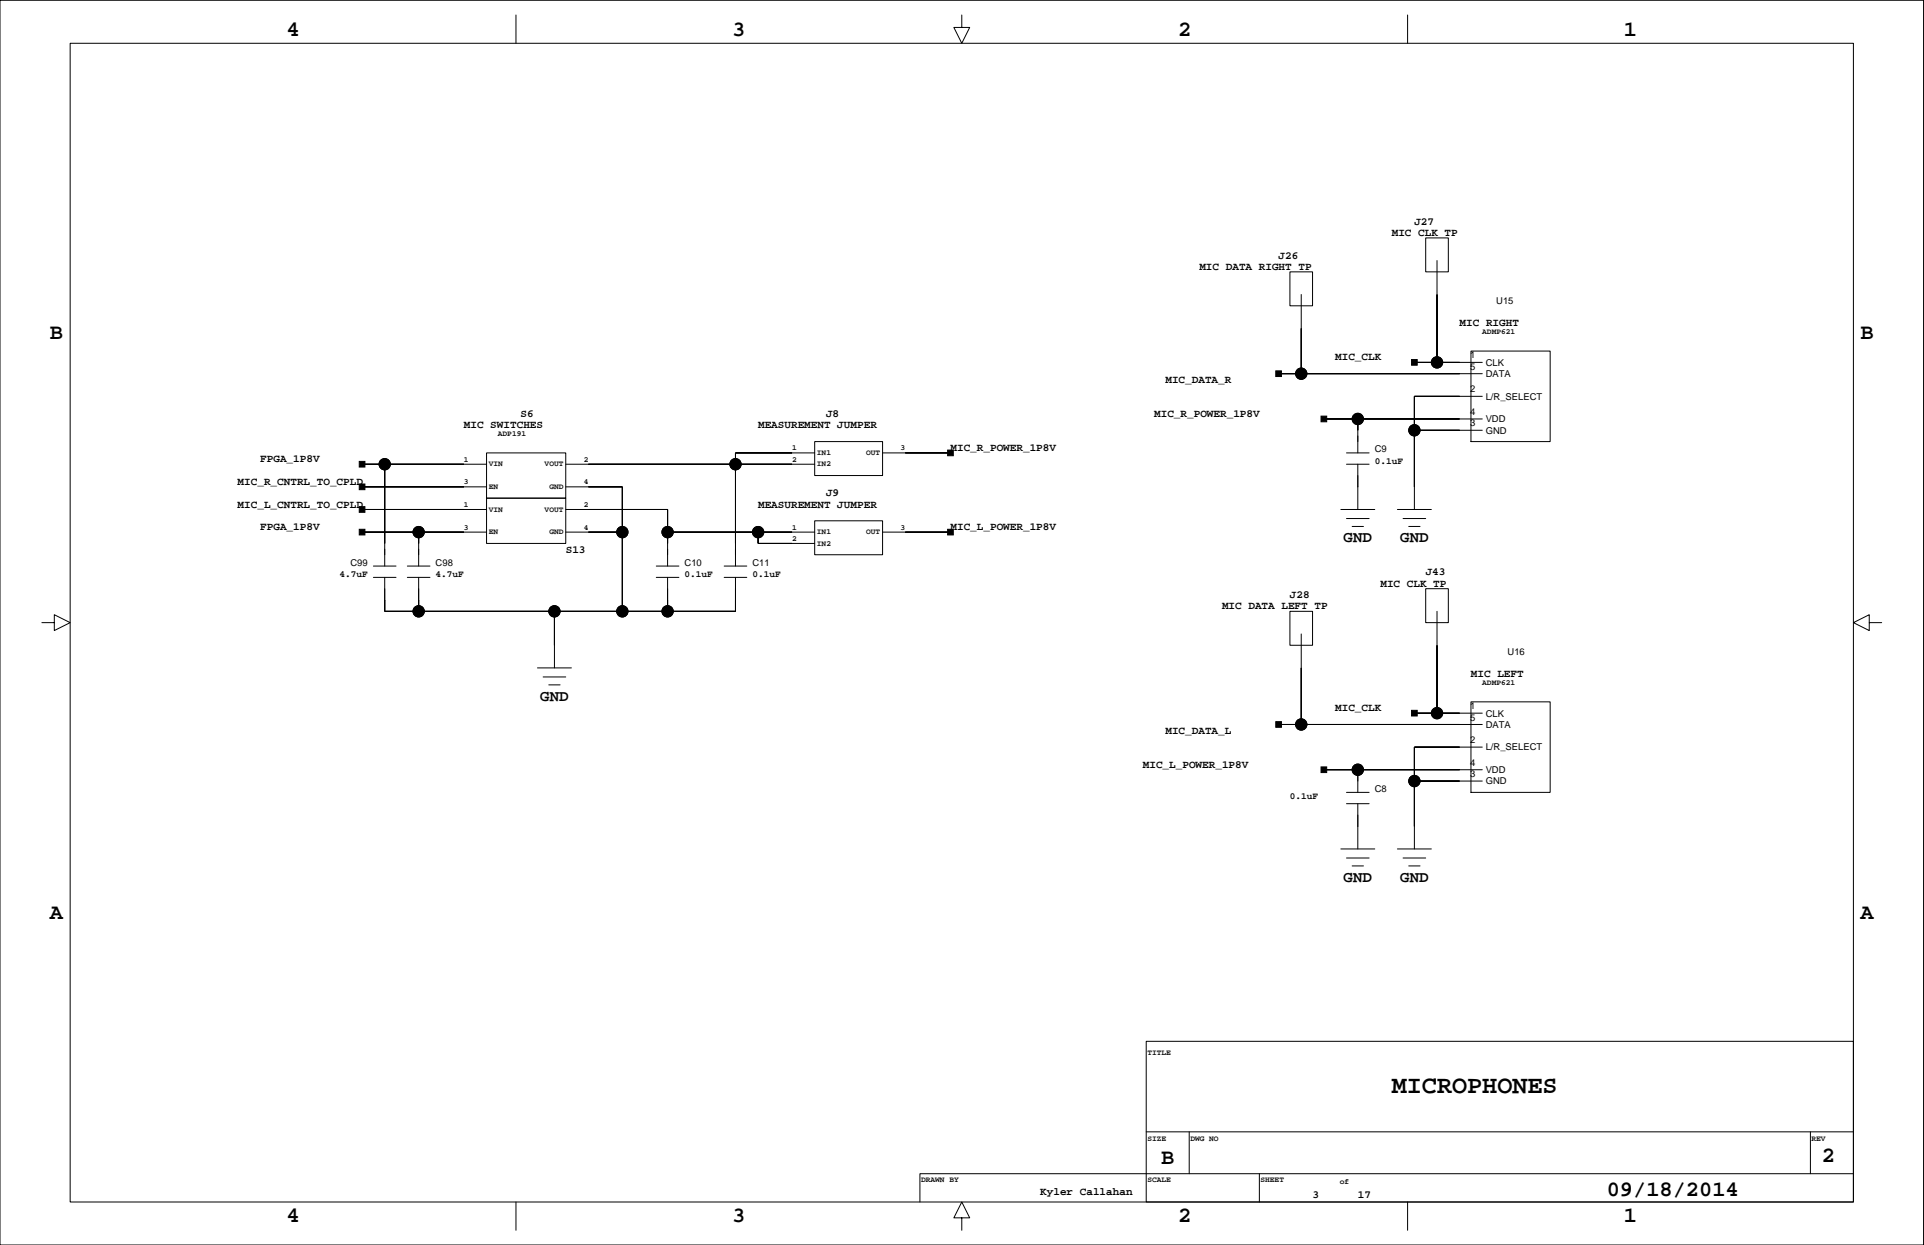
[picture p215: page 3]

MIC DATA RIGHT TP

MIC DATA LEFT TP

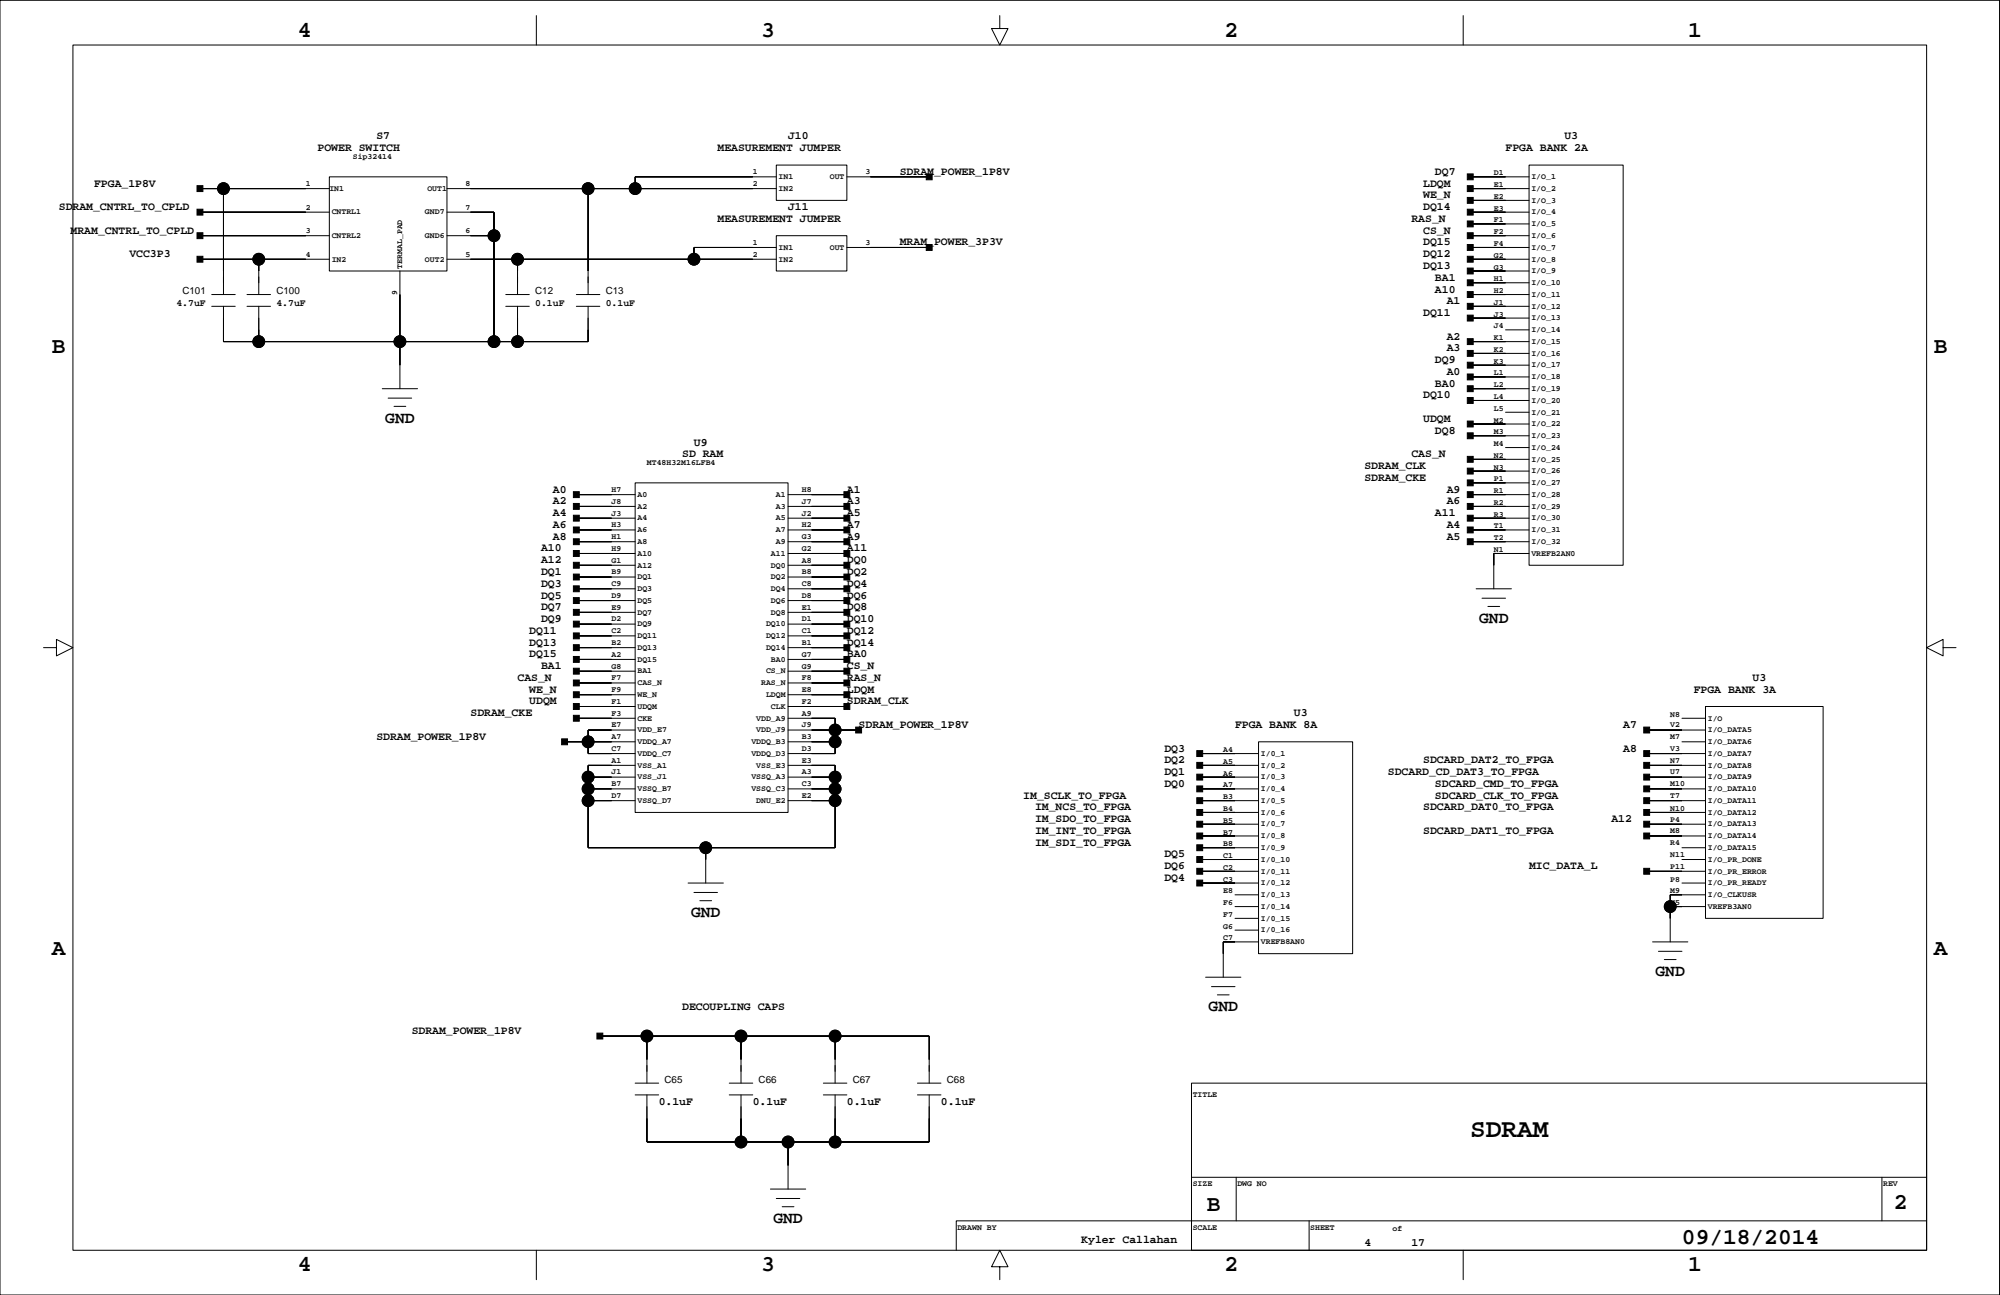
[picture p216: page 4]

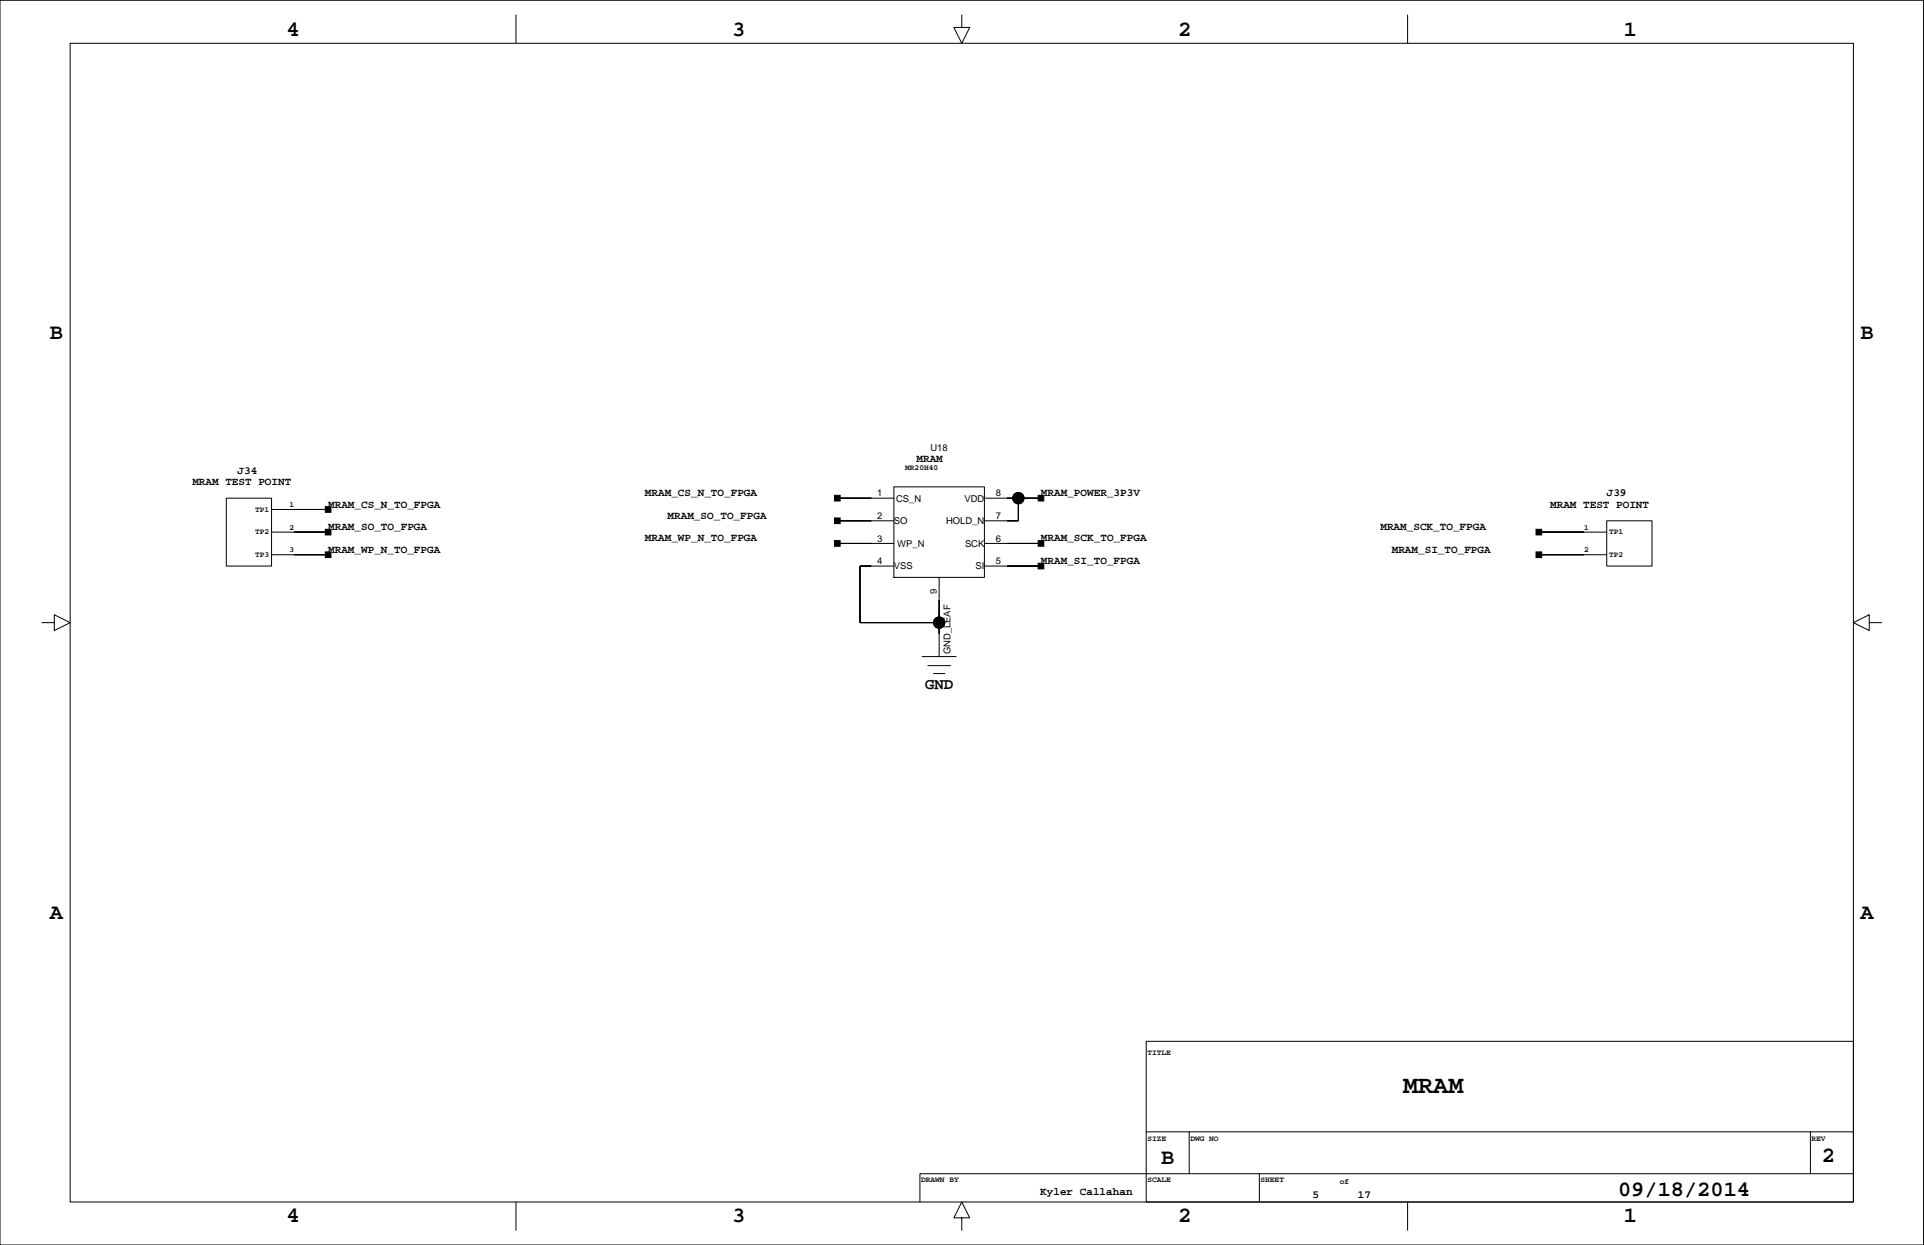
[picture p217: page 5]
VSS; VDD; HOLD_N; SCK; GND_LEAF; MRAM; MRAM_POWER_3P3V; GND; MRAM_CS_N_TO_FPGA; MRAM_SO_TO_FPGA; MRAM_WP_N_TO_FPGA; MRAM_SI_TO_FPGA; MRAM_SCK_TO_FPGA; TITLE

MRAM TEST POINT

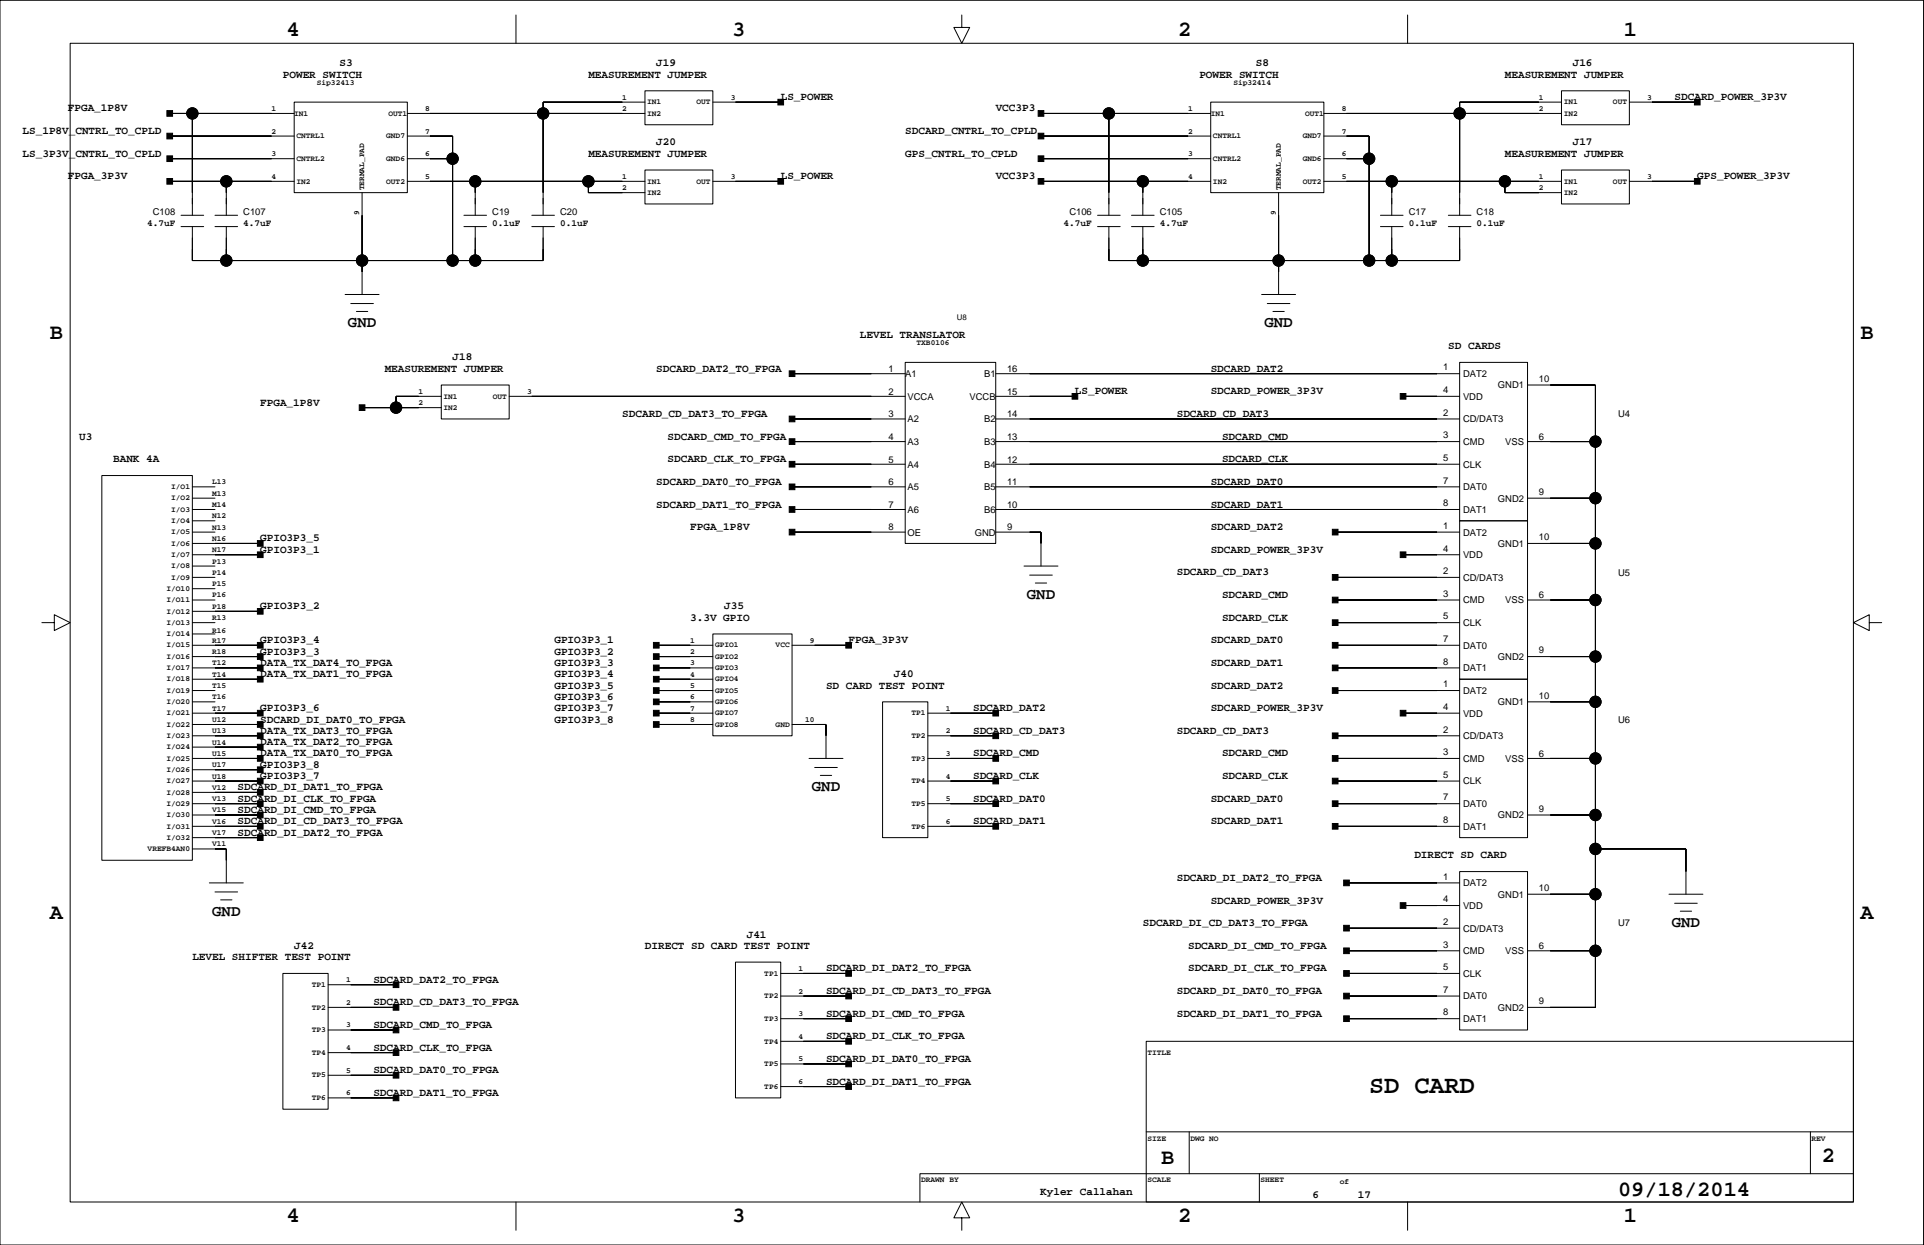
[picture p218: page 6]

SD CARD TEST POINT

DIRECT SD CARD TEST POINT

LEVEL SHIFTER TEST POINT

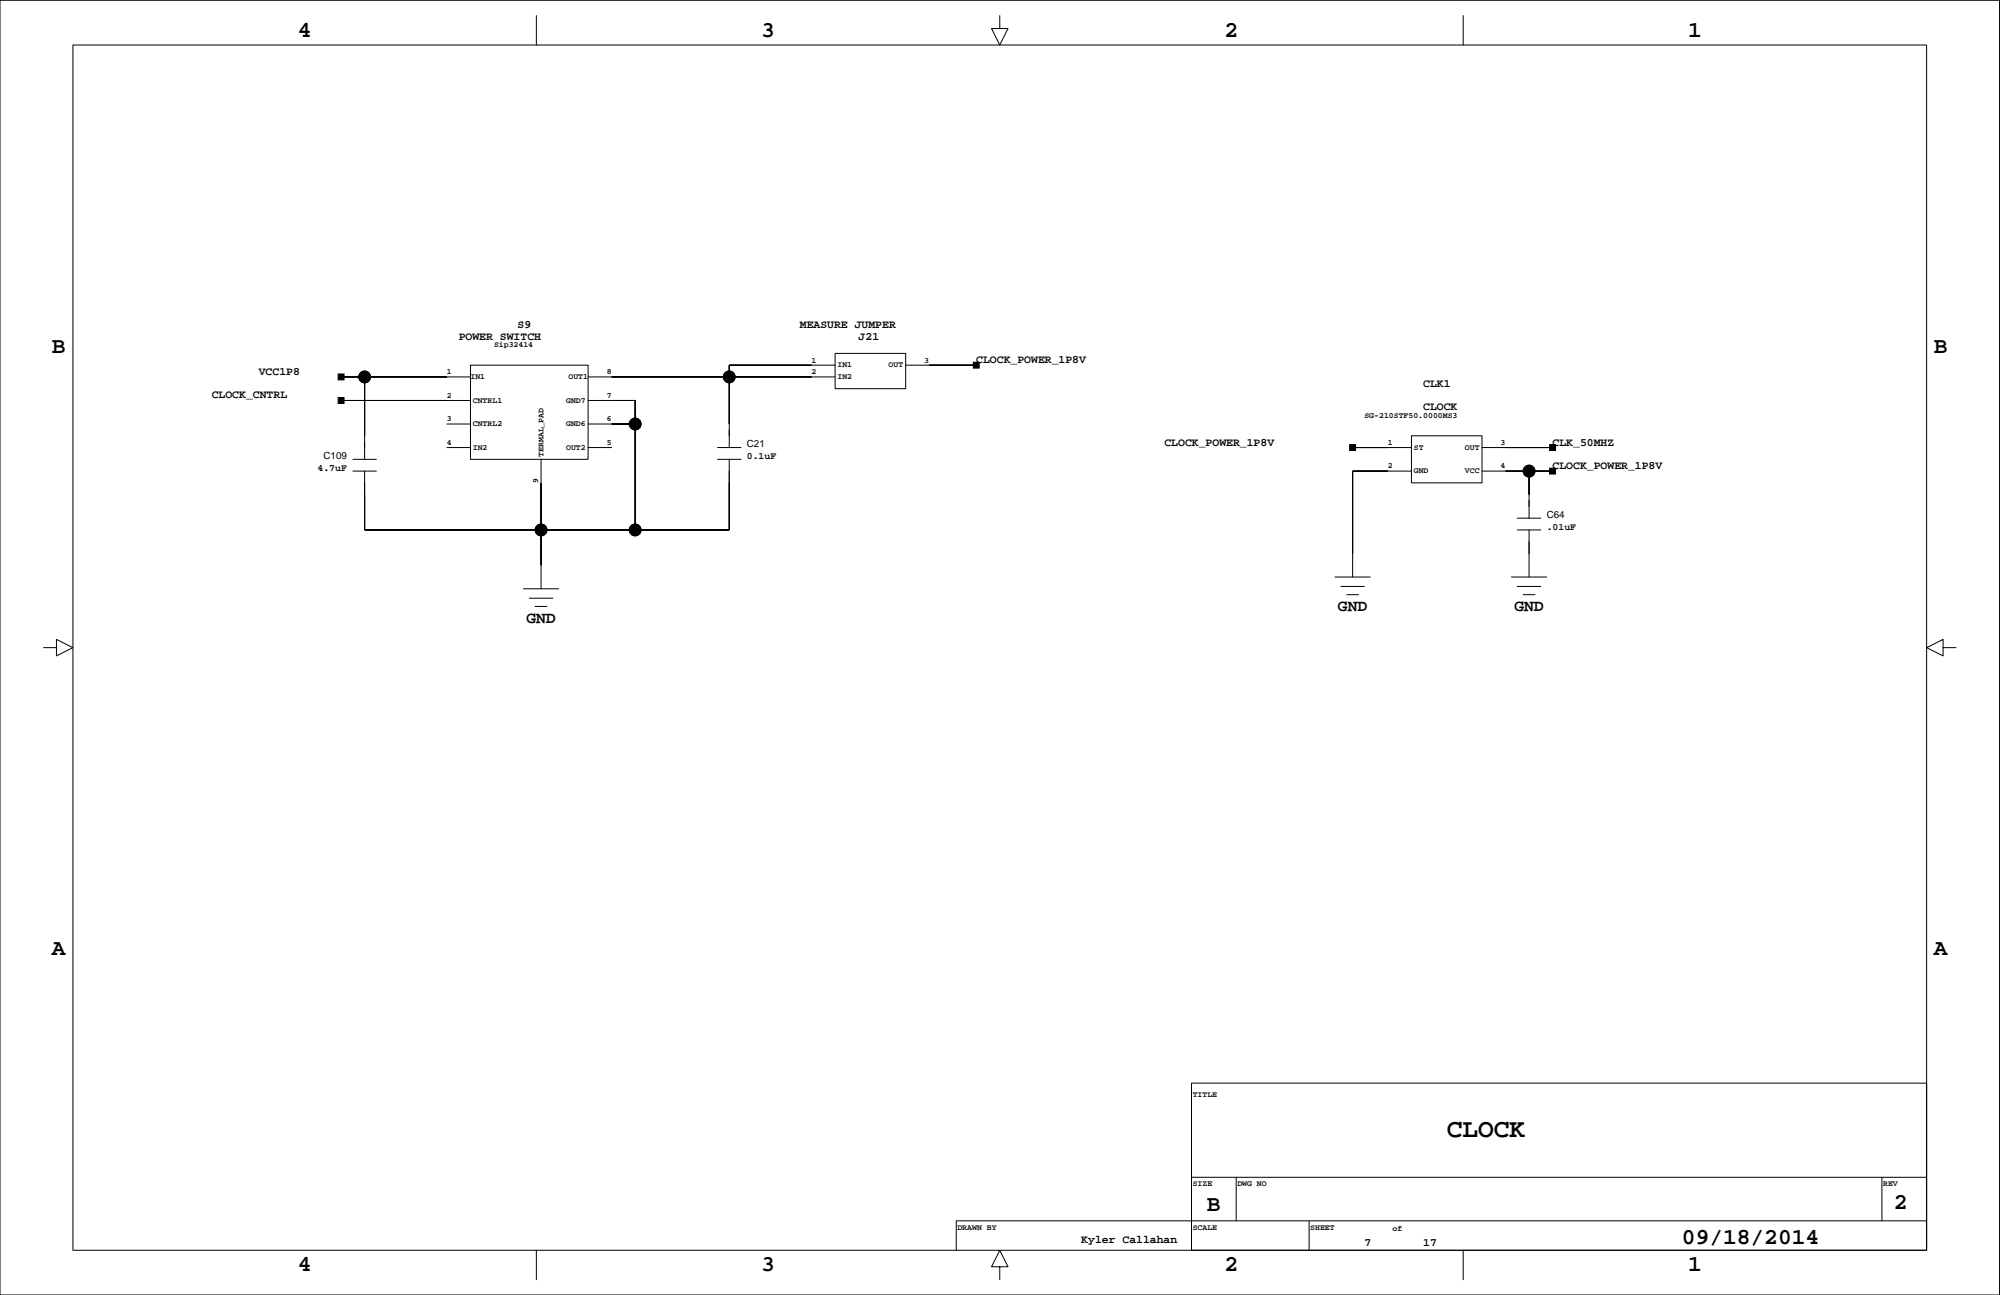
[picture p219: page 7]
CLK1; GND; OUT; VCC; CLOCK_POWER_1P8V; CLK_50MHZ; CNTRL1; CNTRL2; OUT1; GND7; GND6; OUT2; TERMAL_PAD; CLOCK_CNTRL; VCC1P8; 1 CLOCK_POWER_1P8V; Sip32414; SG-210STF50.0000MS3; POWER SWITCH; MEASURE JUMPER; CLOCK; TITLE; Kyler Callahan

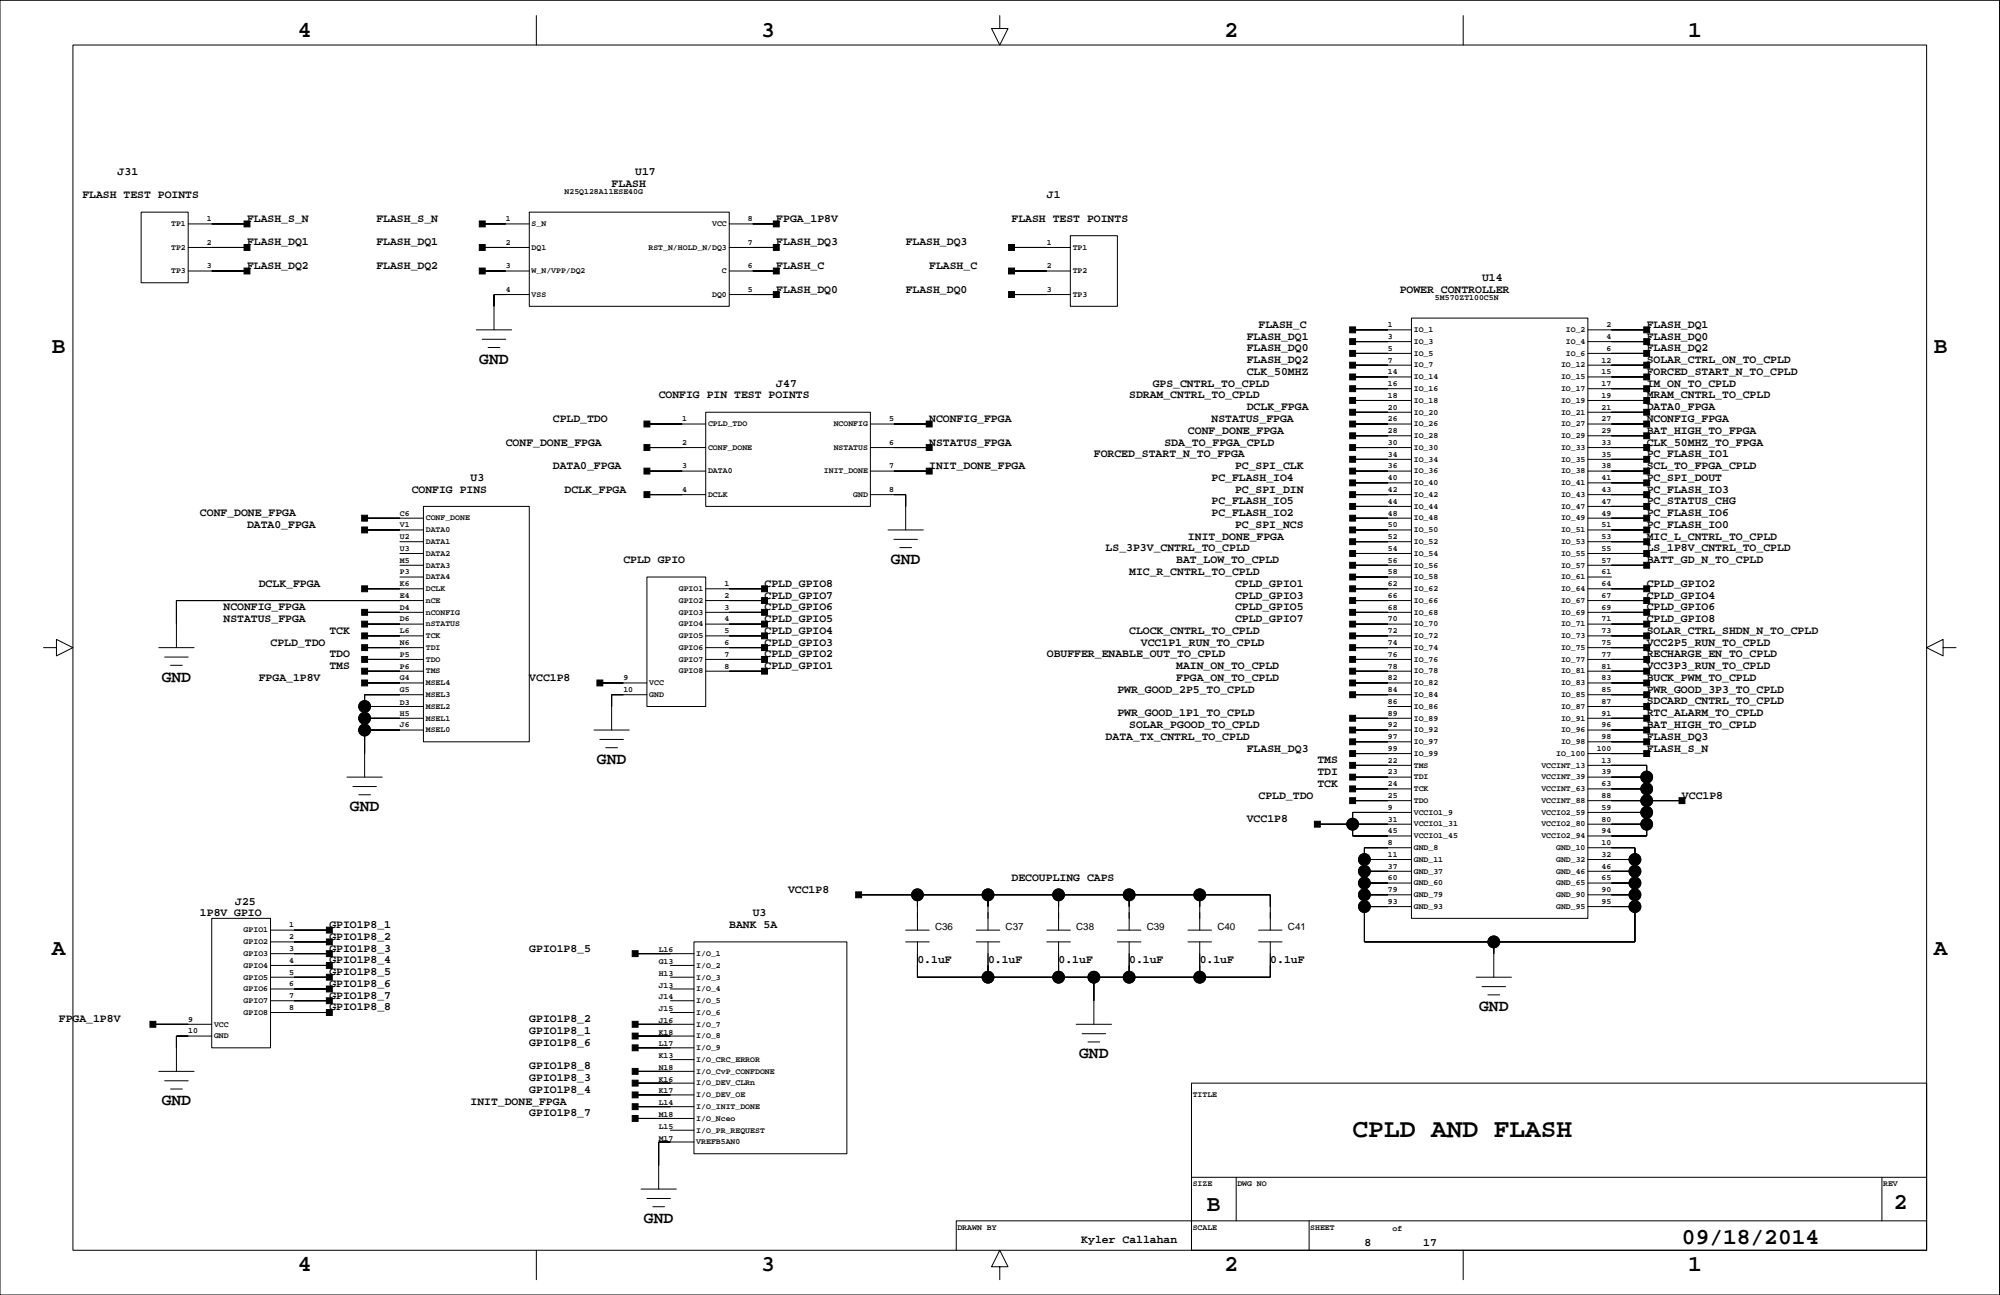
[picture p220: page 8]

CONFIG PIN TEST POINTS

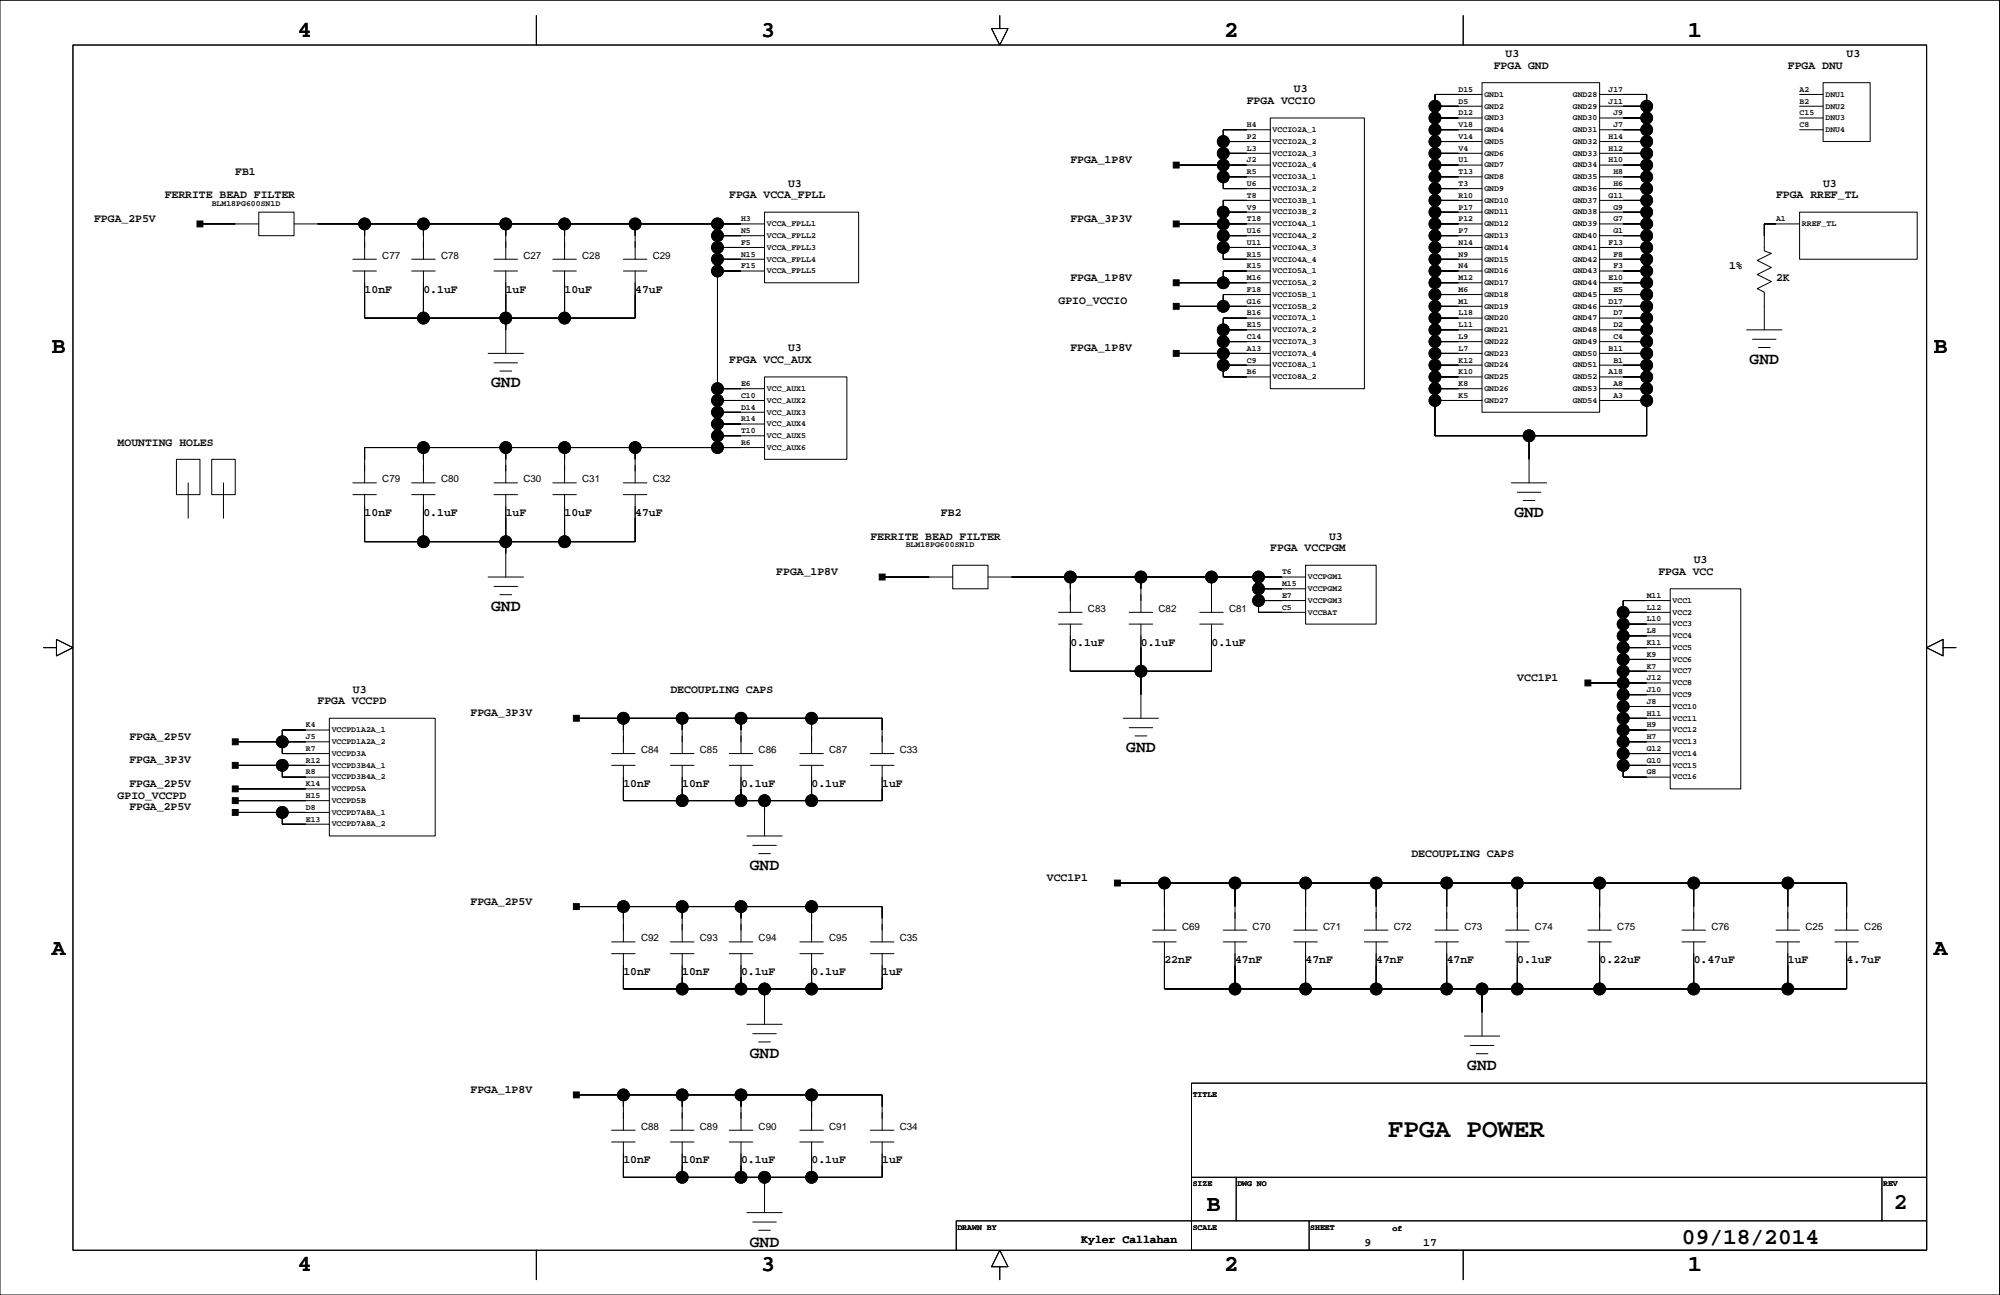
[picture p221: page 9]

4

3

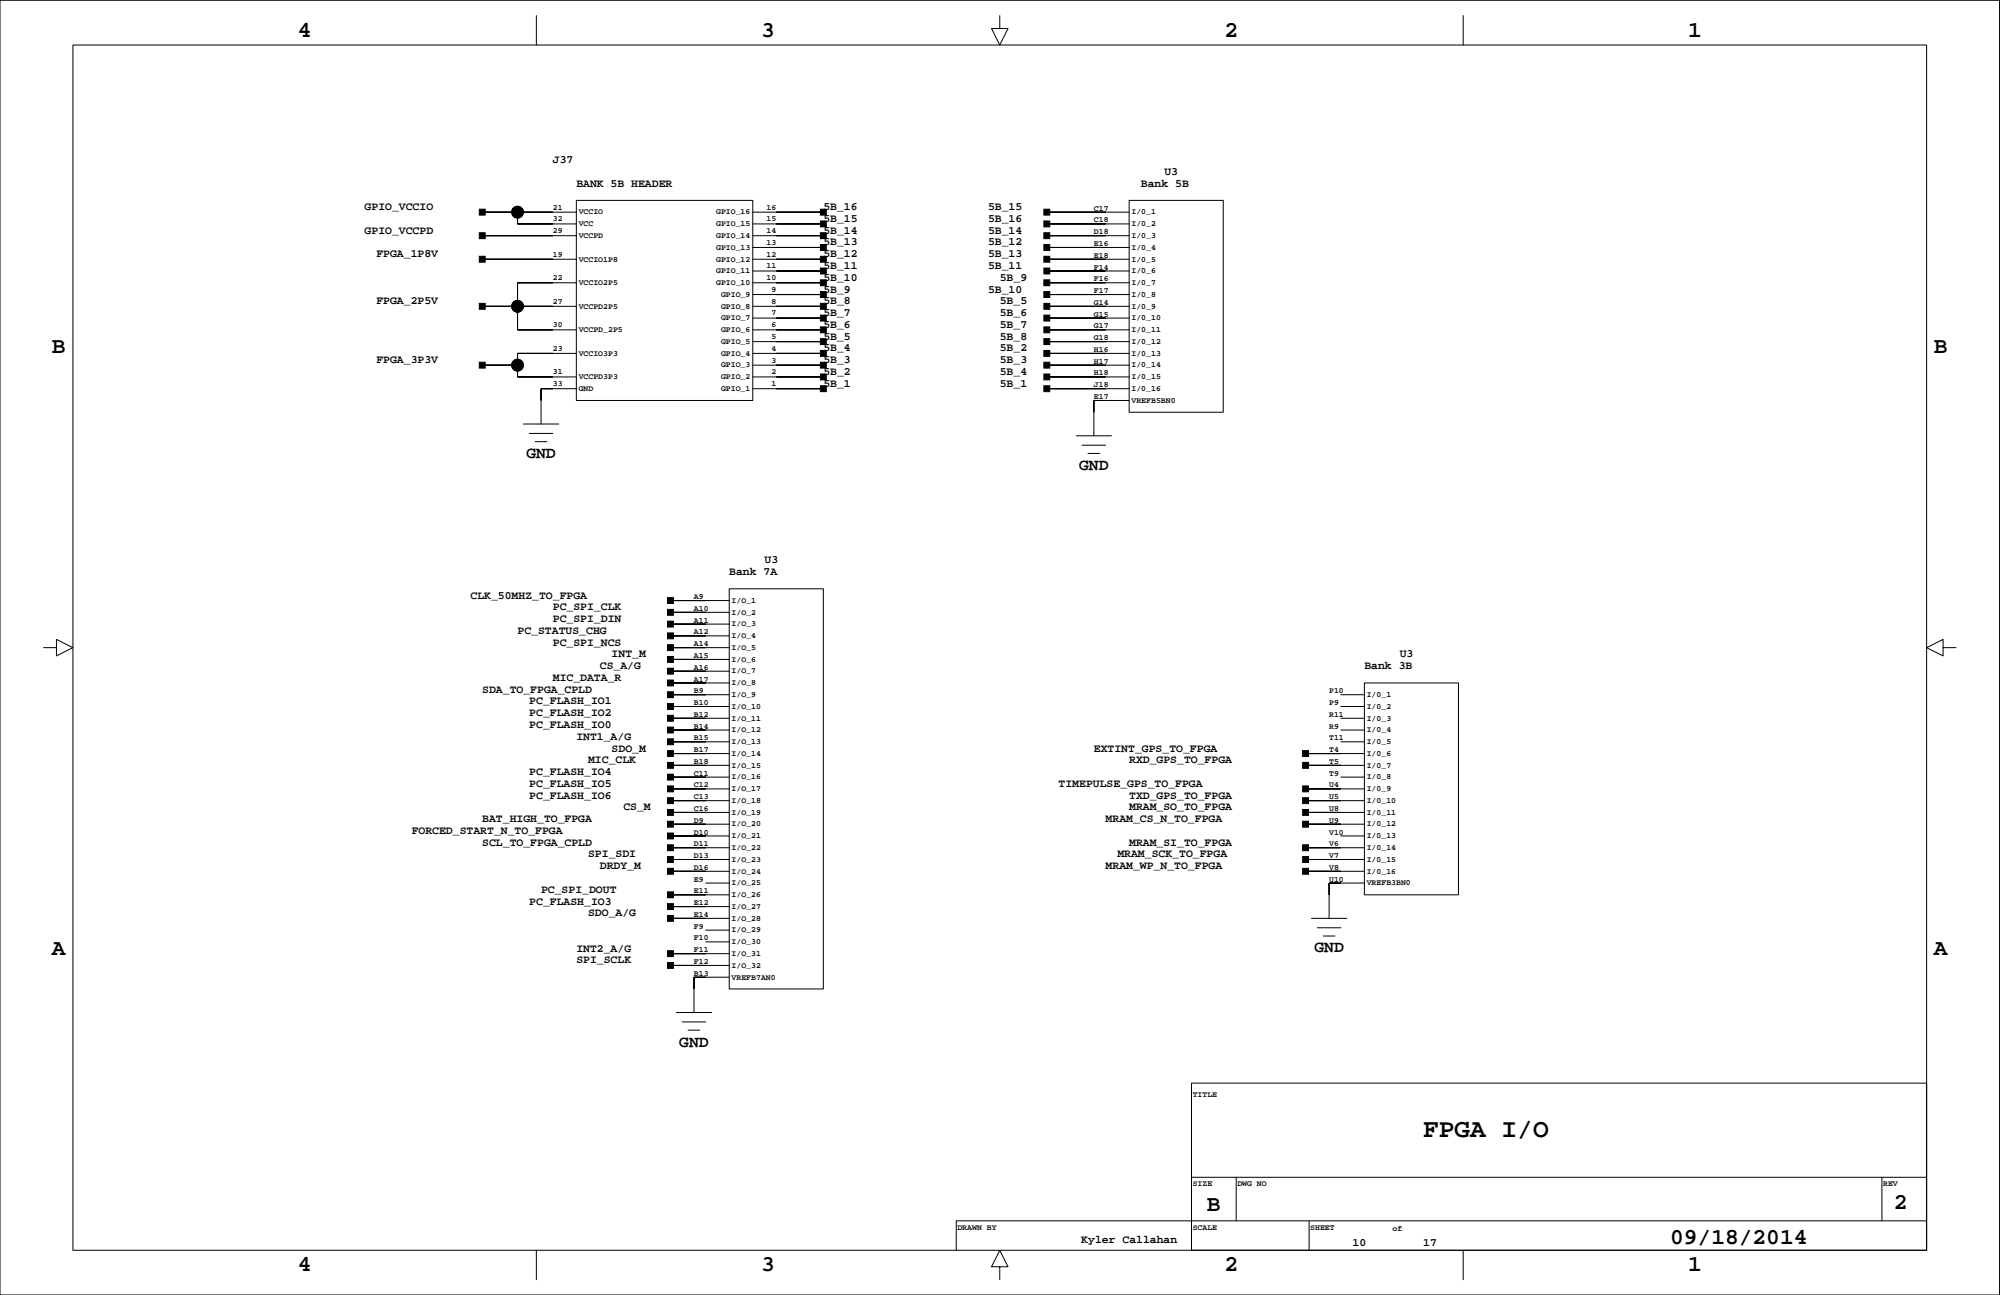
[picture p222: page 10]

## GND

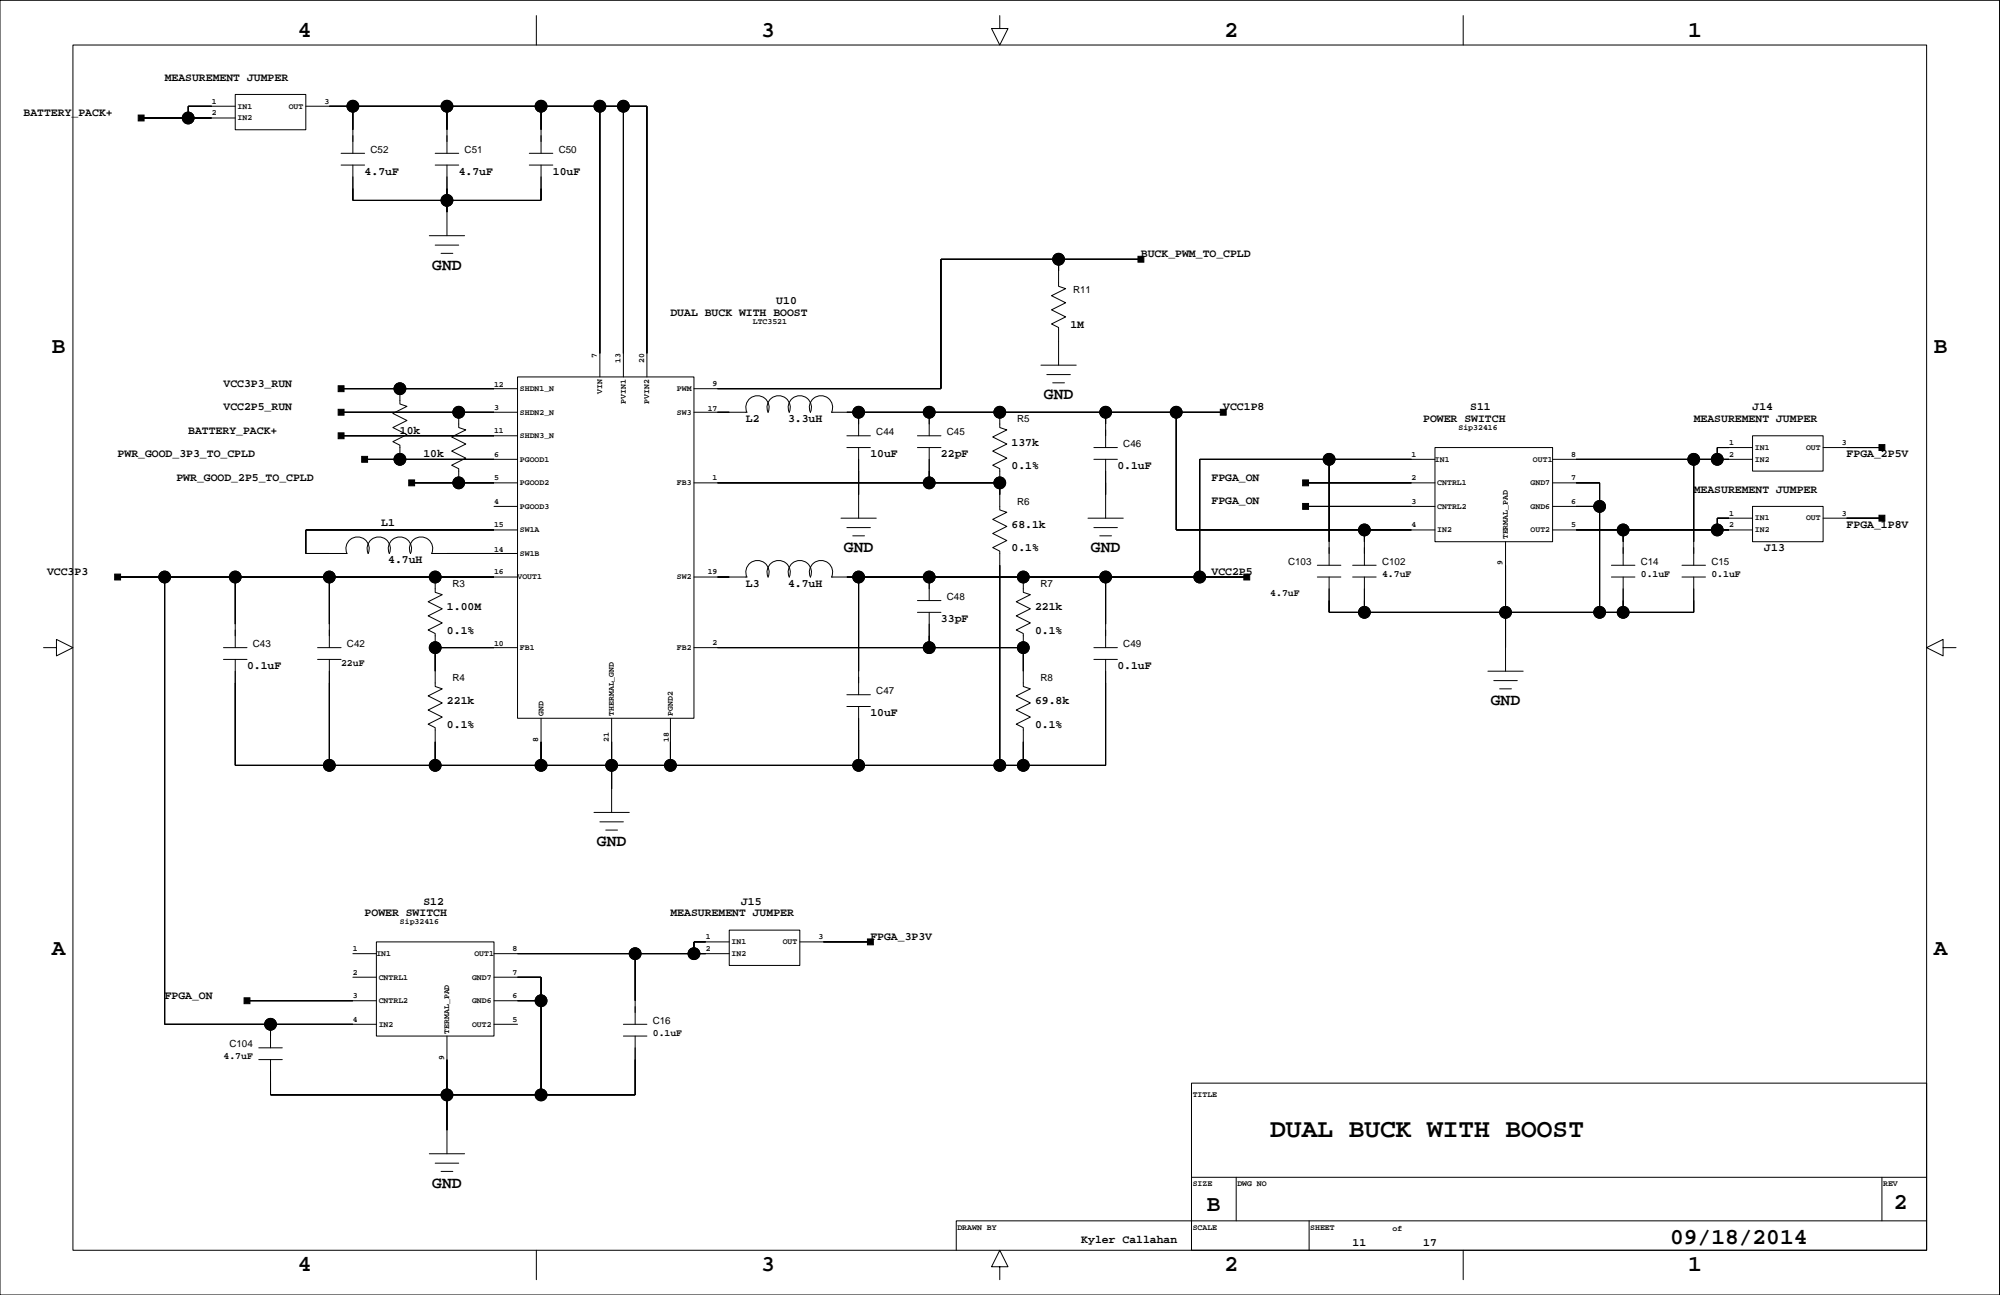
[picture p223: page 11]

DUAL BUCK WITH BOOST

TITLE

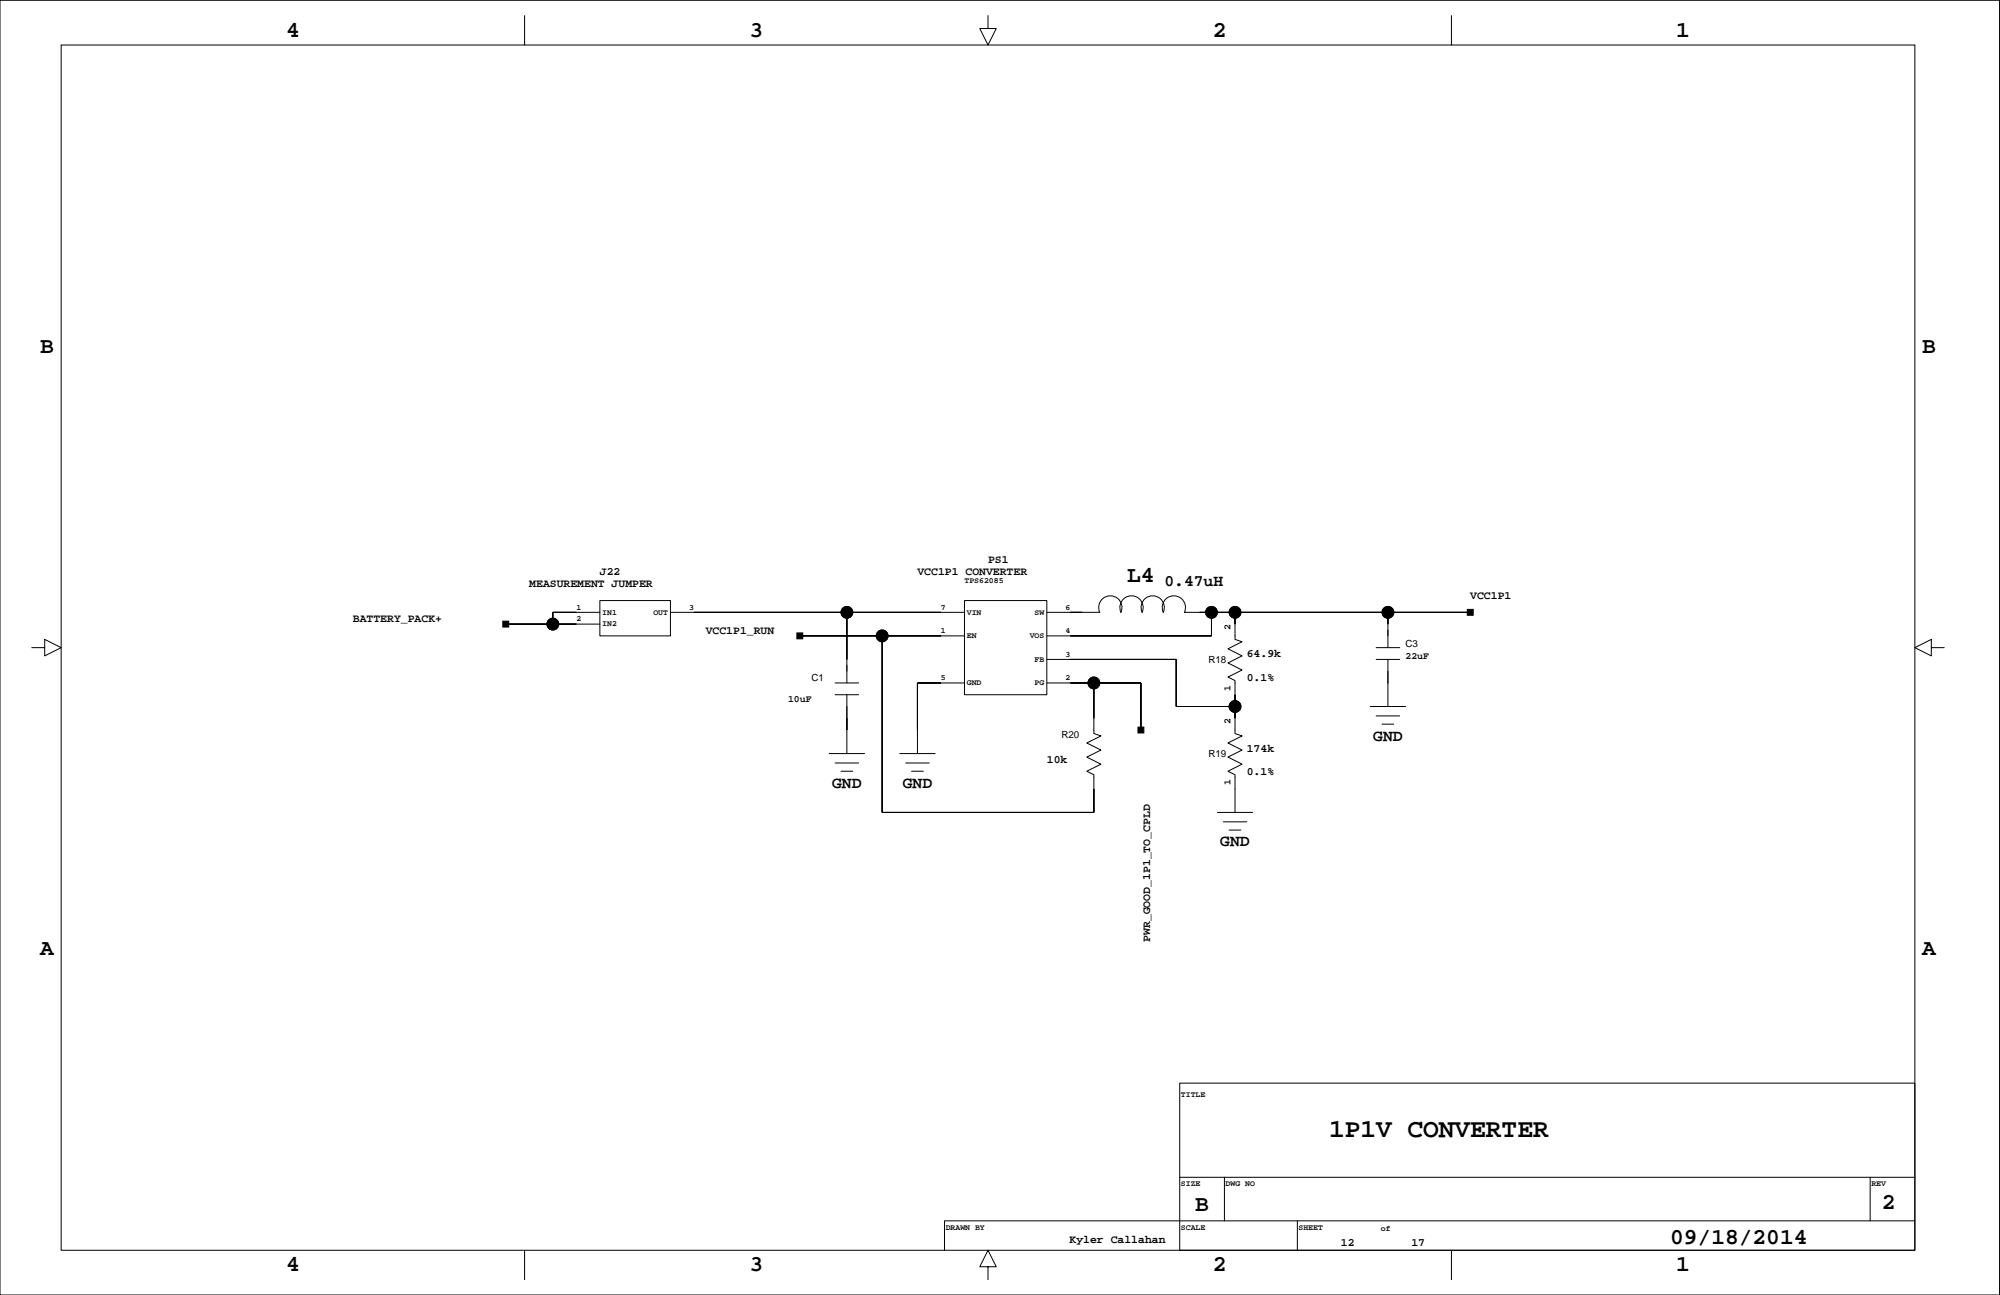
[picture p224: page 12]
VOS; VIN; GND; VCC1P1; VCC1P1 CONVERTER TPS62085; VCC1P1_RUN; PWR_GOOD_1P1_TO_CPLD; OUT; BATTERY_PACK+; MEASUREMENT JUMPER; TITLE; 1P1V CONVERTER

## L5 10uH

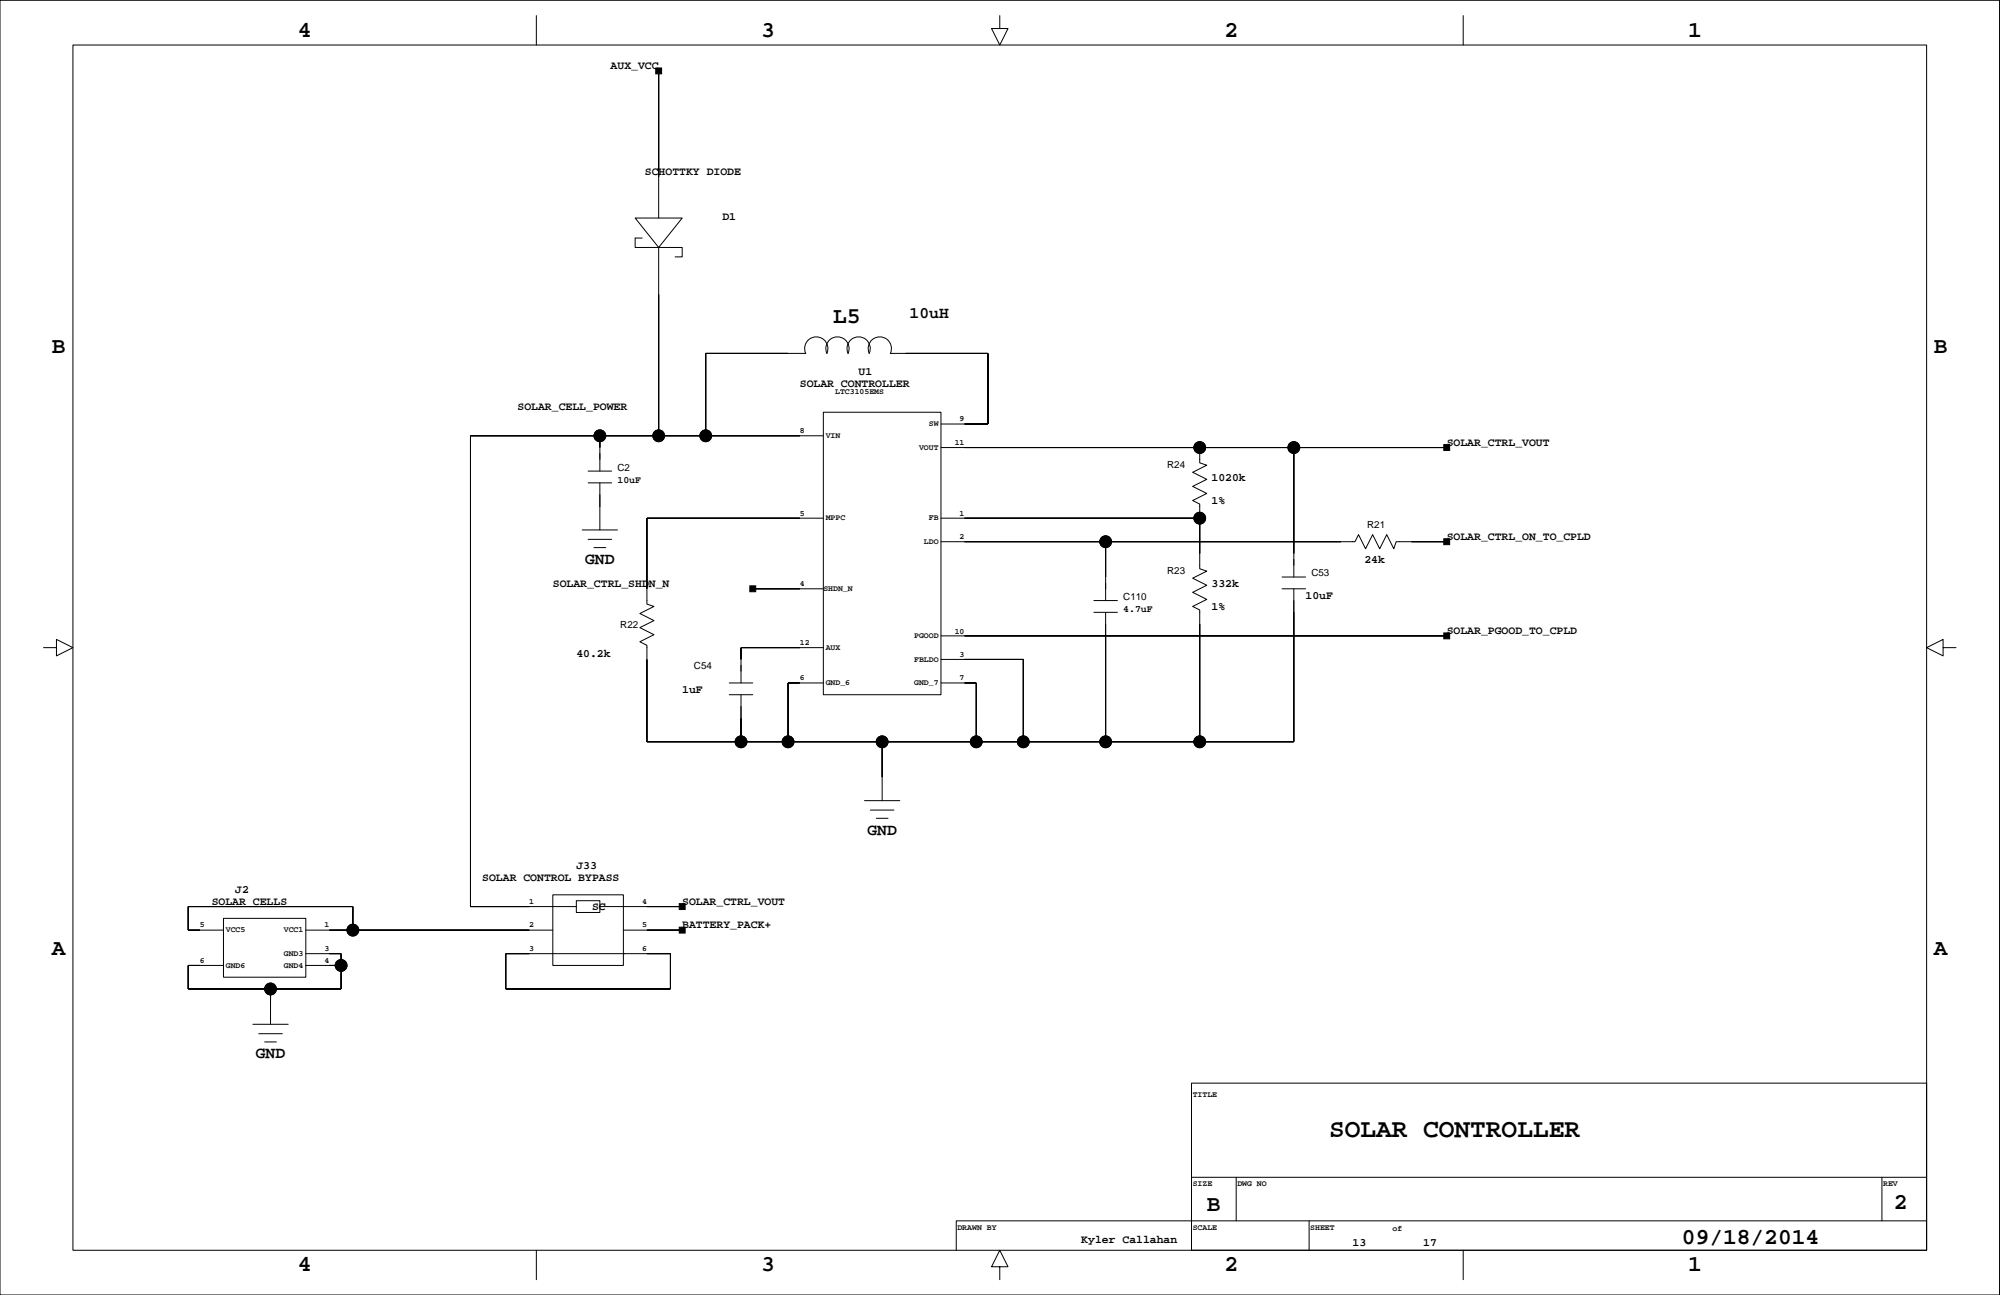
[picture p225: page 13]

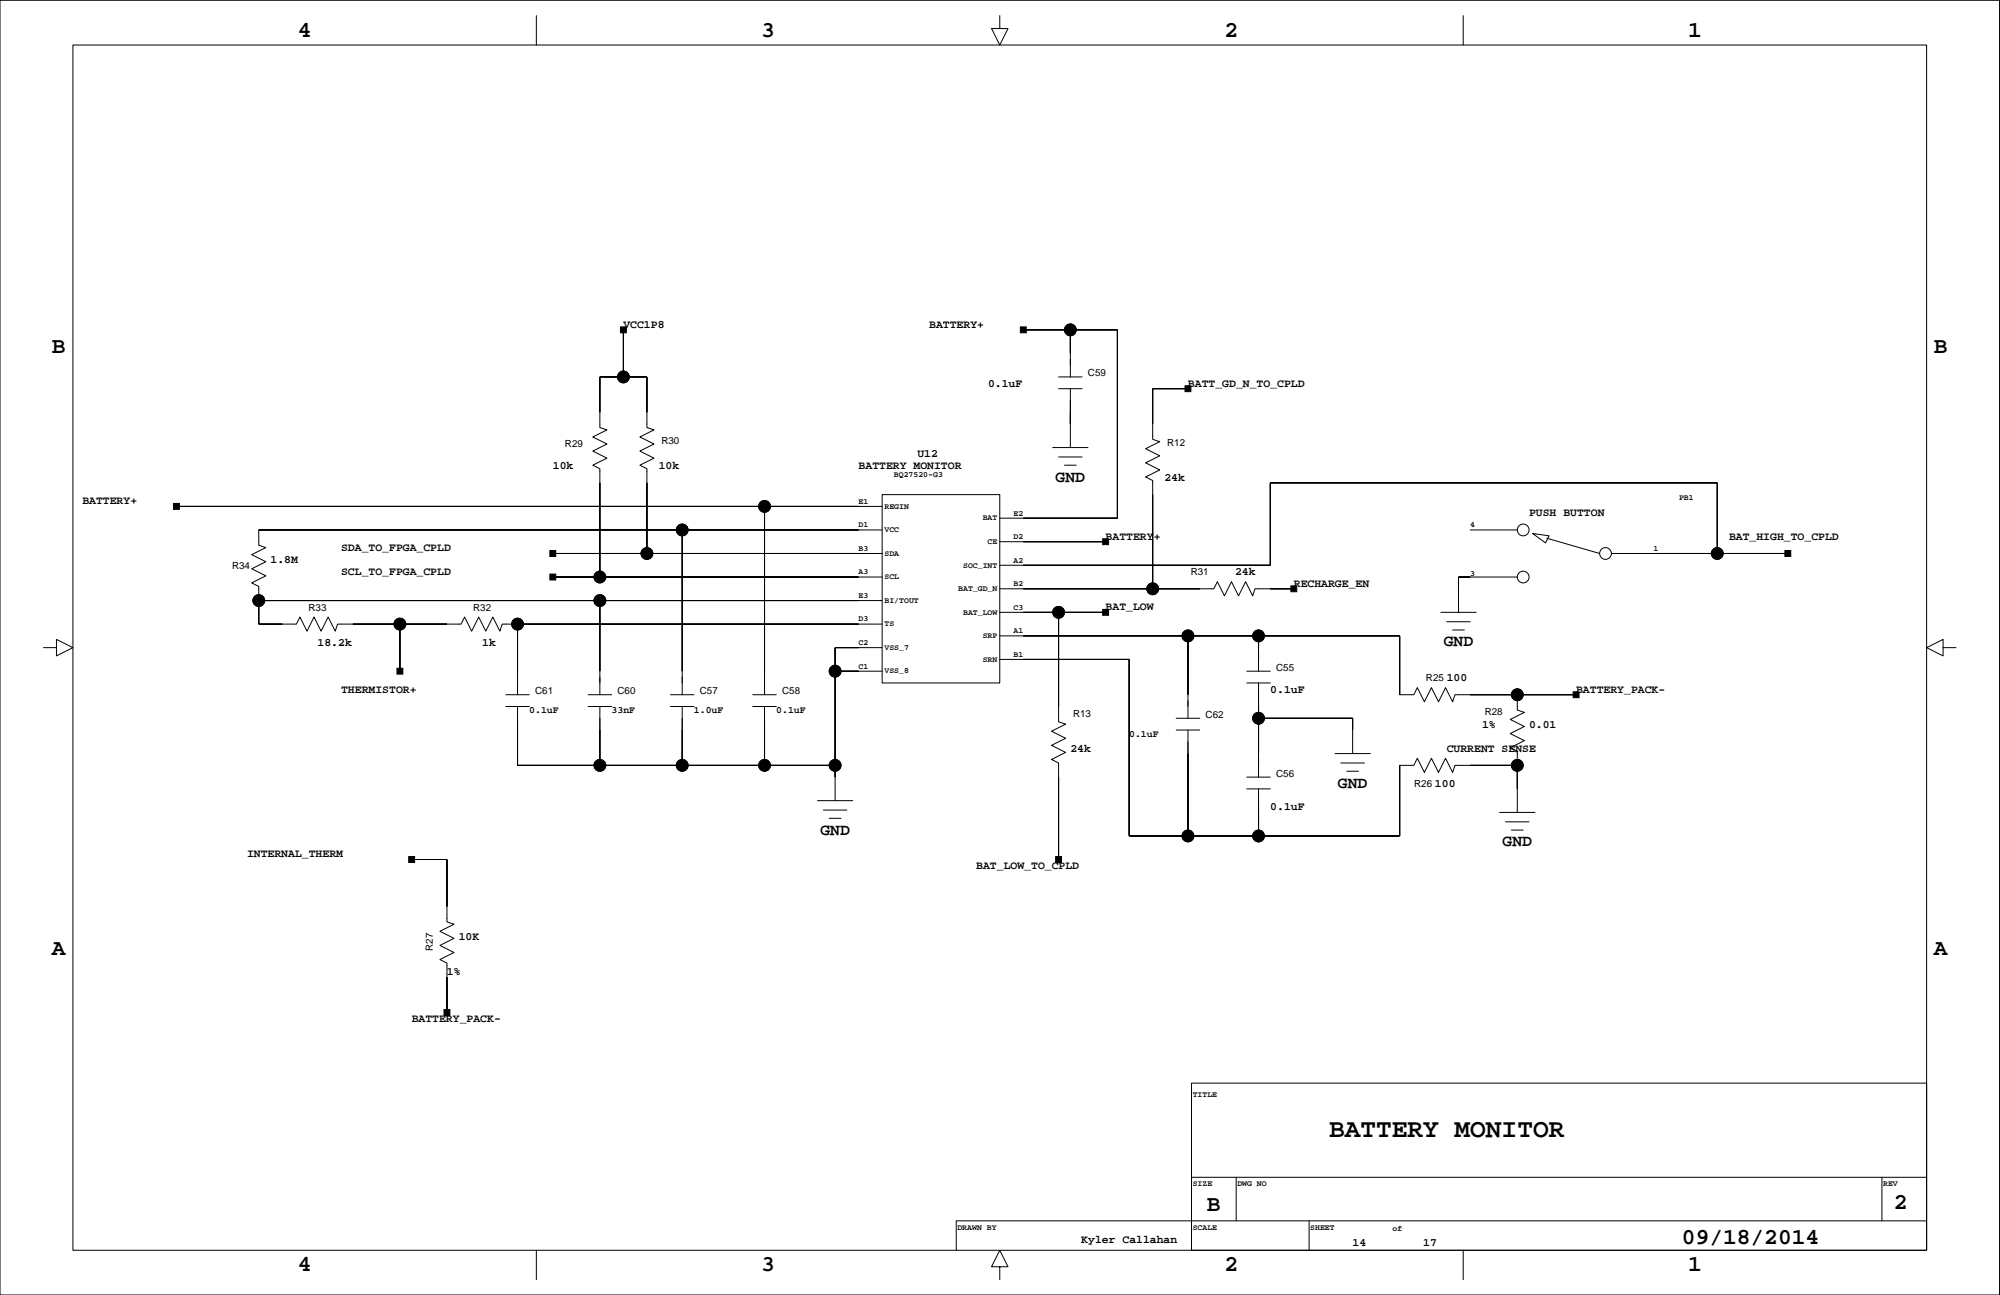
[picture p226: page 14]

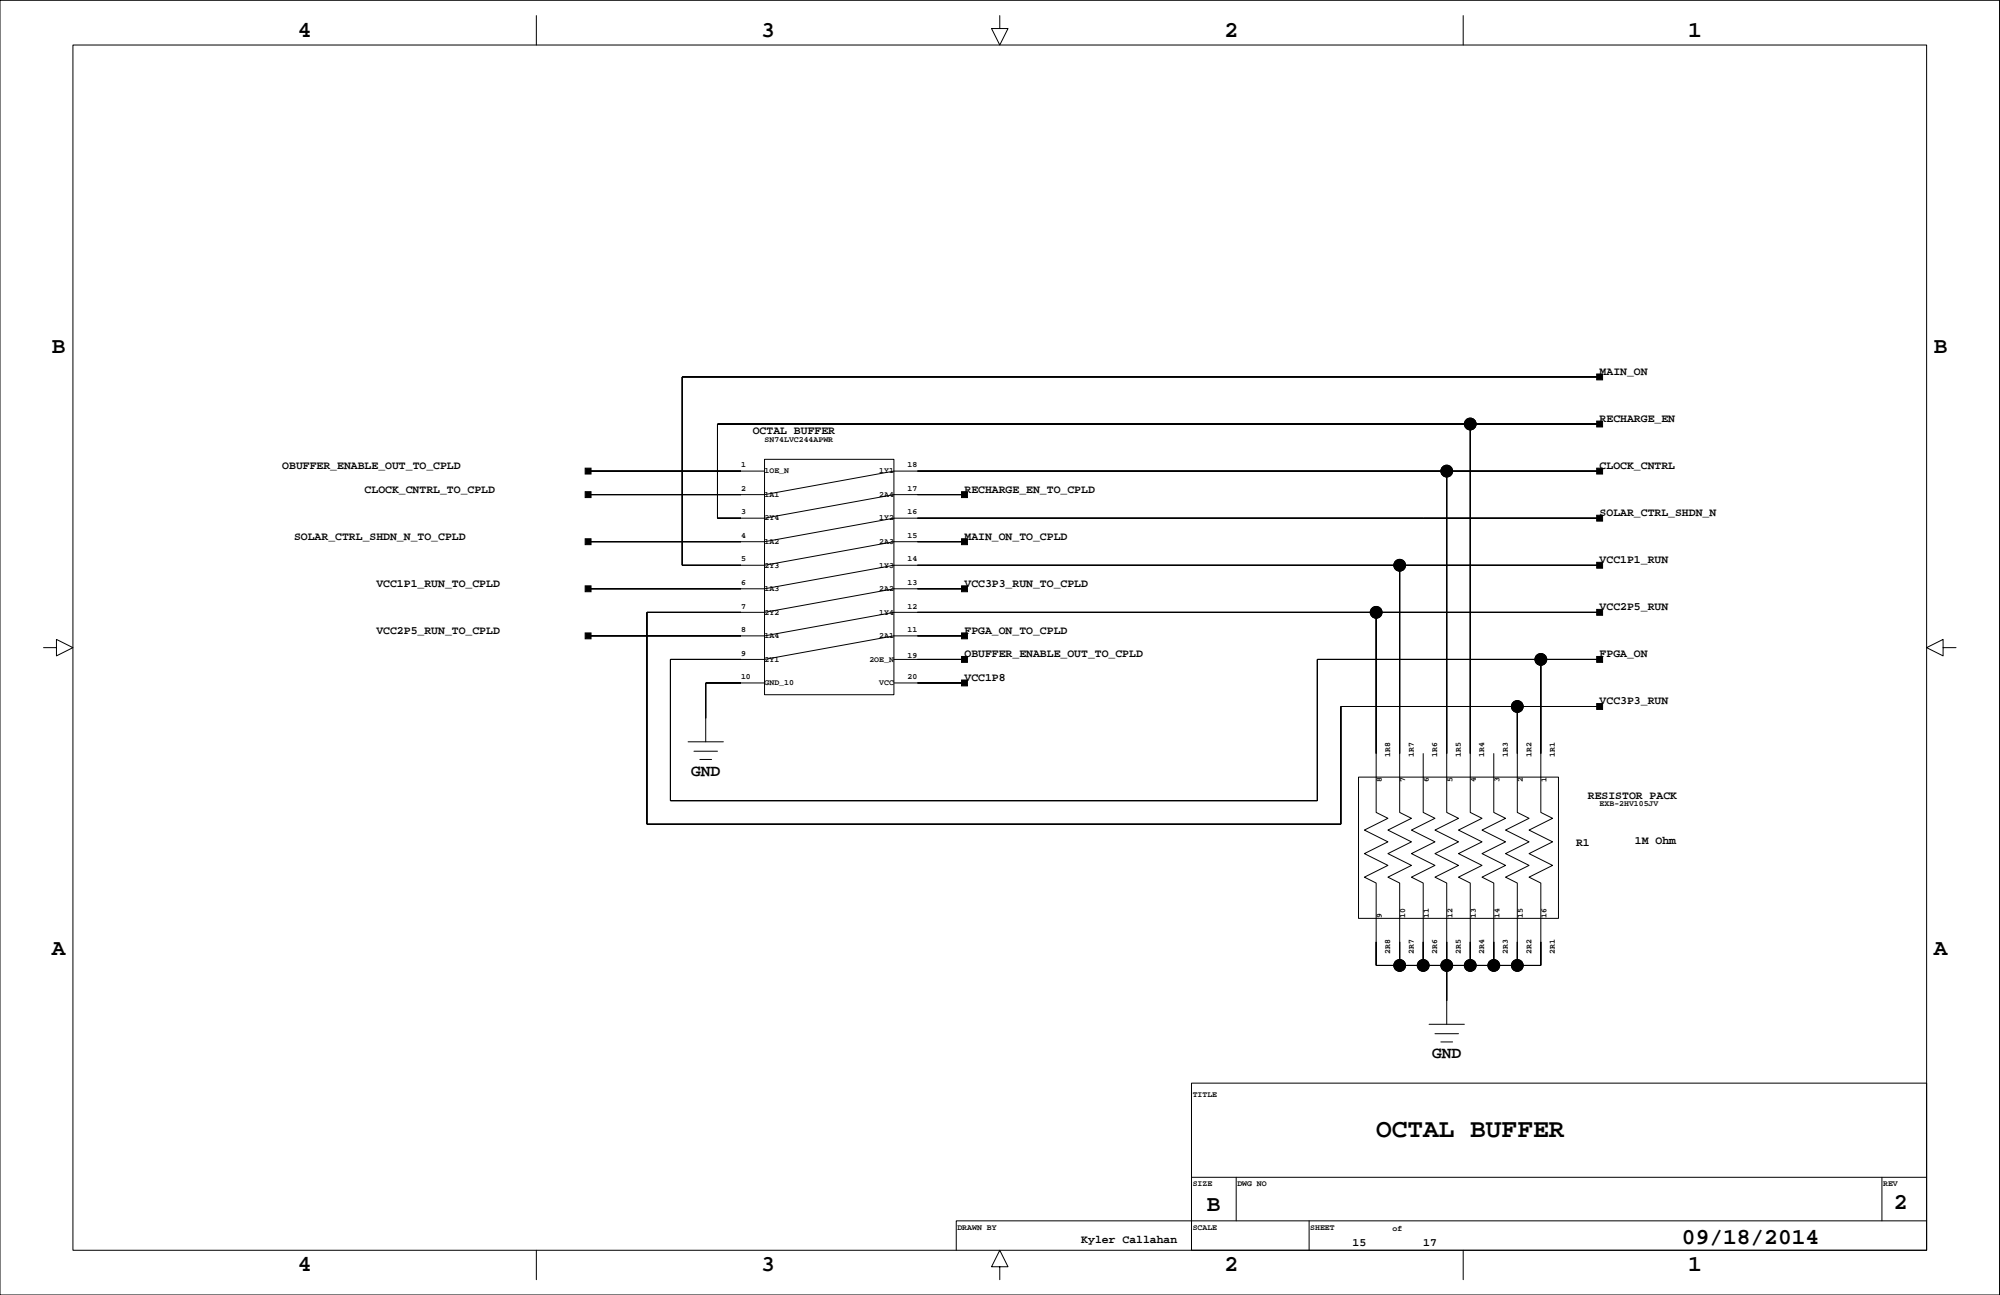
[picture p227: page 15]
GND_10; VCC; GND; VCC1P8; 1M Ohm; VCC1P1_RUN_TO_CPLD; VCC3P3_RUN_TO_CPLD; CLOCK_CNTRL; RECHARGE_EN; SOLAR_CTRL_SHDN_N; MAIN_ON; VCC1P1_RUN; CLOCK_CNTRL_TO_CPLD; VCC3P3_RUN; OBUFFER_ENABLE_OUT_TO_CPLD; OCTAL BUFFER SN74LVC244APWR; EXB-2HV105JV; RESISTOR PACK; VCC2P5_RUN_TO_CPLD; SOLAR_CTRL_SHDN_N_TO_CPLD; FPGA_ON_TO_CPLD; VCC2P5_RUN; MAIN_ON_TO_CPLD; FPGA_ON; RECHARGE_EN_TO_CPLD; TITLE; Kyler Callahan; OCTAL BUFFER

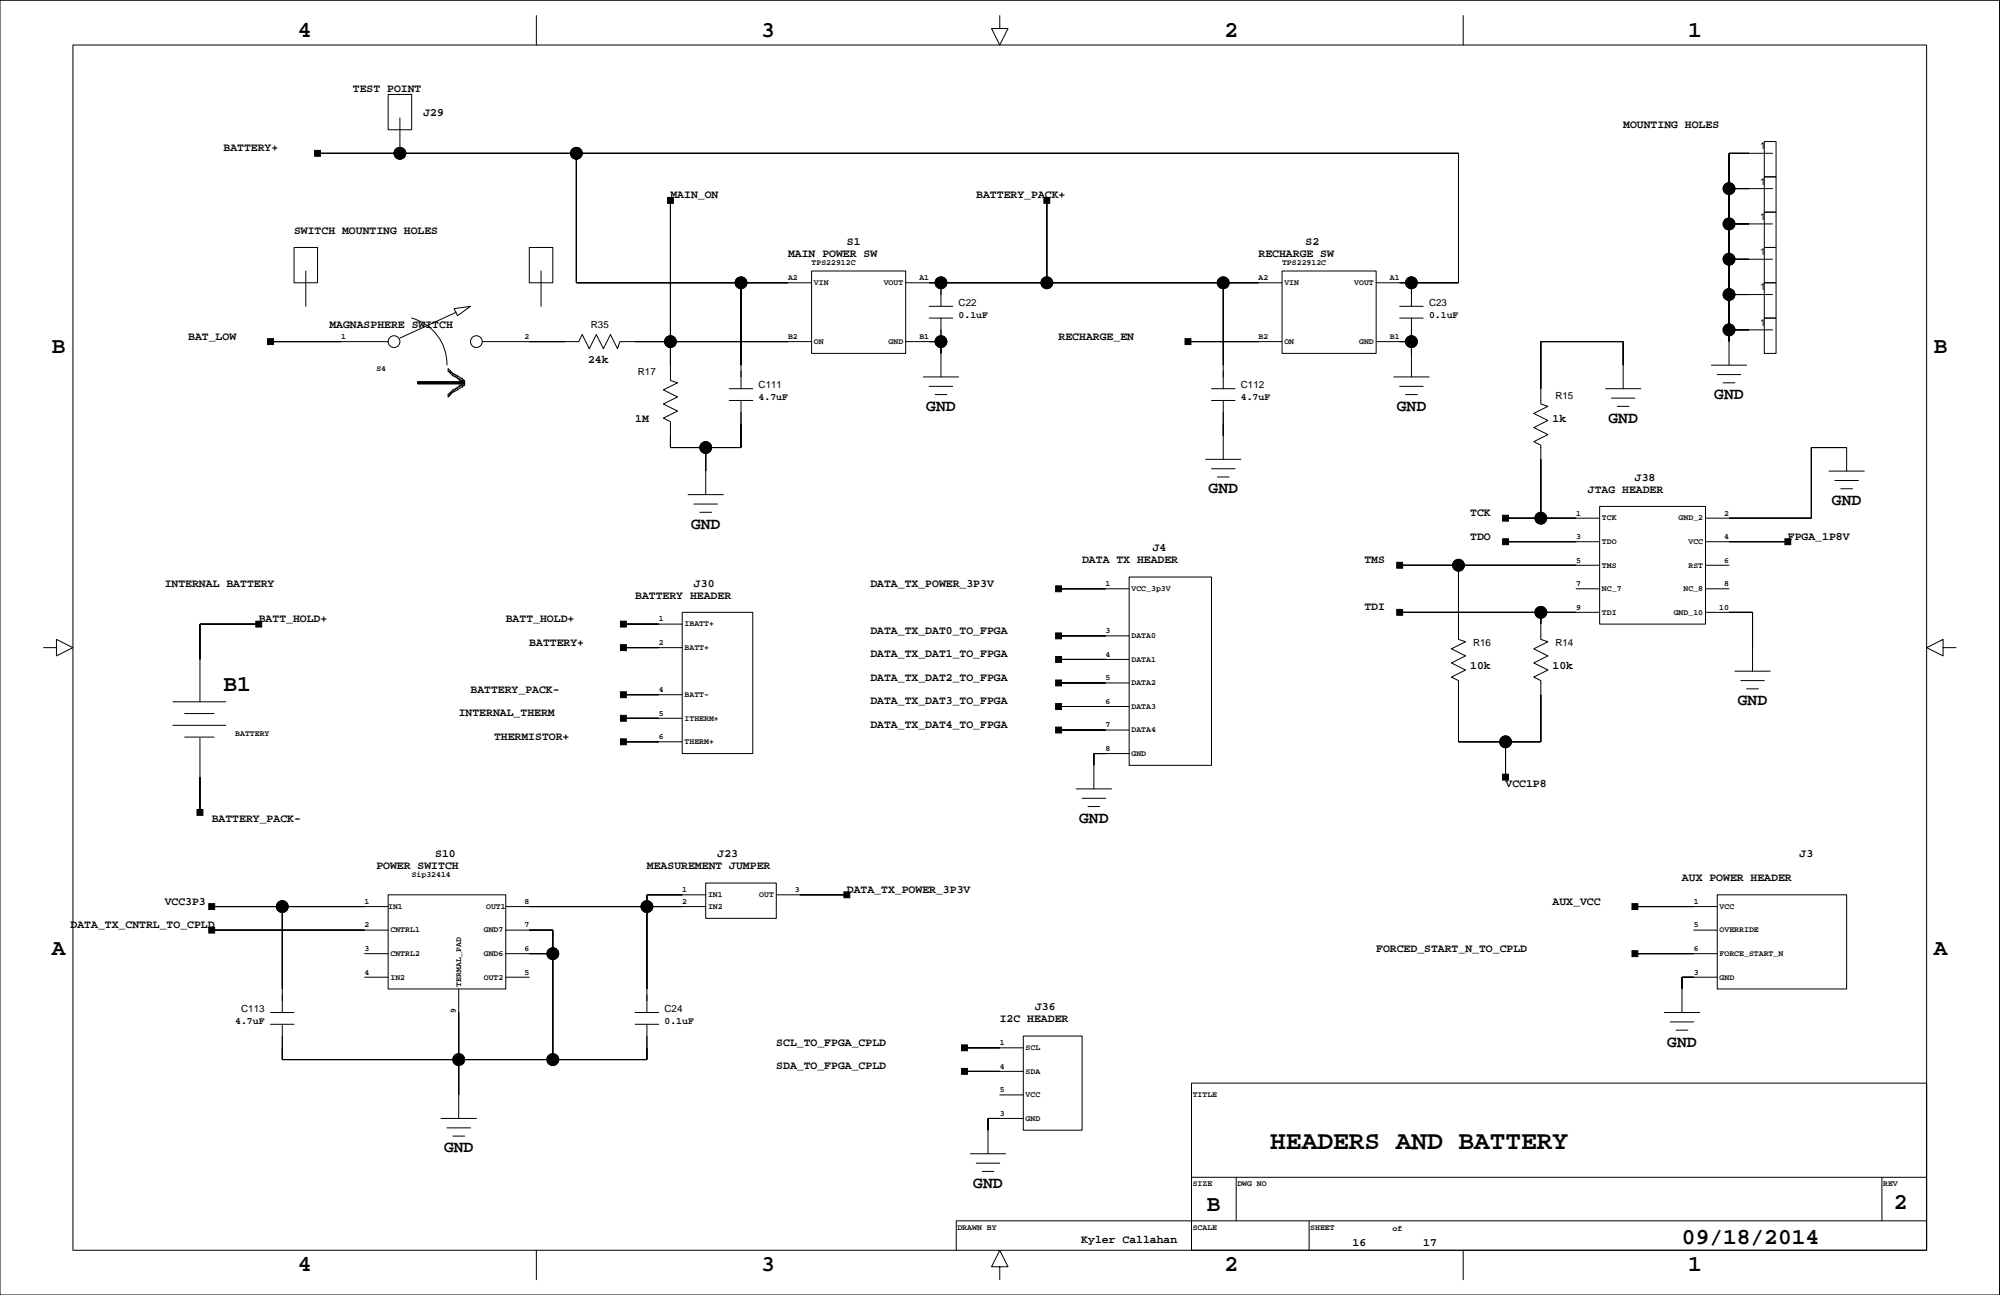
[picture p228: page 16]

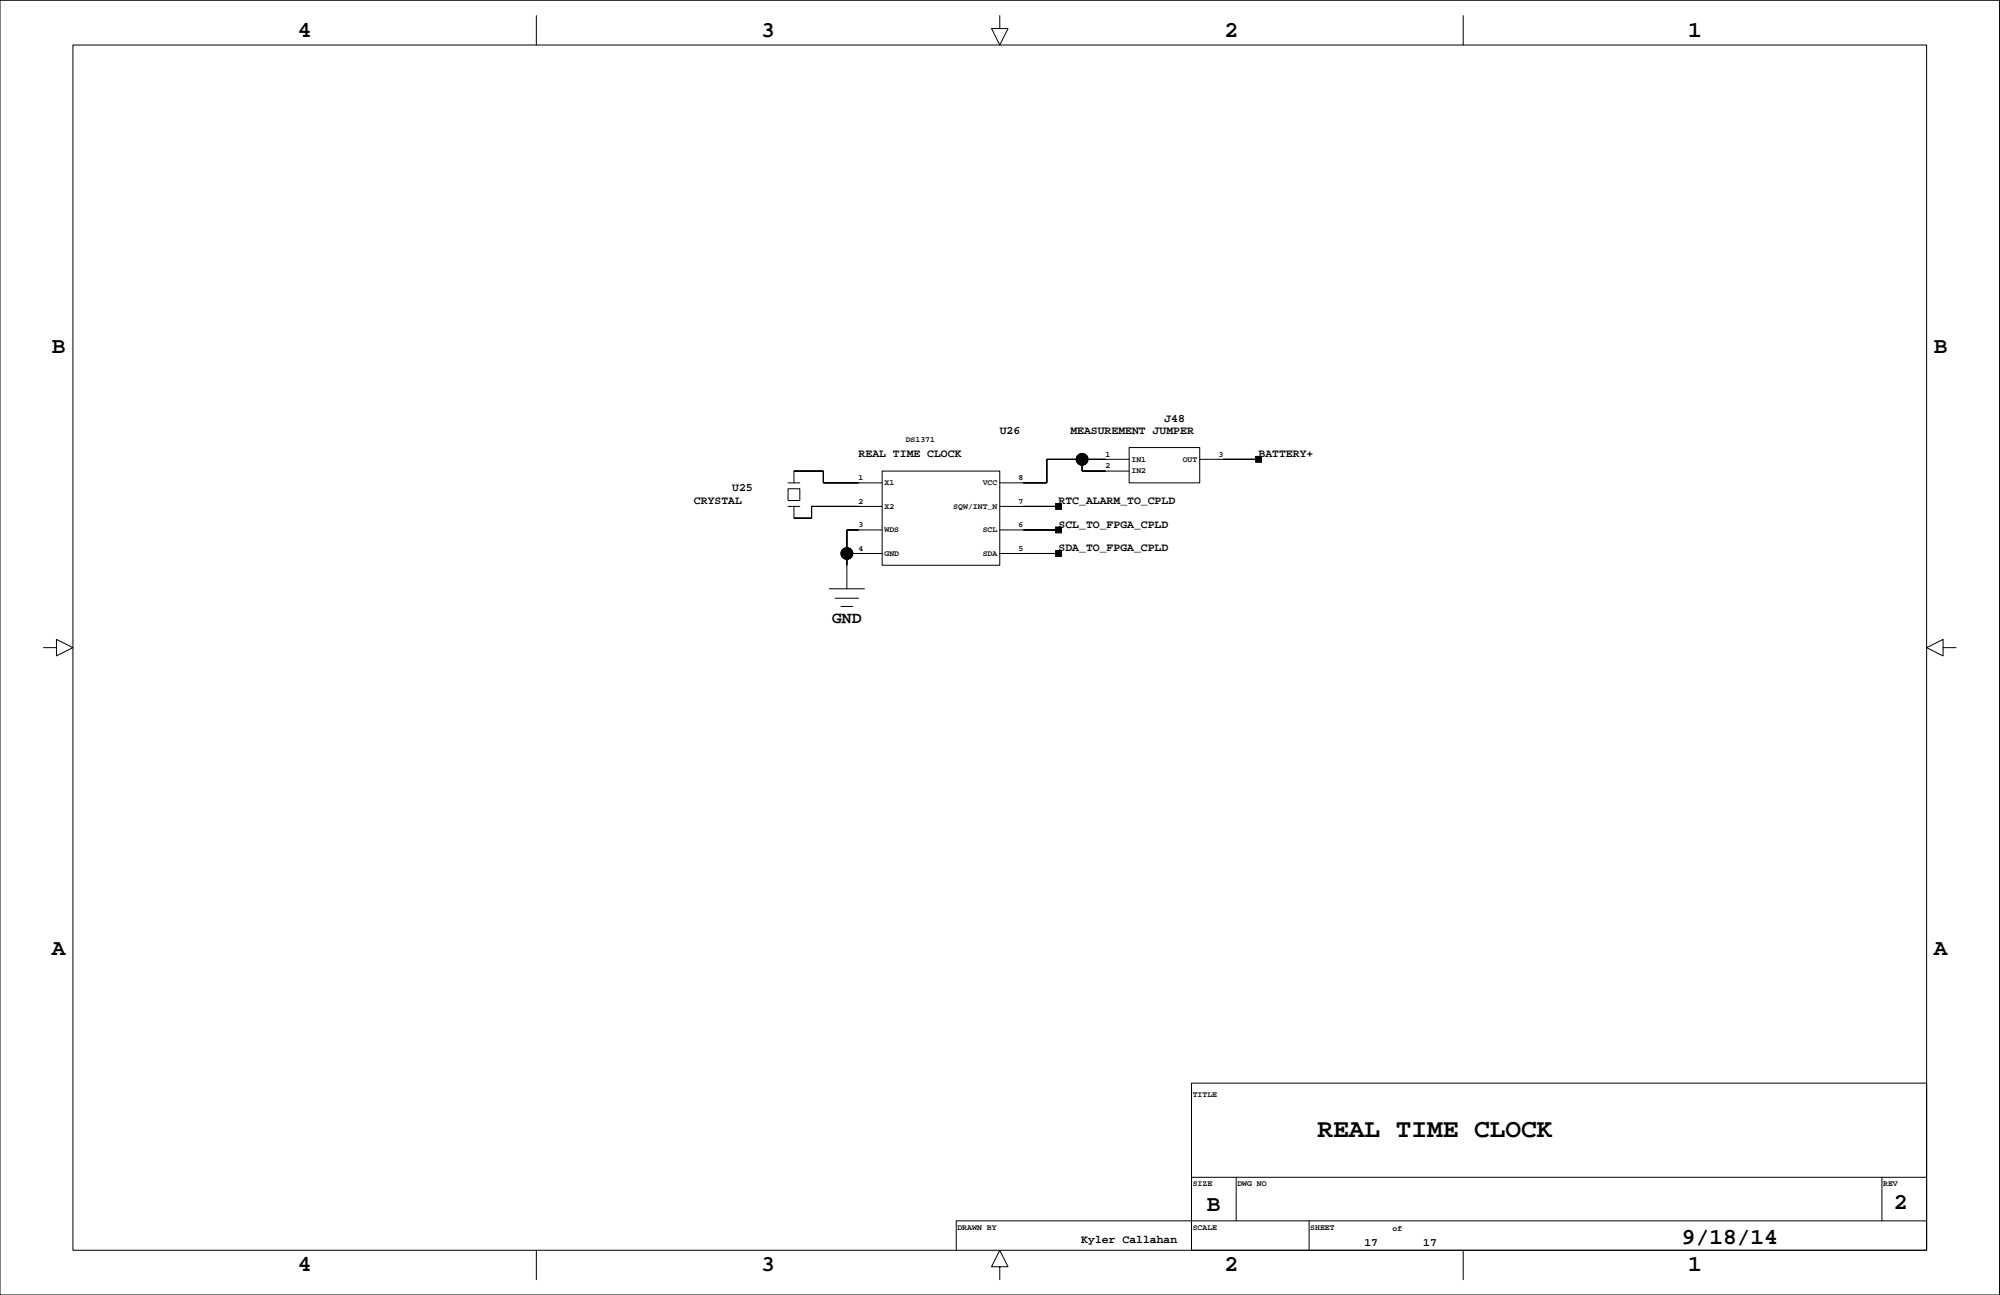
[picture p229: page 17]
TITLE; WDS; GND; VCC; SQW/INT_N; SCL; SDA; CRYSTAL; OUT; MEASUREMENT JUMPER; SCL_TO_FPGA_CPLD; SDA_TO_FPGA_CPLD; RTC_ALARM_TO_CPLD; BATTERY+

REAL TIME CLOCK
