rksnider/SensorCollar/Documentation/Interface_Board_v1.pdf

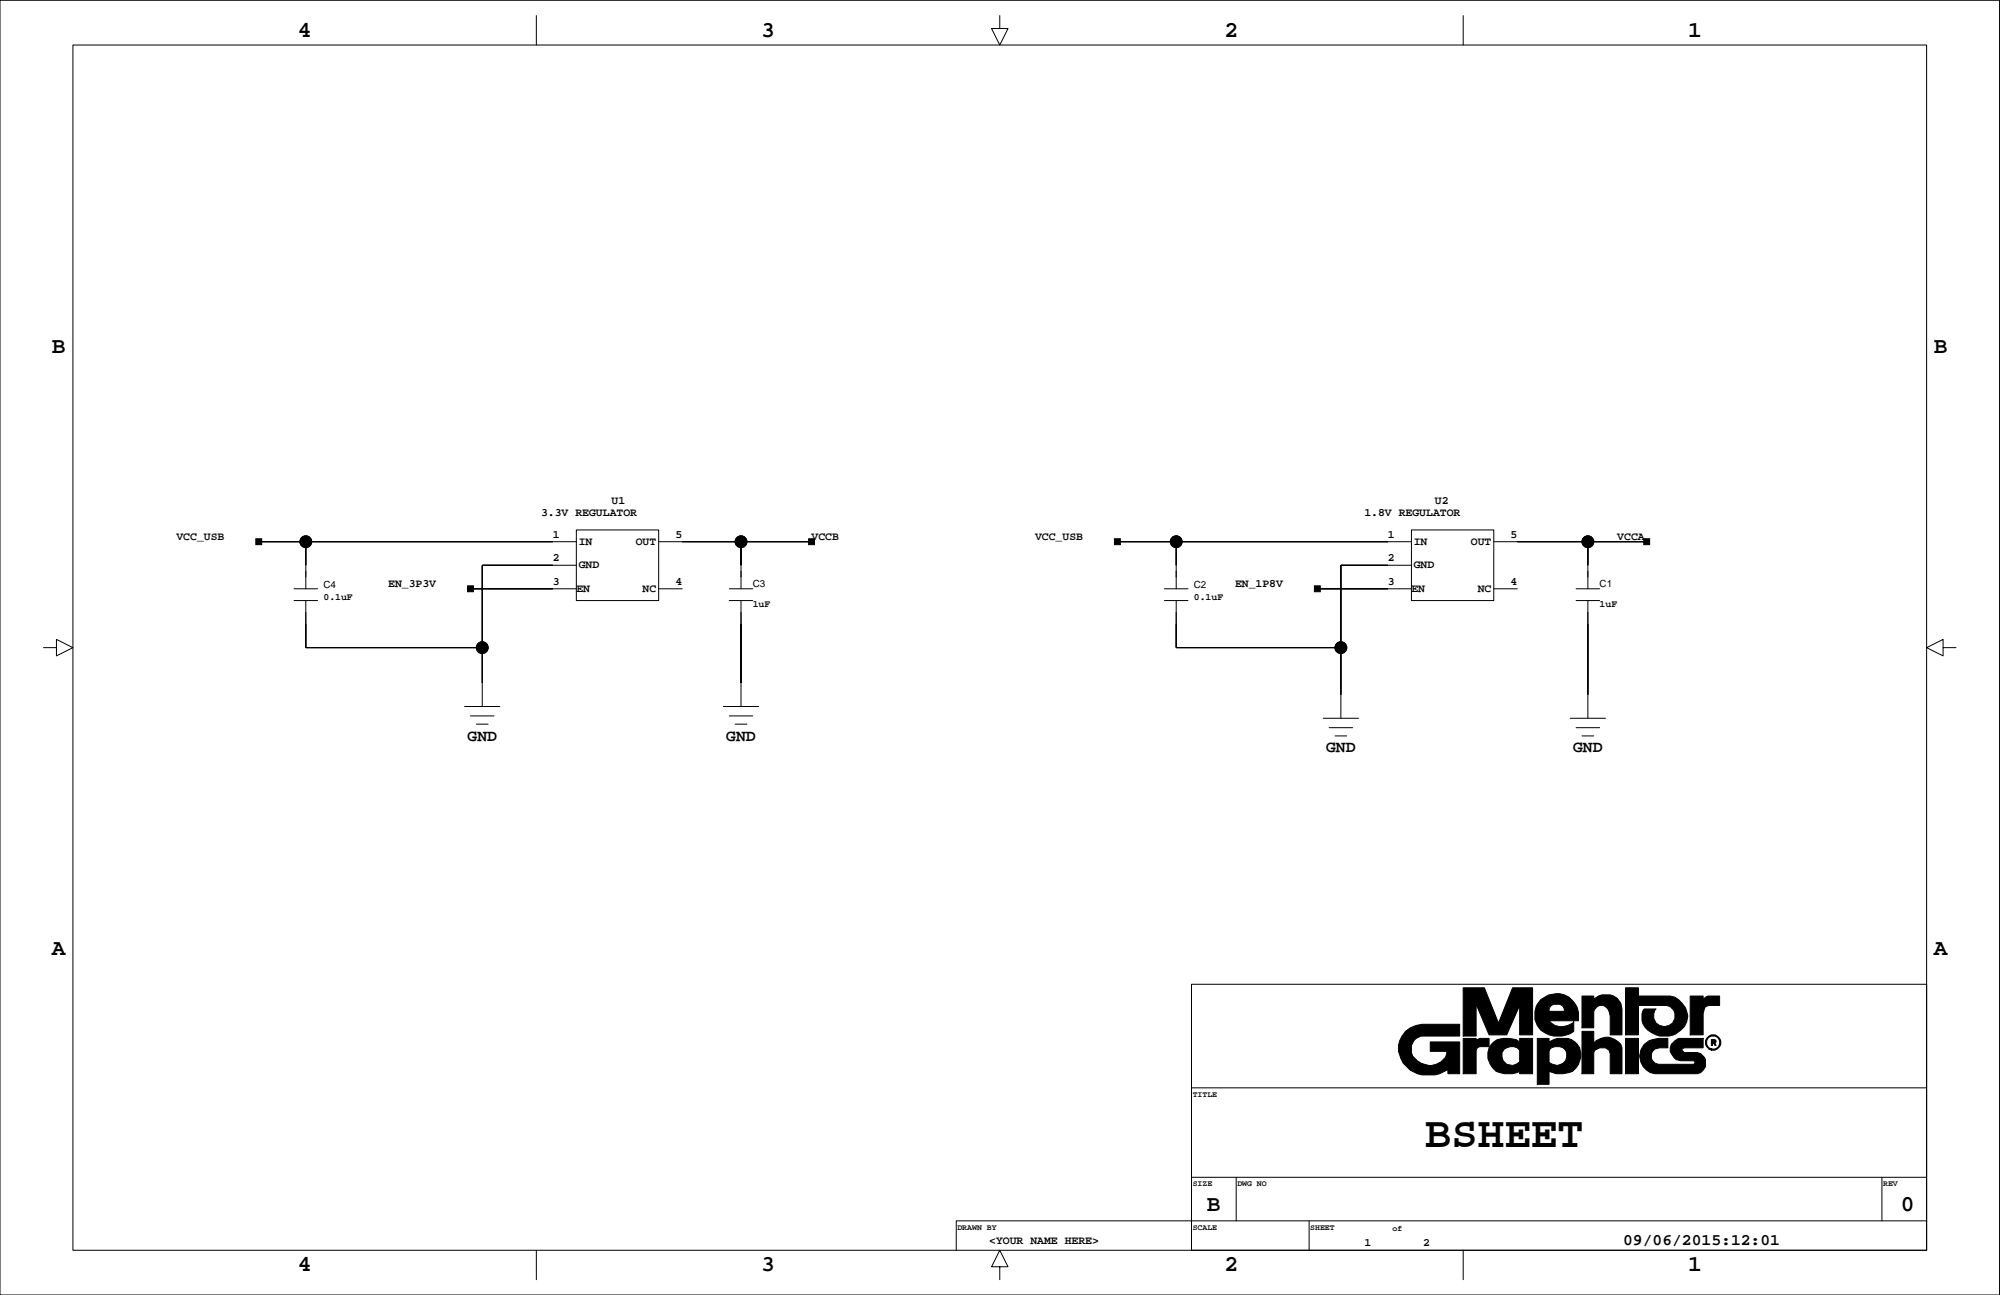
[picture p230: page 1]
REV; TITLE; SCALE; SIZE; DWG NO; SHEET; DRAWN BY; <YOUR NAME HERE>; BSHEET; GND; VCCA; VCC_USB; OUT; VCCB; 3.3V REGULATOR; 1.8V REGULATOR

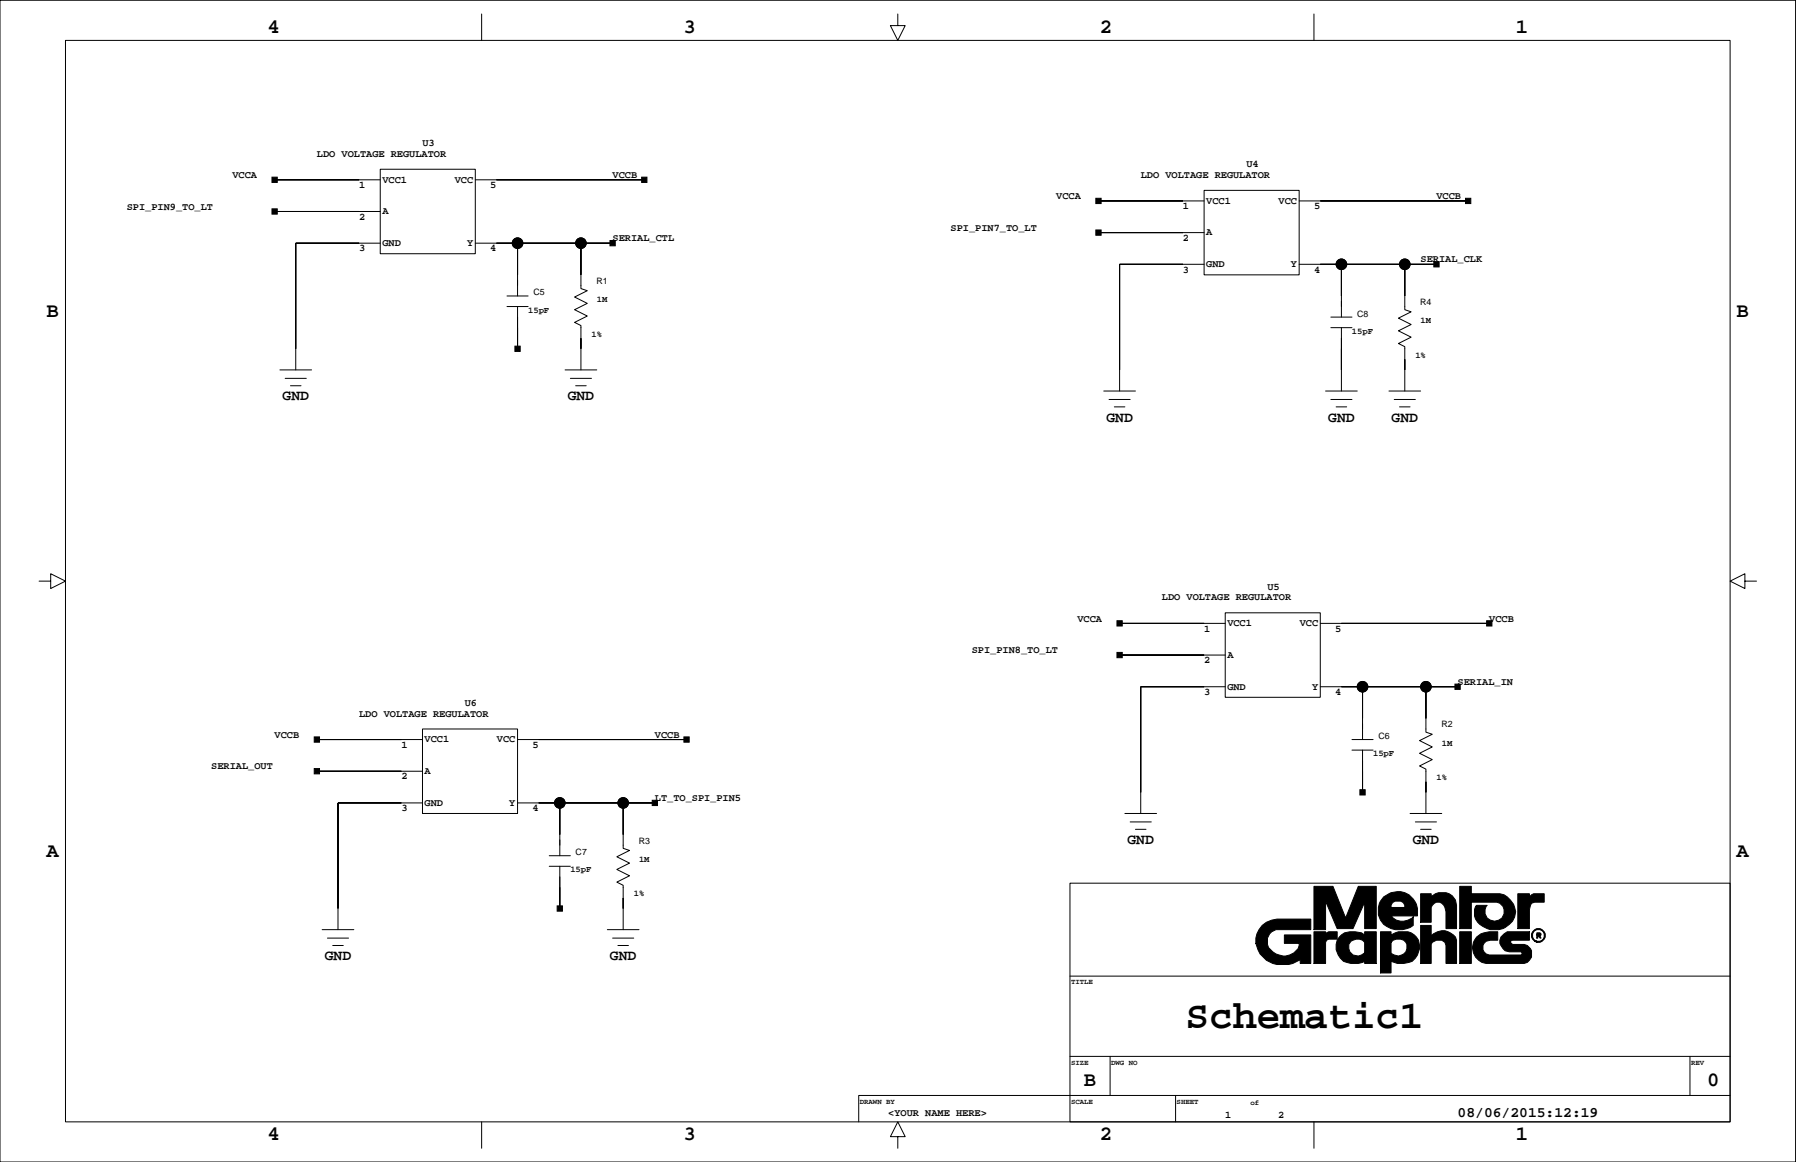
[picture p231: page 2]

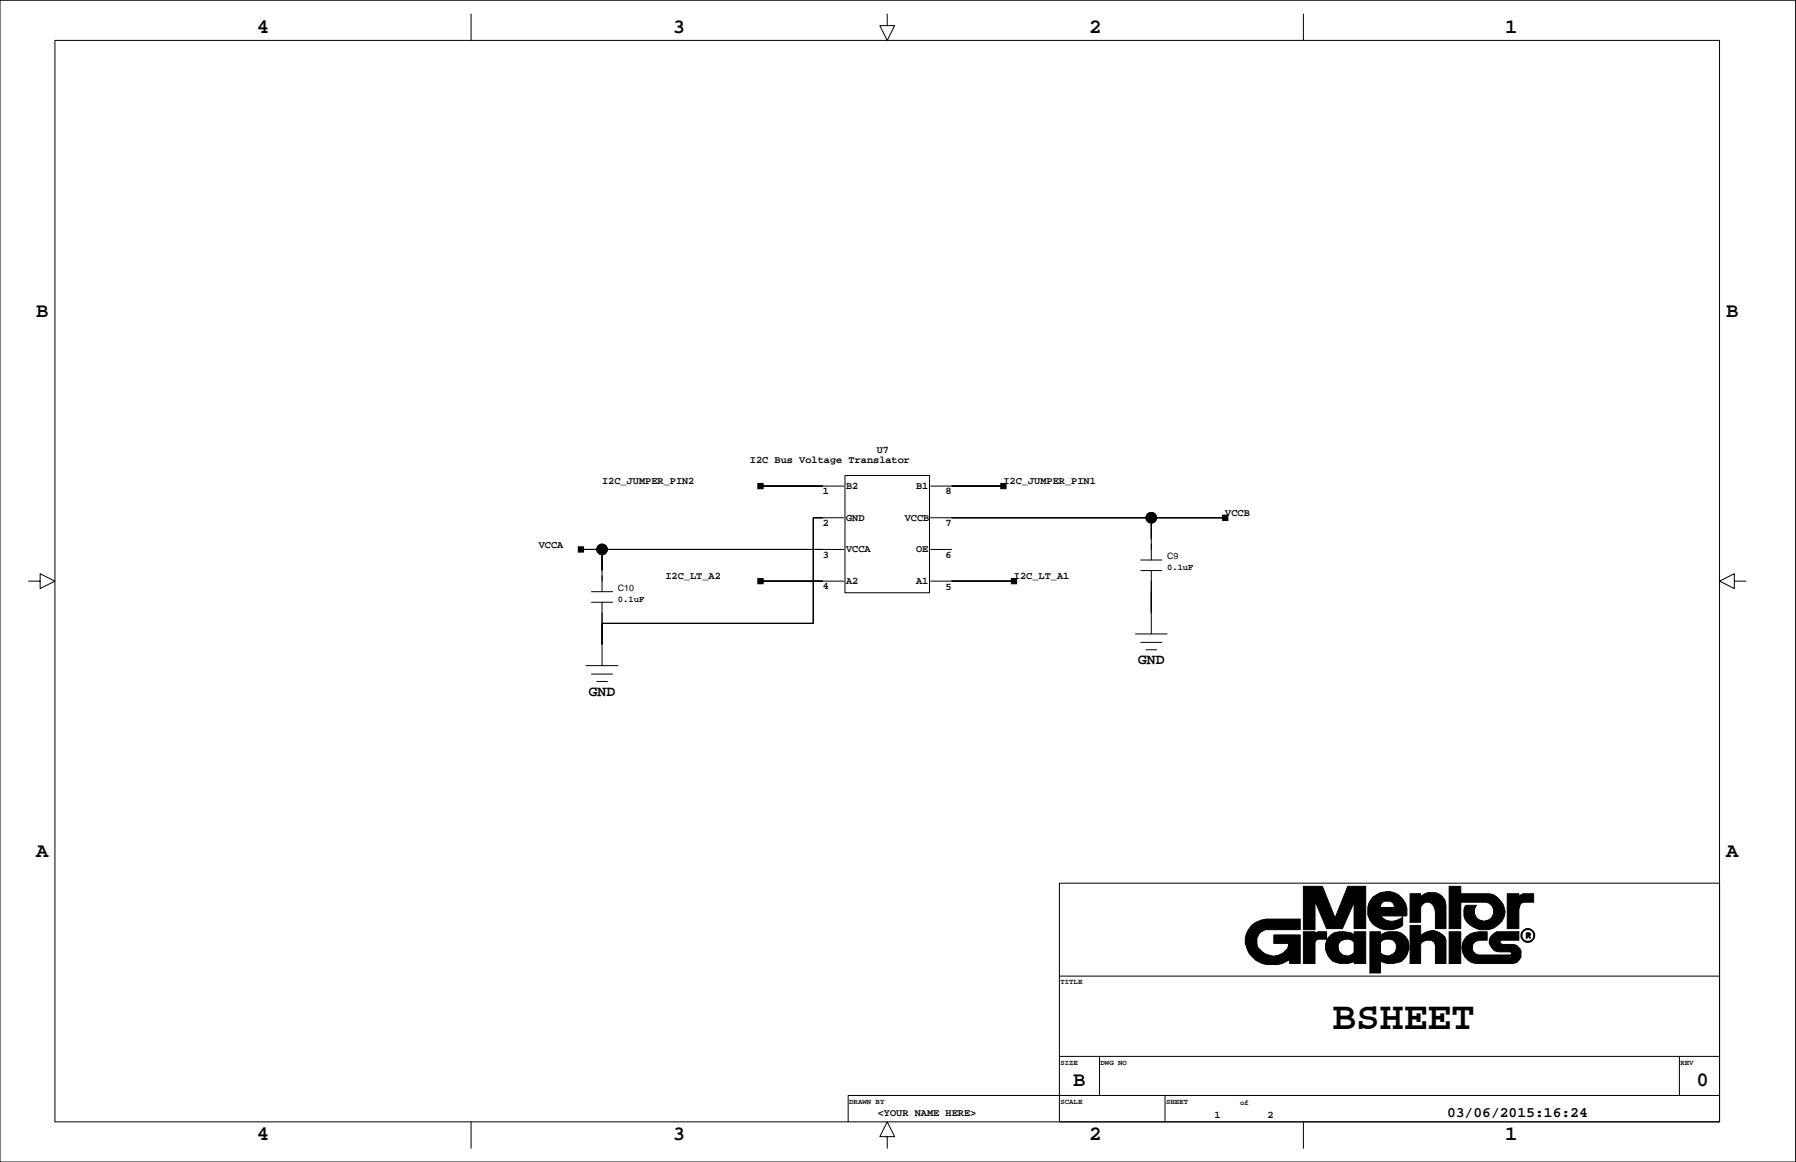
[picture p232: page 3]
TITLE; BSHEET; GND; VCCA; VCCB; I2C_JUMPER_PIN2; I2C_JUMPER_PIN1

I2C Bus Voltage Translator

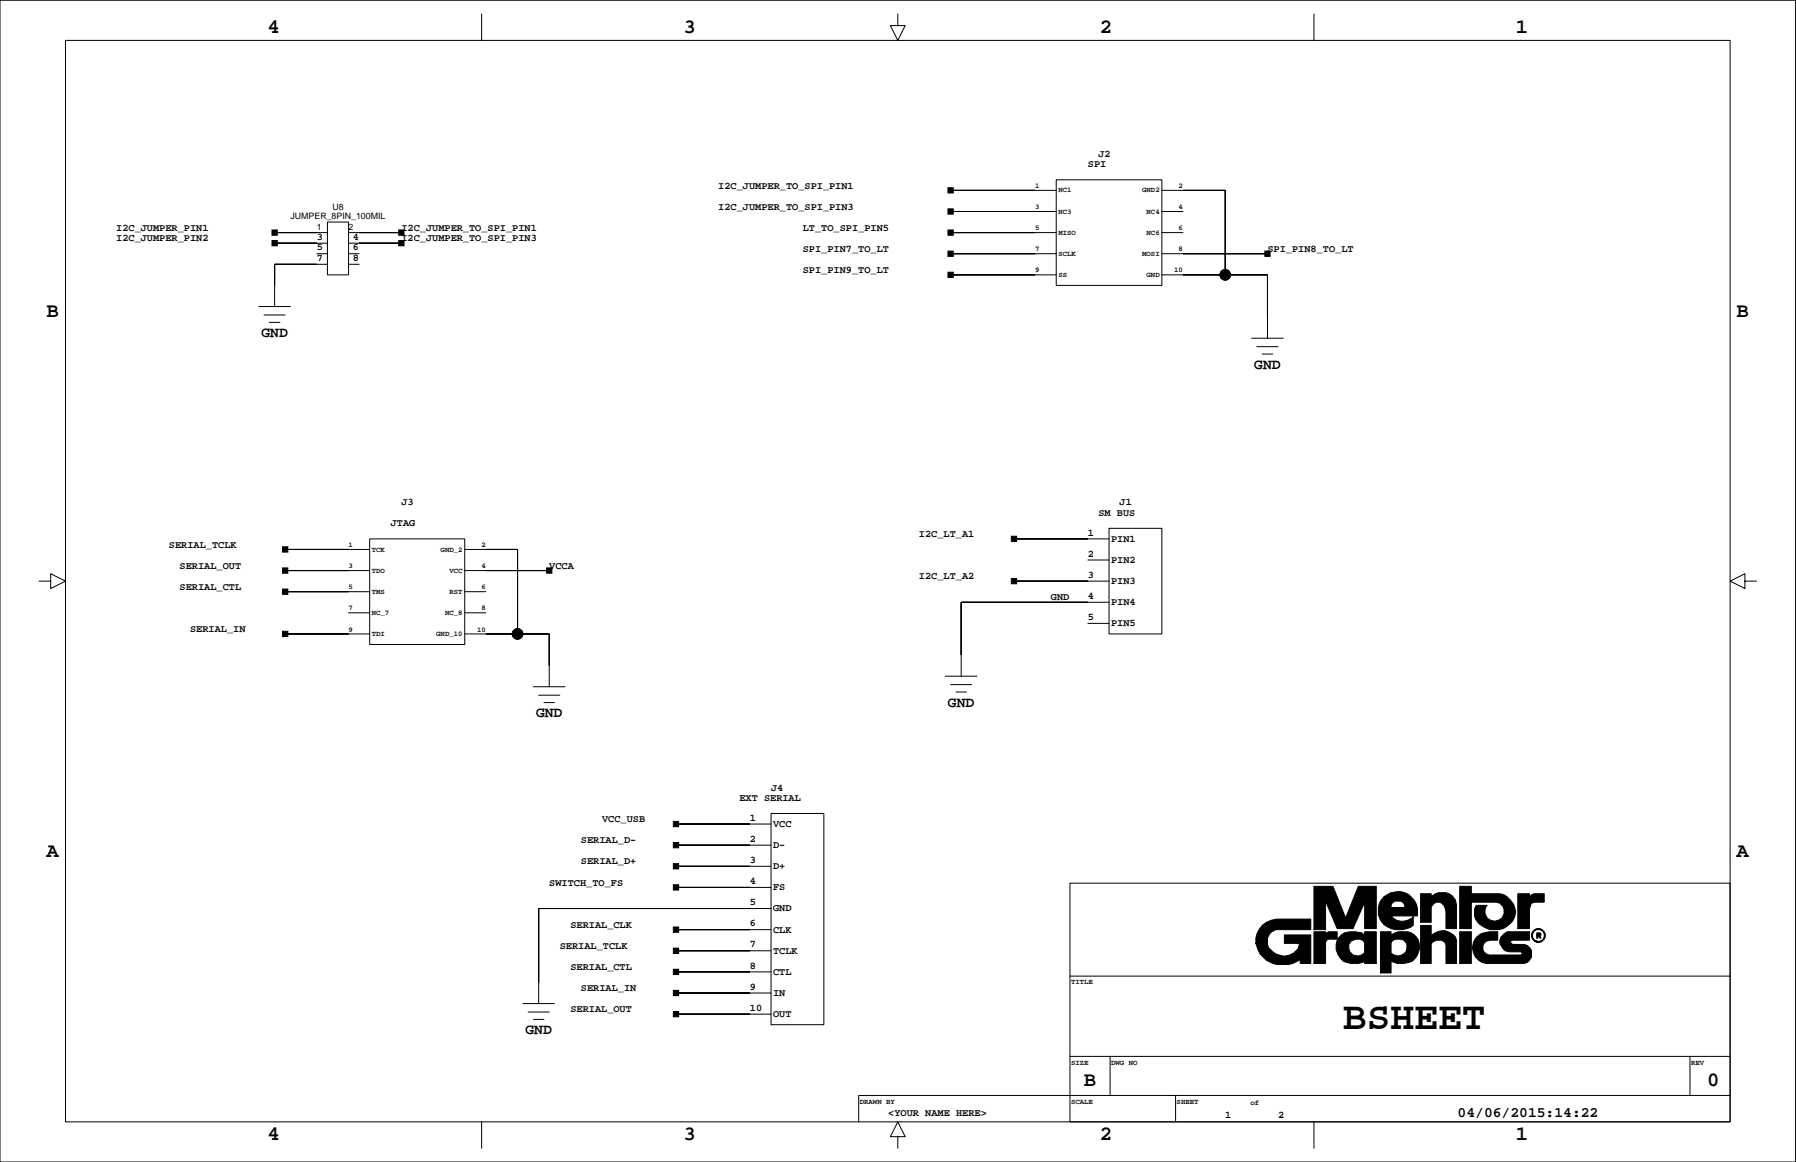
[picture p233: page 4]
TITLE; BSHEET; JUMPER_8PIN_100MIL; GND; I2C_JUMPER_PIN1 I2C_JUMPER_PIN2; I2C_JUMPER_TO_SPI_PIN1 I2C_JUMPER_TO_SPI_PIN3; MISO; SCLK; GND2; MOSI; I2C_JUMPER_TO_SPI_PIN1; I2C_JUMPER_TO_SPI_PIN3; LT_TO_SPI_PIN5; SPI_PIN7_TO_LT; SPI_PIN9_TO_LT; SPI_PIN8_TO_LT; TCK; TDO; TMS; TDI; GND_2; VCC; RST; GND_10; SERIAL_TCLK; SERIAL_OUT; SERIAL_CTL; SERIAL_IN; VCCA; PIN1; PIN2; PIN3; PIN4; PIN5; SM BUS; SPI; JTAG; CLK; TCLK; CTL; OUT; EXT SERIAL; VCC_USB; SERIAL_D-; SERIAL_D+; SWITCH_TO_FS; SERIAL_CLK

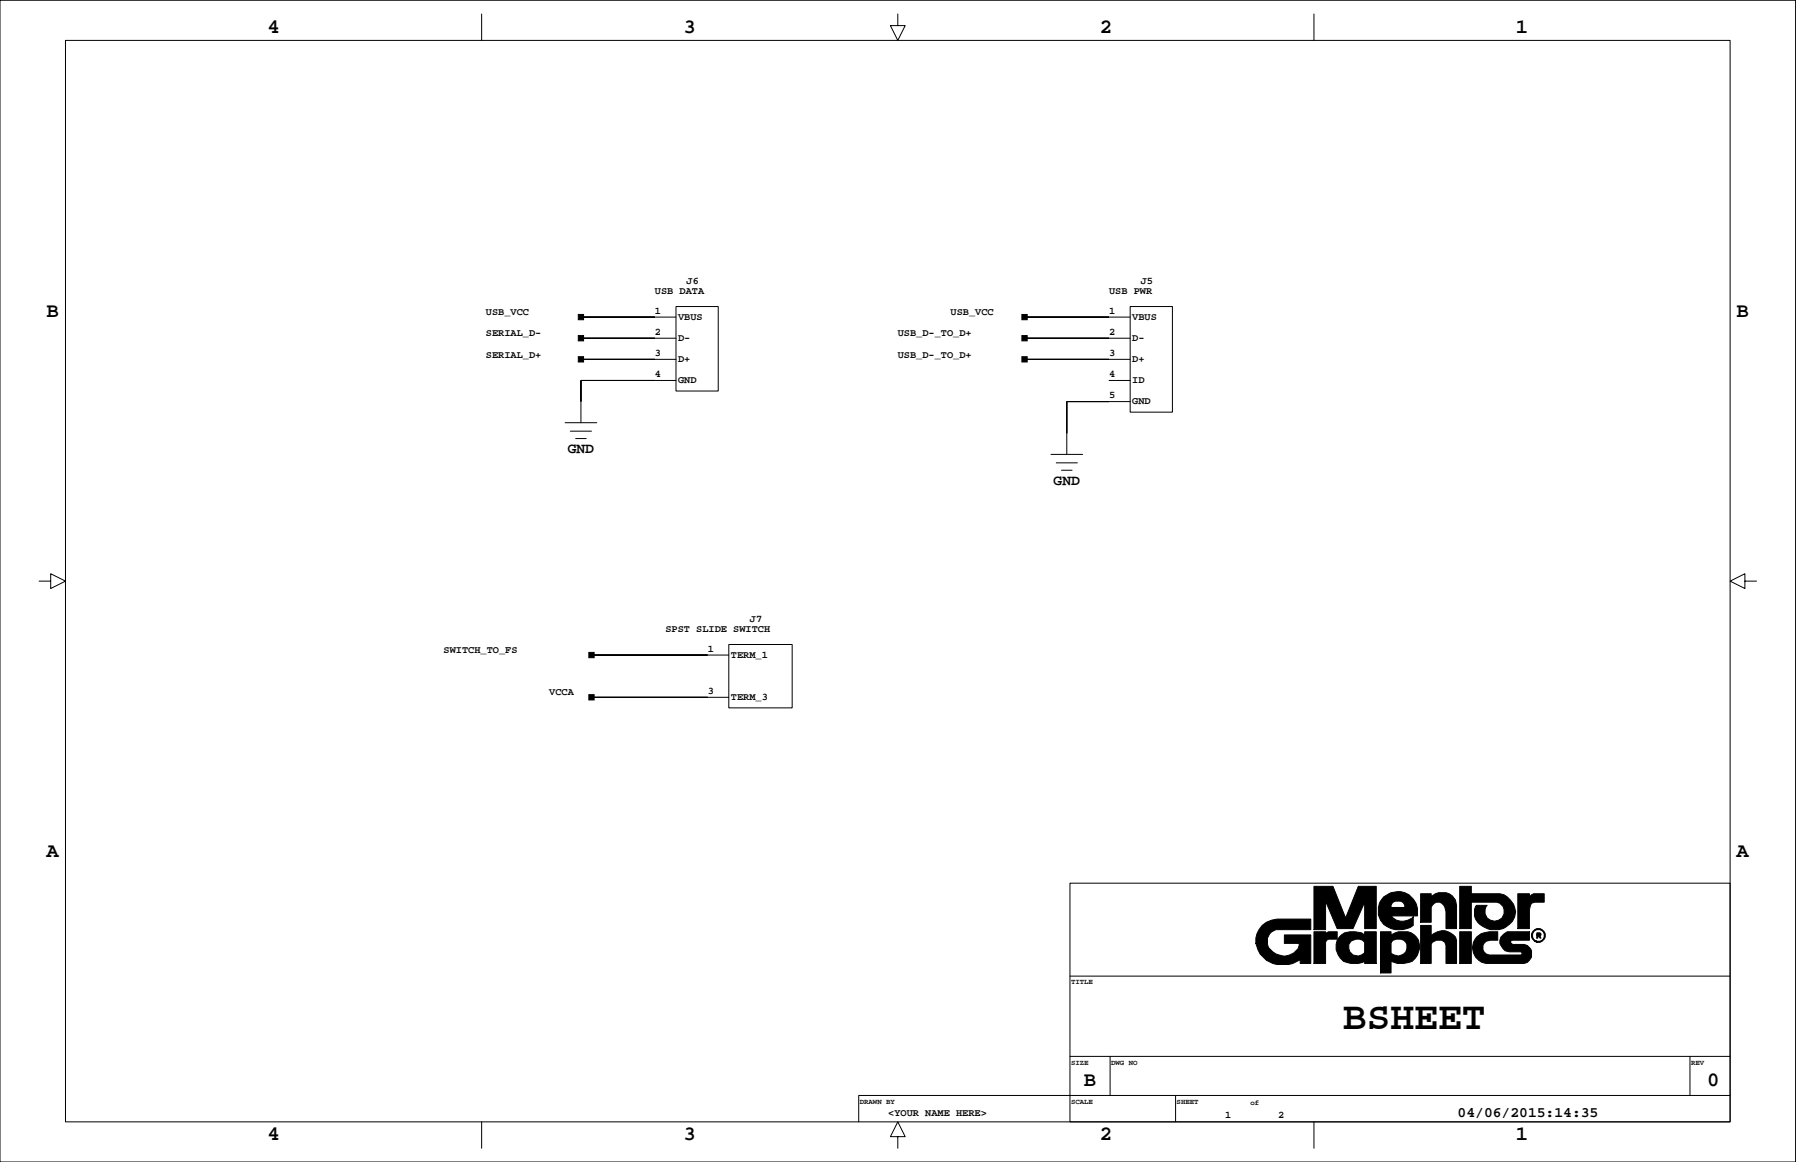
[picture p234: page 5]
TITLE; BSHEET; VBUS; GND; USB DATA; USB_VCC; SERIAL_D-; USB_D-_TO_D+; TERM_1; TERM_3; SWITCH_TO_FS; VCCA; USB PWR; SERIAL_D+

SPST SLIDE SWITCH
