rksnider/SensorCollar/PCB_Designs/Interface_Board/top_silk.pdf

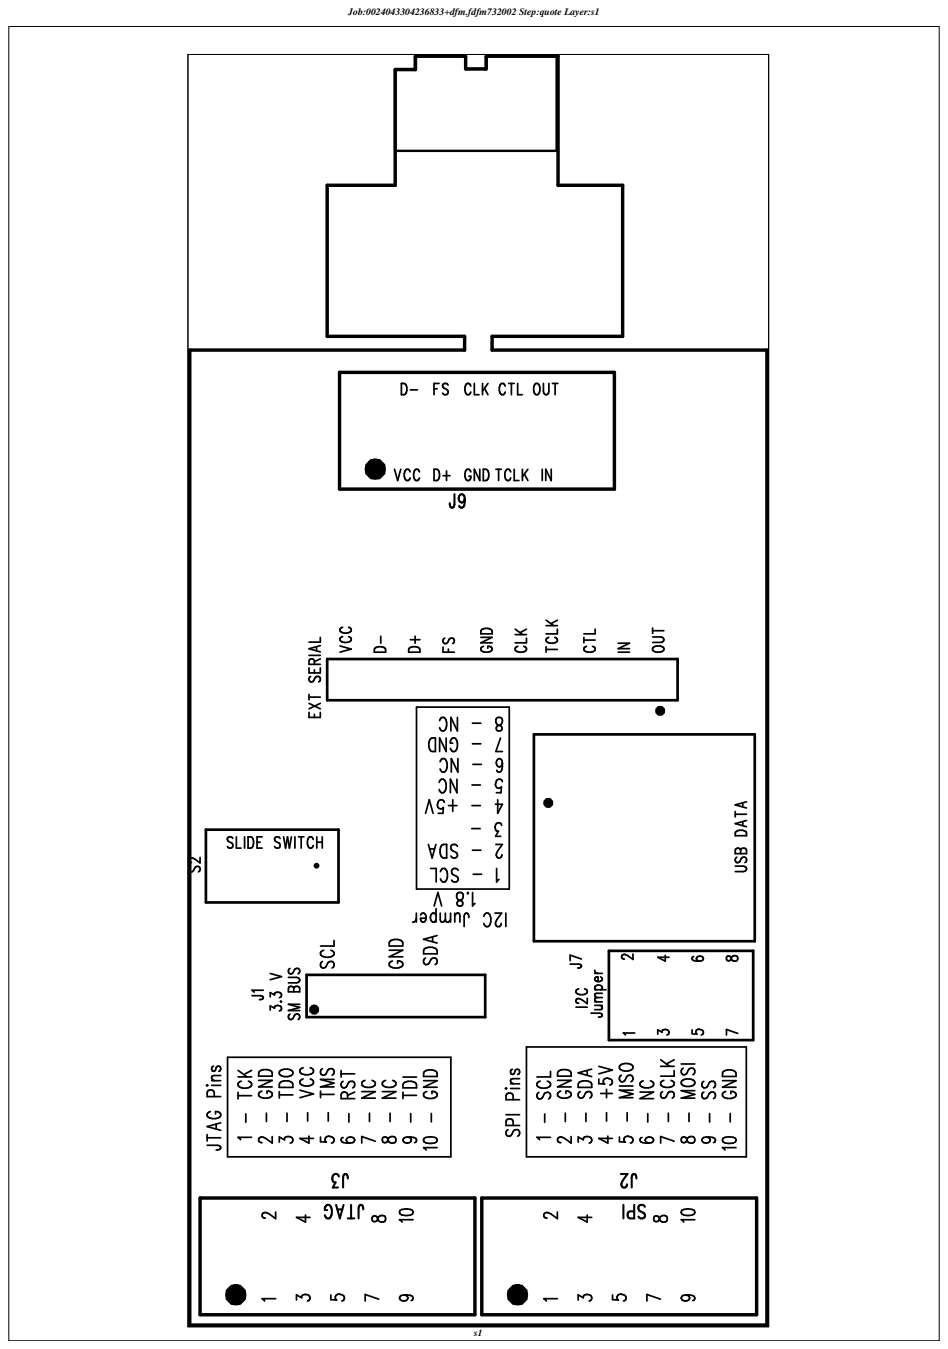
[picture p235: page 1]

Job:0024043304236833+dfm.fdfm732002 Step:quote Layer:s1
