rksnider/SensorCollar/PCB_Designs/Data_TRX/Data_TRX_v1_working.pdf

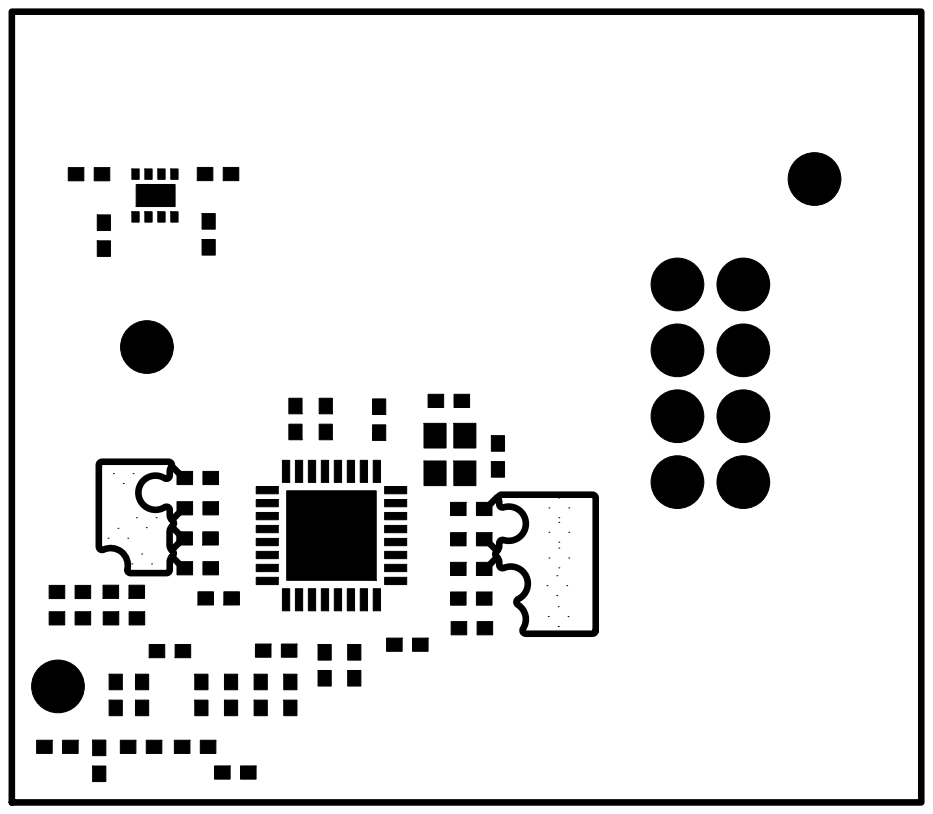
[picture p236: page 1]

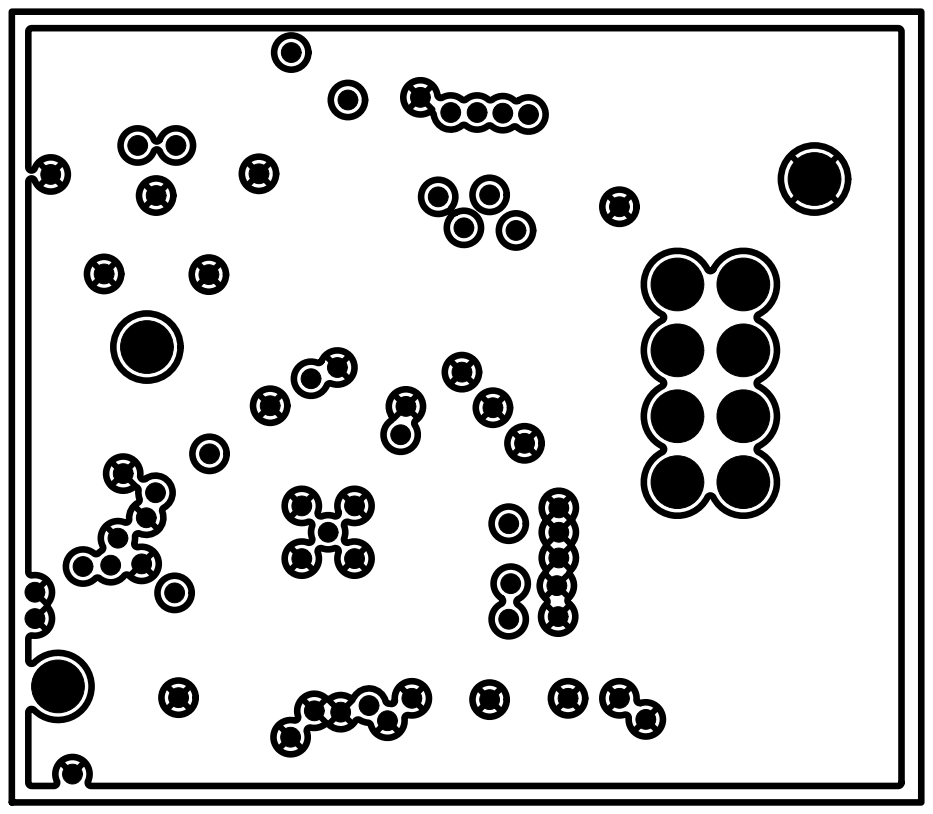
[picture p237: page 2]
AE2AE²x1

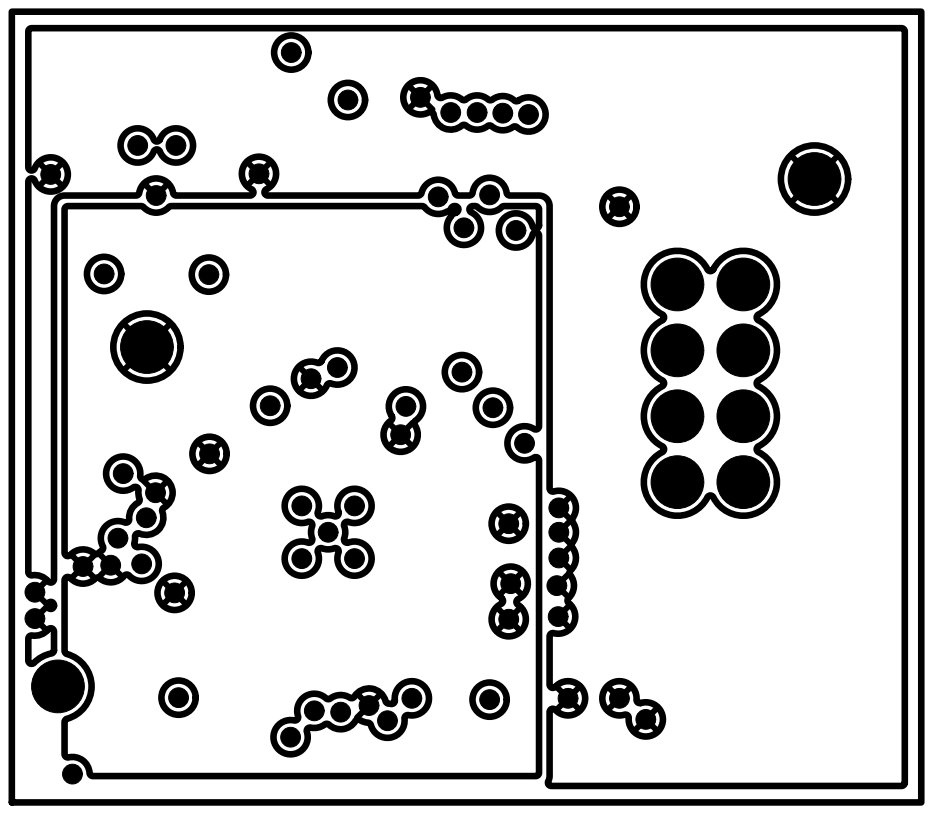
[picture p238: page 3]
AE2AE²x1

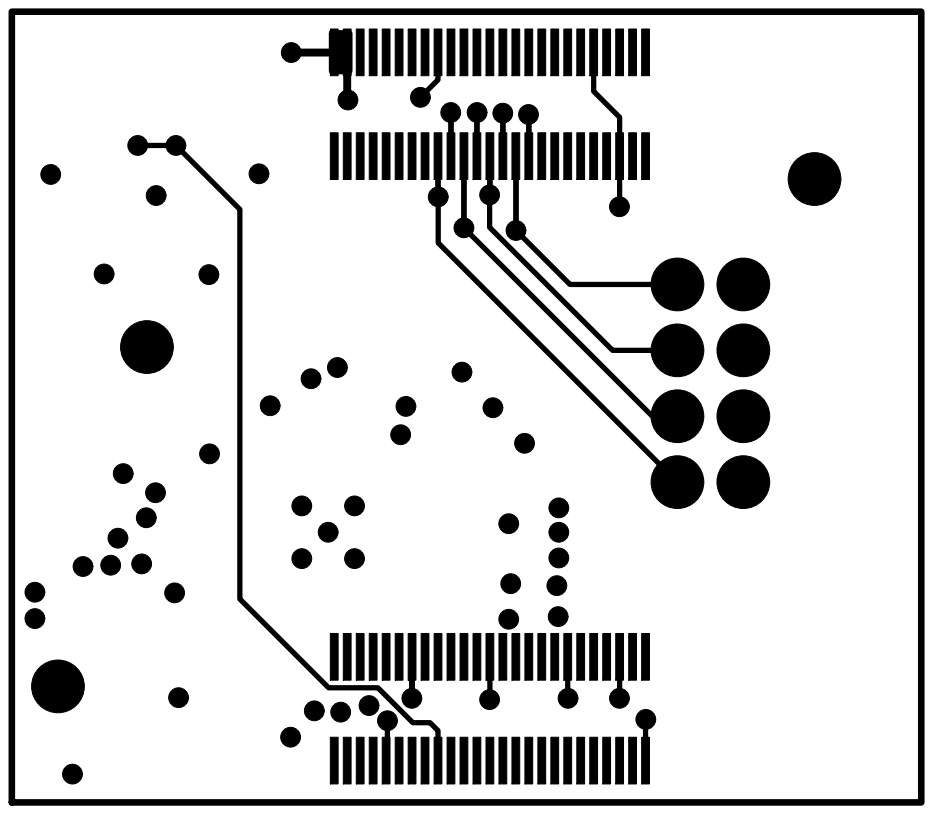
[picture p239: page 4]
AE2AE²x1

J2

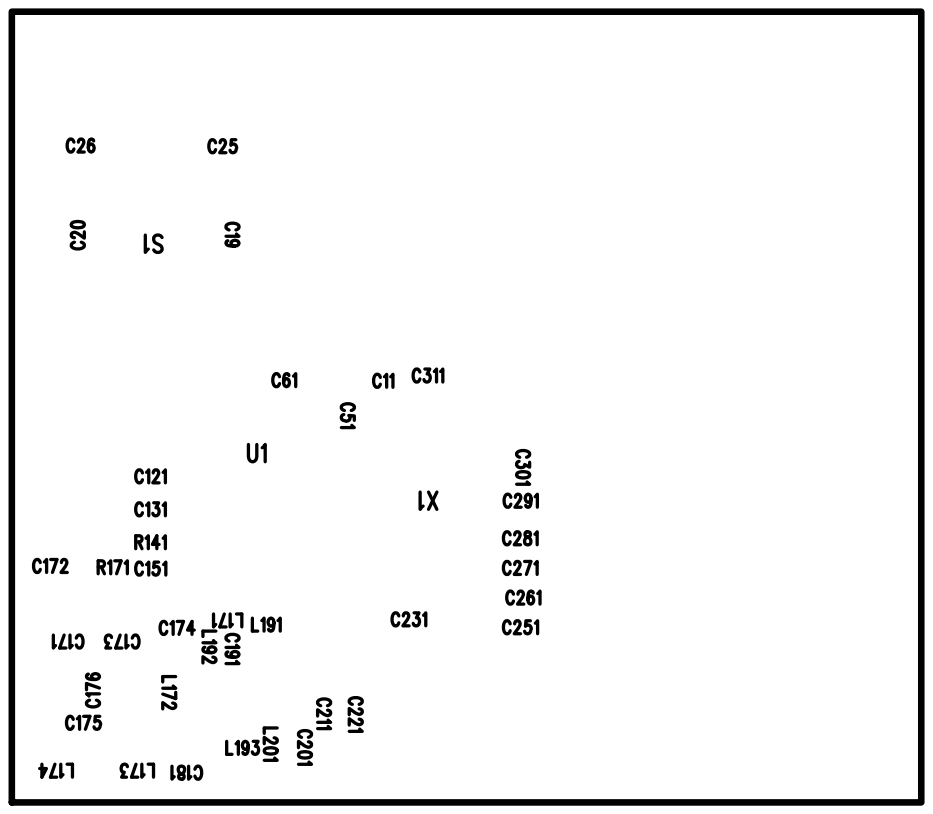
[picture p240: page 9]

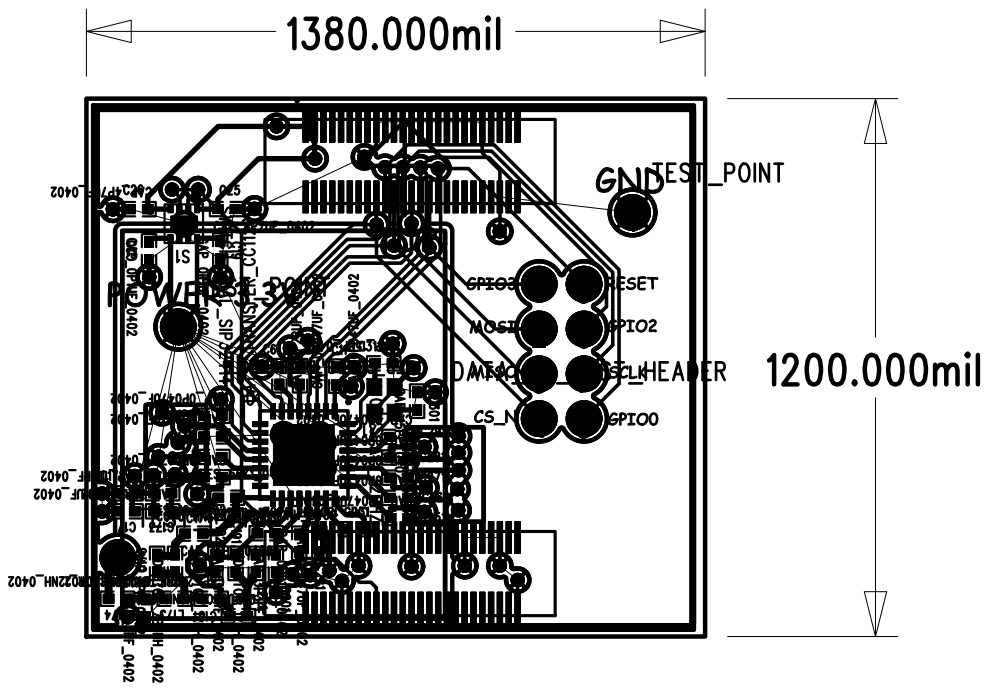
[picture p241: page 11]
