rksnider/SensorCollar/PCB_Designs/TEST_BOARD/TEST_BOARD.pdf

4 | 3 | 2 | 1

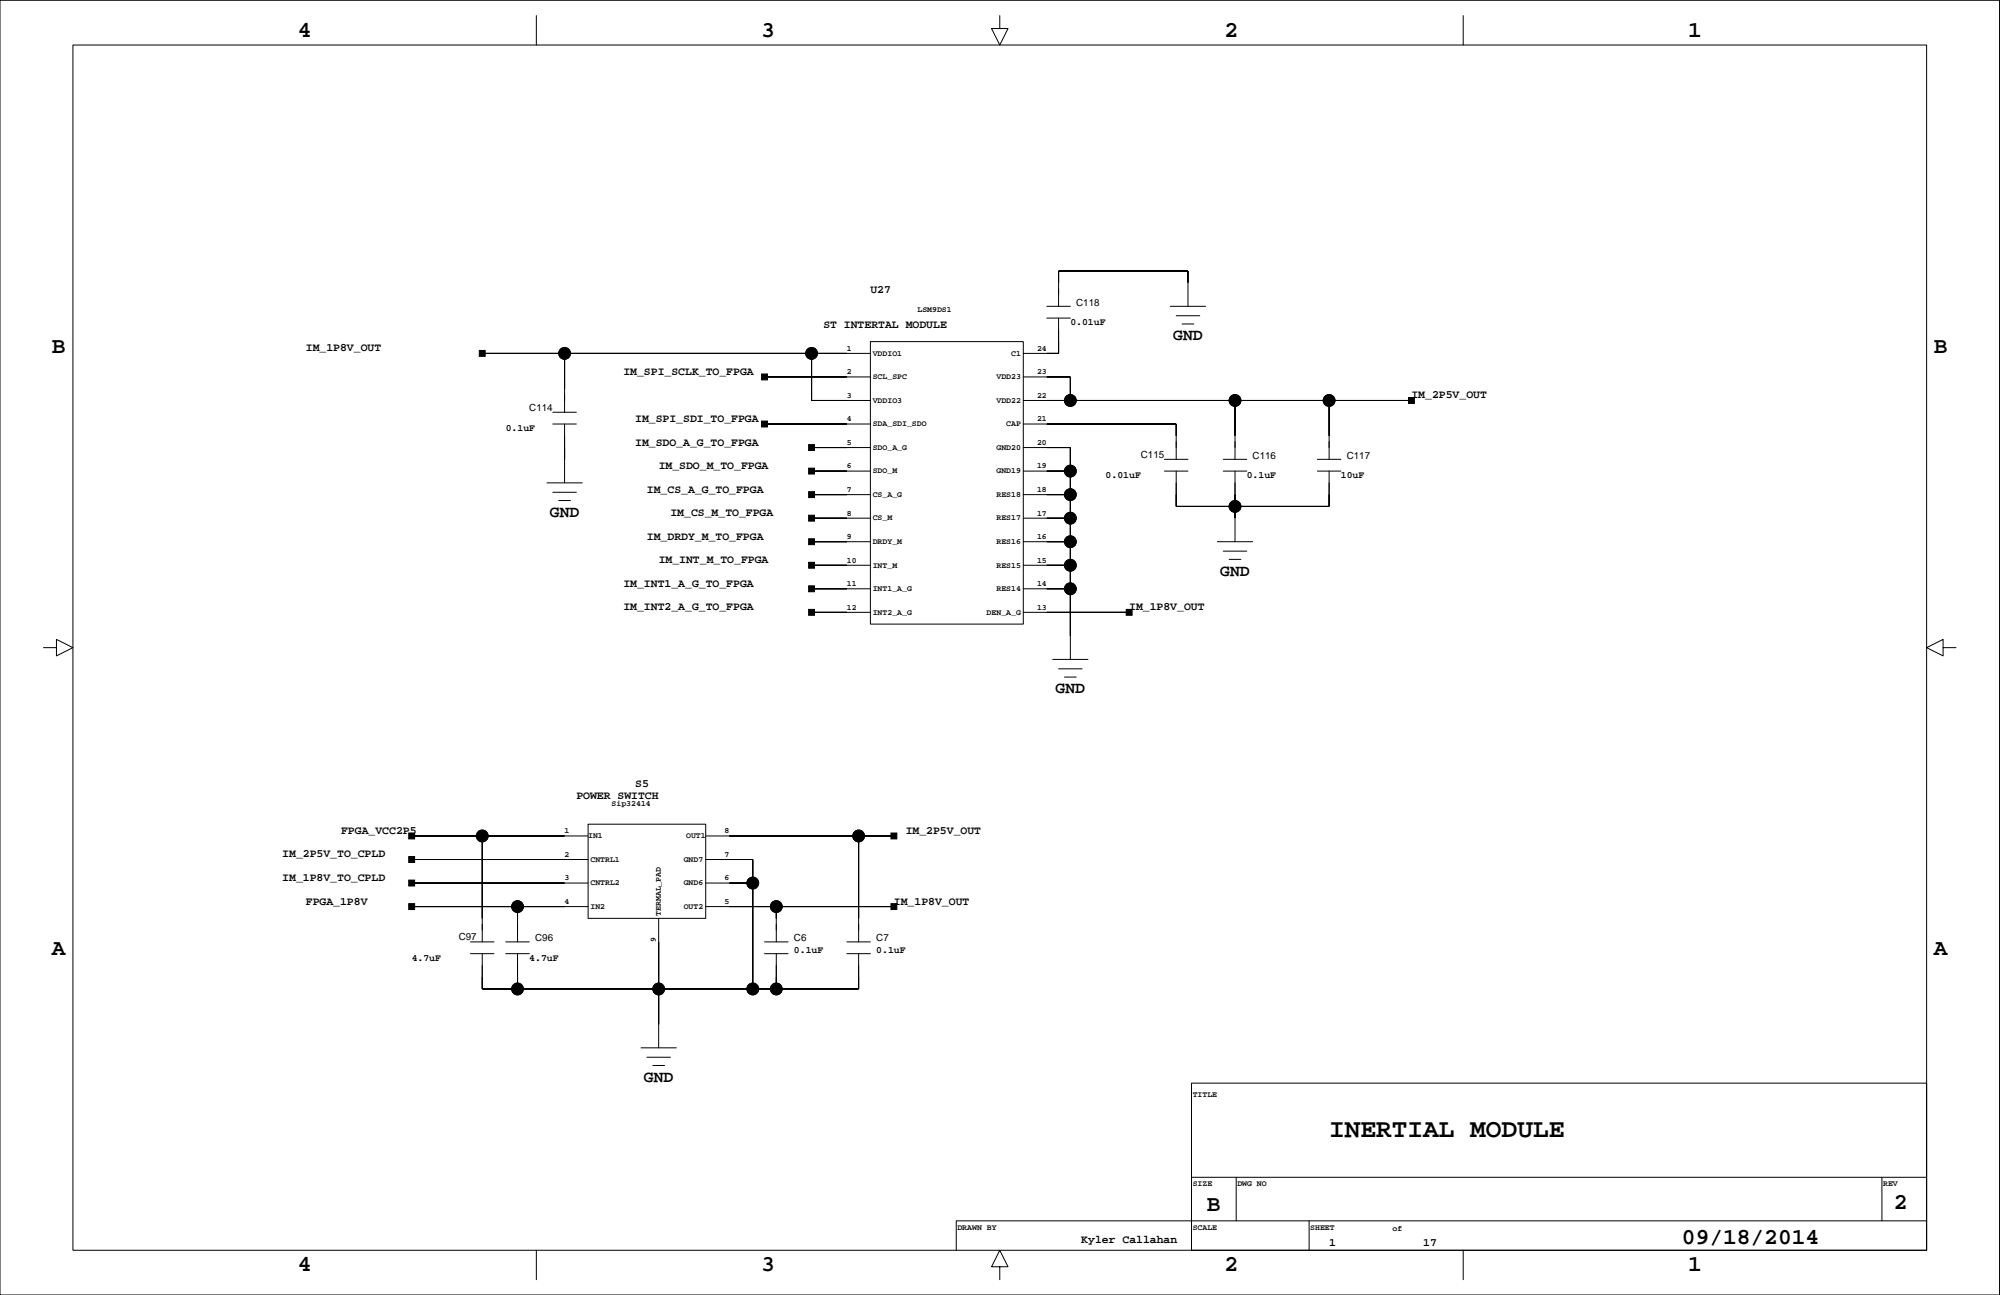
[picture p242: page 1]

4 | 3 | 2 | 1

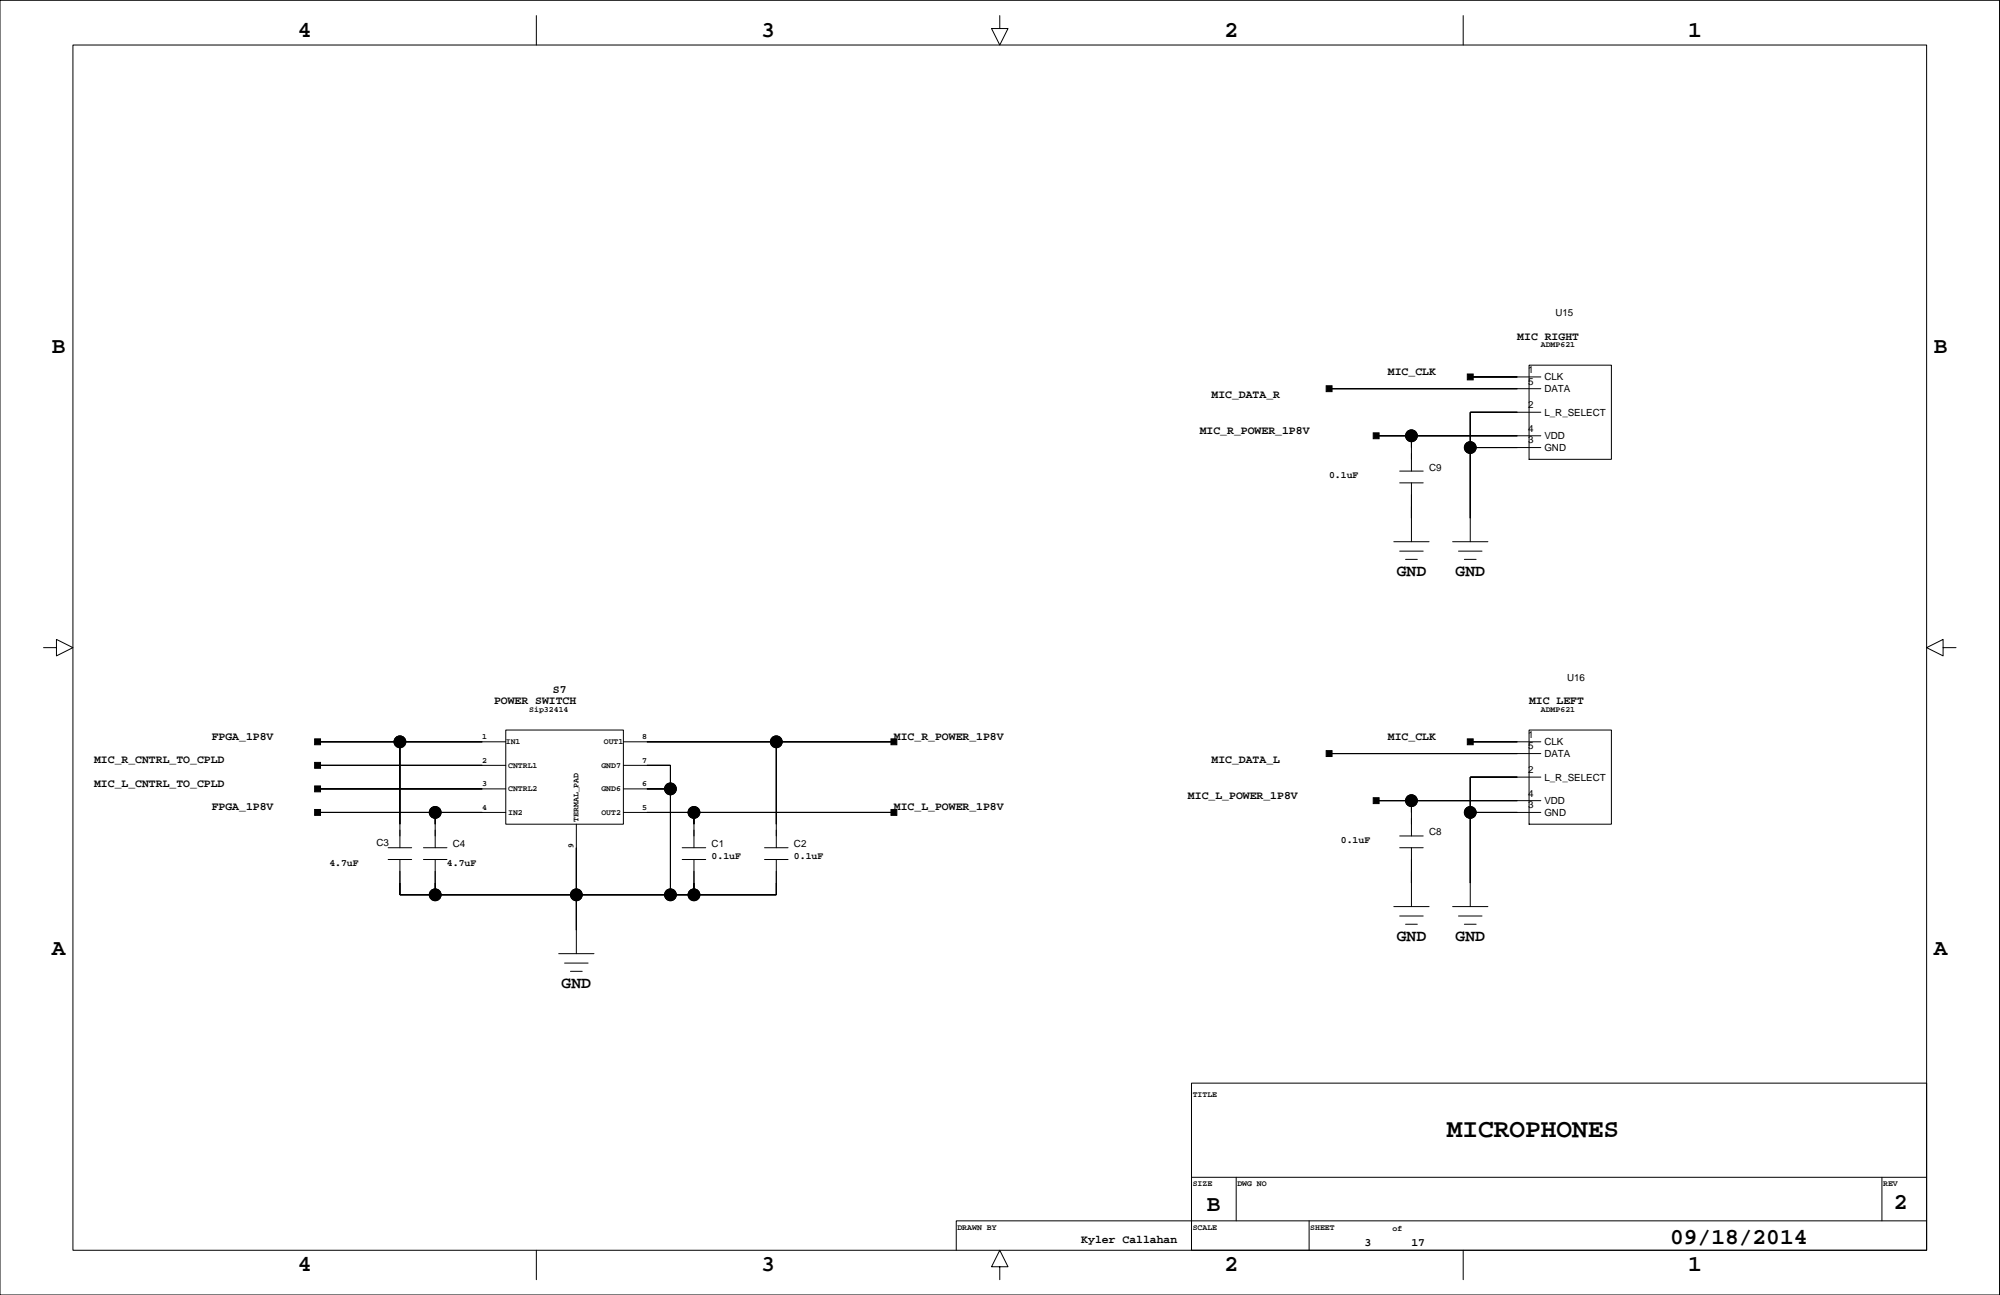
[picture p243: page 2]
