rksnider/SensorCollar/PCB_Designs/MCollar_v1/1Working Version/SENSOR working/CAM output.pdf

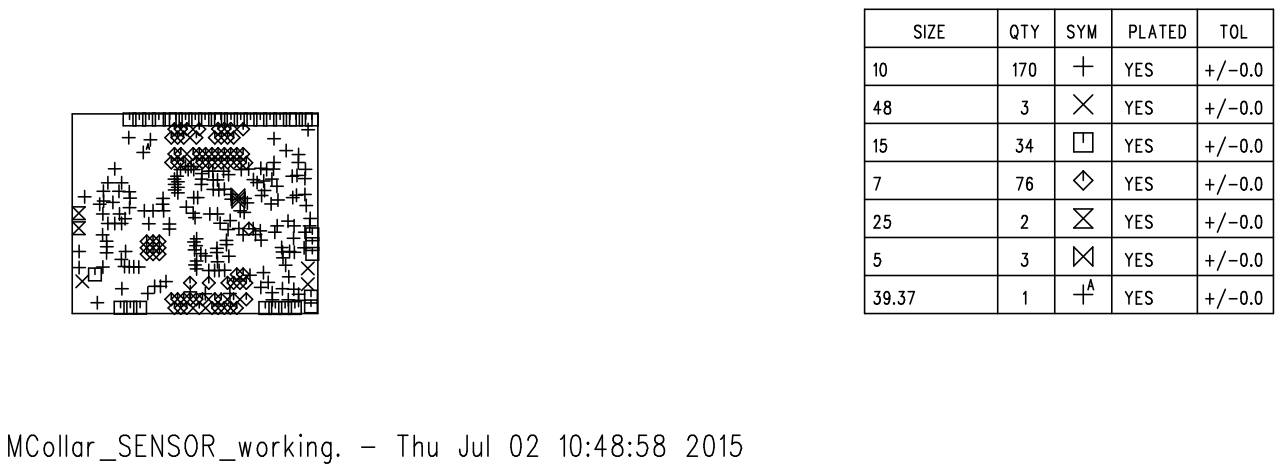
[picture p244: page 1]
