rksnider/SensorCollar/PCB_Designs/MCollar_v1/1Working Version/SENSOR working/CAM output1.pdf

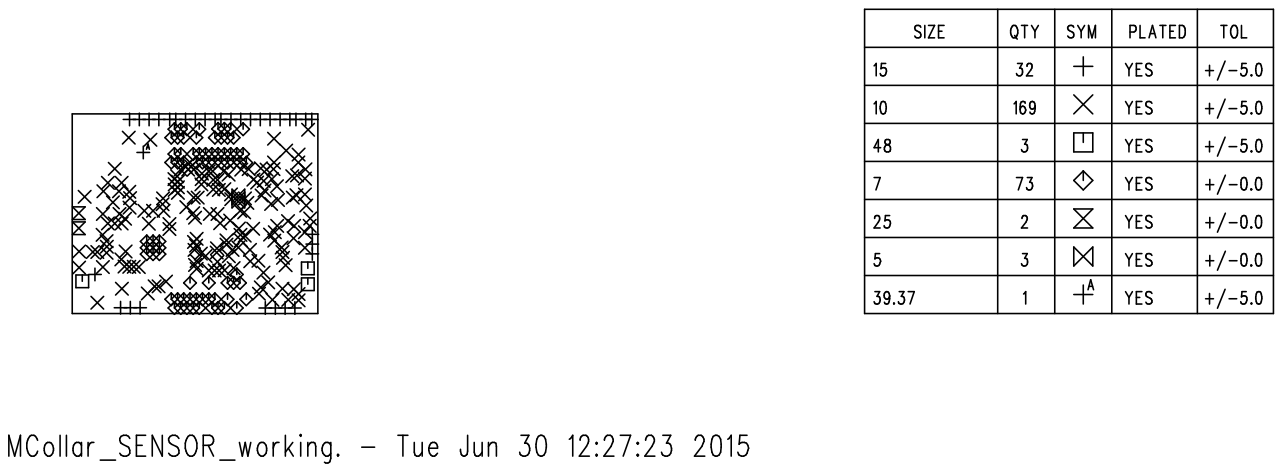
[picture p245: page 1]
