rksnider/SensorCollar/(list of files, drawings)

Other design files:
PCB_Designs/Data_TRX/1Working Version/Data_TRX_v1_working.pcb
PCB_Designs/Data_TRX/2Current Version/Data_TRX_v1.pcb
PCB_Designs/Data_TRX/2Current Version/Data_TRX_v1_Bottom.pcb
PCB_Designs/Data_TRX/2Current Version/Data_TRX_v1_Top.pcb
PCB_Designs/DevBoard_PowerMonitor/1Working Version/DevBoard_PowerMonitor_working.pcb
PCB_Designs/DevBoard_PowerMonitor/2Current Version/DevBoard_PowerMonitor.pcb
PCB_Designs/GPS Board/1Working Version/GPSBoardV1.pcb
PCB_Designs/GPS Board/1Working Version/GPSBoardV1SquareWorking.pcb
PCB_Designs/GPS Board/2Current Version/GPSBoardV1Diagonal.pcb
PCB_Designs/GPS Board/2Current Version/GPSBoardV1Square.pcb
PCB_Designs/Interface_Board/1Working Version/MCollar_INTERFACE_layout_best.pcb
PCB_Designs/Interface_Board/1Working Version/MCollar_INTERFACE_working.pcb
PCB_Designs/Interface_Board/1Working Version/MCollar_INTERFACE_workingV2.pcb
PCB_Designs/Interface_Board/1Working Version/MCollar_INTERFACE_workingV2_beforeforward.pcb
PCB_Designs/Interface_Board/2Current Version/MCollar_INTERFACE_current.pcb
PCB_Designs/Interface_Board/2Current Version/MCollar_INTERFACE_currentV2.pcb
PCB_Designs/Interface_Board/3Old Version/MCollar_SANDWICH_route1.pcb
PCB_Designs/MCollar_v1/1Working Version/MAIN working/MCollar_MAIN_working.pcb
PCB_Designs/MCollar_v1/1Working Version/SENSOR working/MCollar_SENSOR_working.pcb
PCB_Designs/MCollar_v1/2Current Version/MAIN/MCollar_MAIN.pcb
PCB_Designs/MCollar_v1/2Current Version/MCollar_MAIN_022715.pcb
PCB_Designs/MCollar_v1/2Current Version/MCollar_MAIN_030515.pcb
PCB_Designs/MCollar_v1/2Current Version/MCollar_MAIN_030615.pcb
PCB_Designs/MCollar_v1/2Current Version/MCollar_MAIN_Brokeout.pcb
PCB_Designs/MCollar_v1/2Current Version/MCollar_MAIN_Routed.pcb
PCB_Designs/MCollar_v1/2Current Version/SENSOR/MCollar_SENSOR.pcb
PCB_Designs/MCollar_v1/2Current Version/SENSOR/MCollar_SENSOR_pre_pwr.pcb
PCB_Designs/MCollar_v1/3Old Version/MCollar_MAIN_011415.pcb
PCB_Designs/MCollar_v1/3Old Version/MCollar_MAIN_022515.pcb
PCB_Designs/MCollar_v1/3Old Version/MCollar_MAIN_022615.pcb
PCB_Designs/MCollar_v1/3Old Version/MCollar_MAIN_022715.pcb
PCB_Designs/MCollar_v1/3Old Version/MCollar_MAIN_030515.pcb
PCB_Designs/MCollar_v1/3Old Version/MCollar_MAIN_030615.pcb
PCB_Designs/MCollar_v1/3Old Version/MCollar_MAIN_Brokeout.pcb
PCB_Designs/MCollar_v1/3Old Version/MCollar_MAIN_Brokeout_working.pcb
PCB_Designs/MCollar_v1/3Old Version/MCollar_MAIN_old.pcb
PCB_Designs/MCollar_v1/3Old Version/MCollar_MAIN_Routed.pcb
PCB_Designs/MCollar_v1/3Old Version/MCollar_SENSOR_pre_pwr.pcb
PCB_Designs/Microphone Board/1Working Version/MCollar_Microphone_working.pcb
PCB_Designs/Microphone Board/2Current Version/MCollar_Microphone_current.pcb
PCB_Designs/Sandwich Board/1Working Version/MCollar_SANDWICH_pins_labeled.pcb
PCB_Designs/Sandwich Board/1Working Version/MCollar_SANDWICH_working.pcb
PCB_Designs/Sandwich Board/2Current Version/MCollar_SANDWICH.pcb
PCB_Designs/Sandwich Board/2Current Version/MCollar_SANDWICH_33d_spec.pcb
PCB_Designs/Sandwich Board/2Current Version/MCollar_SANDWICH_33d_spec_100mil_pins.pcb
PCB_Designs/TEST_BOARD/uUSB3_0.pcb
PCB_Designs/TEST_BOARD/uUSB3_0_and_test.pcb
PCB_Designs/TEST_BOARD/uUSB3_0_Working.pcb
