rksnider/SensorCollar/Source_Code/MainCollar/Collar.vhd

----------------------------------------------------------------------------
--
--! @file       Collar.vhd
--! @brief      Acoustic Recording Collar Top Level.
--! @details    Instanciates and connects all the components that make up
--!             the Acoustic Recording Collar FPGA implementation.
--! @author     Emery Newlon
--! @date       August 2014
--! @copyright  Copyright (C) 2014 Ross K. Snider and Emery L. Newlon
--
--  This program is free software: you can redistribute it and/or modify
--  it under the terms of the GNU General Public License as published by
--  the Free Software Foundation, either version 3 of the License, or
--  (at your option) any later version.
--
--  This program is distributed in the hope that it will be useful,
--  but WITHOUT ANY WARRANTY; without even the implied warranty of
--  MERCHANTABILITY or FITNESS FOR A PARTICULAR PURPOSE.  See the
--  GNU General Public License for more details.
--
--  You should have received a copy of the GNU General Public License
--  along with this program.  If not, see <http://www.gnu.org/licenses/>.
--
--  Emery Newlon
--  Electrical and Computer Engineering
--  Montana State University
--  610 Cobleigh Hall
--  Bozeman, MT 59717
--  emery.newlon@msu.montana.edu
--
----------------------------------------------------------------------------

library IEEE ;                  --! Use standard library.
use IEEE.STD_LOGIC_1164.ALL ;   --! Use standard logic elements.
use IEEE.NUMERIC_STD.ALL ;      --! Use numeric standard.
use IEEE.MATH_REAL.ALL ;        --! Real number functions.

LIBRARY lpm ;                   --  Use Library of Parameterized Modules.
USE lpm.lpm_components.all ;

library GENERAL ;               --! General libraries
use GENERAL.UTILITIES_PKG.ALL ;

use GENERAL.GPS_CLOCK_PKG.ALL ;
use GENERAL.FORMATSECONDS_PKG.ALL ;

library WORK ;                  --! Local Library
use WORK.COLLAR_CONTROL_PKG.ALL ;
use WORK.COLLAR_PARAMETERS_PKG.ALL ;
use WORK.COLLAR_EVENTS_PKG.ALL ;
use WORK.SHARED_SDC_VALUES_PKG.ALL ;
use WORK.PC_STATUSCONTROL_PKG.ALL ;
use WORK.SDRAM_INFORMATION_PKG.ALL ;
use WORK.MAGMEM_BUFFER_DEF_PKG.ALL ;
use WORK.TXRX_P_BUFFER_DEF_PKG.all ;
use WORK.TXRX_RECEIVED_PKG.ALL ;

use WORK.GPS_MESSAGE_CTL_PKG.ALL ;
use WORK.MSG_UBX_NAV_SOL_PKG.ALL ;
use WORK.MSG_UBX_TIM_TM2_PKG.ALL ;


----------------------------------------------------------------------------
--
--! @brief      Acoustic Recording Collar Top Level.
--! @details    Instanciates and connects all the components that make up
--!             the Acoustic Recording Collar FPGA implementation.
--!
--! @param      source_clk_freq_g Frequency of the system clock in cycles
--!                               per second.
--! @param      button_cnt_g    Number of buttons used by the device.
--! @param      sdram_space_g   Space available parameters for SDRAM chip.
--! @param      sdram_times_g   Timing limits for SDRAM chip.
--! @param      source_clk      Clock generated by the system that drives
--!                             everything else.
--! @param      buttons_in      Vector of button signals used by the device.
--! @param      batt_int_in     Battery monitor interrupt signal.
--! @param      forced_start_in A forced startup has been initiated.
--! @param      i2c_clk_io      I2C bus clock is input or output depending
--!                             on the device driving it.
--! @param      i2c_data_io     I2C bus data is driven by the same device
--!                             that is driving the clock.
--! @param      pc_statchg_in   The Power Controller status register has
--!                             changed and should be reloaded.
--! @param      pc_spi_clk      The Power Controller status register/
--!                             control register SPI bus clock.
--! @param      pc_spi_cs_out   The PC SPI bus chip select.  An SPI
--!                             transfer is initiated when it goes high.
--! @param      pc_spi_mosi_out Master Out/Slave In SPI data line.
--! @param      pc_spi_miso_in  Master In/Slave Out SPI data line.
--! @param      pc_flash_clk      Power Controller Flash access clock.
--! @param      pc_flash_cs_out   PC Flash chip select.
--! @param      pc_flash_data_io  PC Flash data bus.
--! @param      pc_flash_dir_out  PC Flash data direction.  The PC Flash
--!                               bus is high impedance when this line is
--!                               low, driven when it is high.
--! @param      sdram_clk         Clock driving the SDRAM.
--! @param      sdram_clk_en_out  The clock is enabled on the SDRAM.
--! @param      sdram_command_out The command sent to the SDRAM.
--! @param      sdram_mask_out    The bytes masked from the SDRAM data bus.
--! @param      sdram_bank_out    The SDRAM bank to access.
--! @param      sdram_addr_out    The SDRAM row or column to access.
--! @param      sdram_data_io     The SDRAM data bus.
--! @param      sd_clk          Micro SDCard clock.
--! @param      sd_cmd_io       Command line used with the micro SDCard.
--! @param      sd_data_io      Data lines used with the micro SDCard.
--! @param      sd_vsw_out      Voltage switch control lines.
--! @param      sdh_clk         High voltage micro SDCard clock.
--! @param      sdh_cmd_io      High voltage command line used with the
--!                             micro SDCard.
--! @param      sdh_data_io     High voltage data lines used with the micro
--!                             SDCard.
--! @param      gps_rx_io       Receive line from the GPS UART.
--! @param      gps_tx_out      Transmit line to the GPS UART.
--! @param      gps_timemark_out  Time mark generator line to the GPS
--!                               external interrupt.
--! @param      gps_timepulse_io  Time pulse signal from GPS.
--! @param      ms_clk          Motion sensor SPI Clock.
--! @param      ms_mosi_out     Motion sensor SPI Master Out/Slave In.
--! @param      ms_miso_in      Motion sensor SPI Master In/Slave Out.
--! @param      ms_int_in       Motion sensor Interrupt.
--! @param      ms_cs_accgyro_out   Motion sensor A/G SPI chip select.
--! @param      ms_miso_accgyro_io  Motion sensor A/G SPI Master In/Slave
--!                                 Out.
--! @param      ms_int1_accgyro_io  Motion sensor A/G Interrupt 1.
--! @param      ms_int2_accgyro_io  Motion sensor A/G Interrupt 2.
--! @param      ms_cs_mag_out   Motion sensor magnetic SPI chip select.
--! @param      ms_miso_mag_io  Motion sensor magnetic SPI Master In/
--!                             Slave Out.
--! @param      ms_int_mag_io   Motion sensor magnetic Interrupt.
--! @param      ms_drdy_mag_io  Motion sensor magnetic Data Ready.
--! @param      magram_clk            Magnetic RAM SPI clock.
--! @param      magram_cs_out         Magnetic RAM chip select.
--! @param      magram_mosi_out       Magnetic RAM SPI Master Out/Slave In.
--! @param      magram_miso_io        Magnetic RAM SPI Master In/Slave Out.
--! @param      magram_writeprot_out  Magnetic RAM write protect.
--! @param      mic_clk         Microphone clock.
--! @param      mic_right_io    Right microphone data.
--! @param      mic_left_io     Left microphone data.
--! @param      radio_clk       Radio trx/rcv bus clock.
--! @param      radio_cs_n_out  Radio chip select not.
--! @param      radio_mosi_out  Radio SPI master out/slave in.
--! @param      radio_miso_io   Radio SPI master in/slave out.
--! @param      radio_rdy_io    Radio ready interrupt.
--
----------------------------------------------------------------------------

entity Collar is

  Generic (
    source_clk_freq_g     : natural           := 10e6 ;
    button_cnt_g          : natural           :=  8 ;
    sdram_space_g         : SDRAM_Capacity_t  := SDRAM_16_Capacity_c ;
    sdram_times_g         : SDRAM_Timing_t    := SDRAM_75_2_Timing_c
  ) ;
  Port (
    source_clk            : in    std_logic ;
    buttons_in            : in    std_logic_vector (button_cnt_g-1
                                                      downto 0) ;

    batt_int_in           : in    std_logic ;
    forced_start_in       : in    std_logic ;

    i2c_clk_io            : inout std_logic ;
    i2c_data_io           : inout std_logic ;

    pc_statchg_in         : in    std_logic ;
    pc_spi_clk            : out   std_logic ;
    pc_spi_cs_out         : out   std_logic ;
    pc_spi_mosi_out       : out   std_logic ;
    pc_spi_miso_in        : in    std_logic ;

    pc_flash_clk          : out   std_logic ;
    pc_flash_cs_out       : out   std_logic ;
    pc_flash_data_io      : inout std_logic_vector (3 downto 0) ;
    pc_flash_dir_out      : out   std_logic ;

    sdram_clk             : out   std_logic ;
    sdram_clk_en_out      : out   std_logic ;
    sdram_command_out     : out   std_logic_vector (3 downto 0) ;
    sdram_mask_out        : out   std_logic_vector (1 downto 0) ;
    sdram_bank_out        : out   std_logic_vector (1 downto 0) ;

    sdram_addr_out        : out   std_logic_vector (12 downto 0) ;
    sdram_data_io         : inout std_logic_vector (15 downto 0) ;

    sd_clk                : out   std_logic ;
    sd_cmd_io             : inout std_logic ;
    sd_data_io            : inout std_logic_vector (3 downto 0) ;

    sdh_clk               : out   std_logic ;
    sdh_cmd_io            : inout std_logic ;
    sdh_data_io           : inout std_logic_vector (3 downto 0) ;

    gps_rx_io             : inout std_logic ;
    gps_tx_out            : out   std_logic ;
    gps_timemark_out      : out   std_logic ;
    gps_timepulse_io      : inout std_logic ;

    ms_clk                : out   std_logic ;
    ms_mosi_out           : out   std_logic ;
    --ms_miso_in            : in    std_logic ;
    --ms_int_in             : in    std_logic ;

    ms_cs_accgyro_out     : out   std_logic ;
    ms_miso_accgyro_io    : inout std_logic ;
    ms_int1_accgyro_io    : inout std_logic ;
    ms_int2_accgyro_io    : inout std_logic ;

    ms_cs_mag_out         : out   std_logic ;
    ms_miso_mag_io        : inout std_logic ;
    ms_int_mag_io         : inout std_logic ;
    ms_drdy_mag_io        : inout std_logic ;

    magram_clk            : out   std_logic ;
    magram_cs_out         : out   std_logic ;
    magram_mosi_out       : out   std_logic ;
    magram_miso_io        : inout std_logic ;
    magram_writeprot_out  : out   std_logic ;

    mic_clk               : out   std_logic ;
    mic_right_io          : inout std_logic ;
    mic_left_io           : inout std_logic ;

    radio_clk             : out   std_logic ;
    radio_cs_n_out        : out   std_logic ;
    radio_mosi_out        : out   std_logic ;
    radio_miso_io         : inout std_logic ;
    radio_rdy_io          : inout std_logic

  ) ;

end entity Collar ;


architecture structural of Collar is

  --  Establish keep and noprune attributes to override optimization
  --  removal of signals needed by SDC files and other cases.

  attribute keep              : boolean ;
  attribute noprune           : boolean ;

  --  Master clock information.

  constant master_clk_freq_c  : natural := source_clk_freq_g ;

  signal master_clk           : std_logic ;
  signal master_gated_clk     : std_logic ;
  signal master_gated_inv_clk : std_logic ;
  signal master_gated_en_s    : std_logic ;

  attribute keep of master_gated_en_s   : signal is true ;

  --  Button specifications.

  constant reset_button_c     : natural := 0 ;
  constant sd_start_button_c  : natural := 1 ;

  --  Clock and time signals.

  signal reset_time_bytes     : std_logic_vector (gps_time_bytes_c*8-1
                                                  downto 0) ;
  signal reset_time           : std_logic_vector (gps_time_bits_c-1
                                                  downto 0) ;
  signal systime_latch        : std_logic ;
  signal systime_valid        : std_logic ;
  signal systime_vlatch       : std_logic ;
  signal rtc_seconds          : unsigned (epoch70_secbits_c-1 downto 0) ;
  signal rtc_seconds_load     : std_logic ;
  signal rtc_running_set      : std_logic ;
  signal rtc_running_seconds  : unsigned (epoch70_secbits_c-1 downto 0) ;
  signal milli_seconds        : unsigned (rtc_running_seconds'length-1
                                          downto 0) ;
  signal running_datetime     : std_logic_vector (dt_totalbits_c-1
                                                  downto 0) ;
  signal milli_datetime       : std_logic_vector (running_datetime'length-1
                                                  downto 0) ;
  signal noon_datetime        : std_logic_vector (running_datetime'length-1
                                                  downto 0) ;
  signal noon_seconds         : unsigned (epoch70_secbits_c-1 downto 0) ;
  signal milli_noon_seconds   : unsigned (epoch70_secbits_c-1 downto 0) ;
  signal dawn_today           : unsigned (epoch70_secbits_c-1 downto 0) ;
  signal sunrise_today        : unsigned (epoch70_secbits_c-1 downto 0) ;
  signal sunset_today         : unsigned (epoch70_secbits_c-1 downto 0) ;
  signal dusk_today           : unsigned (epoch70_secbits_c-1 downto 0) ;
  signal dawn_tomorrow        : unsigned (epoch70_secbits_c-1 downto 0) ;
  signal sunrise_tomorrow     : unsigned (epoch70_secbits_c-1 downto 0) ;
  signal sunset_tomorrow      : unsigned (epoch70_secbits_c-1 downto 0) ;
  signal dusk_tomorrow        : unsigned (epoch70_secbits_c-1 downto 0) ;

  component ArraySynchronizer is
    Generic (
      data_bits_g             : natural := 8
    ) ;
    Port (
      clk                     : in    std_logic ;
      array_done_out          : out   std_logic ;
      array_in                : in    std_logic_vector (data_bits_g-1
                                                        downto 0) ;
      array_out               : out   std_logic_vector (data_bits_g-1
                                                        downto 0)
    ) ;
  end component ArraySynchronizer ;

  --  Reset information.  The power up signal defaults to zero.

  constant pu_time_c        : real    := 0.5 ;   -- Give sigtap start time.
  constant pu_count_c       : natural :=
              natural (trunc (real (master_clk_freq_c) * pu_time_c)) ;

  signal reset              : std_logic ;
  signal power_up           : std_logic := '0' ;
  signal pu_counter         : unsigned (const_bits (pu_count_c)-1
                                        downto 0) := (others => '0') ;

  constant pb_time_c        : real    := 0.5 ;
  constant pb_count_c       : natural :=
              natural (trunc (real (master_clk_freq_c) * pb_time_c)) ;

  signal reset_pushed       : std_logic := '0' ;
  signal pb_counter         : unsigned (const_bits (pb_count_c)-1
                                        downto 0) := (others => '0') ;

  COMPONENT GlobalClock IS
    PORT
    (
      ena    : IN STD_LOGIC  := '1';
      inclk    : IN STD_LOGIC ;
      outclk    : OUT STD_LOGIC
    );
  END COMPONENT GlobalClock;

  --  Allow JTAG to determine the location code for this executable.

  signal LocationCode       :
            unsigned (const_bits (CP_LocationTbl_c'length-1)-1 downto 0) :=
                TO_UNSIGNED (CP_Loc_code_c,
                             const_bits (CP_LocationTbl_c'length-1)) ;

  attribute noprune of LocationCode   : signal is true ;

  --  SPI clocks.

  signal spi_clk              : std_logic ;
  signal spi_gated_clk        : std_logic ;
  signal spi_gated_inv_clk    : std_logic ;
  signal spi_gated_en_s       : std_logic ;

  attribute keep of spi_gated_en_s  : signal is true ;

  --  Millisecond clocks.

  constant millisec_clk_freq_c  : natural := 1000 ;

  signal milli_clk              : std_logic ;
  signal milli8_clk             : std_logic ;


  component GenClock is

    Generic (
      clk_freq_g              : natural   := 10e6 ;
      out_clk_freq_g          : natural   := 1e6 ;
      net_clk_g               : natural   := 0 ;
      net_inv_g               : natural   := 0 ;
      net_gated_g             : natural   := 0 ;
      net_inv_gated_g         : natural   := 0
     ) ;
    Port (
      reset                   : in    std_logic ;
      clk                     : in    std_logic ;
      clk_on_in               : in    std_logic ;
      clk_off_in              : in    std_logic ;
      clk_out                 : out   std_logic ;
      clk_inv_out             : out   std_logic ;
      gated_clk_out           : out   std_logic ;
      gated_clk_inv_out       : out   std_logic
    ) ;

  end component GenClock ;

  --  PC control and status signals.

  signal StatCtlActive          : std_logic ;
  signal PC_StatusSet           : std_logic ;
  signal PC_StatusReg           : std_logic_vector (StatusSignalsCnt_c-1
                                                    downto 0) ;

  alias STAT_BatteryGood        : std_logic is
        PC_StatusReg (StatusSignals'pos (Stat_BatteryGood_e)) ;
  alias STAT_SolarCtlOn       : std_logic is
        PC_StatusReg (StatusSignals'pos (Stat_SolarCtlOn_e)) ;
  alias STAT_SolarCtlMax        : std_logic is
        PC_StatusReg (StatusSignals'pos (Stat_SolarCtlMax_e)) ;
  alias STAT_BattMonLow       : std_logic is
        PC_StatusReg (StatusSignals'pos (Stat_BattMonLow_e)) ;
  alias STAT_ForceStartup       : std_logic is
        PC_StatusReg (StatusSignals'pos (Stat_ForceStartup_e)) ;
  alias STAT_PwrGood2p5       : std_logic is
        PC_StatusReg (StatusSignals'pos (Stat_PwrGood2p5_e)) ;
  alias STAT_PwrGood3p3       : std_logic is
        PC_StatusReg (StatusSignals'pos (Stat_PwrGood3p3_e)) ;


  signal PC_ControlReg          : std_logic_vector (ControlSignalsCnt_c-1
                                                    downto 0) :=
                                      (others => '0') ;
  signal PC_ControlSent         : std_logic_vector (ControlSignalsCnt_c-1
                                                    downto 0) ;
  attribute keep of PC_ControlSent    : signal is true ;

  signal PC_ControlReg_signal   : std_logic_vector (ControlSignalsCnt_c-1
                                                    downto 0) :=
                                      (others => '0') ;

  alias CTL_MainPowerSwitch     : std_logic is
        PC_ControlSent (ControlSignals'pos (Ctl_MainPowerSwitch_e)) ;
  alias CTL_RechargeSwitch      : std_logic is
        PC_ControlSent (ControlSignals'pos (Ctl_RechargeSwitch_e)) ;
  alias CTL_SolarCtlShutdown    : std_logic is
        PC_ControlSent (ControlSignals'pos (Ctl_SolarCtlShutdown_e)) ;
  alias CTL_LevelShifter3p3     : std_logic is
        PC_ControlSent (ControlSignals'pos (Ctl_LevelShifter3p3_e)) ;
  alias CTL_LevelShifter1p8     : std_logic is
        PC_ControlSent (ControlSignals'pos (Ctl_LevelShifter1p8_e)) ;
  alias CTL_InertialOn1p8       : std_logic is
        PC_ControlSent (ControlSignals'pos (Ctl_InertialOn1p8_e)) ;
  alias CTL_InertialOn2p5       : std_logic is
        PC_ControlSent (ControlSignals'pos (Ctl_InertialOn2p5_e)) ;
  alias CTL_MicLeftOn           : std_logic is
        PC_ControlSent (ControlSignals'pos (Ctl_MicLeftOn_e)) ;
  alias CTL_MicRightOn          : std_logic is
        PC_ControlSent (ControlSignals'pos (Ctl_MicRightOn_e)) ;
  alias CTL_SDRAM_On            : std_logic is
        PC_ControlSent (ControlSignals'pos (Ctl_SDRAM_On_e)) ;
  alias CTL_SDCardOn            : std_logic is
        PC_ControlSent (ControlSignals'pos (Ctl_SDCardOn_e)) ;
  alias CTL_MagMemOn            : std_logic is
        PC_ControlSent (ControlSignals'pos (Ctl_MagMemOn_e)) ;
  alias CTL_GPS_On              : std_logic is
        PC_ControlSent (ControlSignals'pos (Ctl_GPS_On_e)) ;
  alias CTL_DataTX_On           : std_logic is
        PC_ControlSent (ControlSignals'pos (Ctl_DataTX_On_e)) ;
  alias CTL_FPGA_Shutdown       : std_logic is
        PC_ControlSent (ControlSignals'pos (Ctl_FPGA_Shutdown_e)) ;
  alias CTL_FLASH_Granted       : std_logic is
        PC_ControlSent (ControlSignals'pos (Ctl_FLASH_Granted_e)) ;

  --  Resource multiplexer component.

  component ResourceMUX is
    Generic (
      requester_cnt_g           : natural   :=  8 ;
      resource_bits_g           : natural   :=  8 ;
      clock_bitcnt_g            : natural   :=  0 ;
      cross_clock_domain_g      : std_logic := '0'
    ) ;
    Port (
      reset                     : in    std_logic ;
      clk                       : in    std_logic ;
      requesters_in             : in    std_logic_vector (requester_cnt_g-1
                                                          downto 0) ;
      resource_tbl_in           : in    std_logic_2D (requester_cnt_g-1
                                                      downto 0,
                                                      resource_bits_g-1
                                                      downto 0) ;
      receivers_out             : out   std_logic_vector (requester_cnt_g-1
                                                          downto 0) ;
      resources_out             : out   std_logic_vector (resource_bits_g-1
                                                          downto 0)
    ) ;
  end component ResourceMUX ;

  --  Memory resource sharing constants and signals.
  --  Memory sharing involves each component sharing a memory bus, building
  --  a vector that is a concatination of all its control and output data
  --  signals.  This vector is added to a table of vectors for all
  --  components that share the memory bus.  Resource allocation is used
  --  to determine the current bus user and its control vector is mapped
  --  to the memory bus.
  --  When a component does not write to memory it uses the 'none'
  --  constants for that part of the combined signal.

  --  Shared GPS Memory constants and signals.

  constant gpsmem_bytecnt_c     : natural := 1024 ;
  constant gpsmem_databits_c    : natural := 8 ;
  constant gpsmem_elementcnt_c  : natural := 8 * gpsmem_bytecnt_c /
                                                 gpsmem_databits_c ;

  constant gpsmem_addrbits_c    : natural :=
                                      const_bits (gpsmem_elementcnt_c-1) ;
  constant gpsmem_rdwr_enbits_c : natural := 2 ;
  constant gpsmem_clkbits_c     : natural := 1 ;
  constant gpsmem_iobits_c      : natural := gpsmem_databits_c +
                                             gpsmem_addrbits_c +
                                             gpsmem_rdwr_enbits_c +
                                             gpsmem_clkbits_c ;

  constant gpsmem_wrto_none_c   : std_logic_vector (gpsmem_databits_c-1
                                                    downto 0) :=
                                                        (others => '0') ;
  constant gpsmem_wren_none_c   : std_logic := '0' ;

  --  Memory requestors.

  constant gpsmemrq_flashblk_c    : natural := 0 ;
  constant gpsmemrq_systemtime_c  : natural := gpsmemrq_flashblk_c    + 1 ;

  constant gpsmemrq_count_c       : natural := gpsmemrq_systemtime_c  + 1 ;

  signal gpsmem_requesters        : std_logic_vector (gpsmemrq_count_c-1
                                                      downto 0) ;
  signal gpsmem_receivers         : std_logic_vector (gpsmemrq_count_c-1
                                                      downto 0) ;

  signal st_gpsmem_control        : std_logic_vector (gpsmem_iobits_c-1
                                                      downto 0) ;
  signal st_gpsmem_input_tbl      : std_logic_2D (gpsmemrq_count_c-1
                                                  downto 0,
                                                  gpsmem_iobits_c-1
                                                  downto 0) ;

  signal fb_gpsmem_control        : std_logic_vector (gpsmem_iobits_c-1
                                                      downto 0) ;
  signal fb_gpsmem_input_tbl      : std_logic_2D (gpsmemrq_count_c-1
                                                  downto 0,
                                                  gpsmem_iobits_c-1
                                                  downto 0) ;

  signal gpsmemdst_readfrom       : std_logic_vector (gpsmem_databits_c-1
                                                      downto 0) ;

  --------------------------------------------------------------------------
  --  Shared Magnetic Memory constants and signals.
  --------------------------------------------------------------------------

  constant magmem_bytecnt_c     : natural := magmem_buffer_bytes ;
  constant magmem_databits_c    : natural := 8 * magmem_data_width_a_bytes ;
  constant magmem_elementcnt_c  : natural := 8 * magmem_bytecnt_c /
                                                 magmem_databits_c ;

  constant magmem_addrbits_c    : natural :=
                                      const_bits (magmem_elementcnt_c-1) ;
  constant magmem_rdwr_enbits_c : natural := 2 ;
  constant magmem_clkbits_c     : natural := 1 ;
  constant magmem_iobits_c      : natural := magmem_databits_c +
                                             magmem_addrbits_c +
                                             magmem_rdwr_enbits_c +
                                             magmem_clkbits_c  ;
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
