rksnider/SensorCollar/(commit log)

2014-06-20 Revert "6.20.2014"
    This reverts commit dd0d77c1e49a11279fcb7c61d7ee670a2dde2c23.
    [microsd_controller.vhd, microsd_controller_inner.vhd, microsd_controller_tester.vhd]
2014-08-13 IMU Buffer Addressing
2014-08-21 Testing time update using filters.
2014-08-21 Time update using filters
    Testing using a filter defined in .gitconfig to update
    time times in the commit_timestamp.log files.
2014-08-21 Add GPS Code
    Add the GPS code and MATLAB functions used to produce some of the code
    to the repository.
    [NEO-6T Configuration.txt]
2014-08-25 Fixed missing _c on constants.
    [msg_ubx_nav_sol_pkg.vhd, msg_ubx_tim_tm2_pkg.vhd]
2014-10-02 Moved Power Controller specific files to their own sub-directory.
2014-10-02 Added Internal Flash support to the Power Controller. Intended to store information specific to each individual collar.
2014-10-23 Power Controller SPI Bus to FPGA.
2014-10-28 Power Controller Additions.
2014-12-03 Initial compile of the Power Controller.
2014-12-16 Inital Commit of the datasheets for the parts that we are currently using
    [5CEBA4.xls, MAXV_PINS.xls, MAXV_SYM.csv, PIN_Symbols_5ceb4au15.xlsx, Pin_out.xls, Pin_out_with_voltages.xls]
2014-12-17 Organized the Data Sheets
    [5CEBA4.xls, PIN_Symbols_5ceb4au15.xlsx, Pin_out.xls, Pin_out_with_voltages.xls]
2014-12-18 Added two control lines for the Inertial Module switches.
2014-12-19 Added buffers to the JTAG to prevent pull-ups from drawing unneeded current between devices.
2014-12-19 Added specs for Octal Buffer pull-down resisters.
2014-12-19 Added combined connector.
2014-12-22 Added External SPI connection header.
2014-12-23 Added pull-up resistor and moved MUX input for the JTAG chain.
2014-12-29 Added connector data sheets
2014-12-30 Added JTAG and External SPI header circuits to the diagram.
2015-01-05 1_5_2015
    Commit Notes
    Changes to CPLD_INIT
    Logic level changed to '1' on the Octal buffer enable used in PowerController.vhd and
    FlashInit.vhd. These are properly inverted at the top levels of _init and non_init
    CPLD projects.
    Changes to CPLD
    fpga_turnon reduced to fpga_running and forced_start_in for the time being.
    It was found that the real time clock is outputting a clock on its interrupt
    line in its default state.
    fpga_running has changed to an or of fpga_powered and conf_done and init_done.
    It was found that conf_done fpga line goes high as the FPGA receives all data (minus 2 clock cycles)
    and init_done fpga line (if programmed into FPGA stream and project) goes high after the
    FPGA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
    [DevBoard_PowerMonitorCPLDInit_TopLevel.vhd, DevBoard_PowerMonitorCPLD_TopLevel.vhd, FlashInit.vhd, PowerController.vhd]
2015-01-09 Changed FPGA to FLASH connection to not go through Power Controller.
2015-01-12 Turn off recharge switch when battery good is low.
2015-01-13 Battery Monitor Setup Information.
2015-01-23 Added memory initialization for I2C command execution.
2015-01-27 Added Current Meter Tool to the project.
2015-02-05 Added PCB Designs to project
    [BoM.xlsx, BoM_SC.xlsx, C5U324_B2A.csv, C5U324_B3A.csv, C5U324_B3B.csv, C5U324_B4A.csv, C5U324_B5A.csv, C5U324_B5B.csv]
2015-02-06 Added data sheet for the BoM on the Transceiver
2015-02-25 Add I2C support.
2015-02-27 Remove revision changes from January documement. Added Power Controller FLASH driving lines.
2015-02-27 Working PowerController.vhd in which all flash lines are driven when FPGA is not powered, driven by PFL when FPGA is being programmed, and all high 'Z' when FPGA is programmed and the flash_access_gr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
    SiP32413 inverted logic put into CPLD top level.
    [DevBoard_PowerMonitorCPLD_TopLevel.vhd, PowerController.vhd]
2015-03-06 Added most recent version of the board. FPGA is broken out and Schematic has been appropriatly updated
    [MAIN_BoM.xls, MCollar_MAIN_011415.pcb, MCollar_MAIN_022515.pcb, MCollar_MAIN_022615.pcb, MCollar_MAIN_022715.pcb, MCollar_MAIN_030515.pcb, MCollar_MAIN_030615.pcb, MCollar_MAIN_Brokeout.pcb]
2015-03-10 Changed power to the microphones (1.8V won't start them). Added a small bias prior to truncating fractions on integer conversion to handle impresise representation of numbers in modelsim.
    [Utilities_pkg.vhd]
2015-03-13 Writeup of studies on writing to the microsd card in a level translated fashion or a direct fashion and its implication on total system power usage.
2015-03-17 Changed pull-down resistor size.
2015-03-26 Added intrface board design for the Collar's 10 pin External Serial Header.
2015-03-27 Final version of the board
    [MAIN.xls, MCollar_MAIN.pcb, MCollar_MAIN_022715.pcb, MCollar_MAIN_030515.pcb, MCollar_MAIN_030615.pcb, MCollar_MAIN_Brokeout.pcb, MCollar_MAIN_Routed.pcb, MCollar_MAIN_old.pcb]
2015-03-27 Added I2C and USB Data Connectors.
2015-03-31 Copied most of development board project's qsf file to make creating a new copy of the project simpler.
2015-03-31 Changed bank 5B voltage from 2.5 to 1.8.
2015-04-01 Removed resistor value for a resistor that had been deleted.
2015-04-07 Added in all my components into the GitHub repo.
    Edit to the level translating App Note. Blurb added on the Ti level translator current usage
    of Vcca and Vccb ports. Averaged values
    for these two ports added to the app note.
2015-04-07 Include the skelton sdc file I used to successfully constraing the BeMicroCV microsdhc at 50Mhz with 0 timing errors.
    Currently a work in progress for constraining
    devboard_powermonitor's system.
2015-04-17 Added BOM specifically for Screaming Circuits
    [BoM_SC.xlsx]
2015-04-24 Backup most of my working directory. Latest IMU and Flashblock code. FPGA/CPLD/CPLD_INIT up to date.
2015-04-24 Updated to Schematic
2015-04-28 CPLD,CPLD_INIT,FPGA Projects for AudioRecordingCollar initial test complete. Boot chain tested to FPGA counter program on D+/D- of USB connector.
    Initial tests of loading CPLD_INIT, loading converted FPGA image to flash, loading CPLD,
    and booting FPGA image from flash is successful. The resulting counter
    program on D+/D- is seen.
2015-05-15 Change Device SDC file names so wildcard lookup can be used.
2015-05-18 Added MAIN Documentation, updated project files.
    [MAIN.xls, MAIN_BoM.xls, MCollar_MAIN.pcb, MCollar_MAIN_Routed.pcb, MCollar_MAIN_old.pcb, MCollar_MAIN_working.pcb, MCollar_SENSOR_working.pcb, SC_BoM_MAIN.xls]
2015-05-22 New data sheets and the most current version of the Schematic
    [Config.cfg, Data_TRX_v1_Bottom.pcb, Data_TRX_v1_Top.pcb, Data_TRX_v1_working.pcb, ProjectBackup.cfg]
2015-05-22 Up to date version of the MCollar Project
    [MCollar_SENSOR.pcb, MCollar_SENSOR_working.pcb, MCollar_v1_template.pcb, SC_BoM_MAIN.xls]
2015-05-26 Change devices to use FPGA switched power.
2015-06-03 Interposer board design
    [MCollar_SANDWICH.pcb, MCollar_SANDWICH_33d_spec.pcb, MCollar_SANDWICH_33d_spec_100mil_pins.pcb, MCollar_SANDWICH_pins_labeled.pcb, MCollar_SANDWICH_route1.pcb, MCollar_SANDWICH_working.pcb, ProjectBackup.cfg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]
2015-06-08 Updates to datasheets and interposer board
    [MCollar_INTERFACE_current.pcb, MCollar_INTERFACE_working.pcb, MCollar_SANDWICH_route1.pcb, ProjectBackup.cfg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]
2015-06-08 Update to interface board
    [MCollar_INTERFACE_current_scattered.pcb]
2015-06-08 Interface board update
    [MCollar_INTERFACE_current.pcb, MCollar_INTERFACE_current_scattered.pcb, MCollar_SANDWICH_route1.pcb]
2015-06-09 Schematic documentation for interface board
2015-06-09 Removed pull-down resistors from Data Trx interface. The MUX resistors are not needed as the MUX is an analog MUX and stray input voltages will not affect it. The Select line is attach to the output 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
2015-06-10 Interface Schematic Fixes
    [MCollar_INTERFACE_working.pcb]
2015-06-12 Interface board layout update
    [MCollar_INTERFACE_layout1.pcb, MCollar_INTERFACE_layout_best.pcb, MCollar_INTERFACE_working.pcb]
2015-06-12 Updated (Fixed) the Power Controller to Data Transmitter interface.
2015-06-12 Schematic and Layout Update
    [MCollar_INTERFACE_working.pcb]
2015-06-12 Directory Cleaning
    [MCollar_INTERFACE_current.pcb, MCollar_INTERFACE_layout1.pcb, MCollar_INTERFACE_layout_best.pcb, MCollar_INTERFACE_working.pcb, ProjectBackup.cfg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]
2015-06-12 Posted most recent PCB files
    [Data_TRX_BoM.xlsx, Data_TRX_v1.pcb, Data_TRX_v1_working.pcb, MCollar_SENSOR.pcb, MCollar_SENSOR_working.pcb, SC_BoM_MAIN.xls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]
2015-06-15 Schematic corrections
    [MCollar_INTERFACE_working.pcb]
2015-06-23 Interface Board Updates
    [BOM_InterfaceBoard.xlsx, Board1.xls, MCollar_INTERFACE_autoroute.pcb, MCollar_INTERFACE_current.pcb, MCollar_INTERFACE_current_landing.pcb, MCollar_INTERFACE_current_larger.pcb, MCollar_INTERFACE_layout_fixedworking.pcb, MCollar_INTERFACE_working.pcb]
2015-06-29 Added possibility of Bus Hold Circuitry to SDRAM and SD Card bidirectional lines.
2015-07-01 Added protection and thermal diodes.
2015-07-02 New datasheets and up to date SENSOR schematic
2015-07-02 Updated PCB Design and added folder full of learning material
    [5ceba4.xls, Decoupling_Cap_Calculation.xlsx, FPGA_PCB.pcb, MCollar_MAIN.pcb, MCollar_MAIN_Brokeout_working.pcb, MCollar_MAIN_working.pcb, MCollar_SENSOR.pcb, MCollar_SENSOR_pre_pwr.pcb]
2015-07-03 Fixed SDC files. Added minimum and maximum functions. Updated SDRAM Controller to tested version.
    [SDRAM_Controller.vhd, SDRAM_Information_pkg.vhd, Utilities_pkg.vhd]
2015-07-07 Updated MCollar, added new data sheets
    [5ceba4.xls, FPGA_PCB.pcb, MCollar_SENSOR.pcb, MCollar_SENSOR_pre_pwr.pcb, MCollar_SENSOR_working.pcb, ProjectBackup.cfg, SENSOR_BoM.xls.xlsx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]
2015-07-09 Minor updates
    [SENSOR_BoM.xls.xlsx]
2015-07-10 Skip checking reset to SPI pin timing. Remove unneeded variable from functions.
    [Utilities_pkg.vhd]
2015-07-13 Add initialization not dependend on reset signal.
    [GenClock.vhd]
2015-07-16 Add documentation for using the Freescale Freedom Board as several tools use it.
2015-07-16 Microphone Board
    [Board1.xls, MCollar_Microphone_current.pcb, MCollar_Microphone_working.pcb, ProjectBackup.cfg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]
2015-07-16 Handle both direct and divided clocks correctly.
    [GenClock.vhd]
2015-07-20 Added longer reset time to avoid problems with reset line delays to all processes. Use shared SDC time values when defining clocks.
    [Collar.vhd, DevBoard_PowerMonitorFPGA_TopLevel.vhd]
2015-07-20 Added SPI clock to the collar.
2015-07-20 Added Power Controller SPI support.
2015-07-21 Fixed incorrect generate ending lable.
    [Collar.vhd]
2015-07-21 Use master clock frequency from shared SPI values.
2015-07-27 Added gated inverted clock as inverting a gated clock will result in a clock that is high most of the time. It is important when using a clock to access internal memory that it be high only when the 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
    [GenClock.vhd]
2015-07-27 Changed inverted gated clock name to be more appropriate.
    [GenClock.vhd]
2015-07-27 Added inverted clock to take advantage of counted clocks all changing on the same clock edge.
    [GenClock.vhd]
2015-08-11 Misc Matlab Code Snippets
    Code for plotting the data. NOTE: Matlab 2015a or higher is required!
    [AfternoonRun.csv, LunchRun.csv]
2015-08-12 Update SDRAM capacity naming.
2015-08-12 Added magnetic memory ports.
2015-08-12 Magnetic Memory shared memory buffer.
2015-08-21 Changes to flashblock_tb.m.
    Updated/Rewrite testbench for named testbenching.
    Adapted Emery's newest testbench methods.
    Changes to flashblock.vhd.
    Added flashblock interfacing system with magnetic memory buffer to
    lookup logical block number on startup.
    Added requesting and receiving GPS memory.
    Removed all direct write mode enable code and ports.
    Fixed event system lock when done servicing.
    Addressing into event system from flashblock changed.
    Removed device_byte_rdy and device_byte from port map.
    Supply any clock to any memories which are interfaced with.
    Movement towards total compliance with the coding convention.
    Formatting.
    [FlashBlock.vhd]
2015-09-16 microSD system as of 9_16_2015
    No timing errors present using new scripted timing/SDC system.
    The timing files make use of the TCL SDC system in place.
    Logged 146mB of counter through the SDRAM to microSD flash.
    Checked out bit for bit when read into Matlab.
    [microsd_buffer.vhd, microsd_controller_dir.vhd, microsd_controller_inner.vhd, microsd_crc_16.vhd, microsd_crc_7.vhd, microsd_data.vhd, microsd_init.vhd, sd_loader.vhd]
2015-09-18 Diode Array Datasheet
2015-09-22 Top SDC file which now includes a system to cut (false path) asynch paths.
2015-09-22 Added AARDVARK SPI/I2C Master Manual. Moved the Cheetah manual into /Tools.
2015-09-28 Interface Board Schematic Update (Vishay Added)
    [MCollar_INTERFACE_workingV2.pcb]
2015-09-28 Sunrise/Sunset determining MIF ROM.
    [NOAA_Solar_Calculations_toMif.xls]
2015-09-29 Changed file header for its current function.
2015-09-29 Interface Board Schematic Update
    [BOM_InterfaceBoard.xlsx]
2015-09-29 Sunrise/Sunset calculation needs one more day than is in a year.
    [NOAA_Solar_Calculations_toMif.xls]
2015-10-01 Fixed problems with search tree building and GPS initialization for the MIF file.
    [gps_message_ctl_pkg.vhd, msg_ubx_nav_aopstatus_pkg.vhd, msg_ubx_nav_sol_pkg.vhd, msg_ubx_tim_tm2_pkg.vhd]
2015-10-01 Fixed syntax error and message buffer start address problem.
    [gps_message_ctl_pkg.vhd]
2015-10-01 Added pull-down resistor
    [MCollar_INTERFACE_autoroute.pcb, MCollar_INTERFACE_current.pcb, MCollar_INTERFACE_current_landing.pcb, MCollar_INTERFACE_current_larger.pcb, MCollar_INTERFACE_layout1.pcb, MCollar_INTERFACE_layout_best.pcb, MCollar_INTERFACE_layout_fixedworking.pcb, MCollar_INTERFACE_working_current_best.pcb]
2015-10-05 Schematic fixes and interface board routes
    [MCollar_INTERFACE_current.pcb, MCollar_INTERFACE_currentV2.pcb, MCollar_INTERFACE_layout_best.pcb, MCollar_INTERFACE_working.pcb, MCollar_INTERFACE_workingV2.pcb, MCollar_INTERFACE_workingV2_beforeforward.pcb]
2015-10-06 Working versions of the Flashblock/MagMemController and a Magnetic Memory Layout PKG file.
2015-10-06 Addition of the skeleton Startup entity. Most recent IMU entity.vhd.
2015-10-06 Removed unused motion sensor chip select.
2015-10-06 Fixed MIF file format and Sunrise/Sunset ROM usage.
    [NOAA_Solar_Calculations_toMif.xls]
2015-10-06 System Time replaced older time keeping.
    [FormatSeconds.vhd, SystemTime.vhd]
2015-10-06 Fixed unused selection bit on power of two resource count.
    [ResourceMUX.vhd]
2015-10-06 Fixed configuration commands needed.
    [NEO-6T Configuration.txt]
2015-10-06 Incorporated new System Time. Fixed numerous problems. Enhanced GPS support.
    [Collar.vhd]
2015-10-07 Fixed problem with unselective generate conditions.
    [SunriseSunset.vhd]
2015-10-13 Renamed Magnetic Memory resourse MUX more appropriately.
2015-10-14 Change edge used for sync to avoid possible clock issues when using the data.
    [CrossChipReceive.vhd]
2015-10-14 Reduced clock times for millisecond and second clocks to avoid Timequest's inability to handle values that long.
2015-10-14 Removed inferred latch problems.
    [FastConstCounter.vhd]
2015-10-14 Additional data sheets. G4 Battery Montior added (the one on the sensor board) Battery Monitor Tool data sheets added.
2015-10-14 Fixed asynchronous set problem for rtc_seconds.
    [SystemTime.vhd]
2015-10-15 Use the 4 millisecond bit of the GPS time directly as the milliClock.
2015-10-19 Put the reset line on a global clock to increase fanout and response time.
    [Collar.vhd]
2015-10-20 Added non-vector flip flop. Added edge triggered flip flop option.
    [GPSinit.vhd, InterruptController.vhd, LoggingCounterArray.vhd, SR_FlipFlop.vhd, SR_FlipFlopVector.vhd]
2015-10-20 Fixed invalid condition in global generation of gated clocks.
    [GenClock.vhd]
2015-10-20 Removed local gated clocks and replaced them with shared gated clocks.
    [AOPstatus.vhd, GPSclocks.vhd, GPSmessageParser.vhd, GPSmessages.vhd, GPSpoll.vhd]
2015-10-21 Replaced SR flip-flop with newer version.
    [CrossChipReceive.vhd]
2015-10-21 Fixed busy state not remaining long enough for the main process to take action.
    [StatCtlSPI_FPGA.vhd]
2015-10-26 Removed keep attribute from milli8_clk as it is no longer being used as a clock. (Its source bit is being used instead.)
    [SystemTime.vhd]
2015-11-04 Prevent path timing from going through the reset pin.
2015-11-05 Disconnected millisecond clocks from the system time they are derived from.
2015-11-06 Use gated, inverted named clocks instead of internally generated clocks for MUX latch clocks.
    [Collar.vhd]
2015-11-09 Neweset SD Card Timing IMU Timing
2015-11-10 Use indirect access to port names rather than specifying them directly as they are not the same between different circuit board revisions.
2015-11-10 Constrained the 50MHz clock pin. Removed timing checks for GPIO pins.
2015-11-10 Added magnetic memory and microphone clock constraints.
2015-11-19 Tested and verified error handling.
    [GPSmessageParser.vhd]
2015-11-20 Fix problems with non-generated code using resource MUXs.
    [Collar.vhd]
2015-11-20 Use regional clock for gps rx clocking as using a non-network clock failed TimeQuest analysis sometimes.
    [GPSclocks.vhd]
2015-11-20 Added clock for power up signal, then broke the connections between it and all other clocks.
2015-11-23 Fixed complaint about no master clock for gps-mem resource MUX when FlashBlock not used.
    [Collar.vhd]
2016-01-07 Progress on the I2C system. Reformatted I2C rom/ram. I2C_master edits. CoSim I2C testbench for system level excercise. batmo_inquire_top becoming more complete.
2016-01-19 Golden Image generated for the bq2750g4 on sensor boards using the AW IMR 16340 3.7V LiMn battery.
2016-02-03 I2C System Updates. BatMon and RTC systems demonstrated on the collar stack. Multiplexing still needs to be done at collar level.
2016-02-04 Wireless Packet Contents Doc
2016-02-10 Fixed overcounting of clock periods.
    [GenClock.vhd]
2016-03-11 Update on Wireless Packet Doc
2016-04-01 Documentation on how to setup the DevBoard Power Monitor.
    Additions to Control_Register.
    Changes to StatCtlSPI_FPGA to allow non-byte wise transfers.
    Changes to the CPLD_INIT code base:
    Parallel Flash Loader System Change.
    Option bits location now hard coded.
    FPGA image location hard coded.
    Latest I2C systems which are running on the collar system.
2016-04-08 Documentation is now complete up through FPGA boot. Cold board to booting FPGA out of flash instructions are done.
    Associated files and directories updated.
    All important changes to PFL and CPLD PowerController
    merged to the devboard_powermonitor.
2016-04-18 PowerMonitor_Devboard Documentation. All changes accepted.
2016-04-18 A note added about Quartus Version used for powermonitor_devboard tutorial.
2016-04-28 Revert on 3 files. Unintentional overwrite on these files.
    [FlashBlock.vhd, LSM9DS1_top.vhd, magmem_controller.vhd]
2016-04-28 Modified devboard_powermonitorFPGA_IO.qsf Uncommented essential pins. Especially those relating to the SPI bus between FPGA and CPLD.
2016-05-11 SDXC error handling. Design now has more complete error handling for SD card. Design moved away from 3 process state machine to a 1 process state machine. All commands are now protected against CRC t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
    [microsd_data.vhd, microsd_init.vhd]
2016-05-13 Utilities set2D_element function updated.
    This had been changed during and for I2C modelsim
    testing but never pushed to git.
    All set2D_elements changed in collar.vhd.
    I2C system merged into collar.
2016-05-13 magmem_controller updated. Erase pathway created. Bugs removed. Exit sleep wait set at 400us. Lost command due to interacting with spi_commands too fast. Data length generic for erase path too small.
    sdxc serial number added to magmem defs.
    [magmem_buffer_def_pkg.vhd, magmem_controller.vhd]
2016-05-13 GPSmessages.vhd set2D_element update. Fix on previous commit.
    [Collar.vhd, GPSmessages.vhd, magmem_controller.vhd]
2016-05-23 Added SDXC serial acquire to SDXC system. Added logging SDXC serial to magnetic memory.
2016-05-23 Flashblock now does stereo audio. Flashblock now uses Logical Block Number from Magnetic Memory. Flashblock now loads/stores logical block number from magnetic memory. Flashblock now waits to be star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
2016-06-15 Documentation and AudioRecording Collar Setup.
    Doc written on bringing up a new audio recording stack.
    Git updated throughout for this procedure.
    SOF to POF gen is now scripted in FPGA_INIT to avoid the GUI.
    Retested the bring up process out of the GIT repo to confirm
    that it likely works.
    [AudioRecordingCollarCPLD_TopLevel.vhd, AudioRecordingCollarFPGA_TopLevel.vhd]
2016-06-21 startup_shutdown updated. updated to start GPS sysystem. updated to start flashblock system (flashblock is now dependent on magnetic memory) state machine updated to wait for flashblock system flush 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
2016-06-21 GPS startup integrated into collar. RTC startup integrated into collar as it interacts with SystemTime entity. RTC module now either supplies time off RTC on boot to SystemTime or doees not depending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
2016-06-22 AudioRecordingCollarFPGA_IO.qsf update. Weak Programmable Pullups on SD/IMU pins added to _IO.qsf.
2016-06-27 TxRx Packet Assembly by Flashblock. Flashblock now assembles a packet of data into a collar level dual port ram. This ram is shared via a ResourceAllocator entity. See the _pkg.vhd and .docx for what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
2016-07-11 Commenting/TODO on SPI abstraction.
2016-07-20 Flashblock txrx buffer handling fixes and length verify.
    [FlashBlock.vhd, txrx_p_buffer_def_pkg.vhd]
2016-07-22 Flashblock edits and verification. NavSol coordinates verified in wireless packet off a live board.
2016-07-22 Flashblock edits and verification. All txrx packet contents verified off live board.
2016-08-02 BatMon Timeout Correction and Extend. Comments.
    [batmo_inquire_top.vhd]
2016-08-23 Added timer for CC1120
2016-08-31 GPS board PADS files
    [Board1.xls, GPSBoardV1.pcb, GPSBoardV1Diagonal.pcb, GPSBoardV1Square.pcb, GPSBoardV1SquareWorking.pcb, GPS_BOARD.xlsx, ProjectBackup.cfg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]
2016-12-05 Shifter component to replace shifting an array which may cause failing paths between the old elements and their new locations.
    [Shifter.vhd]
2016-12-21 Added Python code for the CC1120 at the relay station as well as a .mif file reader. TX and RX functional.
2017-01-06 Converted to 2016 and added dawn/dusk support.
    [NOAA_Solar_Calculations_toMif.xls]
2017-01-06 Use externally generated eight millisecond clock.
2017-01-06 Moved Startup_Shutdown from the General directory (Reserved for components used by other components) to the Scheduler directory. Reoganized states so that all states related to a device are together.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
    [Startup_Shutdown.vhd]
2017-01-06 Generate the eight millisecond clock with GenClock. Disconnect the result times from clock paths as the timing requirements are met with delays in the code.
2017-01-06 Added millisecond output clocks. Added support for Time Pulse clock synchronization. Added Shifter, Array Syncrhonization, Syncrhonizers, and initialization for Timequest and warning messages.
2017-01-06 Added Time Pulse clock synchronization. Added Shifter, Flip/Flops, and synchronizers to handle cross clock domain signalling.
    [TimeMark.vhd]
2017-01-06 Added I2C I/O pins to SDC.
2017-01-06 Added I2C clocking to SDC.
2017-01-06 Logging uses the interrupt controller.
2017-01-06 Save the RTC alarm interrupt enable across FPGA shutdowns.
2017-01-06 Change on/off time handling arrays. Added Flip/Flops and sychronizers to handle cross clock domain signalling.
    [OnOffScheduler.vhd]
2017-01-06 Added Shifter, ArraySynchronizer, CrossChipReceive, Flip/Flops, and synchronizers to handle cross clock domain signalling. Added signal initialization to avoid implicit value use.
    [GPSinit.vhd, GPSmessageParser.vhd, GPSscheduler.vhd, I2C_IO.vhd, LSM9DS1_top.vhd, Scheduler.vhd, TXscheduler.vhd, batmo_inquire_top.vhd]
2017-01-06 Remove reset timing checks. Remove On/Off control lines from timing checks. Add Logging Counter Array. Add I2C bus. Add data transmitter. Add a mike clock. Change the GPS base clock from the SPI cloc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
2017-01-06 Added TXRX receiver. Handle individual TXRX pins. Added millisecond and eight millisecond clocks. Changed resource MUX table handling. Added TXRX receiver. Added scheduler. Added On/Off scheduler. Ad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
2018-05-16 Add collar prints which were used at UCSD.
    [Collar_Mesh_63_inner.stl, Collar_Mesh_63_outer.stl, INTERPOSER_20.stl]
2018-09-18 Added the matlab HDL Filter Coder file for the CIC filter implemented with the microphones.
